Marvin20212/Gruppe9_ME3E/Entwurf alt (Lars)/ME3-Entwurf/Testat 3/Neuer Ordner/Screenshot 2022-02-14 124500.png

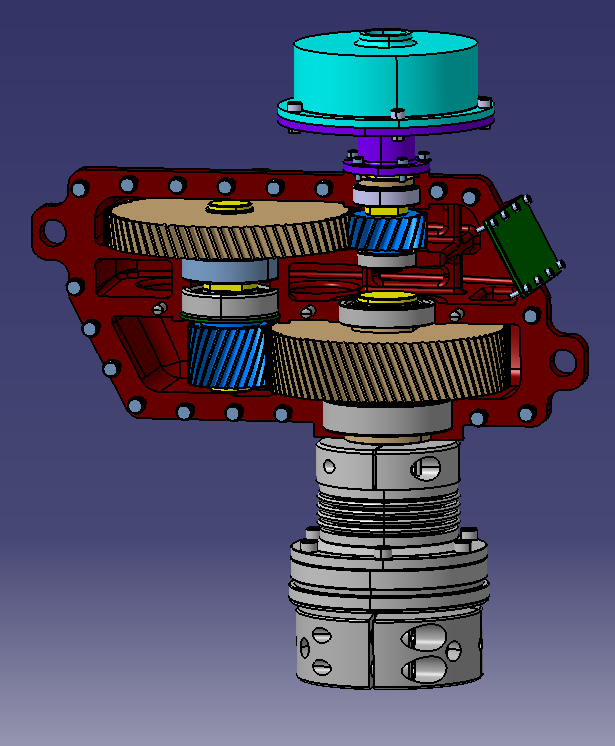
Entwurf alt (Lars)/ME3-Entwurf/Testat 3/Neuer Ordner/Screenshot 2022-02-14 124500.png
