Marvin20212/Gruppe9_ME3E/Catia/Fliehkraftkupplung/Bild Kupplung.jpg

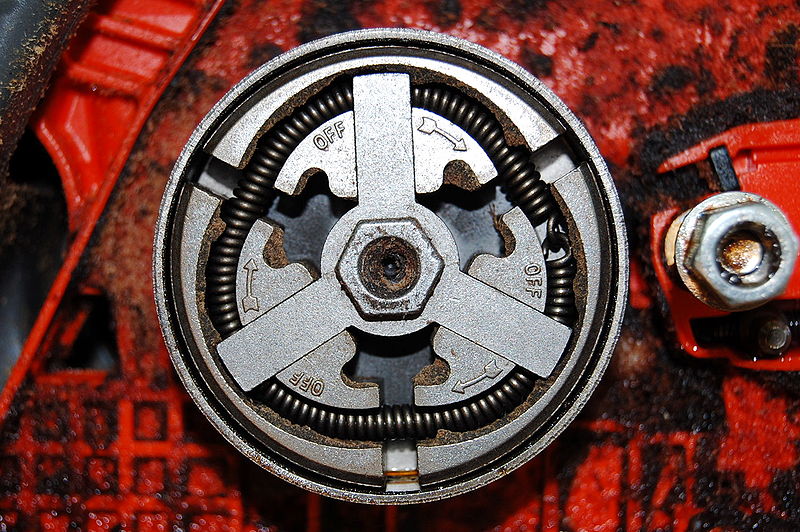
Catia/Fliehkraftkupplung/Bild Kupplung.jpg
