Marvin20212/Gruppe9_ME3E/Catia/Fliehkraftkupplung/Link Traceparts Kupplungen.txt

https://www.traceparts.com/de/search/tracepartsklassifizierung-mechanische-komponenten-bremsen-kopplungen-und-kupplungen-drehmomentbegrenzer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

https://www.traceparts.com/de/search/tracepartsklassifizierung-mechanische-komponenten-bremsen-kopplungen-und-kupplungen-kupplungen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
