Marvin20212/Gruppe9_ME3E/Entwurf alt (Arne)/Anforderungsliste des Bohrgerät.docx

Anforderungsliste des Bohrgerät-Getriebes

Vorgegebene Werte die einzuhalten sind:
Antrieb Tan [Nm] = 50
Abtrieb Tab [Nm] = 500
Schaltdrehzahl ns [min⁻¹] = 1400
Antriebsdrehzahl nan [min⁻¹] = 2000
Abtrieb FB [N] = 1500
Schrägverzahnungwinkel β [°] = 20

Es gibt nur zwei verschiedene Ausführungsvarianten, da die Wellen, Zahnräder und Kupplungen immer gleichbleiben müssen. Die Varianten ergeben sich bei der Konstruktion des Gehäuses. Die erste Variante ist eine Gusskonstruktion. Die zweite ist eine Schweißkonstruktion. Im Folgenden werden beide Varianten vorgestellt.

Variante 1: Gusskonstruktion (geteilt)

- Gehäuse bestehend aus zwei Teilen. Einem Trichter für die Fliehkraftkupplung inklusive einem genormten Motorflansch, welche je nach Motor variieren kann und einem Flanschdeckel zum Fixieren der Lagerungen.
- Durch geteiltes Gehäuse sind Dauergussformen möglich
- Gehäuse bestehend aus einer Alugusslegierung zur Gewichtsreduktion
- Wellen mit vormontierten Zahnrädern, Ritzeln und Lagern werden nur noch eingesetzt.
- Schwimmende Lagerung durch Rollenlager für Vorgelegewelle
- An- und Abtriebswelle:
  - Mit Nadellager ineinander gelagert (Loslager)
  - Festlager durch Kegelrollenlager in O-Anordnung in der Gehäusewand
- Zahnräder und Ritzel durch Passfederverbindungen mit Wellen verbunden

Variante 2: Schweißkonstruktion:

- Gehäuse bestehend aus einem geschweißten Kasten und einem geschraubten Deckel:
  - Motor wird durch Flansch am Kasten verschraubt
  - Wellen werden seitlich durch Löcher eingeschoben
  - Zahnräder, Ritzel und Lager werden im Inneren aufgeschoben
- An- und Abtriebswelle:
  - Loslager durch Rillenkugellager in Lagerblock in der Mitte des Kastens
  - Festlager durch Schrägkugellager in O-Anordnung in der Gehäusewand
- Zahnräder und Ritzel durch Passfederverbindungen mit Wellen verbunden

Es wird eine Gusskonstruktion aufgrund einfacherer Fertigung gewählt.

Allgemeine Anforderungen:

- Sicherheit gegen Dauerbruch > 1,5
- Wälzlagerlebensdauer > 10.000 h
- Koaxiale Ausrichtung der An- und Abtriebswelle
- klein- bis mittelgroße Serie (10.000 Stk.)
- bevorzugte Verwendung von Norm- und Kaufteilen
- fertigungs- und montagegerechte Konstruktion
- kostengünstige Fertigungs- und Betriebskosten
- anwendergerechte Konstruktion, welche Verletzungsgefahren minimiert
- geringe akustische Belastung
- Korrosionsschutz durch gewählte Materialien und Lackierungen
- Ölpeilung
- Öleinlass- und ablassschraube im Gehäuse
- Fliehkraftkupplung schaltet bei 1300 min⁻¹ (μ0 = 0,9)
- Rutschkupplung schaltet bei T > 50 Nm
- kompakte und gewichtssparenden Bauweise
- Reibbelege der Kupplung sind möglichst langlebig

ME3-Entwurf Lara Vujevic, Arne Schlemermeyer, Julian Reimann 08.01.2022
