Marvin20212/Gruppe9_ME3E/Berechnungen/Alle Rechnungen 11.05.2022.pdf

Berechnungen zur Auslegung eines Bohrgerät-Getriebes

ME3 Entwurf SoSe2022 | Gruppe 9

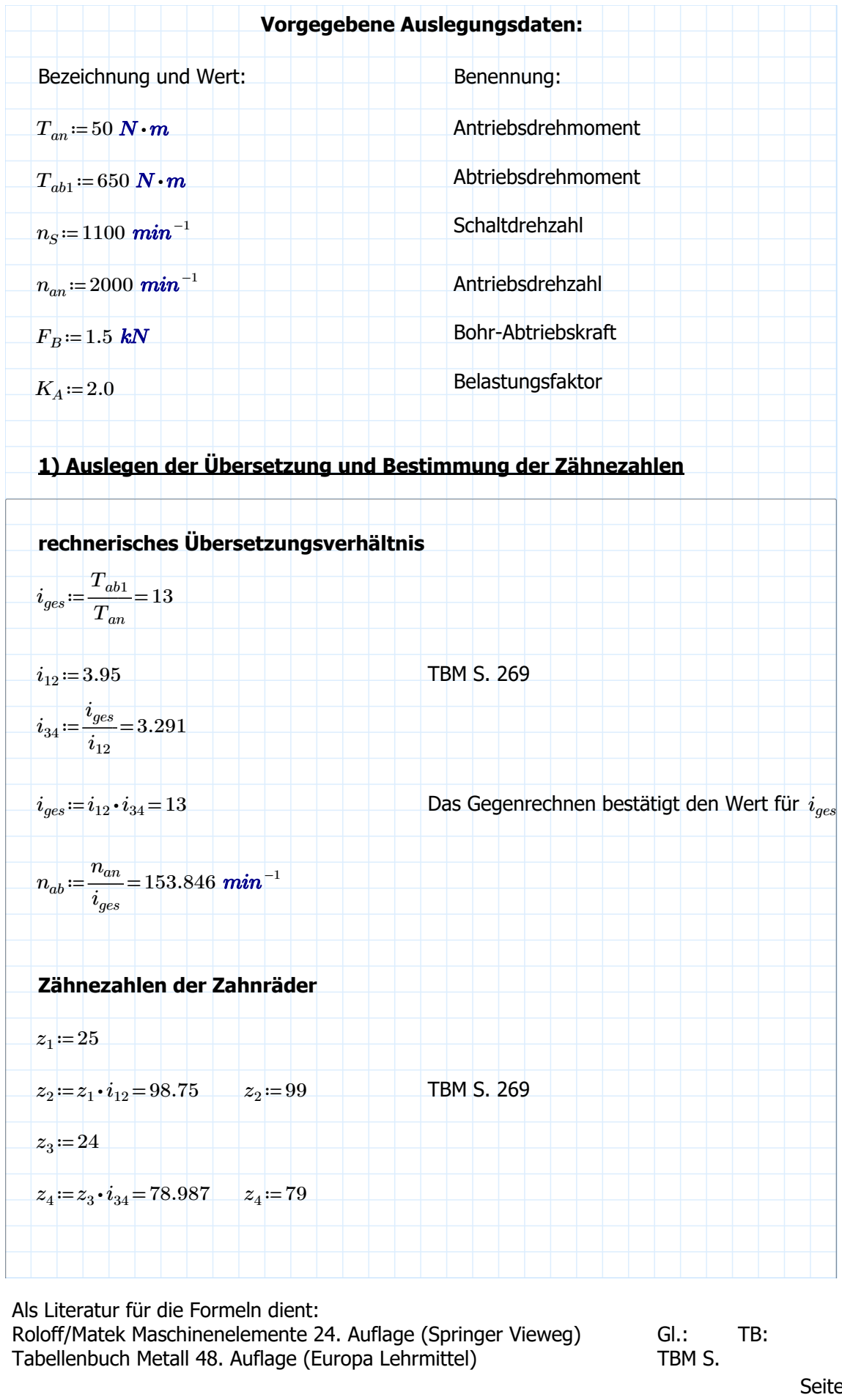
[picture p3: figure]
Vorgegebene Auslegungsdaten:; Bezeichnung und Wert:; Benennung:; Tan≔50 N ⋅m; Antriebsdrehmoment; Abtriebsdrehmoment; Schaltdrehzahl; Tab1≔650 N ⋅m; nS≔1100 min ⁻¹; nan≔2000; min ⁻¹; Antriebsdrehzahl; Bohr-Abtriebskraft; Belastungsfaktor; rechnerisches Übersetzungsverhältnis; iges≔――=; Tab1; Tan; TBM S. 269; iges; nab≔――=; nan; 153.846 min ⁻¹; Zähnezahlen der Zahnräder; Als Literatur für die Formeln dient:

1) Auslegen der Übersetzung und Bestimmung der Zähnezahlen
iges≔i12 ⋅i34=13 | Das Gegenrechnen bestätigt den Wert für iges
Roloff/Matek Maschinenelemente 24. Auflage (Springer Vieweg) | Gl.: | TB:
Tabellenbuch Metall 48. Auflage (Europa Lehrmittel) | TBM S.
Seite 1 von 35

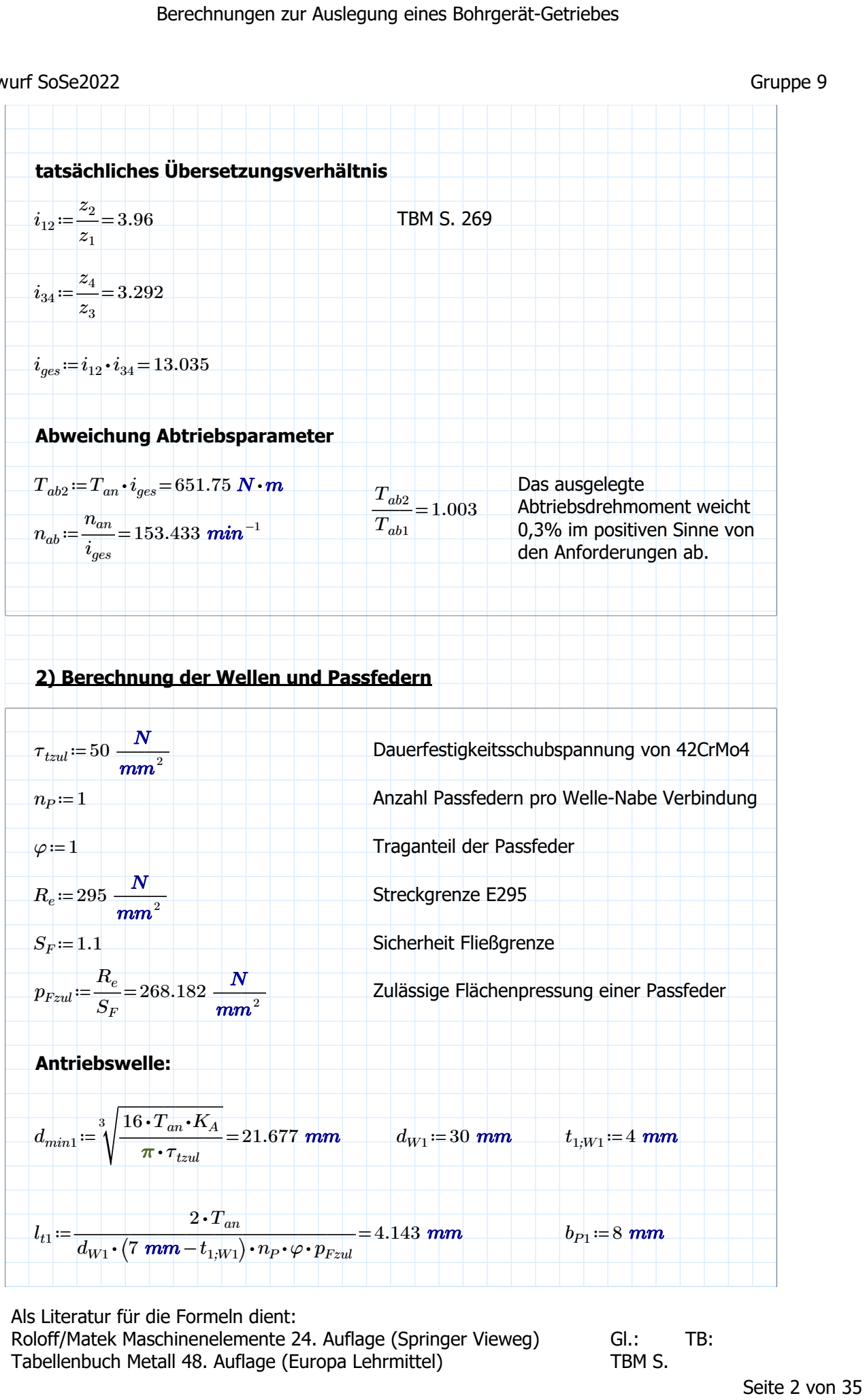
[picture p4: figure]
tatsächliches Übersetzungsverhältnis; 3.96 TBM S. 269; iges≔i12 ⋅i34=13.035; Abweichung Abtriebsparameter; Abtriebsdrehmoment weicht 0,3% im positiven Sinne von den Anforderungen ab.; Tab2; Tab1; nab≔――=; nan; iges; 153.433 min ⁻¹; 2) Berechnung der Wellen und Passfedern; τtzul≔50 ―N―mm²; Dauerfestigkeitsschubspannung von 42CrMo4; Anzahl Passfedern pro Welle-Nabe Verbindung; Traganteil der Passfeder; Re≔295 ―N―mm²; Streckgrenze E295; Sicherheit Fließgrenze; pFzul≔―=; 268.182 ―N―mm²; Zulässige Flächenpressung einer Passfeder; Antriebswelle:; dmin1≔; π⋅τtzul; 2 ⋅Tan; nP φ pFzul; Seite 2 von 35

Tab2≔Tan ⋅iges=651.75 N ⋅m | Das ausgelegte

Da die tragende Länge der Passfeder der ungefähren Breite der Zahnräder entsprechen sollte, wird im Folgenden die Länge an die später berechnete Zahnradbreite angeglichen.
lP1≔28 | mm | gewählt: Antriebswelle ⌀ 30mm Passfeder DIN 6885 - A8 x 7 x 28

Vorgelegewelle:

dmin2≔ | =

3 ―――――

16 ⋅T | ⋅ | ⋅ an KA | i12

π⋅τtzul

34.295 mm | dW2≔45 mm | t1;W2≔5.5 | mm

l

t2≔―――――――――――=

2 ⋅T | ⋅ an i12
dW2 ⋅ ⎛ | ⋅ | ⋅ | ⋅ ⎝9 mm -t1;W2⎞
⎠ | nP φ pFzul
9.375 mm | bP2≔14 | mm

Da die tragende Länge der Passfeder der ungefähren Breite der Zahnräder entsprechen sollte, wird im Folgenden die Länge an die später berechnete Zahnradbreite angeglichen.

lP2≔28 | mm | lP2≔50 | mm | gewählt: Vorgelegewelle ⌀ 45mm Passfeder DIN 6885 - A14 x 9 x 28 Passfeder DIN 6885 - A14 x 9 x 50

Abtriebswelle:

dmin3≔ | =

3 ―――――

16 ⋅T | ⋅ | ⋅ an KA | iges

π⋅τtzul

51.016 | mm | dW3≔60 mm | t1;W3≔7 mm

l

t3≔―――――――――――=

2 ⋅T | ⋅ an iges
dW3 ⋅ ⎛ | ⋅ | ⋅ ⋅ ⎝11 | mm -t1;W3⎞
⎠ nP | φ | pFzul
20.252 mm | bP3≔18 | mm

Da die tragende Länge der Passfeder der ungefähren Breite der Zahnräder entsprechen sollte, wird im Folgenden die Länge an die später berechnete Zahnradbreite angeglichen.

lP3≔50 | mm | gewählt: Abtriebswelle ⌀ 60mm Passfeder DIN 6885 - A18 x 11 x 50
3) Zahnradbreite

Bzul≔4.0 ―N―mm²
| | Überschlägigier Belastungswert

Seite 3 von 35

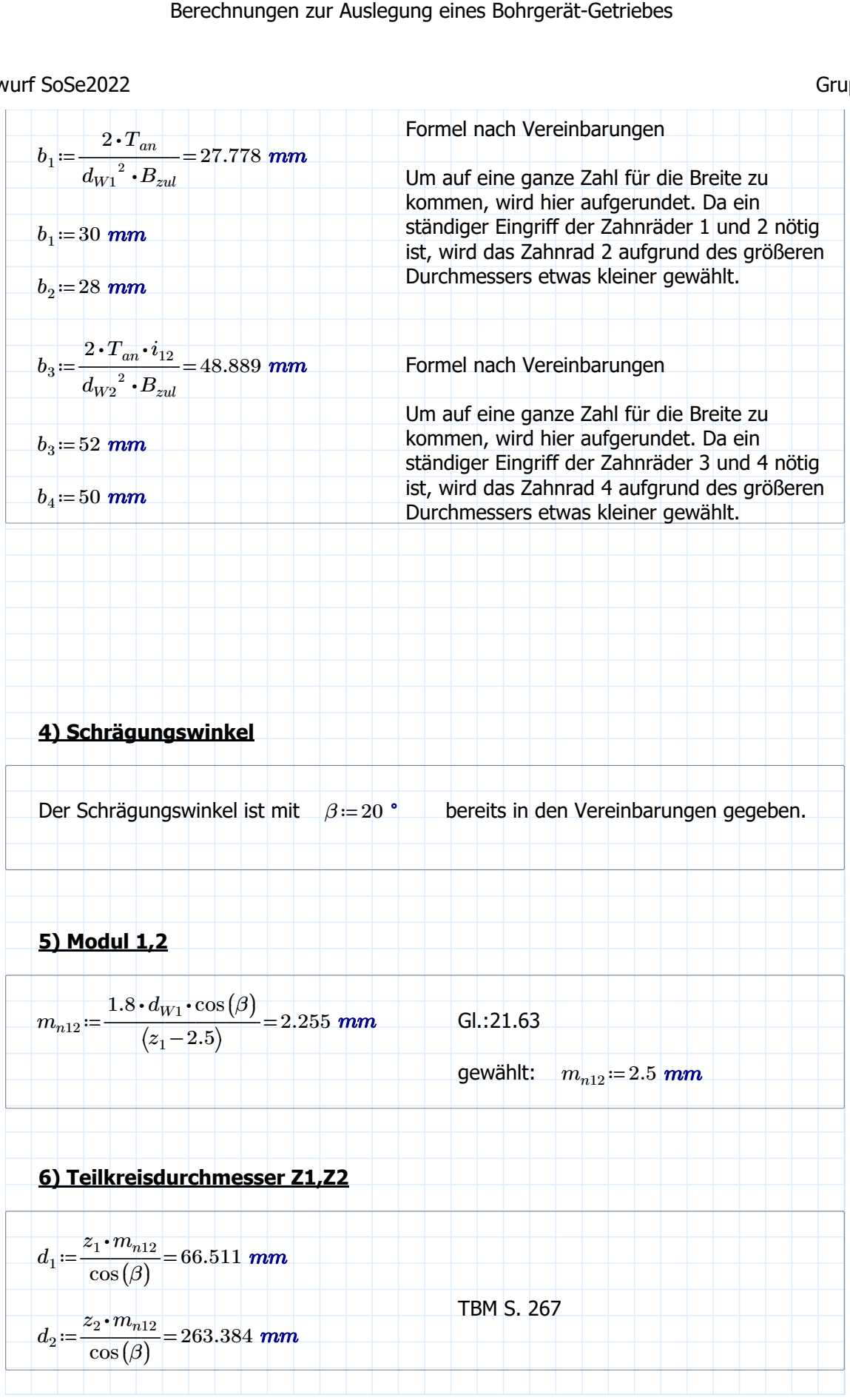
[picture p5: figure]
Formel nach Vereinbarungen; kommen, wird hier aufgerundet. Da ein; Durchmessers etwas kleiner gewählt.; 2 ⋅Tan dW1 ⋅; 2 Bzul; 4) Schrägungswinkel; Der Schrägungswinkel ist mit; bereits in den Vereinbarungen gegeben.; 5) Modul 1,2; 1.8 ⋅dW1 ⋅ cos ((β)) ⎛⎝z1-2.5⎞ ⎠; gewählt:; 6) Teilkreisdurchmesser Z1,Z2; cos ((β)); TBM S. 267

Um auf eine ganze Zahl für die Breite zu

ständiger Eingriff der Zahnräder 1 und 2 nötig ist, wird das Zahnrad 2 aufgrund des größeren

Um auf eine ganze Zahl für die Breite zu

ständiger Eingriff der Zahnräder 3 und 4 nötig ist, wird das Zahnrad 4 aufgrund des größeren

Seite 4 von 35

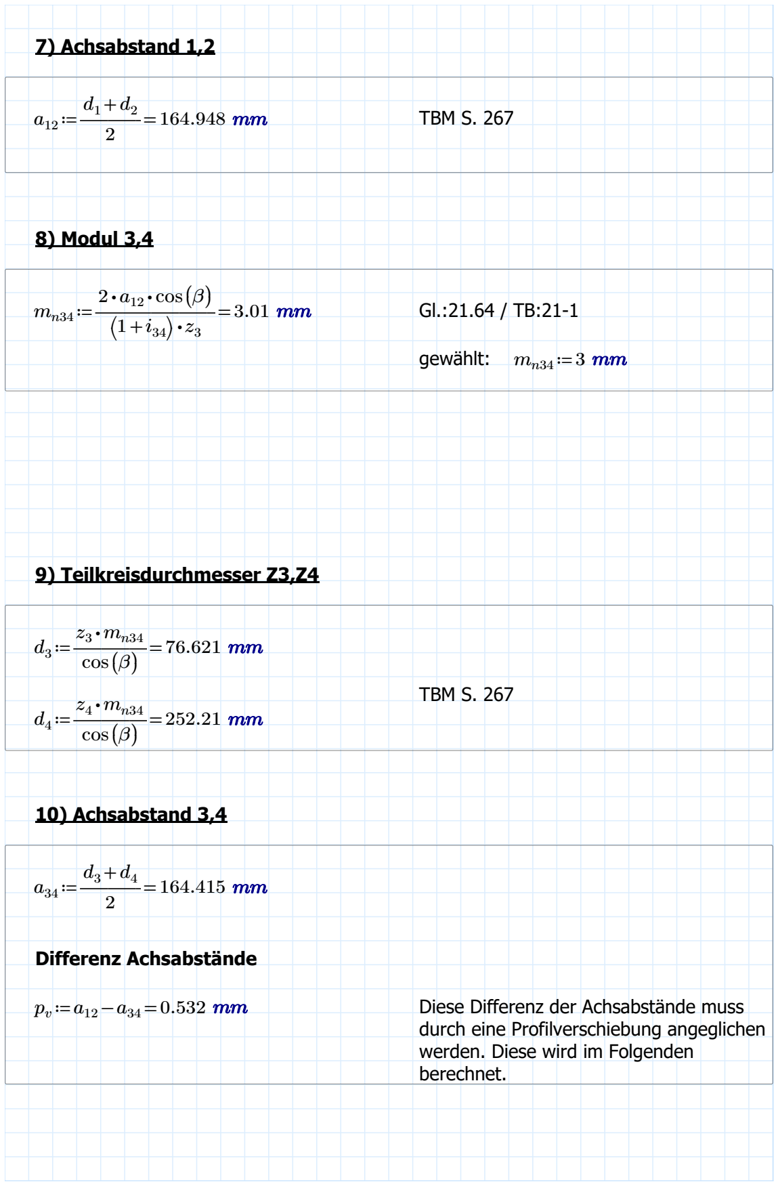
[picture p6: figure]
7) Achsabstand 1,2; TBM S. 267; 8) Modul 3,4; cos ((β)); gewählt:; 9) Teilkreisdurchmesser Z3,Z4; 10) Achsabstand 3,4; Differenz Achsabstände; Diese Differenz der Achsabstände muss; durch eine Profilverschiebung angeglichen werden. Diese wird im Folgenden berechnet.

Seite 5 von 35

11) Profilverschiebung

Aufgrund weniger Drehmomentkräfte an den Zahnrädern 1 und 2 haben wir uns dort für die Profilverschiebung entschieden.

Stirneingriffswinkel

αn≔β=20 | °
αt≔atan | =

⎛
⎜

⎝―――

tan⎛⎝αn

⎞
⎠
cos ((β))

⎞
⎟
⎠
21.173 ° | Gl.: 21.35

Ersatzzähnezahl

βb≔acos | =

⎛
⎜
⎝

―――

sin⎛⎝αn

⎞
⎠
sin⎛⎝αt

⎞
⎠

⎞
⎟
⎠
18.747 ° | Gl.: 21.36

zn1≔―――――=

d1

cos ⎛ ⋅ ⎝βb

⎞
⎠

2
mn12

29.669 Gl.: 21.47

zn2≔―――――=

d2
cos ⎛ ⋅ ⎝βb

⎞
⎠ mn12

111.256

Profilverschiebungsfaktoren und Profilverschiebung

Bei der Profilverschiebung V ist zum Berechnen der Wert x nötig. Dieser wird in der Formel für die Summe der Profilverschiebungsfaktoren errechnet, welche bis auf den Betriebseingriffswinkel zurückblickt. Daher werden im Folgenden mehrere Gleichungen angewendet, um letztendlich auf die Profilverschiebung zu kommen.

Betriebseingriffswinkel:

αwt≔acos | =

⎛
⎜
⎝

cos ⎛ ⋅ ⎝αt

⎞
⎠ ――

a12

a34

⎞
⎟
⎠
20.689 | ° | aus Gl.: 21.54 umgestellt

Seite 6 von 35

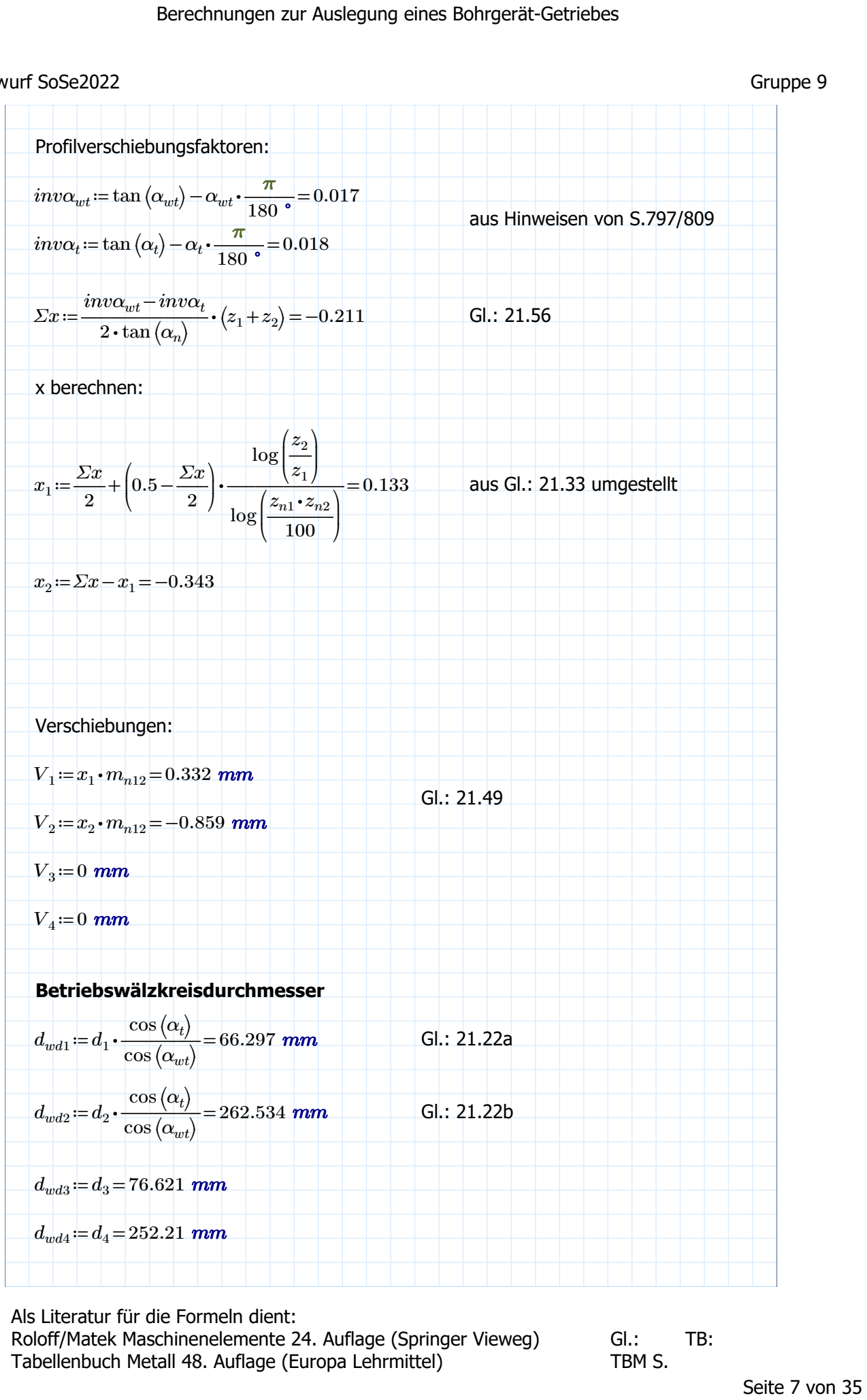
[picture p7: figure]
Profilverschiebungsfaktoren:; invαwt≔tan⎛⎝αwt⎞ ⎠-αwt⋅――=; aus Hinweisen von S.797/809; invαt≔tan⎛⎝αt; invαwt-invαt 2 ⋅ tan⎛⎝αn; x berechnen:; log; 0.133 aus Gl.: 21.33 umgestellt; Verschiebungen:; Betriebswälzkreisdurchmesser; dwd1≔d1; cos ⎛⎝αt; ⎞ ⎠ cos ⎛⎝αwt⎞ ⎠; dwd2≔d2; dwd3≔d3=76.621 mm; dwd4≔d4=252.21 mm; Seite 7 von 35

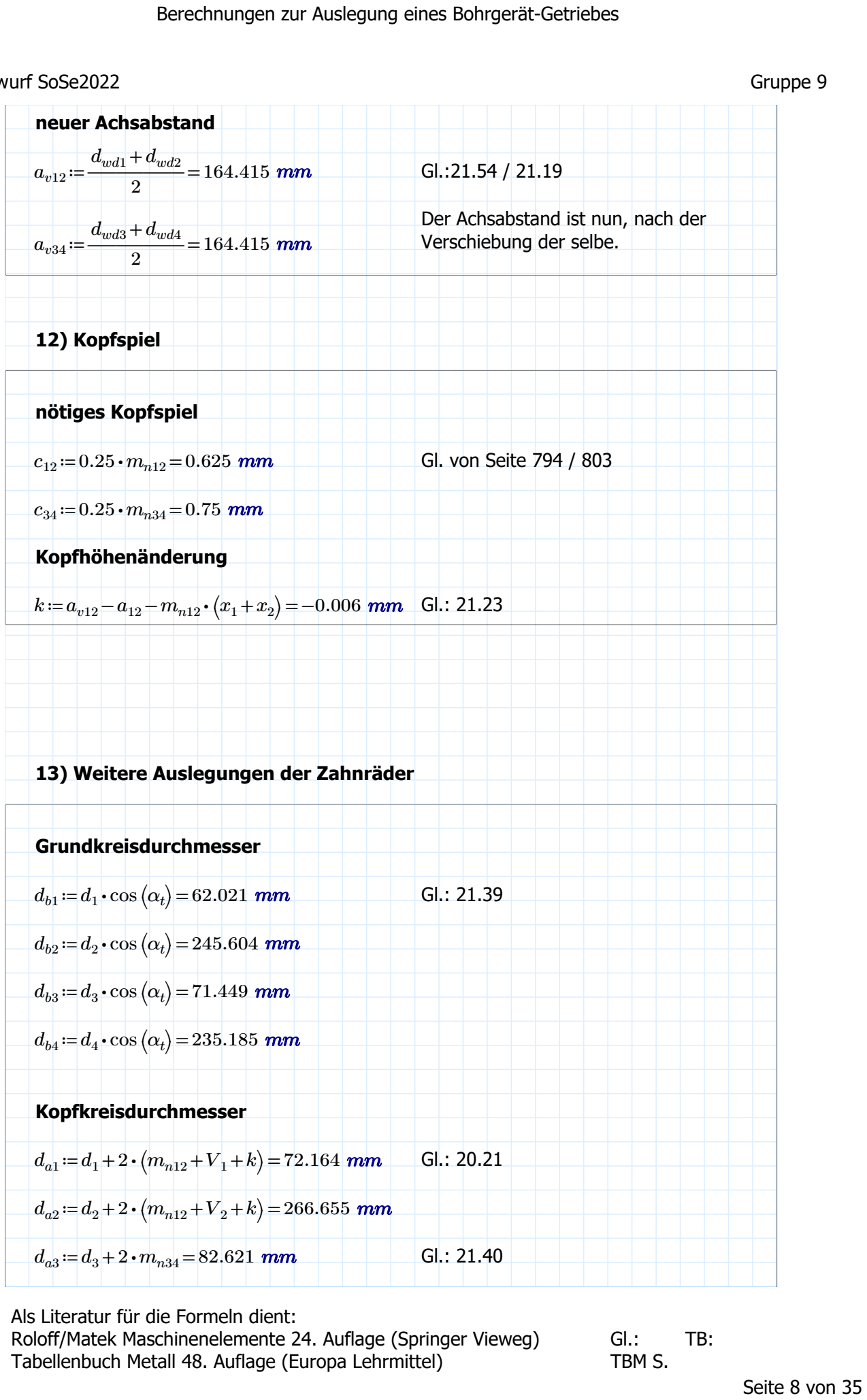
[picture p8: figure]
neuer Achsabstand; dwd1+dwd2 2; Der Achsabstand ist nun, nach der; Verschiebung der selbe. v34; dwd3+dwd4 2; 12) Kopfspiel; nötiges Kopfspiel; Kopfhöhenänderung; 13) Weitere Auslegungen der Zahnräder; Grundkreisdurchmesser; ⋅ cos ⎛⎝αt; Kopfkreisdurchmesser; Seite 8 von 35

c12≔0.25 ⋅mn12=0.625 mm | Gl. von Seite 794 / 803

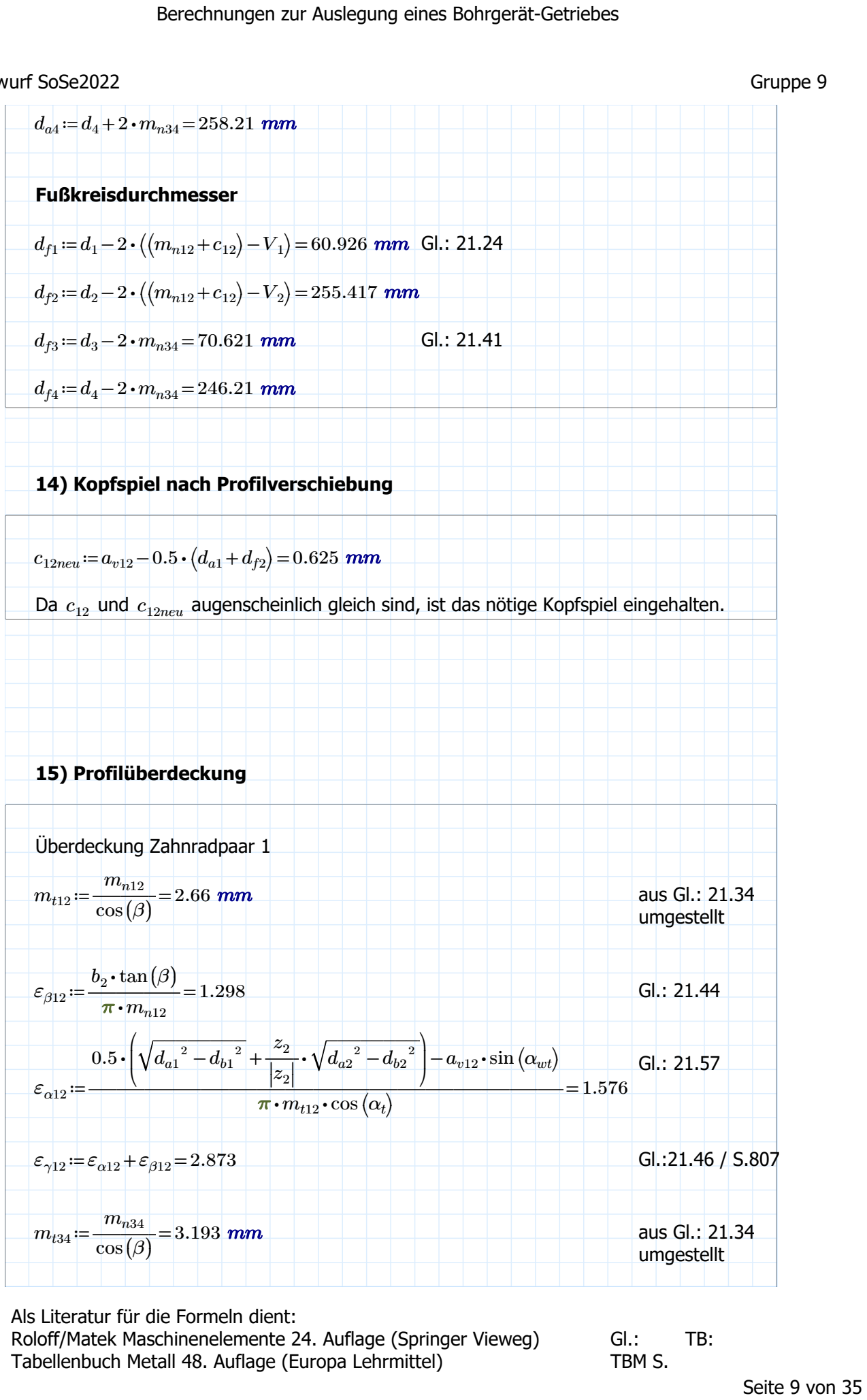
[picture p9: figure]
Fußkreisdurchmesser; 14) Kopfspiel nach Profilverschiebung; c12neu≔av12-0.5 ⋅ ⎛⎝da1+df2⎞; 15) Profilüberdeckung; Überdeckung Zahnradpaar 1; mn12 cos ((β)); aus Gl.: 21.34; umgestellt; ⋅ 2 tan((β)); sin⎛⎝αwt⎞; cos ⎛⎝αt; mn34 cos ((β)); Seite 9 von 35

Da c | und | augenscheinlich gleich sind, ist das nötige Kopfspiel eingehalten. 12 | c12neu

εβ34≔――――=

b ⋅ 4 tan((β))
π⋅mn34

1.931 Gl.: 21.44

Gl.: 21.57
εα34≔―――――――――――――――――=
0.5 ⋅ | -

⎛
⎜
⎝

d
a3
- +

### 2 db3

2 ――⋅

z4
|z4
- da4

### 2 db4

2

⎞
⎟
⎠
a | ⋅ v34 | sin⎛⎝αwt⎞
⎠
π⋅m | ⋅ t34 | cos ⎛⎝αt

⎞
⎠

1.705

εγ34≔εα34+εβ34=3.636 | Gl.:21.46 / S.807
Da ε | und | über 1,25 sind, ist die Mindestanforderung von 1,1 auf jeden Fall α1 | εα2
eingehalten.
16) Zusammenfassung wichtiger Komponenten der Zahnräder 1-4
Zahnrad 1 | Zahnrad 2 | Zahnrad 3 | Zahnrad 4
Zähnezahl | z1 = 25 | z2 = 99 | z3 = 24 | z4 = 79
Teilkreisdurchmesser | d1 = 66.511 mm | d2 = 263.384 mm | d3 = 76.621 mm | d4 = 252.21 mm
Betriebswälzdurchmesser | dwd1 = 66.297 mm | dwd2 = 262.534 mm | dwd3 = 76.621 mm | dwd4 = 252.21 mm
Kopfkreisdurchmesser | da1 = 72.164 mm | da2 = 266.655 mm | da3 = 82.621 mm | da4 = 258.21 mm
Fußkreisdurchmesser | df1 = 60.926 mm | df2 = 255.417 mm | df3 = 70.621 mm | df4 = 246.21 mm
Zahnradbreite | b1 = 30 mm | b2 = 28 mm | b3 = 52 mm | b4 = 50 mm
Modul | mn12 = 2.5 mm | mn34 = 3 mm
Achsabstand | av12 = 164.415 mm | av34 = 164.415 mm
Verschiebung | V1 = 0.332 mm | V2 = -0.859 mm | V3 = 0 mm | V4 = 0 mm
Profilüberdeckung | εα12 = 1.576 | εα34 = 1.705
Sprungüberdeckung | εβ12 = 1.298 | εβ34 = 1.931
Gesamtüberdeckung | εγ12 = 2.873 | εγ34 = 3.636

Seite 10 von 35

17) Zahnradkräfte

Zahnrad 1:

Umfangskraft: | FT1≔―――=

2 ⋅Tan
d1
1.504 kN | Gl.:21.70
Radialkraft: | FR1≔―――――=

FT1 ⋅ tan⎛⎝αn

⎞
⎠
cos ((β))
0.582 | kN | Gl.:21.72
Axialkraft: | FA1≔FT1 ⋅ tan((β))=0.547 kN | Gl.:21.73

Zahnrad 2:

Umfangskraft: | FT2≔|

|FT1|
|=1.504 | kN
Radialkraft: | FR2≔|

|FR1|
|=0.582 | kN
Axialkraft: | FA2≔|

|FA1|
|=0.547 kN

Zahnrad 3:

Umfangskraft: | FT3≔2 ⋅―――=
T | ⋅ an | i12
d3

5.168 kN

Radialkraft: | FR3≔―――――=

FT3 ⋅ tan⎛⎝αn

⎞
⎠
cos ((β))

2.002 kN

Axialkraft: | FA3≔FT3 ⋅ tan((β))=1.881 kN

Seite 11 von 35

Zahnrad 4:

Umfangskraft: | FT4≔|

|FT3|
|=5.168 | kN
Radialkraft: | FR4≔|

|FR3|
|=2.002 | kN
Axialkraft: | FA4≔|

|FA3|
|=1.881 kN

Hier werden nur Beträge berechnet.
Die Richtungen der Kräfte sind den Schnittverläufen der Wellen zu entnehmen.
18) Lagerkräfte und Schnittgrößenverläufe Antriebswelle

Freischnitt der Antriebswelle

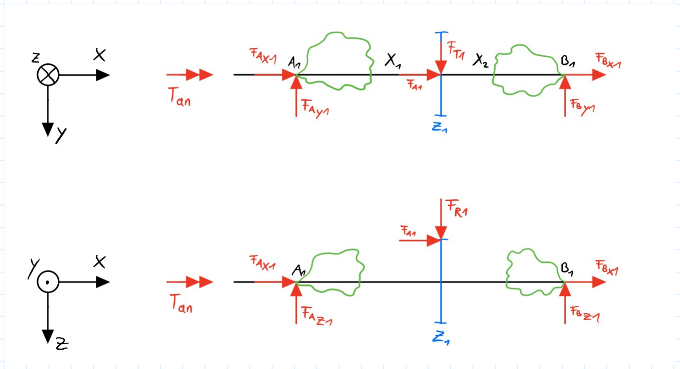
[picture p10: figure]

Längen: | X1≔33.5 mm | X2≔26.5 mm

Lagerkräfte:

XY-Ebene: | XZ-Ebene:

FBy1≔――――=

FT1 ⋅X1
⎛⎝X1+X2

⎞
⎠
0.839 | kN | FBz1≔――――――=

FR1 ⋅X1+FA1 ⋅―

d1
2
⎛⎝X1+X2

⎞
⎠

0.628 kN

Seite 12 von 35

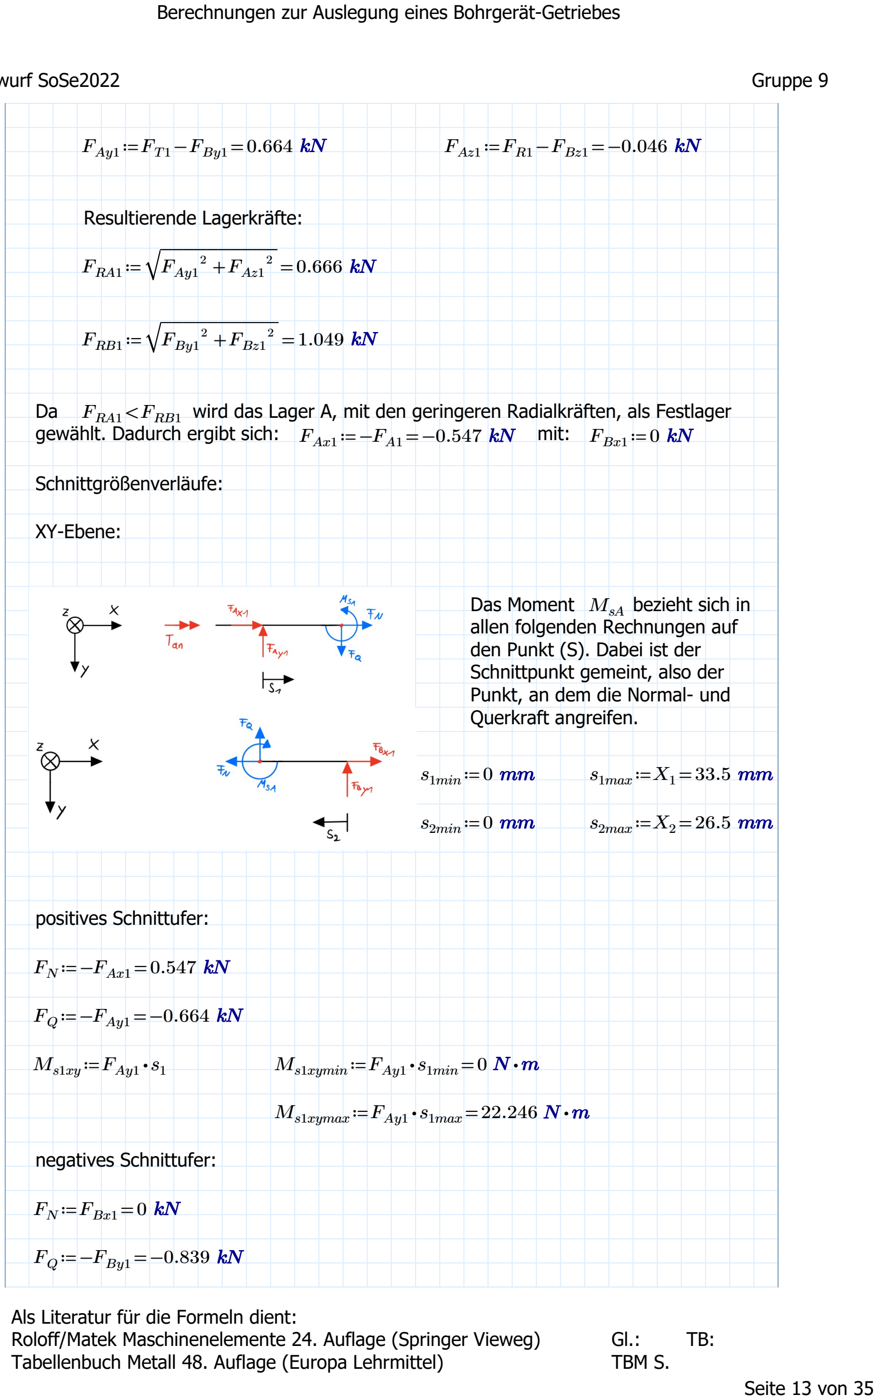
[picture p11: figure]
FAy1≔FT1-FBy1=0.664; FAz1≔FR1-FBz1=-0.046 kN; Resultierende Lagerkräfte:; FRA1≔; 2 FAz1; FRB1≔; 2 FBz1; gewählt. Dadurch ergibt sich:; mit:; FRA1<FRB1; FAx1≔-FA1=-0.547; FBx1≔0 kN; Schnittgrößenverläufe:; XY-Ebene:; Das Moment; bezieht sich in; allen folgenden Rechnungen auf den Punkt (S). Dabei ist der Schnittpunkt gemeint, also der Punkt, an dem die Normal- und Querkraft angreifen.; MsA; s1min≔0 mm; s1max≔X1=33.5; s2min≔0 mm; s2max≔X2=26.5; positives Schnittufer:; FN≔-FAx1=0.547; FQ≔-FAy1=-0.664 kN; Ms1xy≔FAy1 ⋅ s1; Ms1xymin≔FAy1 ⋅ s1min=0 N ⋅m; Ms1xymax≔FAy1 ⋅ s1max=22.246 N ⋅m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

Da | wird das Lager A, mit den geringeren Radialkräften, als Festlager

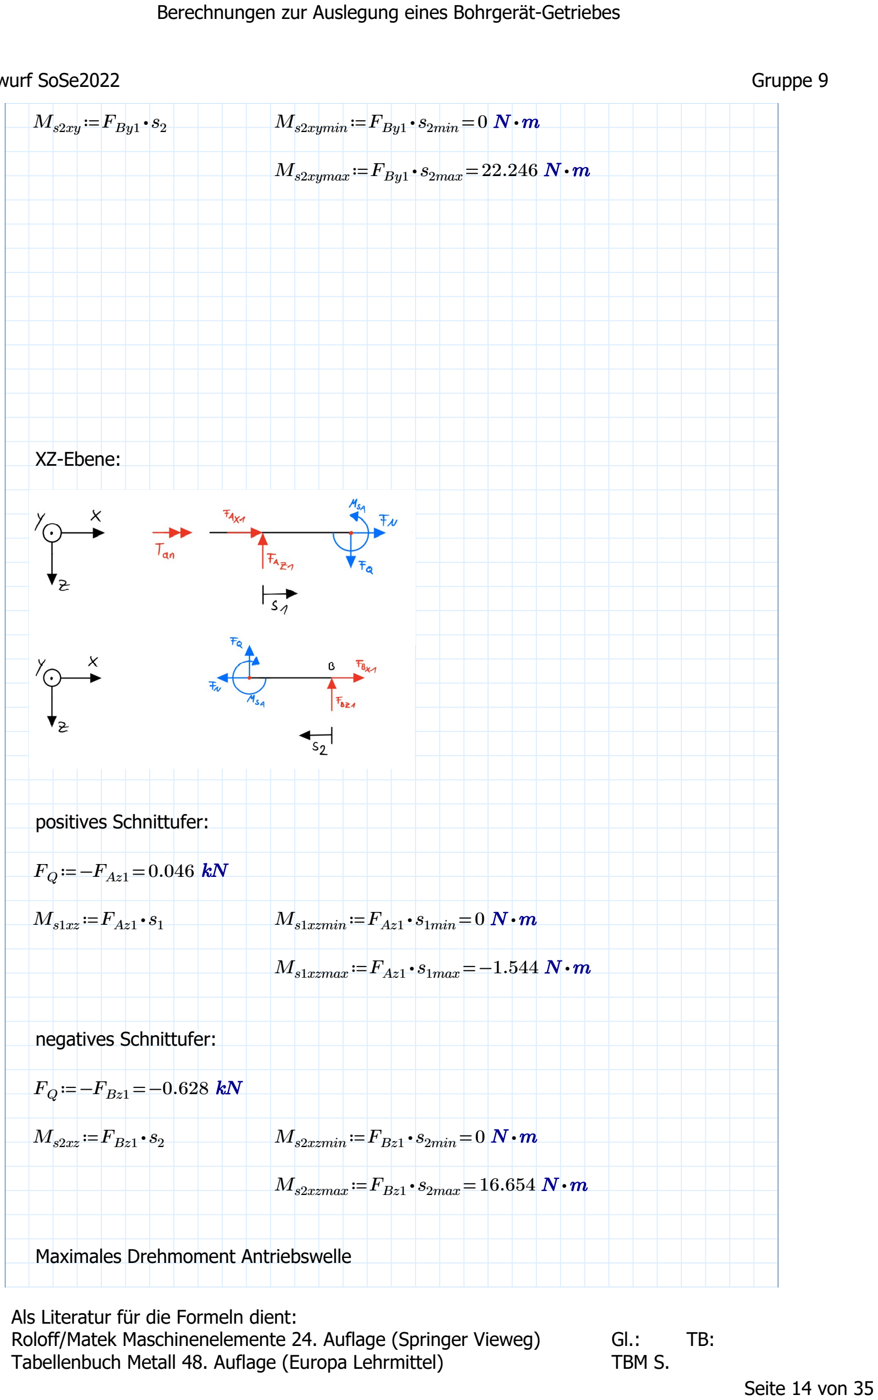
[picture p12: figure]
Ms2xy≔FBy1 ⋅ s2; Ms2xymin≔FBy1 ⋅ s2min=0 N ⋅m; Ms2xymax≔FBy1 ⋅ s2max=22.246 N ⋅m; XZ-Ebene:; positives Schnittufer:; FQ≔-FAz1=0.046; Ms1xz≔FAz1 ⋅ s1; Ms1xzmin≔FAz1 ⋅ s1min=0 N ⋅m; Ms1xzmax≔FAz1 ⋅ s1max=-1.544 N ⋅m; negatives Schnittufer:; FQ≔-FBz1=-0.628 kN; Ms2xz≔FBz1 ⋅ s2; Ms2xzmin≔FBz1 ⋅ s2min=0 N ⋅m; Ms2xzmax≔FBz1 ⋅ s2max=16.654 N ⋅m; Maximales Drehmoment Antriebswelle; Seite 14 von 35

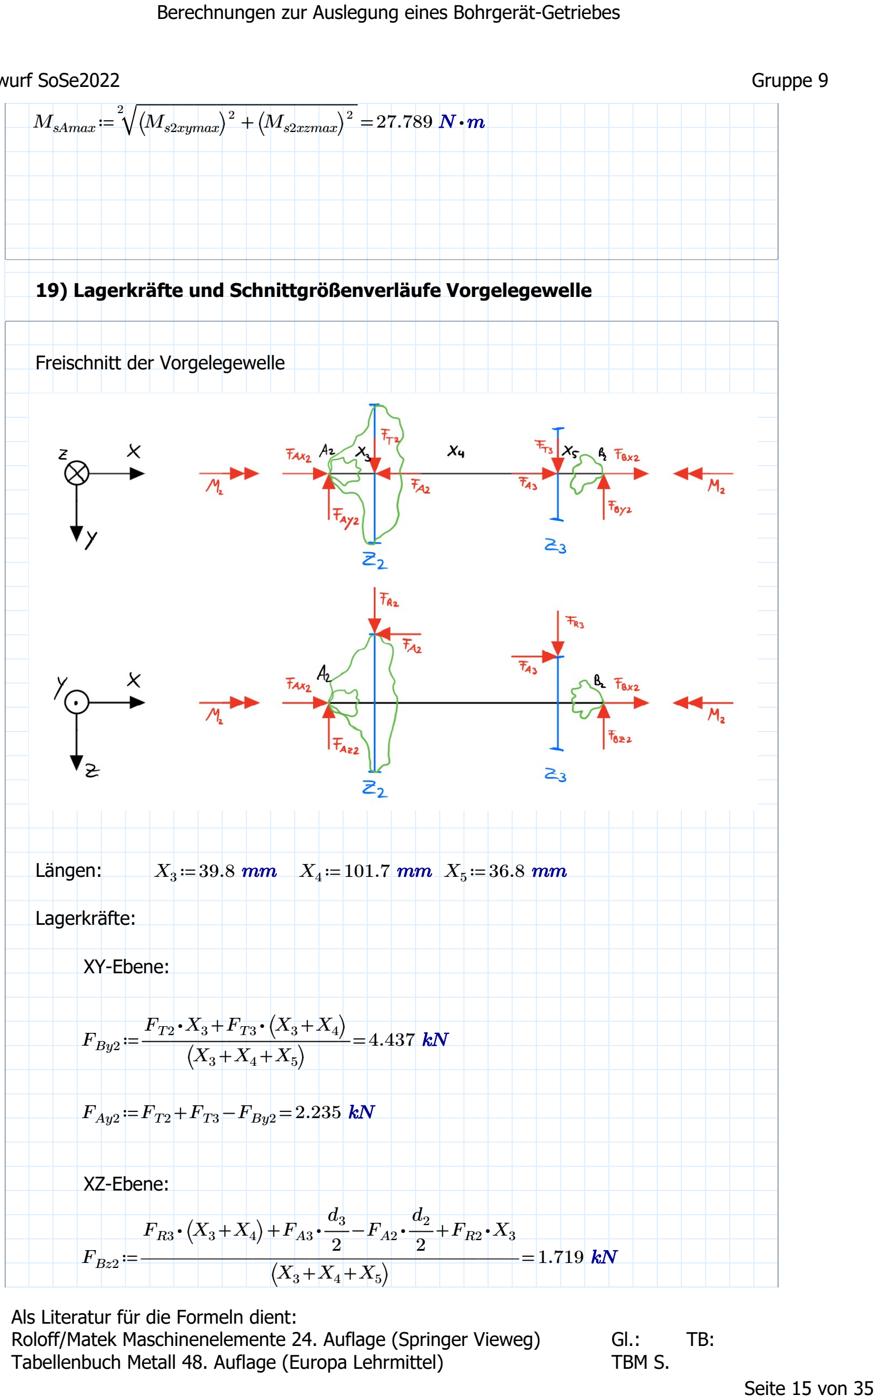
[picture p13: figure]
MsAmax≔; ⎛⎝Ms2xymax⎞ ⎠ +; 2 ⎛⎝Ms2xzmax⎞ ⎠; Freischnitt der Vorgelegewelle; Längen:; Lagerkräfte:; XY-Ebene:; FBy2≔――――――――=; FAy2≔FT2+FT3-FBy2=2.235; XZ-Ebene:; FBz2≔――――――――――――――=; Seite 15 von 35

19) Lagerkräfte und Schnittgrößenverläufe Vorgelegewelle

FAz2≔FR2+FR3-FBz2=0.866 kN

Resultierende Lagerkräfte:

FRA2≔ F
Ay2

+ =

### 2 FAz2

2 | 2.396 | kN | FRB2≔ | F By2
+ | =

### 2 FBz2

2 | 4.758 | kN
Da | wird das Lager A, mit den geringeren Radialkräften, als Festlager
gewählt. Dadurch ergibt sich: | mit:

FRA2<FRB2
FAx2≔FA2-FA3=-1.334 kN FBx2≔0 kN

Schnittgrößenverläufe:

XY-Ebene:

s3min≔0 mm | s3max≔X3=39.8 | mm
s4min≔0 mm | s4max≔X4=101.7 mm
s5min≔0 mm | s5max≔X5=36.8 | mm

erstes positives Schnittufer:

FN≔-FAx2=1.334 kN

FQ≔-FAy2=-2.235 kN

Seite 16 von 35

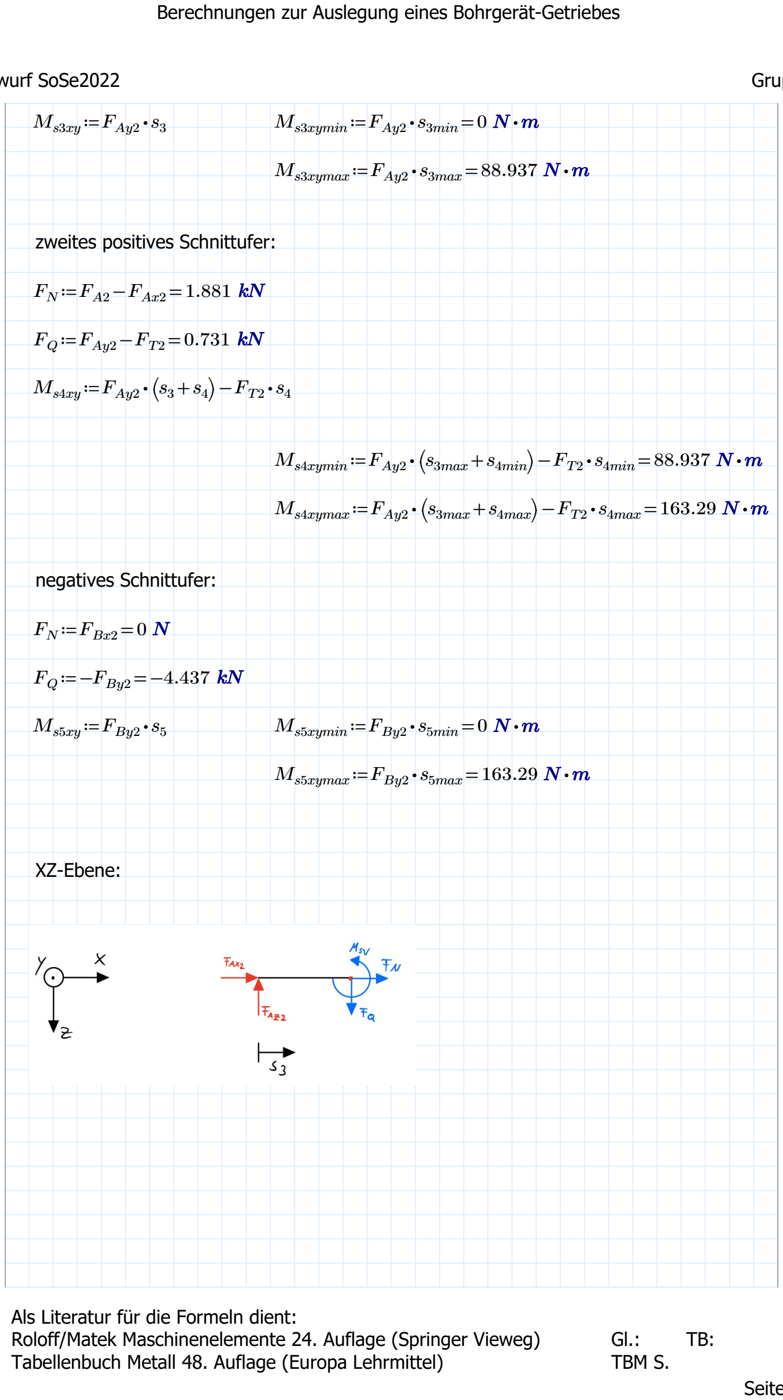
[picture p14: figure]
Ms3xymax≔FAy2 ⋅ s3max=88.937 N ⋅m; zweites positives Schnittufer:; FN≔FA2-FAx2=1.881 kN; FQ≔FAy2-FT2=0.731 kN; Ms4xy≔FAy2 ⋅ ⎛⎝s3+s4; Ms4xymin≔FAy2 ⋅ ⎛⎝s3max+s4min⎞ ⎠-FT2 ⋅ s4min=88.937 N ⋅m; Ms4xymax≔FAy2 ⋅ ⎛⎝s3max+s4max⎞ ⎠-FT2 ⋅ s4max=163.29 N ⋅m; negatives Schnittufer:; FN≔FBx2=0 N; FQ≔-FBy2=-4.437 kN; Ms5xymax≔FBy2 ⋅ s5max=163.29 N ⋅m; XZ-Ebene:

Ms3xy≔FAy2 ⋅ s3 | Ms3xymin≔FAy2 ⋅ s3min=0 N ⋅m
Ms5xy≔FBy2 ⋅ s5 | Ms5xymin≔FBy2 ⋅ s5min=0 N ⋅m

Seite 17 von 35

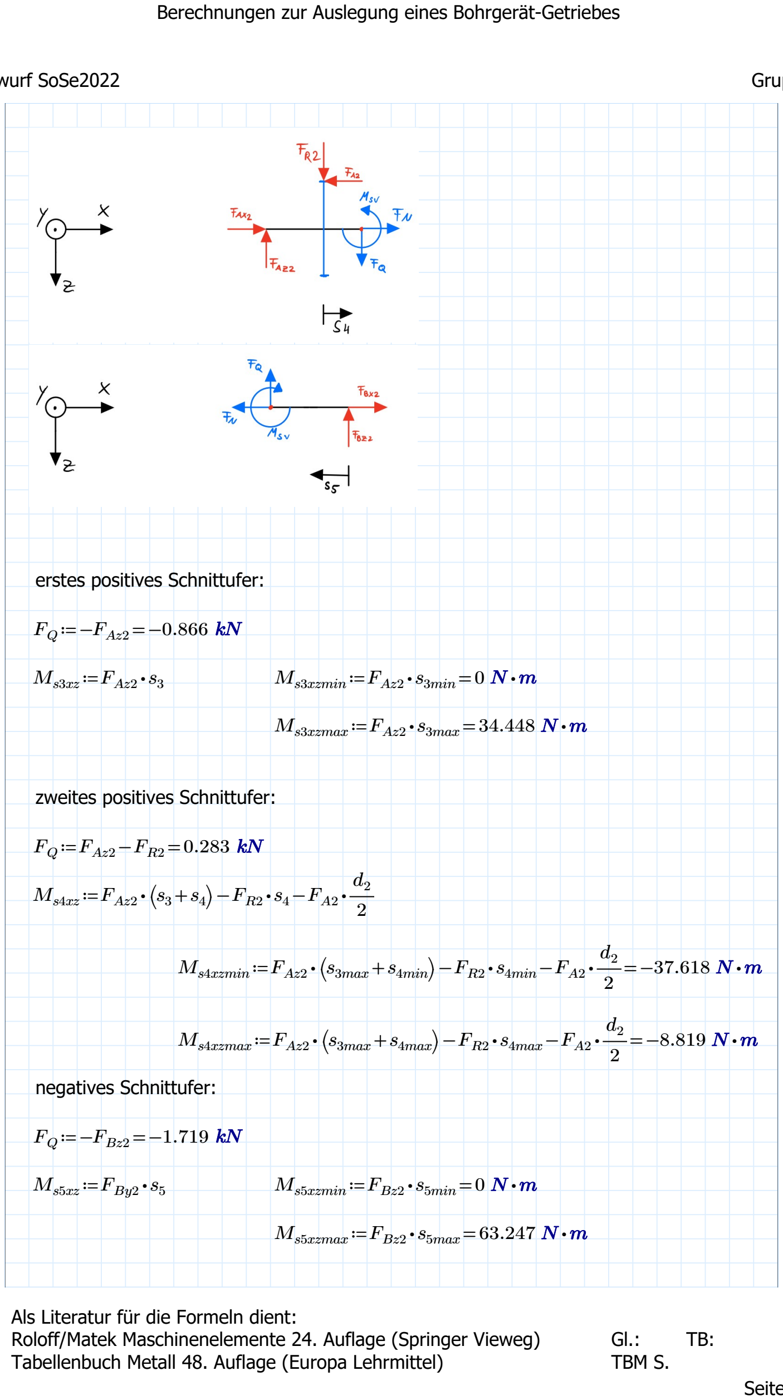
[picture p15: figure]
erstes positives Schnittufer:; FQ≔-FAz2=-0.866 kN; Ms3xzmax≔FAz2 ⋅ s3max=34.448 N ⋅m; zweites positives Schnittufer:; FQ≔FAz2-FR2=0.283 kN; Ms4xz≔FAz2 ⋅ ⎛⎝s3+s4; Ms4xzmin≔FAz2 ⋅ ⎛⎝s3max+s4min⎞ ⎠-FR2 ⋅ s4min-FA2 ⋅―=; Ms4xzmax≔FAz2 ⋅ ⎛⎝s3max+s4max⎞ ⎠-FR2 ⋅ s4max-FA2 ⋅―=; negatives Schnittufer:; FQ≔-FBz2=-1.719 kN; Ms5xzmax≔FBz2 ⋅ s5max=63.247 N ⋅m

Ms3xz≔FAz2 ⋅ s3 | Ms3xzmin≔FAz2 ⋅ s3min=0 N ⋅m
Ms5xz≔FBy2 ⋅ s5 | Ms5xzmin≔FBz2 ⋅ s5min=0 N ⋅m

Seite 18 von 35

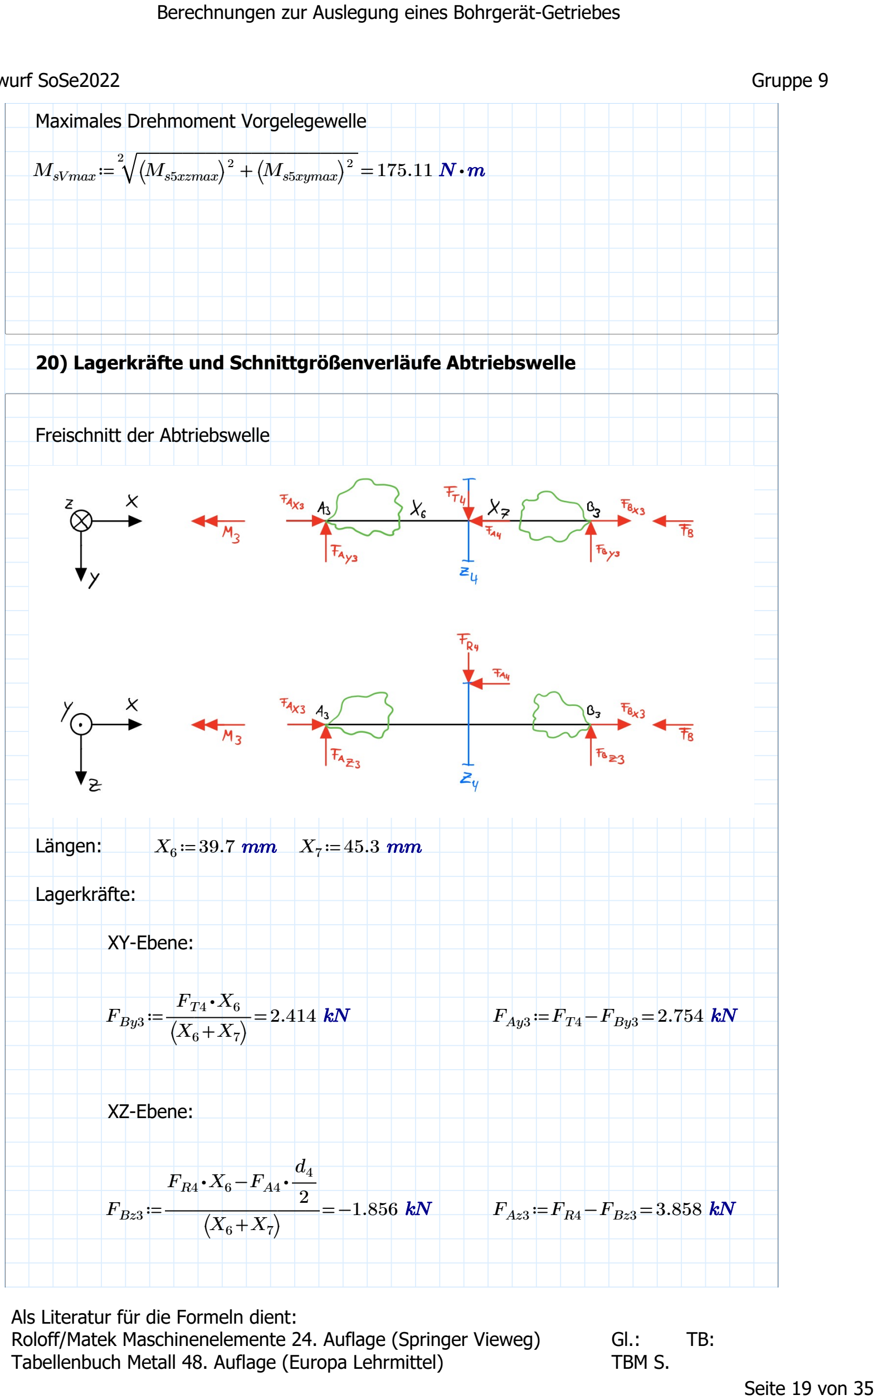
[picture p16: figure]
Maximales Drehmoment Vorgelegewelle; MsVmax≔; ⎛⎝Ms5xzmax⎞ ⎠ +; 2 ⎛⎝Ms5xymax⎞ ⎠; Freischnitt der Abtriebswelle; Längen:; Lagerkräfte:; XY-Ebene:; FBy3≔――――=; FAy3≔FT4-FBy3=2.754; XZ-Ebene:; FBz3≔――――――=; FAz3≔FR4-FBz3=3.858; Seite 19 von 35

20) Lagerkräfte und Schnittgrößenverläufe Abtriebswelle

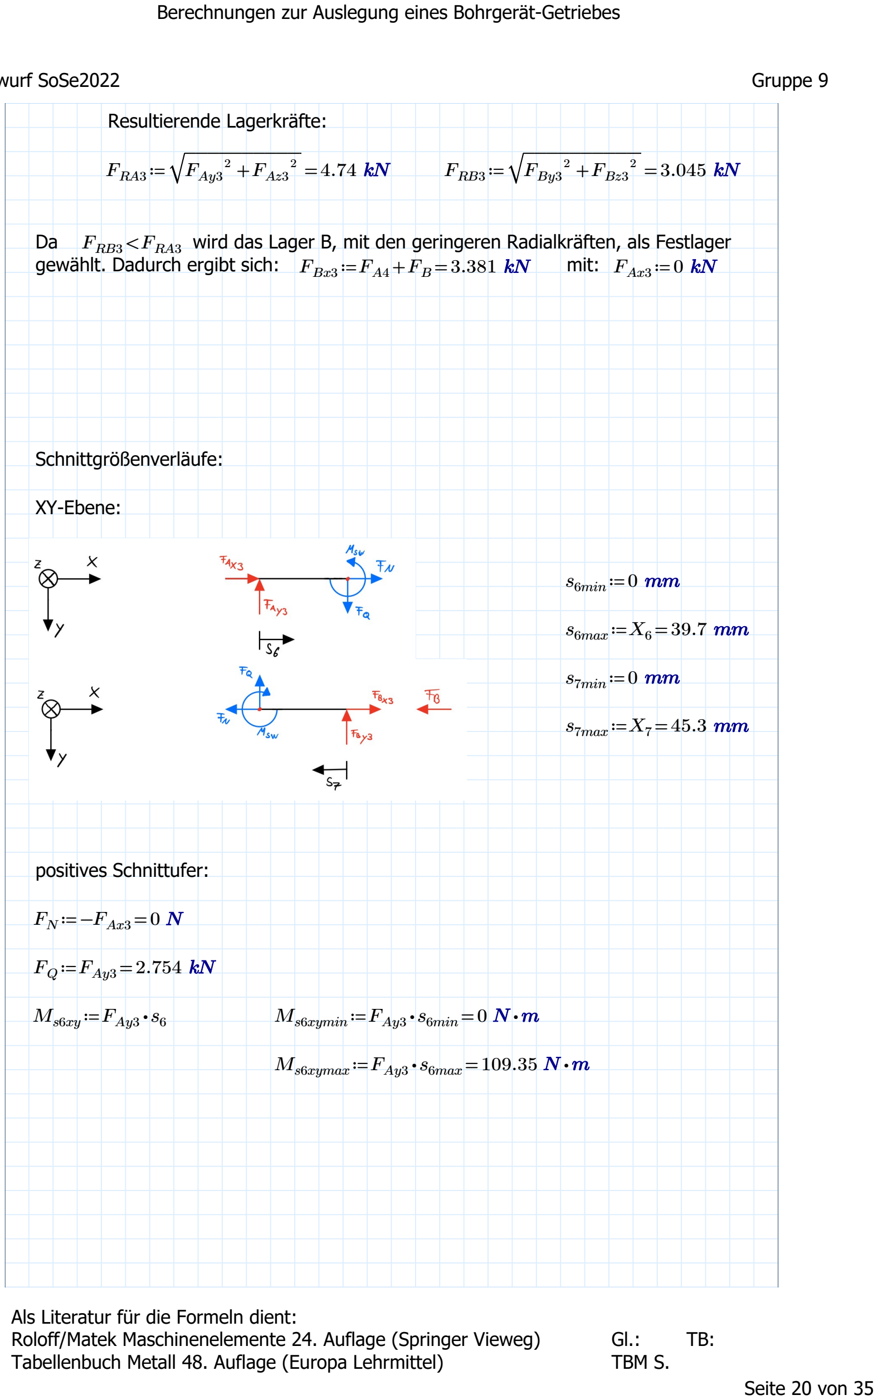
[picture p17: figure]
Resultierende Lagerkräfte:; FRA3≔; 2 FAz3; FRB3≔; 2 FBz3; gewählt. Dadurch ergibt sich:; mit:; FRB3<FRA3; FBx3≔FA4+FB =3.381 kN; FAx3≔0; Schnittgrößenverläufe:; XY-Ebene:; s6min≔0 mm; s6max≔X6=39.7; s7min≔0 mm; s7max≔X7=45.3; positives Schnittufer:; FN≔-FAx3=0 N; FQ≔FAy3=2.754 kN; Ms6xy≔FAy3 ⋅ s6; Ms6xymin≔FAy3 ⋅ s6min=0 N ⋅m; Ms6xymax≔FAy3 ⋅ s6max=109.35 N ⋅m; Seite 20 von 35

Da | wird das Lager B, mit den geringeren Radialkräften, als Festlager

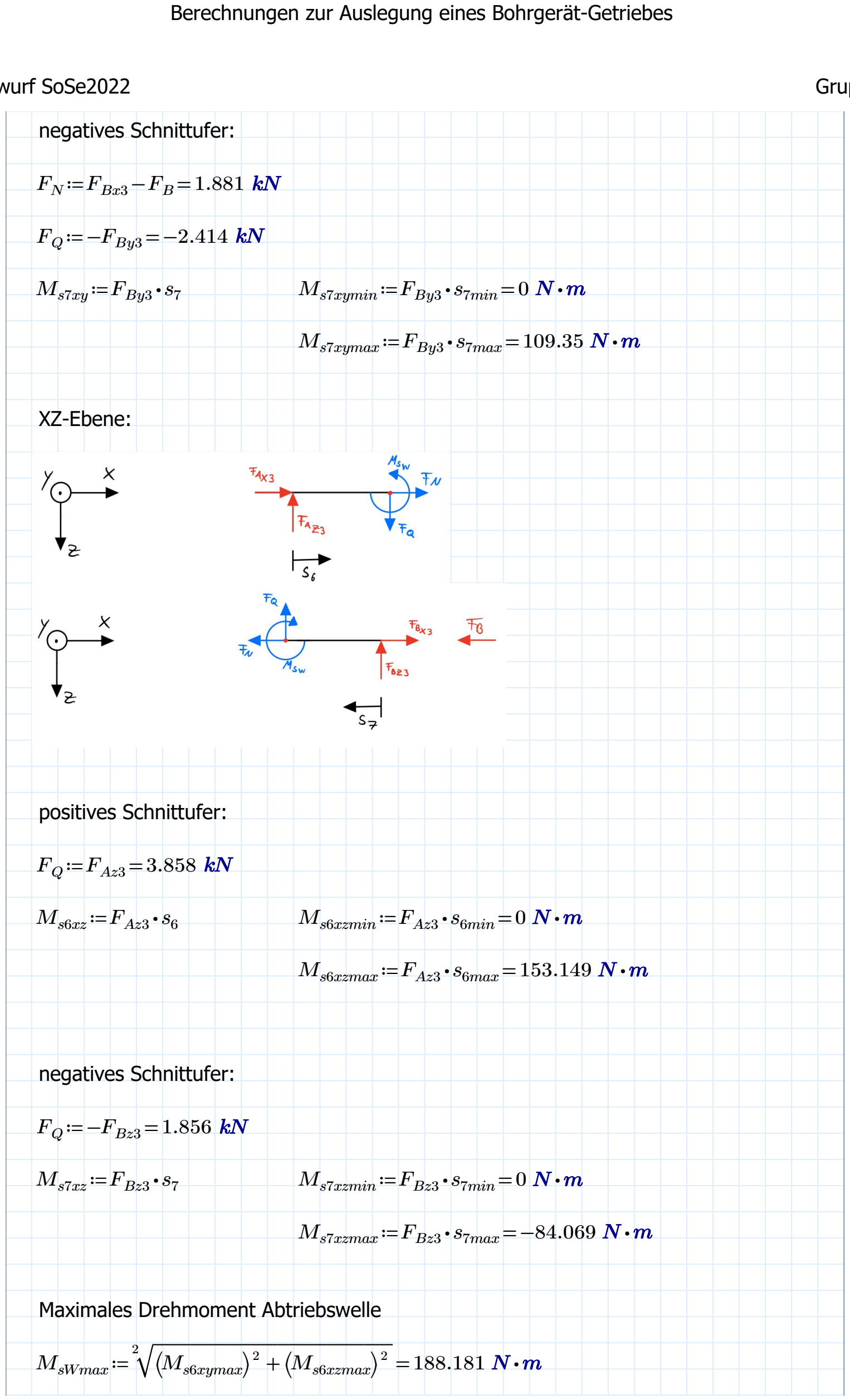
[picture p18: figure]
negatives Schnittufer:; FN≔FBx3-FB =1.881 kN; FQ≔-FBy3=-2.414 kN; Ms7xy≔FBy3 ⋅ s7; Ms7xymin≔FBy3 ⋅ s7min=0 N ⋅m; Ms7xymax≔FBy3 ⋅ s7max=109.35 N ⋅m; XZ-Ebene:; positives Schnittufer:; FQ≔FAz3=3.858 kN; Ms6xz≔FAz3 ⋅ s6; Ms6xzmin≔FAz3 ⋅ s6min=0 N ⋅m; Ms6xzmax≔FAz3 ⋅ s6max=153.149 N ⋅m; FQ≔-FBz3=1.856; Ms7xz≔FBz3 ⋅ s7; Ms7xzmin≔FBz3 ⋅ s7min=0 N ⋅m; Ms7xzmax≔FBz3 ⋅ s7max=-84.069 N ⋅m; Maximales Drehmoment Abtriebswelle; MsWmax≔; ⎛⎝Ms6xymax⎞; 2 ⎛⎝Ms6xzmax⎞ ⎠

Seite 21 von 35

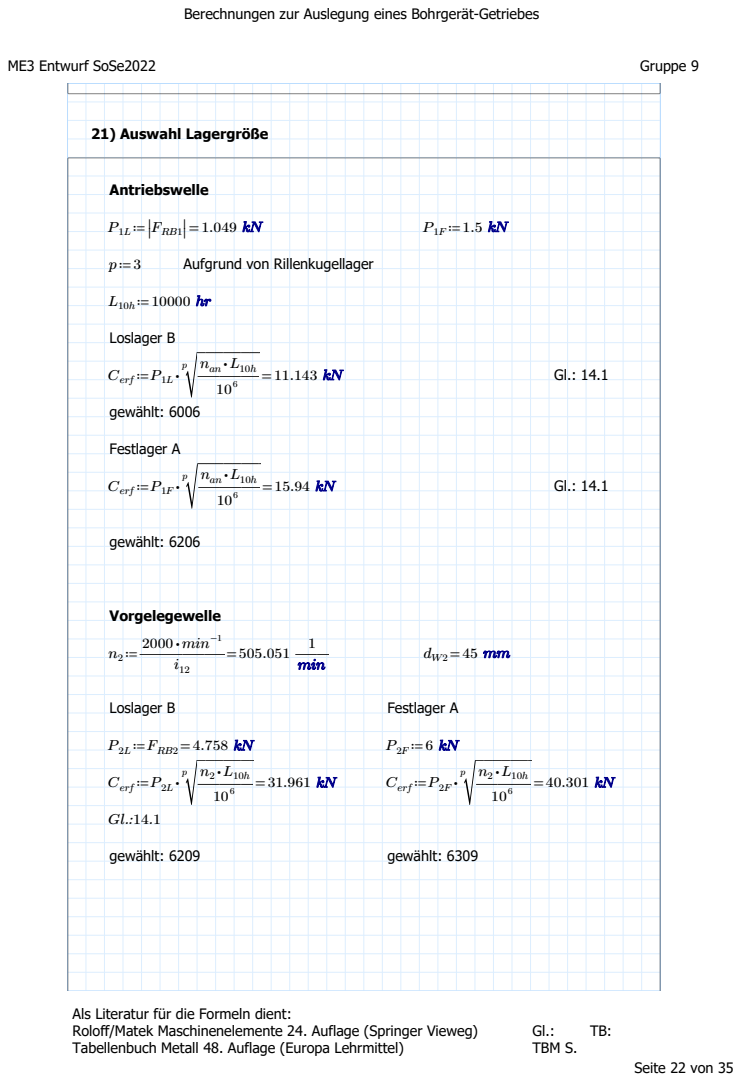
[picture p19: page 22]
21) Auswahl Lagergröße; Antriebswelle; |FRB1|; Aufgrund von Rillenkugellager; Loslager B; Cerf≔P1L ⋅; gewählt: 6006; Festlager A; Cerf≔P1F ⋅; gewählt: 6206; Vorgelegewelle; 2000 ⋅min⁻¹; 505.051 ―1―min; P2L≔FRB2=4.758; Cerf≔P2L ⋅; Cerf≔P2F ⋅; gewählt: 6209; gewählt: 6309; Seite 22 von 35

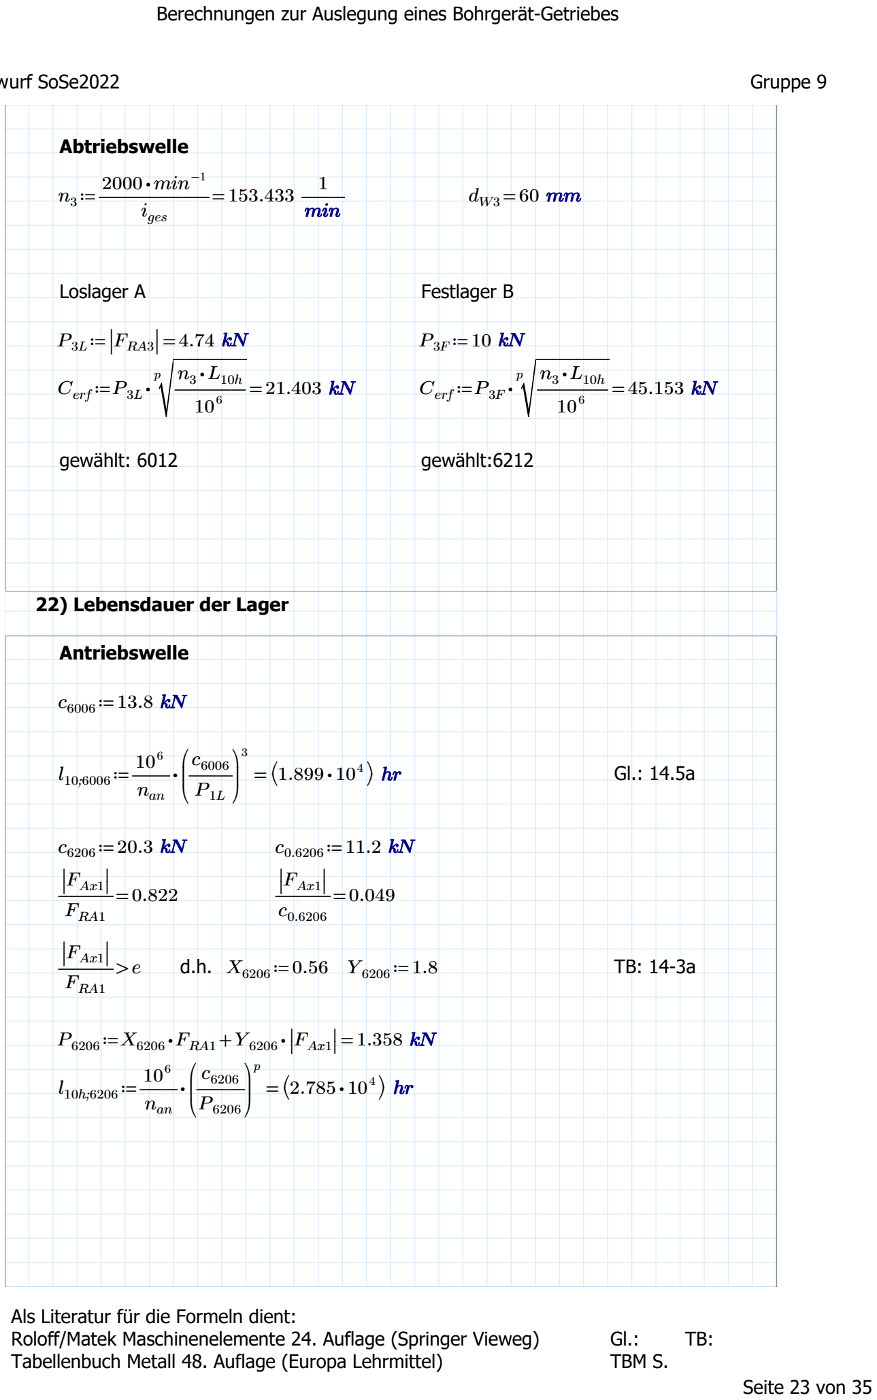
[picture p20: figure]
Abtriebswelle; 2000 ⋅min⁻¹; iges; 153.433 ―1―min; Loslager A; Festlager B; |FRA3|; Cerf≔P3L ⋅; Cerf≔P3F ⋅; gewählt: 6012; gewählt:6212; 22) Lebensdauer der Lager; Antriebswelle; nan; |FAx1| |; FRA1; P6206≔X6206 ⋅FRA1+Y6206 ⋅|; |FAx1| |=1.358 kN; Seite 23 von 35

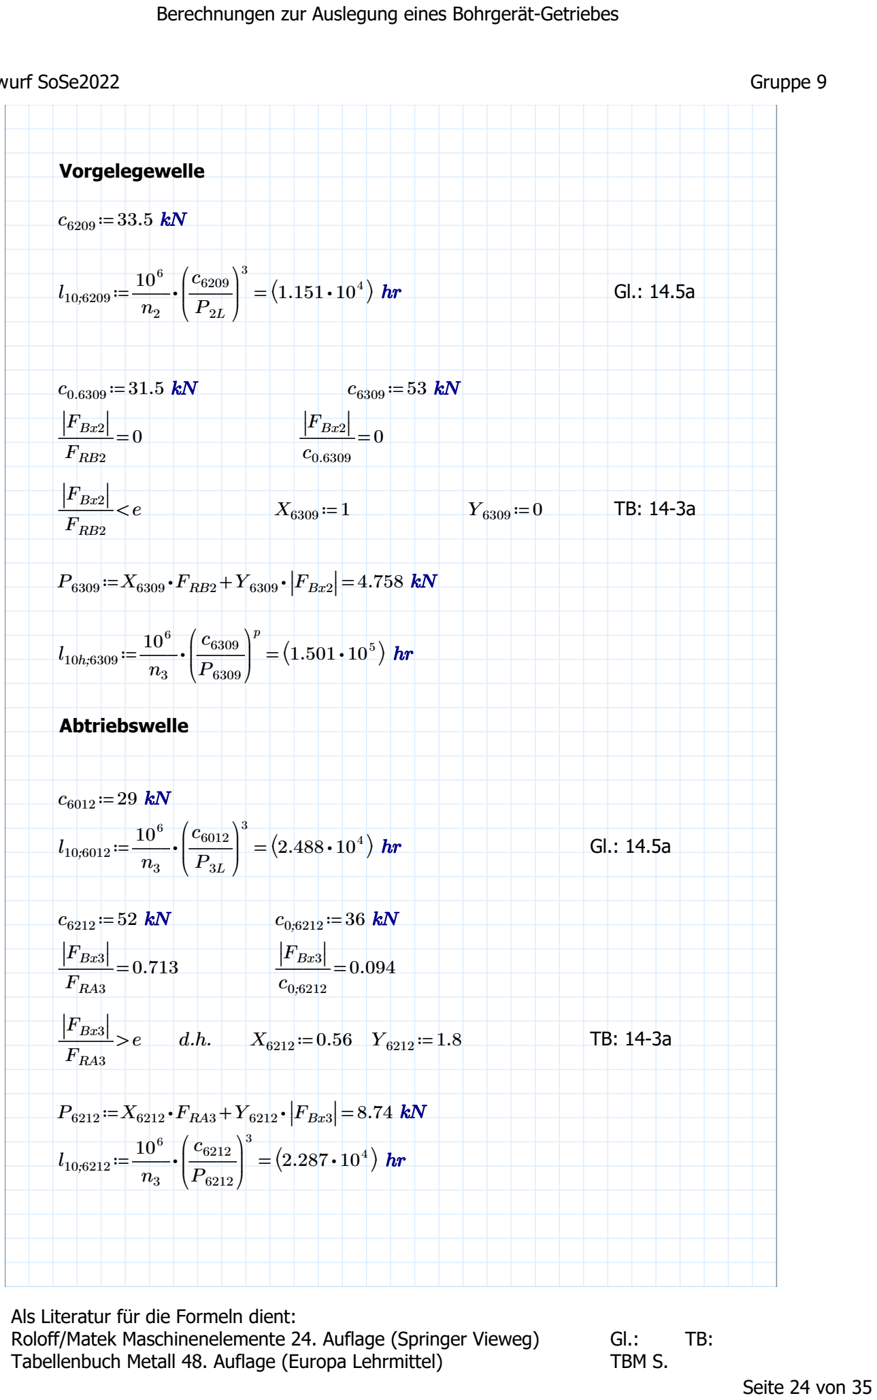
[picture p21: figure]
Vorgelegewelle; |FBx2| |; FRB2; P6309≔X6309 ⋅FRB2+Y6309 ⋅|; |FBx2| |=4.758 kN; Abtriebswelle; |FBx3| |; FRA3; P6212≔X6212 ⋅FRA3+Y6212 ⋅|; |FBx3| |=8.74 kN; Seite 24 von 35

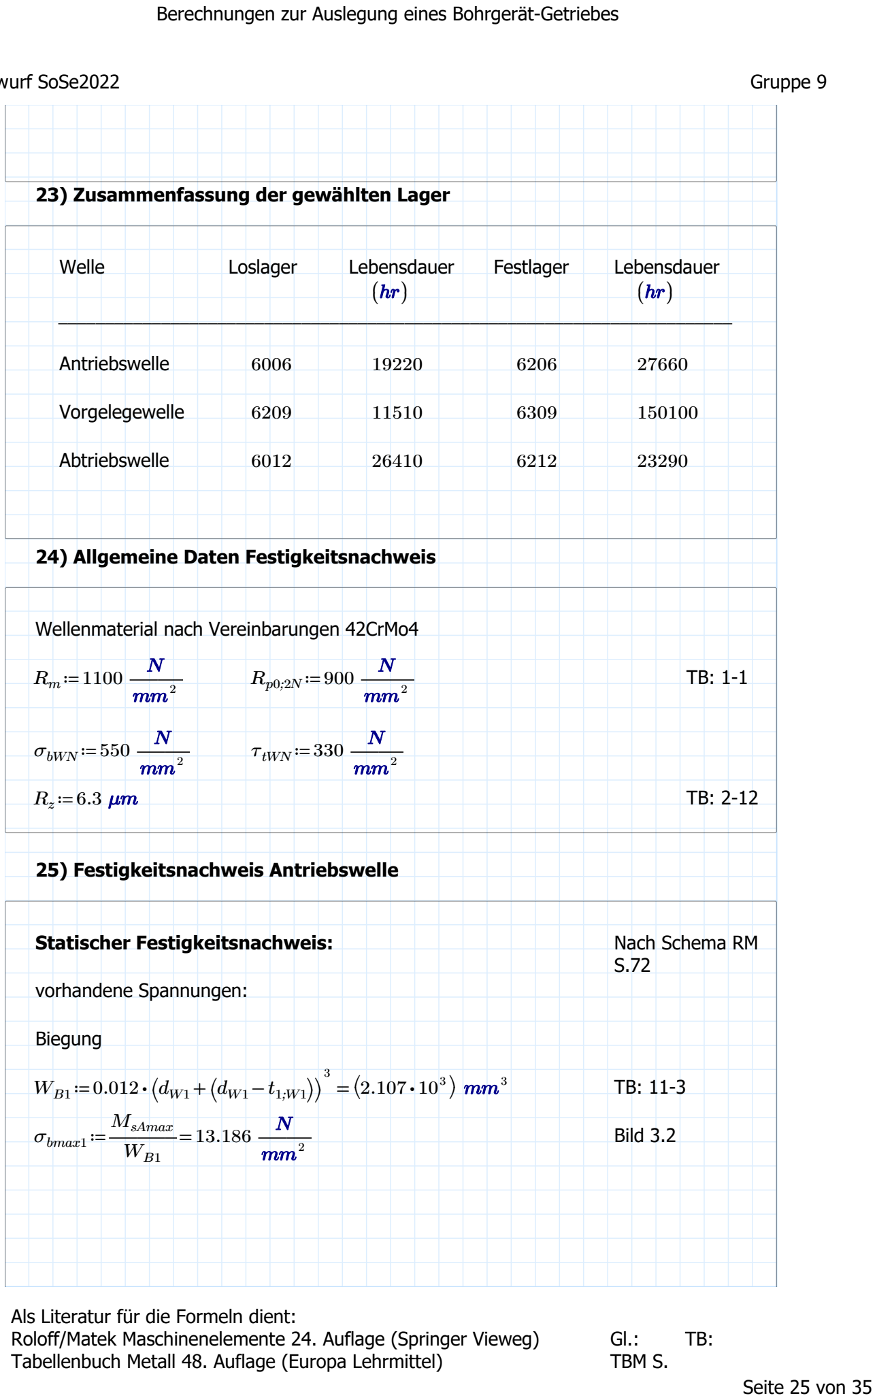
[picture p22: figure]
23) Zusammenfassung der gewählten Lager; Welle; Loslager; Lebensdauer; Festlager; Antriebswelle; Vorgelegewelle; Abtriebswelle; Wellenmaterial nach Vereinbarungen 42CrMo4; ―N―mm²; Rp0;2N≔900 ―N―mm²; σbWN≔550 ―N―mm²; τtWN≔330 ―N―mm²; 25) Festigkeitsnachweis Antriebswelle; Statischer Festigkeitsnachweis:; Nach Schema RM; vorhandene Spannungen:; Biegung; mm³; σbmax1≔―――=; MsAmax; 13.186 ―N―mm²; Bild 3.2; Seite 25 von 35

24) Allgemeine Daten Festigkeitsnachweis

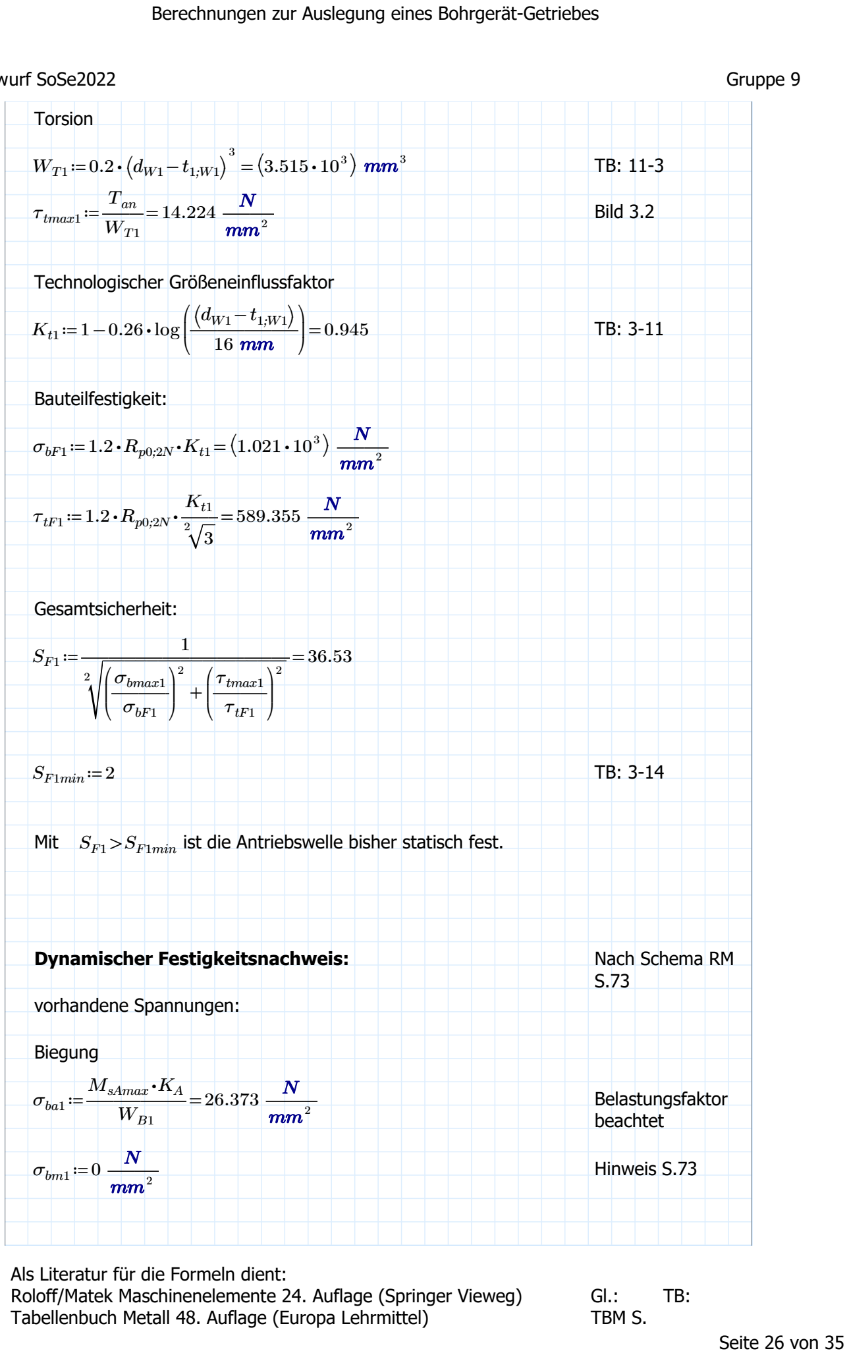
[picture p23: figure]
Torsion; ⎠ mm³; τtmax1≔――=; Tan; 14.224 ―N―mm²; Bild 3.2; Technologischer Größeneinflussfaktor; Kt1≔1-0.26 ⋅log; Bauteilfestigkeit:; σbF1≔1.2 ⋅Rp0;2N ⋅Kt1=⎛⎝1.021 ⋅ 10³ ⎞; ―N―mm²; τtF1≔1.2 ⋅Rp0;2N ⋅――=; 589.355 ―N―mm²; Gesamtsicherheit:; σbmax1; σbF1; τtmax1; τtF1; SF1min≔2; Dynamischer Festigkeitsnachweis:; Nach Schema RM; vorhandene Spannungen:; Biegung; σba1≔――――=; M ⋅ sAmax KA; 26.373 ―N―mm²; Belastungsfaktor beachtet; σbm1≔0 ―N―mm²; Hinweis S.73; Seite 26 von 35

Mit | ist die Antriebswelle bisher statisch fest. SF1>SF1min

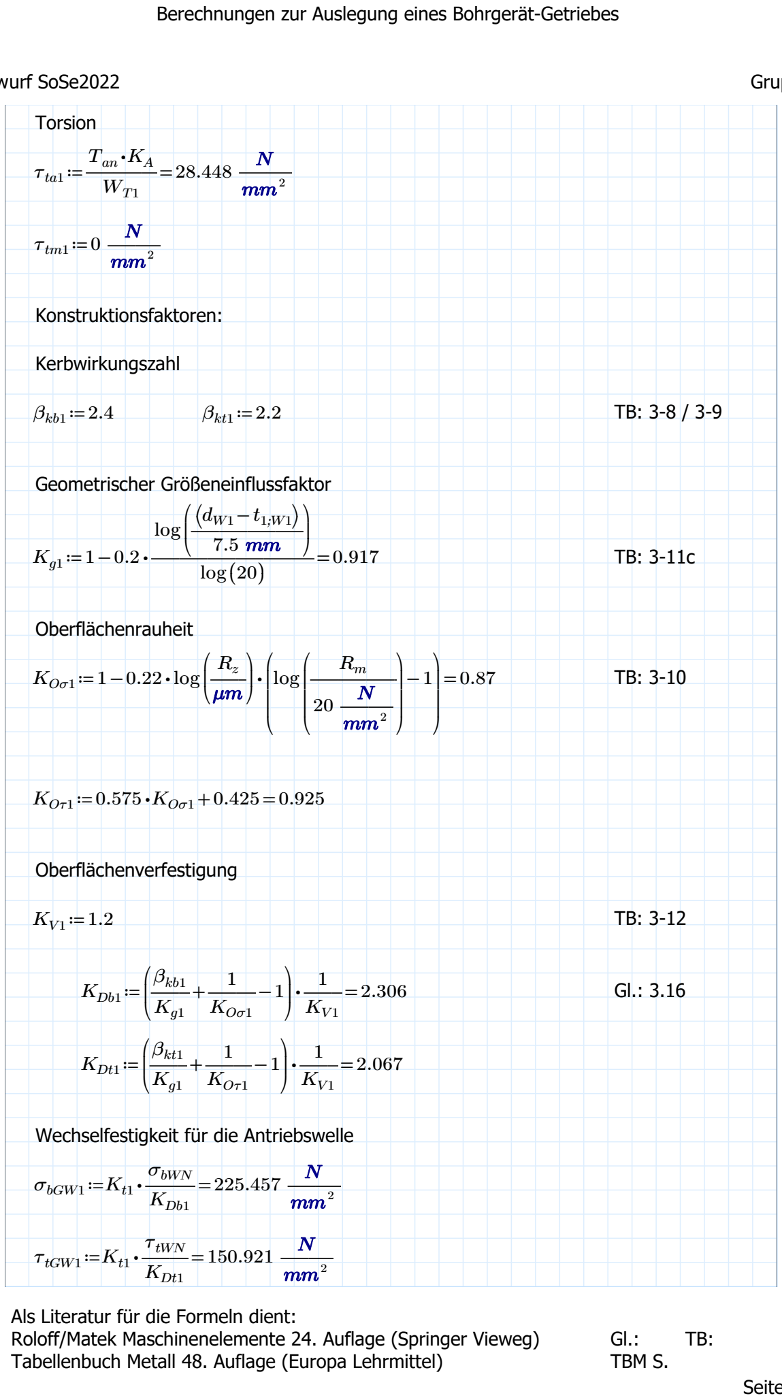
[picture p24: figure]
Torsion; τta1≔―――=; 28.448 ―N―mm²; τtm1≔0; ―N―mm²; Konstruktionsfaktoren:; Kerbwirkungszahl; βkb1≔2.4; βkt1≔2.2; Geometrischer Größeneinflussfaktor; log; log((20)); Oberflächenrauheit; KOσ1≔1-0.22 ⋅log; Rm 20 ―N―mm²; KOτ1≔0.575 ⋅KOσ1+0.425=0.925; Oberflächenverfestigung; KDb1≔; βkb1; ―1―KOσ1; KDt1≔; βkt1; ―1―KOτ1; Wechselfestigkeit für die Antriebswelle; σbGW1≔Kt1 ⋅――=; σbWN; KDb1; 225.457 ―N―mm²; τtGW1≔Kt1 ⋅――=; τtWN; KDt1; 150.921 ―N―mm²

Seite 27 von 35

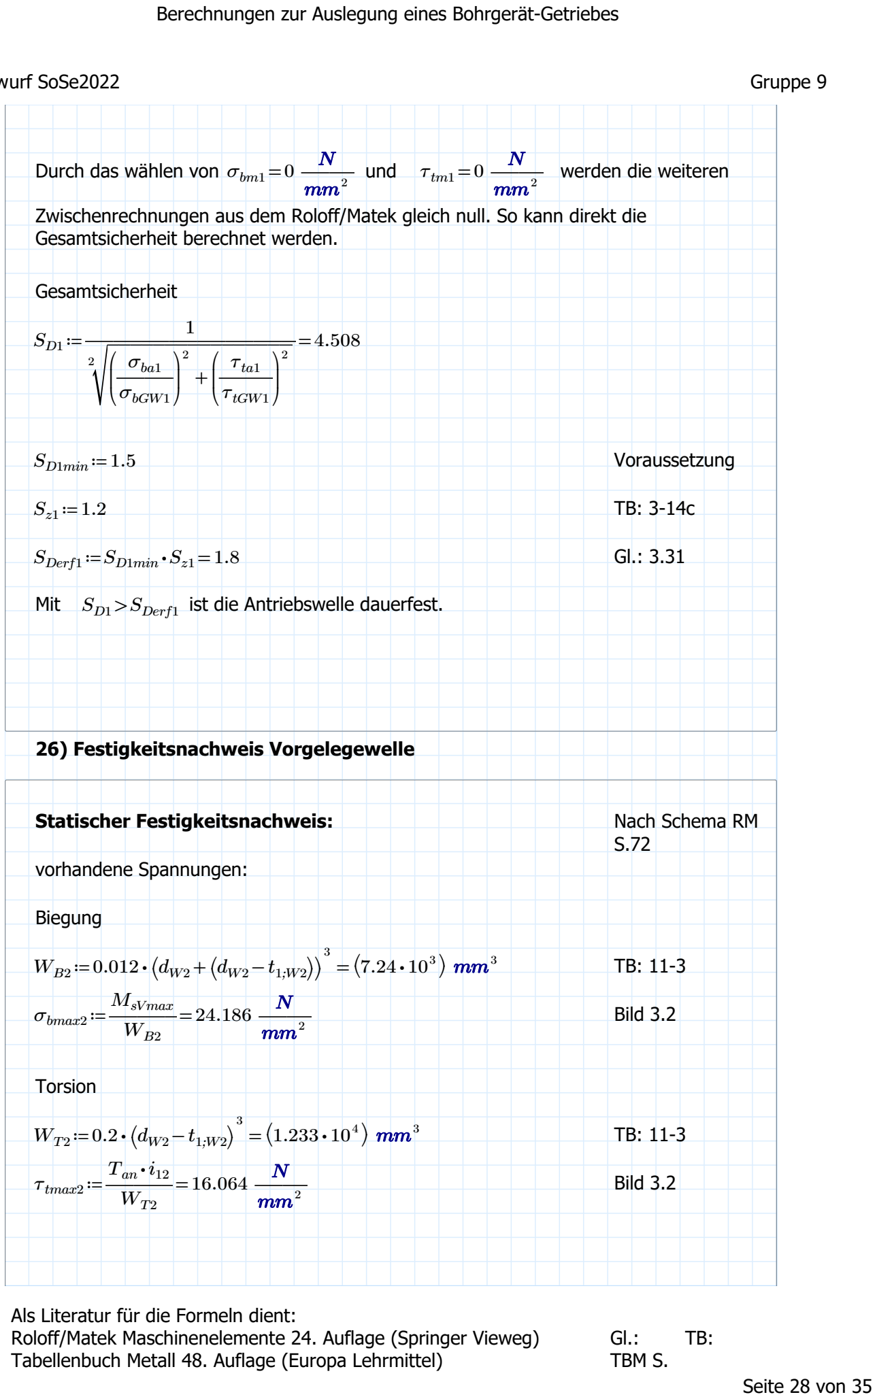
[picture p25: figure]
Durch das wählen von; und; werden die weiteren; Gesamtsicherheit berechnet werden.; σbm1=0; ―N―mm²; τtm1=0; Gesamtsicherheit; σba1; σbGW1; τta1; τtGW1; SD1min≔1.5; Voraussetzung; SDerf1≔SD1min ⋅Sz1=1.8; Mit; ist die Antriebswelle dauerfest. SD1>SDerf1; 26) Festigkeitsnachweis Vorgelegewelle; Statischer Festigkeitsnachweis:; Nach Schema RM; vorhandene Spannungen:; Biegung; ⎠ mm³; σbmax2≔―――=; MsVmax; 24.186 ―N―mm²; Bild 3.2; Torsion; τtmax2≔―――=; 16.064 ―N―mm²; Seite 28 von 35

Zwischenrechnungen aus dem Roloff/Matek gleich null. So kann direkt die

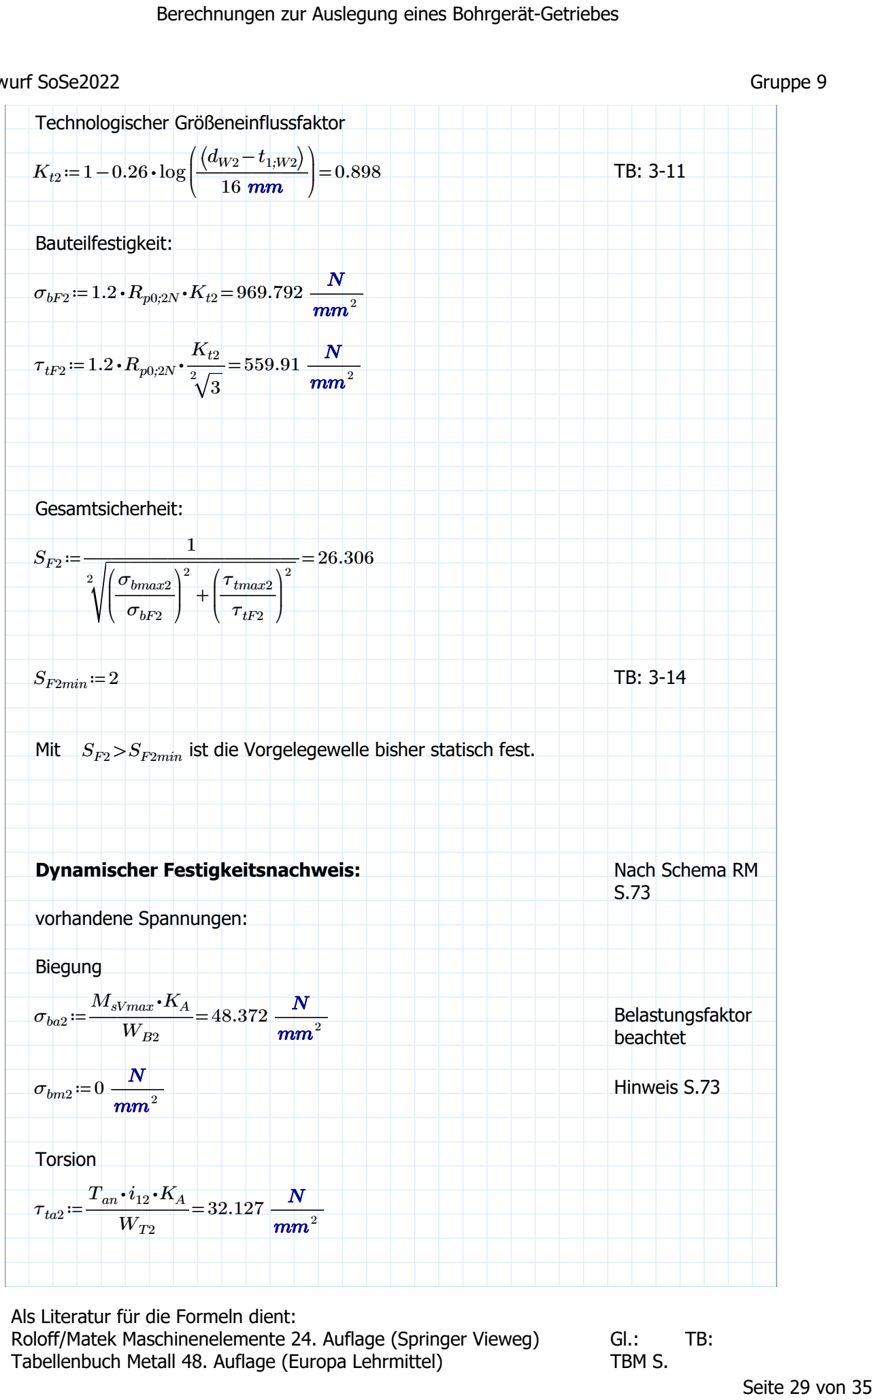
[picture p26: figure]
Technologischer Größeneinflussfaktor; Kt2≔1-0.26 ⋅log; Bauteilfestigkeit:; σbF2≔1.2 ⋅Rp0;2N ⋅Kt2=969.792 ―N―mm²; τtF2≔1.2 ⋅Rp0;2N ⋅――=; 559.91 ―N―mm²; Gesamtsicherheit:; σbmax2; σbF2; τtmax2; τtF2; SF2min≔2; Dynamischer Festigkeitsnachweis:; Nach Schema RM; vorhandene Spannungen:; Biegung; σba2≔――――=; M ⋅ sVmax KA; 48.372 ―N―mm²; Belastungsfaktor beachtet; σbm2≔0 ―N―mm²; Hinweis S.73; Torsion; τta2≔――――=; 32.127 ―N―mm²; Seite 29 von 35

Mit | ist die Vorgelegewelle bisher statisch fest. SF2>SF2min

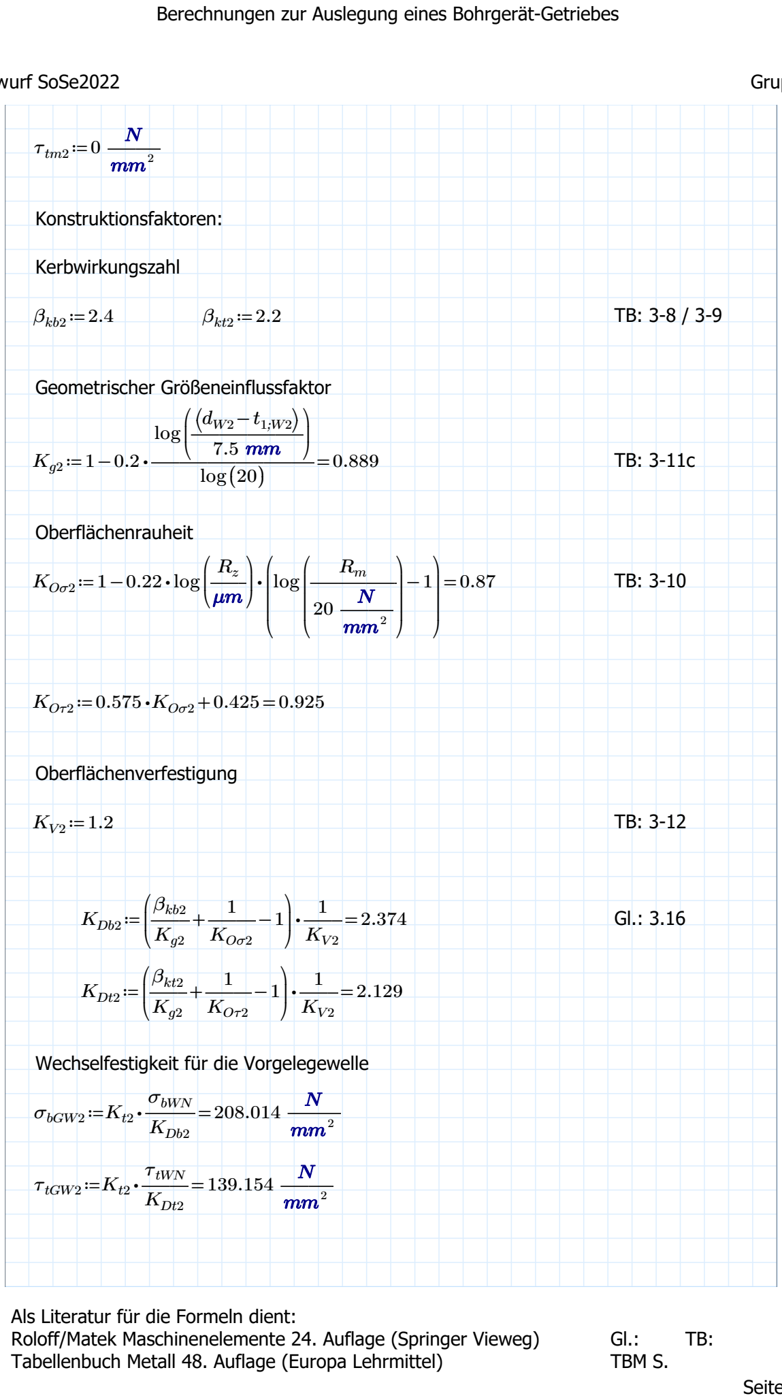
[picture p27: figure]
τtm2≔0; ―N―mm²; Konstruktionsfaktoren:; Kerbwirkungszahl; βkb2≔2.4; βkt2≔2.2; Geometrischer Größeneinflussfaktor; log; log((20)); Oberflächenrauheit; KOσ2≔1-0.22 ⋅log; Rm 20 ―N―mm²; KOτ2≔0.575 ⋅KOσ2+0.425=0.925; Oberflächenverfestigung; KDb2≔; βkb2; ―1―KOσ2; KDt2≔; βkt2; ―1―KOτ2; σbGW2≔Kt2 ⋅――=; σbWN; KDb2; 208.014 ―N―mm²; τtGW2≔Kt2 ⋅――=; τtWN; KDt2; 139.154 ―N―mm²

Wechselfestigkeit für die Vorgelegewelle

Seite 30 von 35

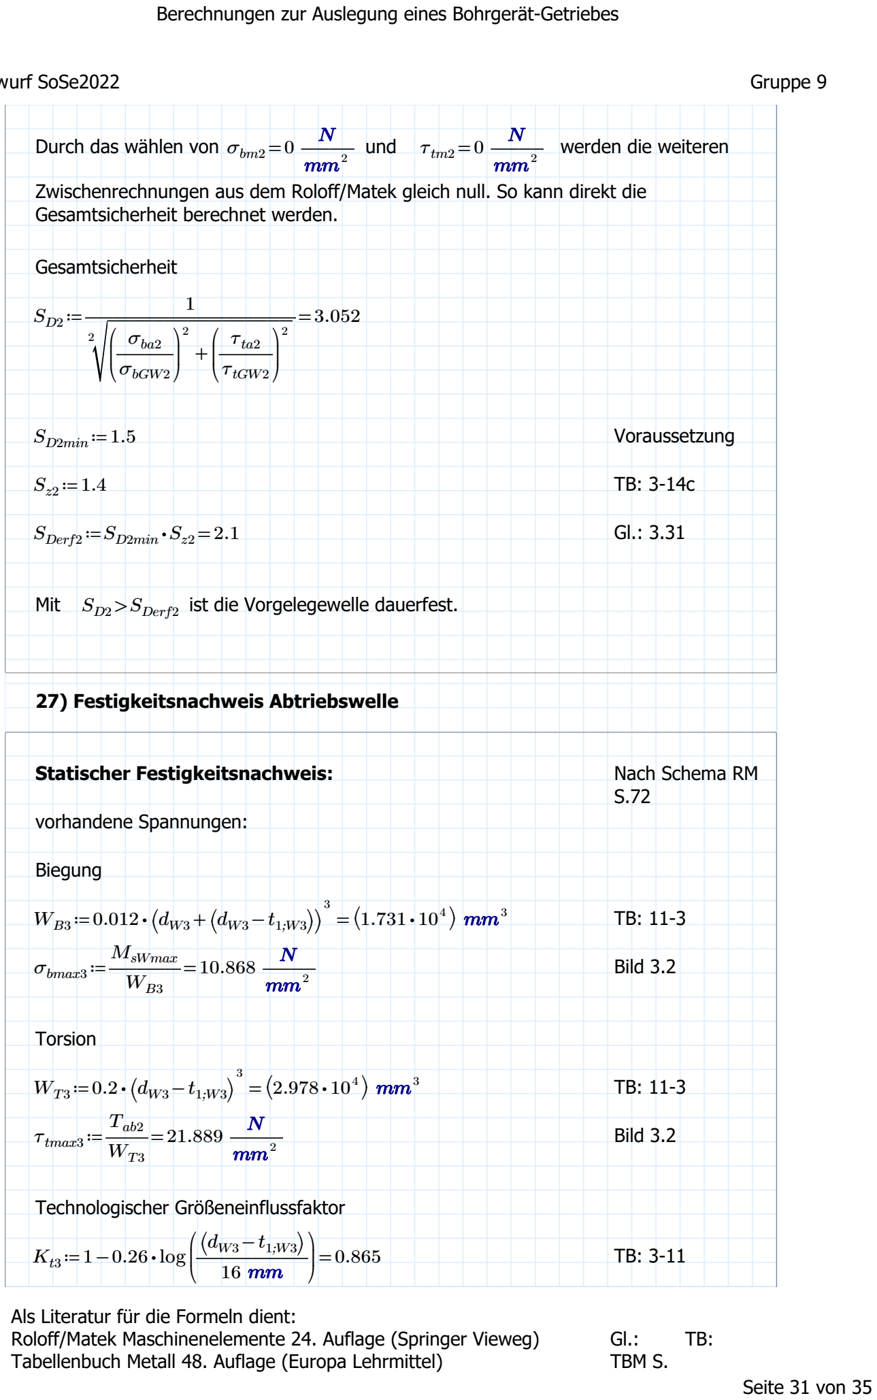
[picture p28: figure]
Durch das wählen von; und; werden die weiteren; Gesamtsicherheit berechnet werden.; σbm2=0; ―N―mm²; τtm2=0; Gesamtsicherheit; σba2; σbGW2; τta2; τtGW2; SD2min≔1.5; Voraussetzung; SDerf2≔SD2min ⋅Sz2=2.1; Mit; ist die Vorgelegewelle dauerfest. SD2>SDerf2; 27) Festigkeitsnachweis Abtriebswelle; Statischer Festigkeitsnachweis:; Nach Schema RM; vorhandene Spannungen:; Biegung; mm³; σbmax3≔―――=; MsWmax; 10.868 ―N―mm²; Bild 3.2; Torsion; ⎠ mm³; τtmax3≔――=; Tab2; 21.889 ―N―mm²; Technologischer Größeneinflussfaktor; Kt3≔1-0.26 ⋅log; Seite 31 von 35

Zwischenrechnungen aus dem Roloff/Matek gleich null. So kann direkt die

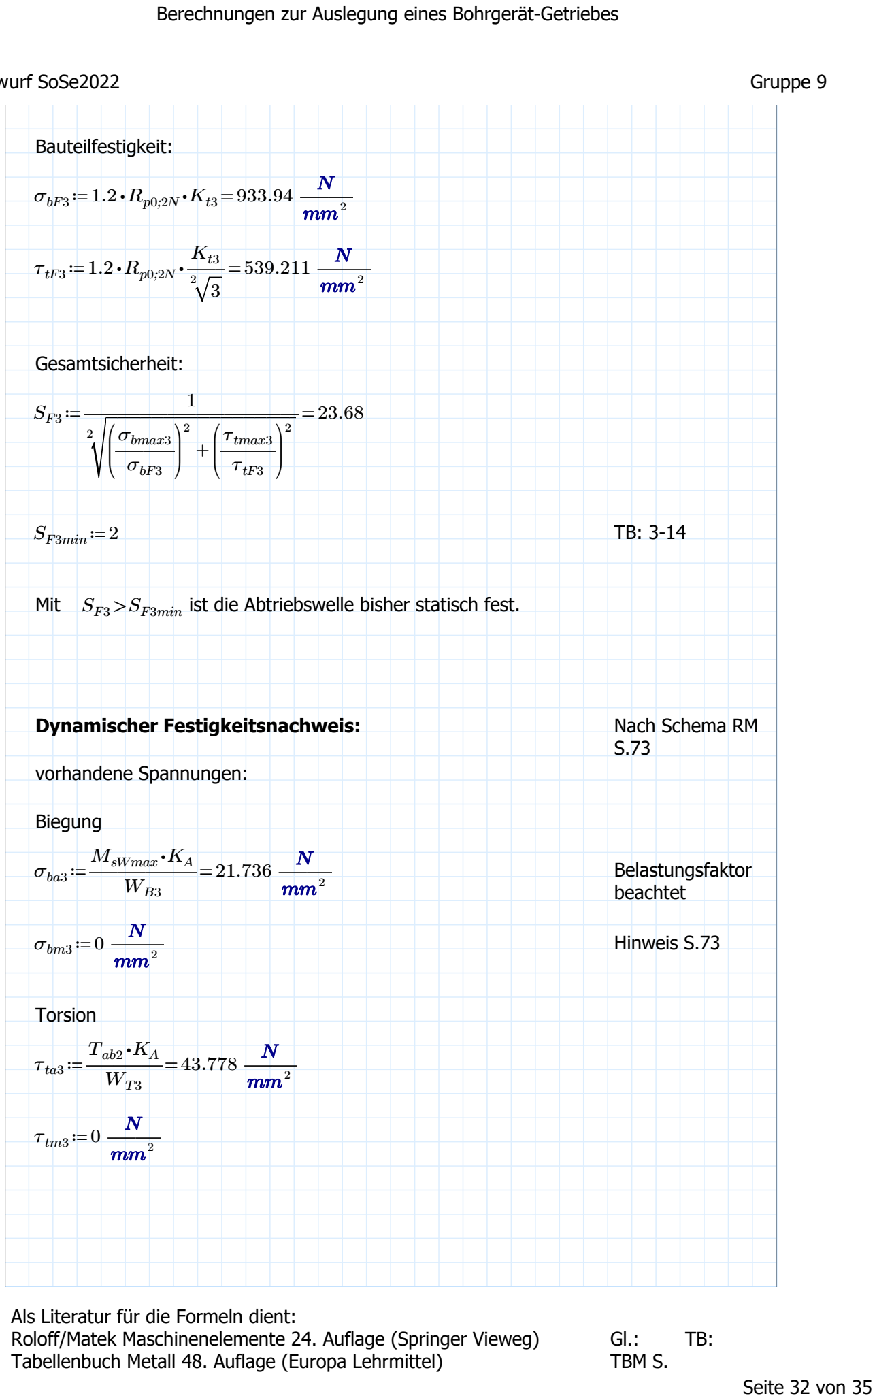
[picture p29: figure]
Bauteilfestigkeit:; σbF3≔1.2 ⋅Rp0;2N ⋅Kt3=933.94; ―N―mm²; τtF3≔1.2 ⋅Rp0;2N ⋅――=; 539.211 ―N―mm²; Gesamtsicherheit:; σbmax3; σbF3; τtmax3; τtF3; SF3min≔2; Dynamischer Festigkeitsnachweis:; Nach Schema RM; vorhandene Spannungen:; Biegung; σba3≔――――=; M ⋅ sWmax KA; 21.736 ―N―mm²; Belastungsfaktor beachtet; σbm3≔0 ―N―mm²; Hinweis S.73; Torsion; τta3≔―――=; 43.778 ―N―mm²; τtm3≔0; Seite 32 von 35

Mit | ist die Abtriebswelle bisher statisch fest. SF3>SF3min

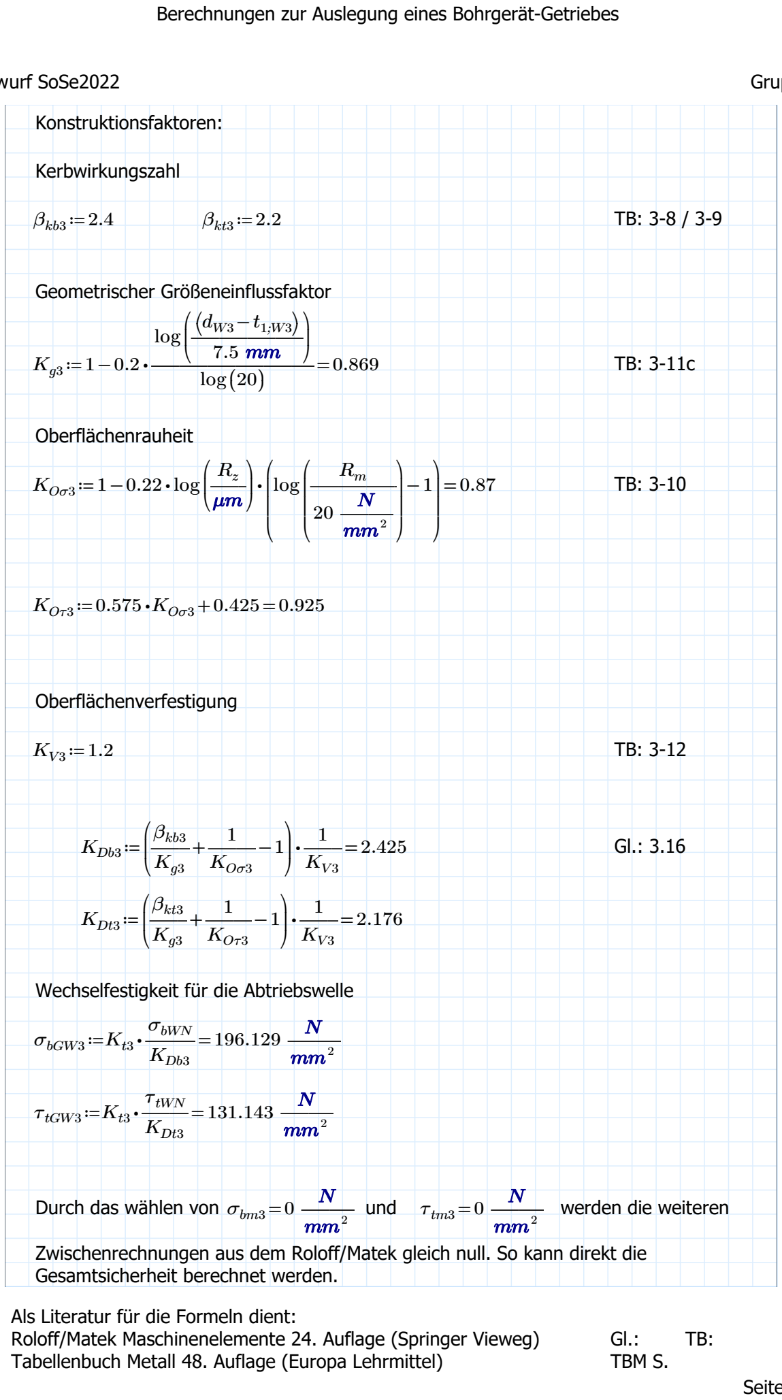
[picture p30: figure]
Konstruktionsfaktoren:; Kerbwirkungszahl; βkb3≔2.4; βkt3≔2.2; Geometrischer Größeneinflussfaktor; log; log((20)); Oberflächenrauheit; KOσ3≔1-0.22 ⋅log; Rm 20 ―N―mm²; KOτ3≔0.575 ⋅KOσ3+0.425=0.925; Oberflächenverfestigung; KDb3≔; βkb3; ―1―KOσ3; KDt3≔; βkt3; ―1―KOτ3; Wechselfestigkeit für die Abtriebswelle; σbGW3≔Kt3 ⋅――=; σbWN; KDb3; 196.129 ―N―mm²; τtGW3≔Kt3 ⋅――=; τtWN; KDt3; 131.143 ―N―mm²; Gesamtsicherheit berechnet werden.; σbm3=0; ―N―mm²; τtm3=0

Durch das wählen von | und | werden die weiteren

Zwischenrechnungen aus dem Roloff/Matek gleich null. So kann direkt die

Seite 33 von 35

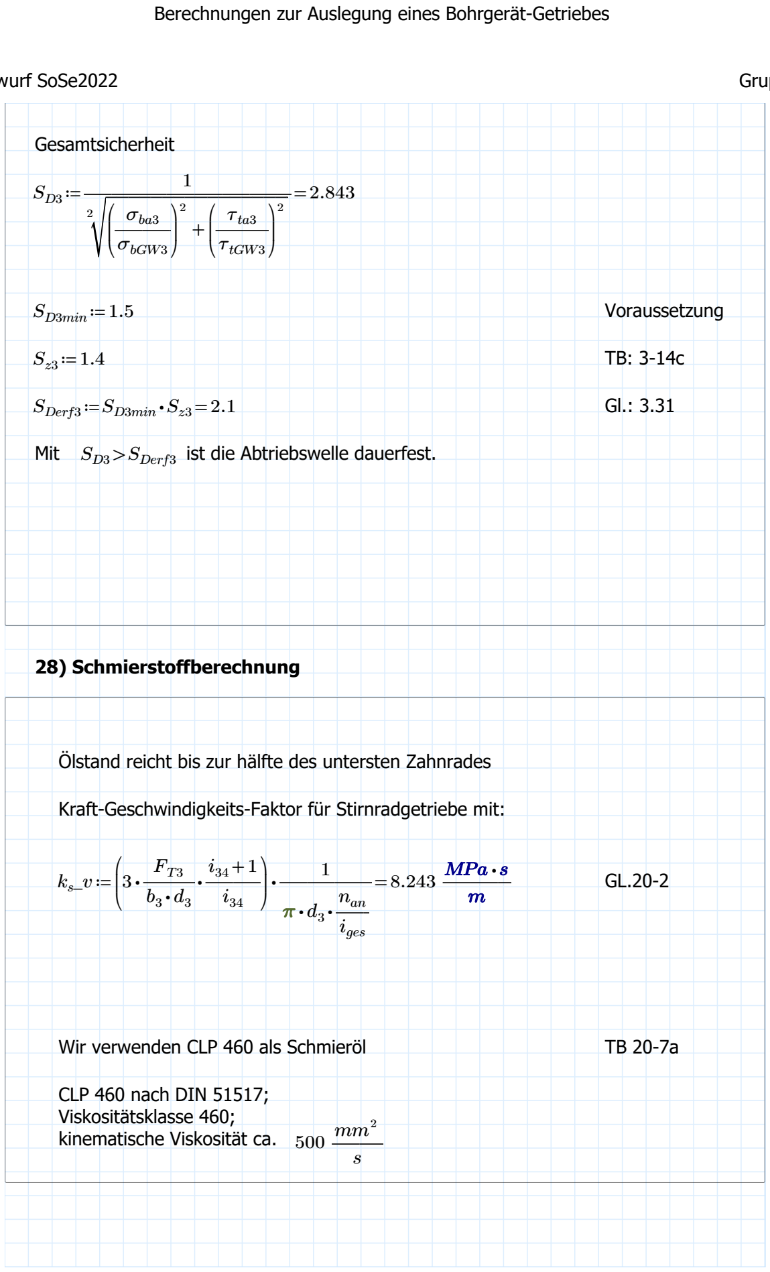
[picture p31: figure]
Gesamtsicherheit; σba3; σbGW3; τta3; τtGW3; SD3min≔1.5; Voraussetzung; SDerf3≔SD3min ⋅Sz3=2.1; Mit; ist die Abtriebswelle dauerfest. SD3>SDerf3; 28) Schmierstoffberechnung; Kraft-Geschwindigkeits-Faktor für Stirnradgetriebe mit:; nan; iges; 8.243 ―MPa―⋅―s m; CLP 460 nach DIN 51517; Viskositätsklasse 460;; kinematische Viskosität ca.

Ölstand reicht bis zur hälfte des untersten Zahnrades

Wir verwenden CLP 460 als Schmieröl | TB 20-7a

Seite 34 von 35

29) Fliehkraftkupplung
NFK≔3 | mFK≔0.5 | kg | rFK≔50 mm | FF≔20 N
DR≔140 mm | µ0≔0.9
ω≔2 ⋅π⋅nS=115.192 | ―1
| s

Winkelgeschwindigkeit

FFlieh≔mFK ⋅ rFK ⋅ω =

2 | 331.728 N | Fliehkraft
FNK≔FFlieh-FF=311.728 N | Kontaktkraft

FR≔µ0

⋅FNK =280.556 N | Reibkraft zwischen Fliehkörper und Gehäuse

TR≔NFK ⋅FR ⋅――=

DR
2
| 58.917 N·m | Reibmoment

Da das erforderliche Antriebsdrehmoment von 50Nm hier großzügig eingehalten wird, wird die Fliehkraftkupplung mit drei Fliehkörpern gebaut.

Seite 35 von 35
