Marvin20212/Gruppe9_ME3E/Berechnungen/Altversionen Alle Rechnungen/Alle Rechnungen 12.04.2022.pdf

Berechnungen zur Auslegung eines Bohrgerät-Getriebes

ME3 Entwurf SoSe2022 | Gruppe 9

Vorgegebene Auslegungsdaten:; Bezeichnung und Wert:; Benennung:; Tan≔50 N ⋅m; Antriebsdrehmoment; Abtriebsdrehmoment; Schaltdrehzahl; Tab1≔650 N ⋅m; nS≔1100 min ⁻¹; nan≔2000; min ⁻¹; Antriebsdrehzahl; Bohr-Abtriebskraft; Belastungsfaktor; rechnerisches Übersetzungsverhältnis; iges≔――=; Tab1; Tan; TBM S. 269; iges; nab≔――=; nan; 153.846 min ⁻¹; Zähnezahlen der Zahnräder; Als Literatur für die Formeln dient:

1) Auslegen der Übersetzung und Bestimmung der Zähnezahlen
iges≔i12 ⋅i34=13 | Das Gegenrechnen bestätigt den Wert für iges
Roloff/Matek Maschinenelemente 24. Auflage (Springer Vieweg) | Gl.: | TB:
Tabellenbuch Metall 48. Auflage (Europa Lehrmittel) | TBM S.
Seite 1 von 35

tatsächliches Übersetzungsverhältnis; 3.96 TBM S. 269; iges≔i12 ⋅i34=13.035; Abweichung Abtriebsparameter; Abtriebsdrehmoment weicht 0,3% im positiven Sinne von den Anforderungen ab.; Tab2; Tab1; nab≔――=; nan; iges; 153.433 min ⁻¹

Tab2≔Tan ⋅iges=651.75 N ⋅m | Das ausgelegte

Seite 2 von 35

2) Berechnung der Wellen und Passfedern

τtzul≔50 ―N―mm²
Dauerfestigkeitsschubspannung von 42CrMo4
nP≔1 | Anzahl Passfedern pro Welle-Nabe Verbindung
φ≔1 | Traganteil der Passfeder
Re≔295 ―N―mm² | Streckgrenze E295
SF≔1.1 | Sicherheit Fließgrenze

pFzul≔―=

Re
SF

268.182 ―N―mm²
| Zulässige Flächenpressung einer Passfeder

Antriebswelle:

dmin1≔ | =

3 ――――

16 ⋅T ⋅ an KA

π⋅τtzul

21.677 mm | dW1≔30 mm | t1;W1≔4 mm

l

t1≔―――――――――――=

2 ⋅Tan
dW1 ⋅ ⎛ | ⋅ | ⋅ | ⋅ ⎝7 mm -t1;W1⎞
⎠ | nP φ pFzul
4.143 mm | bP1≔8 mm

Da die tragende Länge der Passfeder der ungefähren Breite der Zahnräder entsprechen sollte, wird im Folgenden die Länge an die später berechnete Zahnradbreite angeglichen.
lP1≔28 | mm | gewählt: Antriebswelle ⌀ 30mm
Passfeder DIN 6885 - A8 x 7 x 28

Vorgelegewelle:

dmin2≔ | =

3 ―――――

16 ⋅T | ⋅ | ⋅ an KA | i12

π⋅τtzul

34.295 mm | dW2≔45 mm | t1;W2≔5.5 | mm

l

t2≔―――――――――――=

2 ⋅T | ⋅ an i12
dW2 ⋅ ⎛ | ⋅ | ⋅ | ⋅ ⎝9 mm -t1;W2⎞
⎠ | nP φ pFzul
9.375 mm | bP2≔14 | mm

Da die tragende Länge der Passfeder der ungefähren Breite der Zahnräder entsprechen sollte, wird im Folgenden die Länge an die später berechnete Zahnradbreite angeglichen.

lP2≔28 | mm | lP2≔50 | mm | gewählt: Vorgelegewelle ⌀ 45mm Passfeder DIN 6885 - A14 x 9 x 28 Passfeder DIN 6885 - A14 x 9 x 50

Seite 3 von 35

Abtriebswelle:

dmin3≔ | =

3 ―――――

16 ⋅T | ⋅ | ⋅ an KA | iges

π⋅τtzul

51.016 | mm | dW3≔60 mm | t1;W3≔7 mm

l

t3≔―――――――――――=

2 ⋅T | ⋅ an iges
dW3 ⋅ ⎛ | ⋅ | ⋅ ⋅ ⎝11 | mm -t1;W3⎞
⎠ nP | φ | pFzul
20.252 mm | bP3≔18 | mm

Da die tragende Länge der Passfeder der ungefähren Breite der Zahnräder entsprechen sollte, wird im Folgenden die Länge an die später berechnete Zahnradbreite angeglichen.

lP3≔50 | mm | gewählt: Abtriebswelle ⌀ 60mm Passfeder DIN 6885 - A18 x 11 x 50
3) Zahnradbreite

Bzul≔4.0 ―N―mm²
| | Überschlägigier Belastungswert
| | Formel nach Vereinbarungen
| | Um auf eine ganze Zahl für die Breite zu kommen, wird hier aufgerundet. Da ein ständiger Eingriff der Zahnräder 1 und 2 nötig ist, wird das Zahnrad 2 aufgrund des größeren Durchmessers etwas kleiner gewählt.

b1≔――――=

2 ⋅Tan
dW1 ⋅

### 2 Bzul

27.778 mm

b1≔30 | mm
b2≔28 | mm

b3≔――――=

2 ⋅T ⋅ an i12
dW2 ⋅

### 2 Bzul

48.889 | mm | Formel nach Vereinbarungen
| | Um auf eine ganze Zahl für die Breite zu kommen, wird hier aufgerundet. Da ein ständiger Eingriff der Zahnräder 3 und 4 nötig ist, wird das Zahnrad 4 aufgrund des größeren Durchmessers etwas kleiner gewählt.
b3≔52 | mm
b4≔50 | mm

Seite 4 von 35

4) Schrägungswinkel; Der Schrägungswinkel ist mit; bereits in den Vereinbarungen gegeben.; 5) Modul 1,2; 1.8 ⋅dW1 ⋅ cos ((β)) ⎛⎝z1-2.5⎞ ⎠; gewählt:; 6) Teilkreisdurchmesser Z1,Z2; cos ((β)); TBM S. 267; 7) Achsabstand 1,2; 8) Modul 3,4

Seite 5 von 35

9) Teilkreisdurchmesser Z3,Z4; cos ((β)); TBM S. 267; 10) Achsabstand 3,4; Differenz Achsabstände; Diese Differenz der Achsabstände muss; durch eine Profilverschiebung angeglichen werden. Diese wird im Folgenden berechnet.; 11) Profilverschiebung; die Profilverschiebung entschieden.; Stirneingriffswinkel; αt≔atan; tan⎛⎝αn; ⎞ ⎠ cos ((β)); Seite 6 von 35

Aufgrund weniger Drehmomentkräfte an den Zahnrädern 1 und 2 haben wir uns dort für

Ersatzzähnezahl; βb≔acos; sin⎛⎝αn; sin⎛⎝αt; cos ⎛; Profilverschiebungsfaktoren und Profilverschiebung; Betriebseingriffswinkel:; αwt≔acos; aus Gl.: 21.54 umgestellt; Profilverschiebungsfaktoren:; invαwt≔tan⎛⎝αwt⎞ ⎠-αwt⋅――=; aus Hinweisen von S.797/809; invαt≔tan⎛⎝αt; invαwt-invαt 2 ⋅ tan⎛⎝αn; x berechnen:; log; 0.133 aus Gl.: 21.33 umgestellt; Seite 7 von 35

Bei der Profilverschiebung V ist zum Berechnen der Wert x nötig. Dieser wird in der Formel für die Summe der Profilverschiebungsfaktoren errechnet, welche bis auf den Betriebseingriffswinkel zurückblickt. Daher werden im Folgenden mehrere Gleichungen angewendet, um letztendlich auf die Profilverschiebung zu kommen.

Verschiebungen:; Betriebswälzkreisdurchmesser; dwd1≔d1; cos ⎛⎝αt; ⎞ ⎠ cos ⎛⎝αwt⎞ ⎠; dwd2≔d2; dwd3≔d3=76.621 mm; dwd4≔d4=252.21 mm; neuer Achsabstand; dwd1+dwd2 2; Der Achsabstand ist nun, nach der; Verschiebung der selbe. v34; dwd3+dwd4 2; 12) Kopfspiel; nötiges Kopfspiel; Kopfhöhenänderung

c12≔0.25 ⋅mn12=0.625 mm | Gl. von Seite 794 / 803

Seite 8 von 35

13) Weitere Auslegungen der Zahnräder; Grundkreisdurchmesser; ⋅ cos ⎛⎝αt; Kopfkreisdurchmesser; Fußkreisdurchmesser; 14) Kopfspiel nach Profilverschiebung; c12neu≔av12-0.5 ⋅ ⎛⎝da1+df2⎞

Da c | und | augenscheinlich gleich sind, ist das nötige Kopfspiel eingehalten. 12 | c12neu

Seite 9 von 35

15) Profilüberdeckung; Überdeckung Zahnradpaar 1; mn12 cos ((β)); aus Gl.: 21.34; umgestellt; ⋅ 2 tan((β)); sin⎛⎝αwt⎞; cos ⎛⎝αt; mn34 cos ((β)); ⋅ 4 tan((β)); eingehalten.

Da ε | und | über 1,25 sind, ist die Mindestanforderung von 1,1 auf jeden Fall α1 | εα2

Seite 10 von 35

16) Zusammenfassung wichtiger Komponenten der Zahnräder 1-4
Zahnrad 1 | Zahnrad 2 | Zahnrad 3 | Zahnrad 4
Zähnezahl | z1 = 25 | z2 = 99 | z3 = 24 | z4 = 79
Teilkreisdurchmesser | d1 = 66.511 mm | d2 = 263.384 mm | d3 = 76.621 mm | d4 = 252.21 mm
Betriebswälzdurchmesser | dwd1 = 66.297 mm | dwd2 = 262.534 mm | dwd3 = 76.621 mm | dwd4 = 252.21 mm
Kopfkreisdurchmesser | da1 = 72.164 mm | da2 = 266.655 mm | da3 = 82.621 mm | da4 = 258.21 mm
Fußkreisdurchmesser | df1 = 60.926 mm | df2 = 255.417 mm | df3 = 70.621 mm | df4 = 246.21 mm
Zahnradbreite | b1 = 30 mm | b2 = 28 mm | b3 = 52 mm | b4 = 50 mm
Modul | mn12 = 2.5 mm | mn34 = 3 mm
Achsabstand | av12 = 164.415 mm | av34 = 164.415 mm
Verschiebung | V1 = 0.332 mm | V2 = -0.859 mm | V3 = 0 mm | V4 = 0 mm
Profilüberdeckung | εα12 = 1.576 | εα34 = 1.705
Sprungüberdeckung | εβ12 = 1.298 | εβ34 = 1.931
Gesamtüberdeckung | εγ12 = 2.873 | εγ34 = 3.636
17) Zahnradkräfte

Zahnrad 1:

Umfangskraft: | FT1≔―――=

2 ⋅Tan
d1
1.504 kN | Gl.:21.70
Radialkraft: | FR1≔―――――=

FT1 ⋅ tan⎛⎝αn

⎞
⎠
cos ((β))
0.582 | kN | Gl.:21.72
Axialkraft: | FA1≔FT1 ⋅ tan((β))=0.547 kN | Gl.:21.73

Seite 11 von 35

Zahnrad 2:

Umfangskraft: | FT2≔|

|FT1|
|=1.504 | kN
Radialkraft: | FR2≔|

|FR1|
|=0.582 | kN
Axialkraft: | FA2≔|

|FA1|
|=0.547 kN

Zahnrad 3:

Umfangskraft: | FT3≔2 ⋅―――=
T | ⋅ an | i12
d3

5.168 kN

Radialkraft: | FR3≔―――――=

FT3 ⋅ tan⎛⎝αn

⎞
⎠
cos ((β))

2.002 kN

Axialkraft: | FA3≔FT3 ⋅ tan((β))=1.881 kN

Zahnrad 4:

Umfangskraft: | FT4≔|

|FT3|
|=5.168 | kN
Radialkraft: | FR4≔|

|FR3|
|=2.002 | kN
Axialkraft: | FA4≔|

|FA3|
|=1.881 kN

Hier werden nur Beträge berechnet.
Die Richtungen der Kräfte sind den Schnittverläufen der Wellen zu entnehmen.

Seite 12 von 35

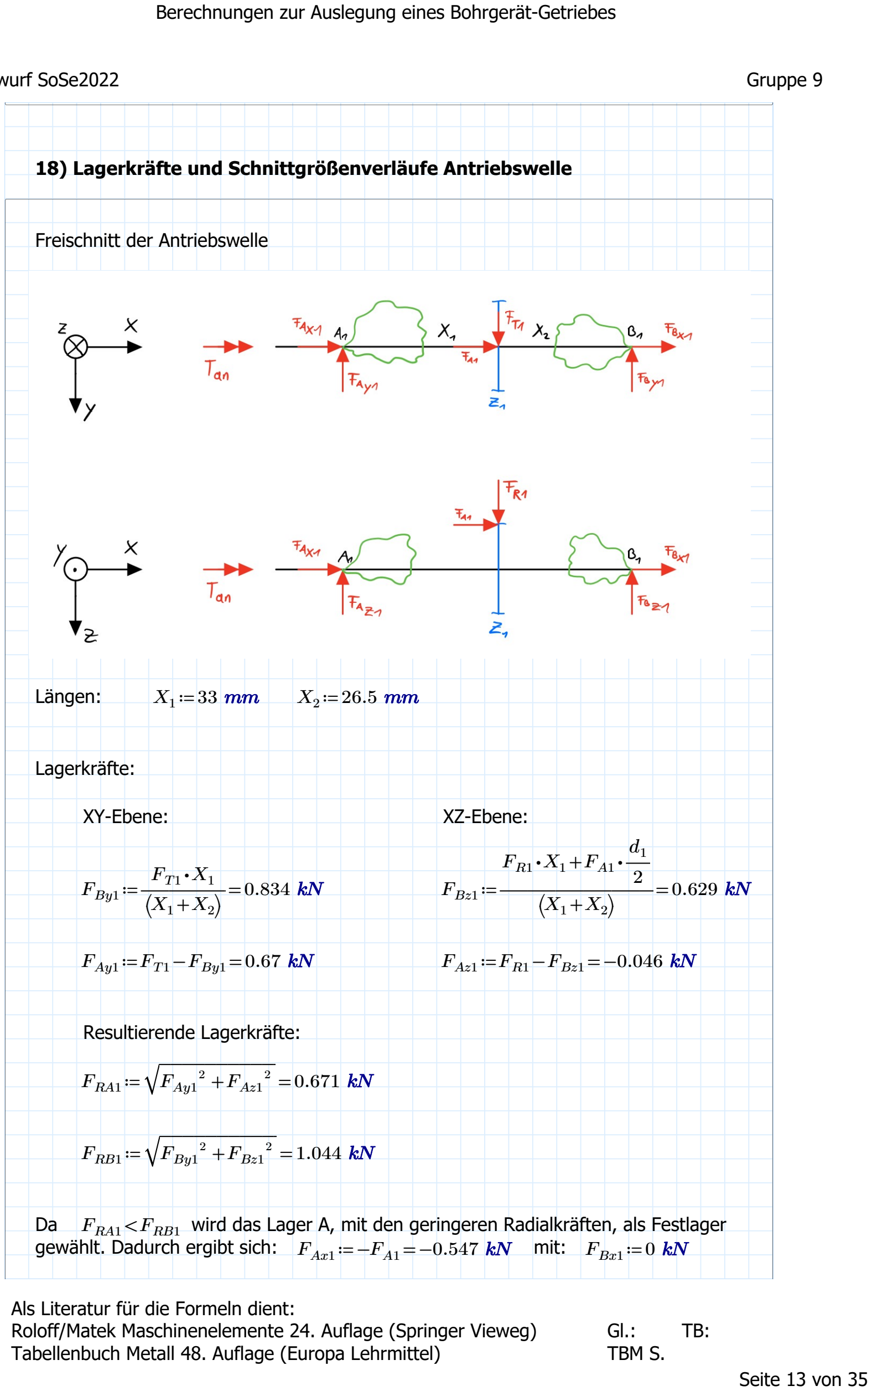
[picture p92: figure]
Freischnitt der Antriebswelle; Längen:; Lagerkräfte:; XY-Ebene:; XZ-Ebene:; FBy1≔――――=; FBz1≔――――――=; FAy1≔FT1-FBy1=0.67 kN; FAz1≔FR1-FBz1=-0.046 kN; Resultierende Lagerkräfte:; FRA1≔; 2 FAz1; FRB1≔; 2 FBz1; gewählt. Dadurch ergibt sich:; mit:; FRA1<FRB1; FAx1≔-FA1=-0.547; FBx1≔0 kN; Seite 13 von 35

18) Lagerkräfte und Schnittgrößenverläufe Antriebswelle
Da | wird das Lager A, mit den geringeren Radialkräften, als Festlager

Schnittgrößenverläufe:

XY-Ebene:

Das Moment bezieht sich in allen folgenden Rechnungen auf den Punkt (S). Dabei ist der Schnittpunkt gemeint, also der Punkt, an dem die Normal- und Querkraft angreifen.

MsA


s1min≔0 mm | s1max≔X1=33 mm
s2min≔0 mm | s2max≔X2=26.5 | mm

positives Schnittufer:

FN≔-FAx1=0.547 | kN
FQ≔-FAy1=-0.67 | kN
Ms1xy≔FAy1 ⋅ s1 | Ms1xymin≔FAy1 ⋅ s1min=0 N ⋅m

Ms1xymax≔FAy1 ⋅ s1max=22.098 N ⋅m

negatives Schnittufer:

FN≔FBx1=0 kN

FQ≔-FBy1=-0.834 kN

Ms2xy≔FBy1 ⋅ s2 | Ms2xymin≔FBy1 ⋅ s2min=0 N ⋅m

Ms2xymax≔FBy1 ⋅ s2max=22.098 N ⋅m

Seite 14 von 35

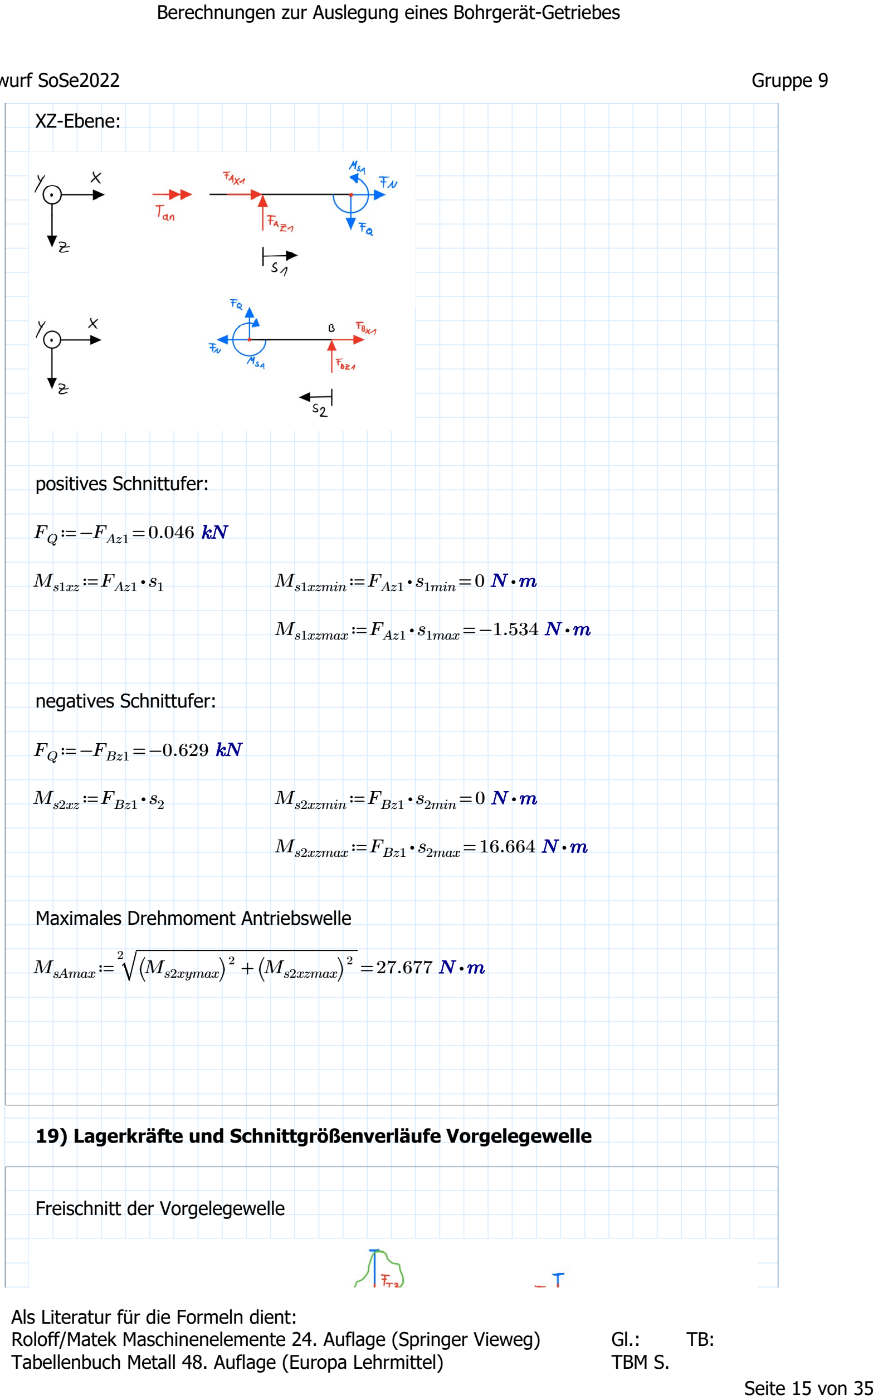
[picture p93: figure]
XZ-Ebene:; positives Schnittufer:; FQ≔-FAz1=0.046; Ms1xz≔FAz1 ⋅ s1; Ms1xzmin≔FAz1 ⋅ s1min=0 N ⋅m; Ms1xzmax≔FAz1 ⋅ s1max=-1.534 N ⋅m; negatives Schnittufer:; FQ≔-FBz1=-0.629 kN; Ms2xz≔FBz1 ⋅ s2; Ms2xzmin≔FBz1 ⋅ s2min=0 N ⋅m; Ms2xzmax≔FBz1 ⋅ s2max=16.664 N ⋅m; Maximales Drehmoment Antriebswelle; MsAmax≔; ⎛⎝Ms2xymax⎞ ⎠ +; 2 ⎛⎝Ms2xzmax⎞ ⎠; Freischnitt der Vorgelegewelle; Seite 15 von 35

19) Lagerkräfte und Schnittgrößenverläufe Vorgelegewelle

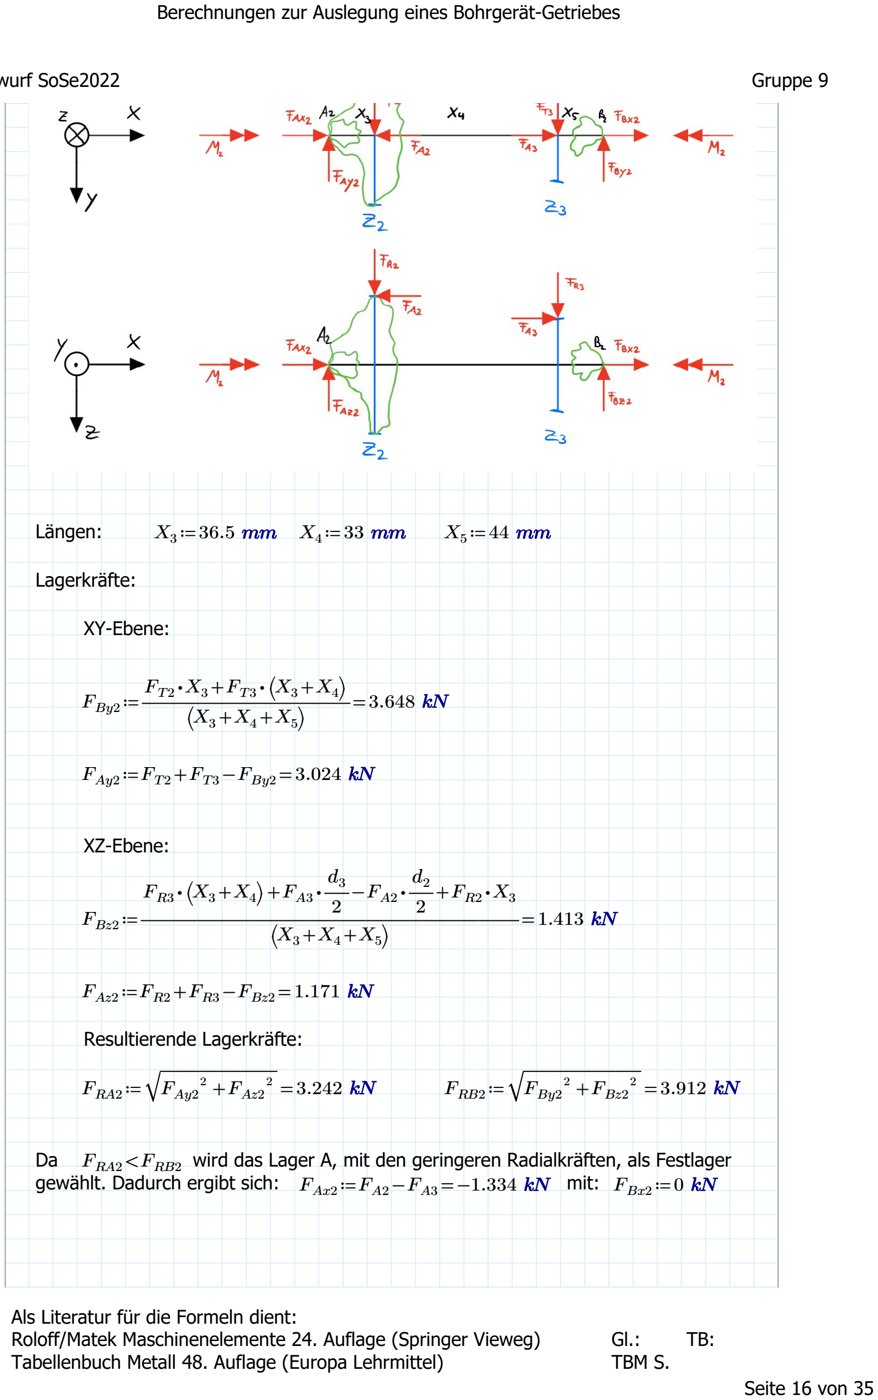
[picture p94: figure]
Längen:; Lagerkräfte:; XY-Ebene:; FBy2≔――――――――=; FAy2≔FT2+FT3-FBy2=3.024; XZ-Ebene:; FBz2≔――――――――――――――=; FAz2≔FR2+FR3-FBz2=1.171; Resultierende Lagerkräfte:; FRA2≔; 2 FAz2; FRB2≔; 2 FBz2; gewählt. Dadurch ergibt sich:; mit:; FRA2<FRB2; FAx2≔FA2-FA3=-1.334 kN; FBx2≔0 kN; Seite 16 von 35

Da | wird das Lager A, mit den geringeren Radialkräften, als Festlager

Schnittgrößenverläufe:

XY-Ebene:

s3min≔0 mm | s3max≔X3=36.5 | mm
s4min≔0 mm | s4max≔X4=33 mm
s5min≔0 mm | s5max≔X5=44 mm


erstes positives Schnittufer:

FN≔-FAx2=1.334 kN

FQ≔-FAy2=-3.024 kN

Ms3xy≔FAy2 ⋅ s3 | Ms3xymin≔FAy2 ⋅ s3min=0 N ⋅m

Ms3xymax≔FAy2 ⋅ s3max=110.36 N ⋅m

zweites positives Schnittufer:

FN≔FA2-FAx2=1.881 kN

FQ≔FAy2-FT2=1.52 kN

Ms4xy≔FAy2 ⋅ ⎛⎝s3+s4

⎞
⎠-FT2 ⋅ s4

Seite 17 von 35

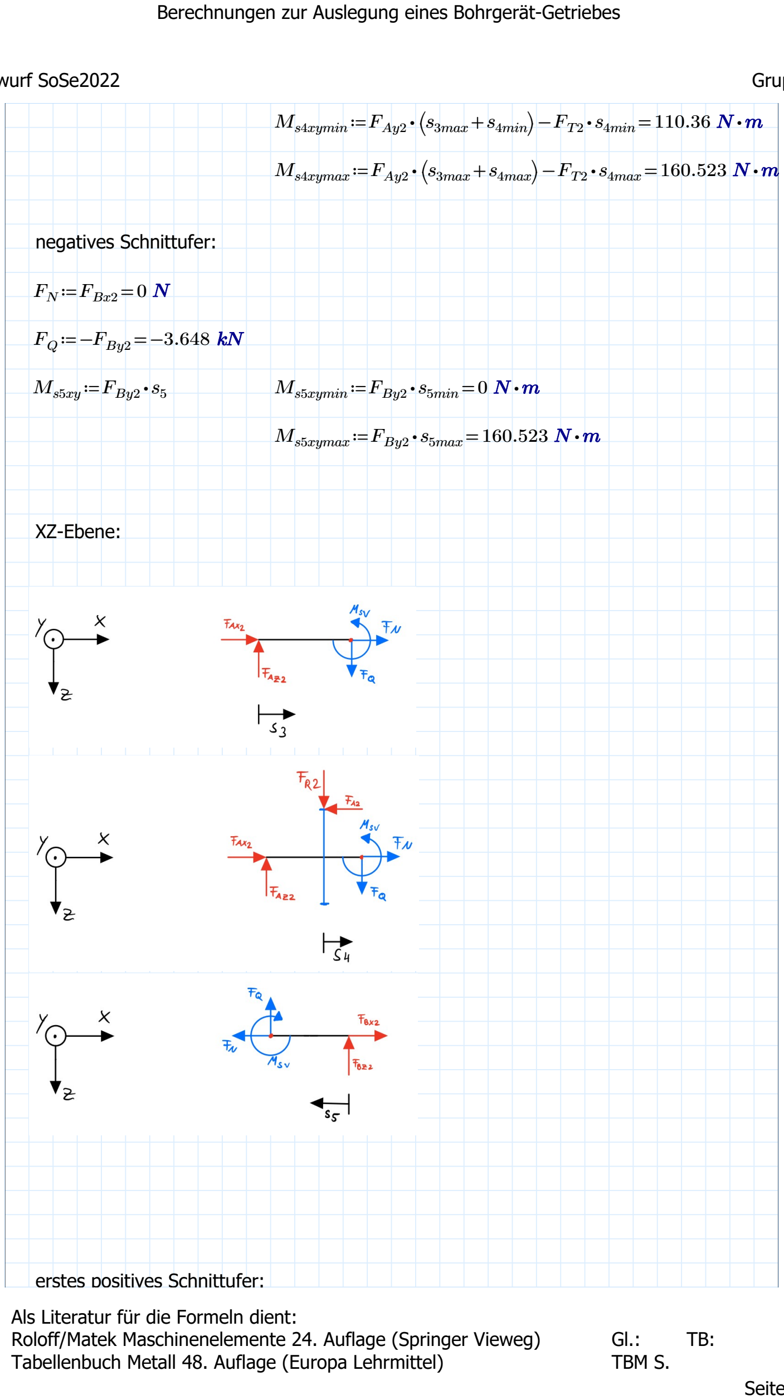
[picture p95: figure]
Ms4xymin≔FAy2 ⋅ ⎛⎝s3max+s4min⎞ ⎠-FT2 ⋅ s4min=110.36 N ⋅m; Ms4xymax≔FAy2 ⋅ ⎛⎝s3max+s4max⎞ ⎠-FT2 ⋅ s4max=160.523 N ⋅m; negatives Schnittufer:; FN≔FBx2=0 N; FQ≔-FBy2=-3.648 kN; Ms5xymax≔FBy2 ⋅ s5max=160.523 N ⋅m; XZ-Ebene:; erstes positives Schnittufer:

Ms5xy≔FBy2 ⋅ s5 | Ms5xymin≔FBy2 ⋅ s5min=0 N ⋅m

Seite 18 von 35

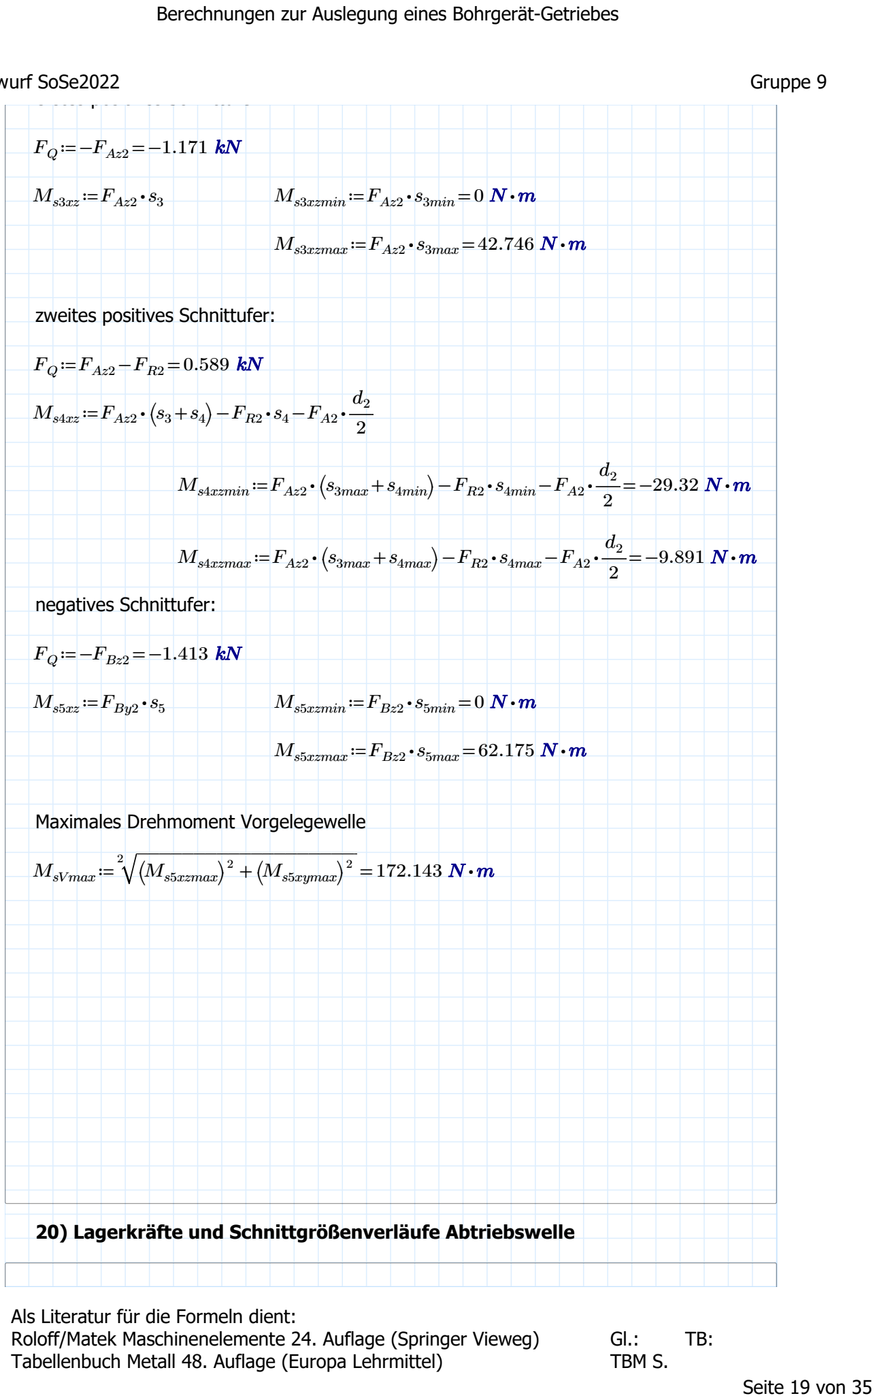
[picture p96: figure]
FQ≔-FAz2=-1.171 kN; Ms3xz≔FAz2 ⋅ s3; Ms3xzmin≔FAz2 ⋅ s3min=0 N ⋅m; Ms3xzmax≔FAz2 ⋅ s3max=42.746 N ⋅m; zweites positives Schnittufer:; FQ≔FAz2-FR2=0.589 kN; Ms4xz≔FAz2 ⋅ ⎛⎝s3+s4; Ms4xzmin≔FAz2 ⋅ ⎛⎝s3max+s4min⎞ ⎠-FR2 ⋅ s4min-FA2 ⋅―=; Ms4xzmax≔FAz2 ⋅ ⎛⎝s3max+s4max⎞ ⎠-FR2 ⋅ s4max-FA2 ⋅―=; negatives Schnittufer:; FQ≔-FBz2=-1.413 kN; Ms5xz≔FBy2 ⋅ s5; Ms5xzmin≔FBz2 ⋅ s5min=0 N ⋅m; Ms5xzmax≔FBz2 ⋅ s5max=62.175 N ⋅m; Maximales Drehmoment Vorgelegewelle; MsVmax≔; ⎛⎝Ms5xzmax⎞ ⎠ +; 2 ⎛⎝Ms5xymax⎞ ⎠; Seite 19 von 35

20) Lagerkräfte und Schnittgrößenverläufe Abtriebswelle

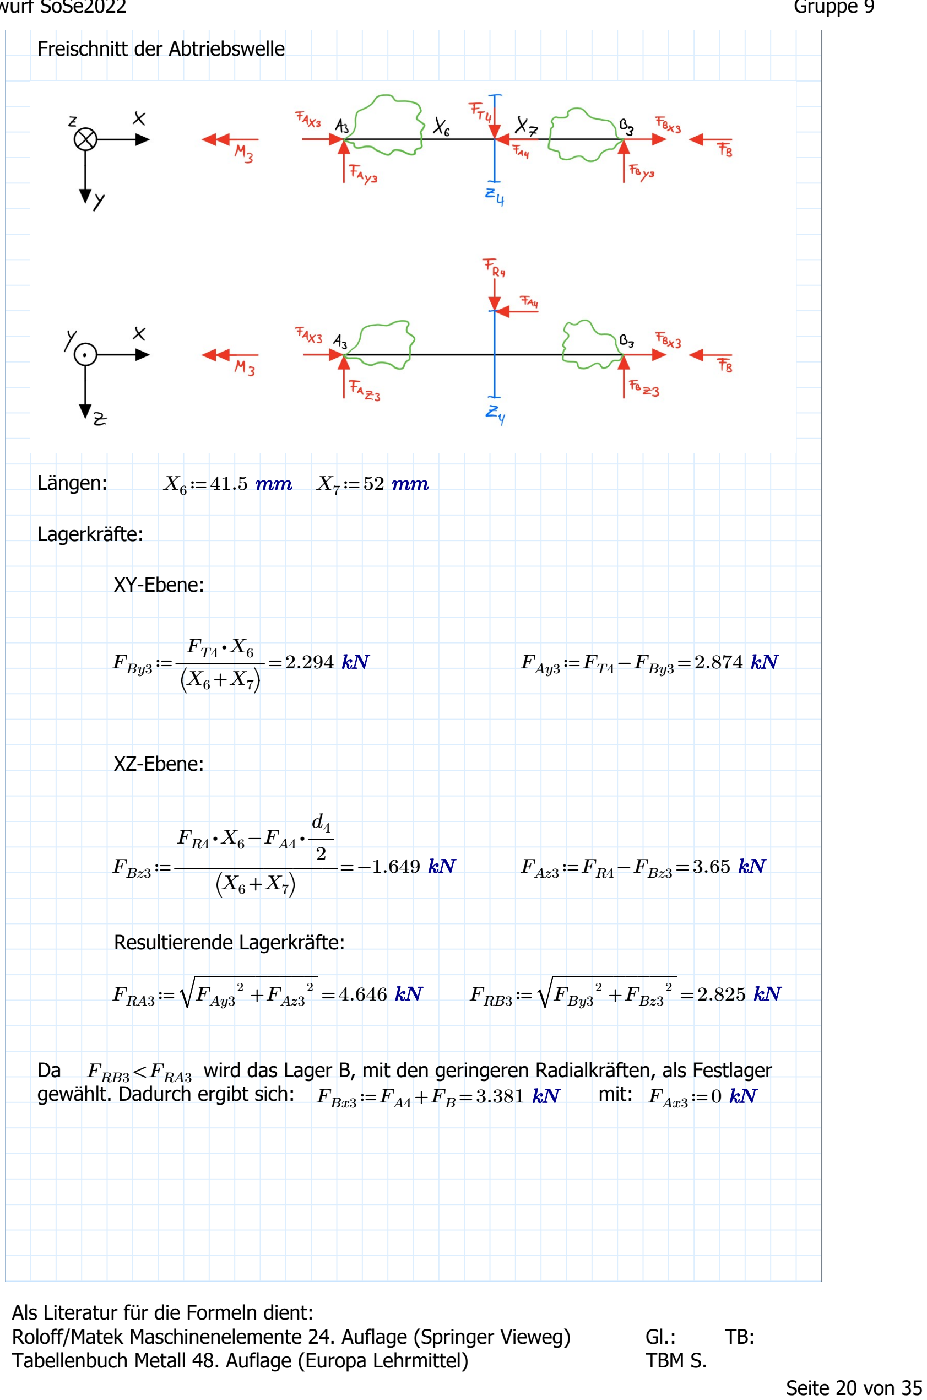
[picture p97: figure]
Freischnitt der Abtriebswelle; Längen:; Lagerkräfte:; XY-Ebene:; FBy3≔――――=; FAy3≔FT4-FBy3=2.874; XZ-Ebene:; FBz3≔――――――=; FAz3≔FR4-FBz3=3.65 kN; Resultierende Lagerkräfte:; FRA3≔; 2 FAz3; FRB3≔; 2 FBz3; gewählt. Dadurch ergibt sich:; mit:; FRB3<FRA3; FBx3≔FA4+FB =3.381 kN; FAx3≔0; Seite 20 von 35

Da | wird das Lager B, mit den geringeren Radialkräften, als Festlager

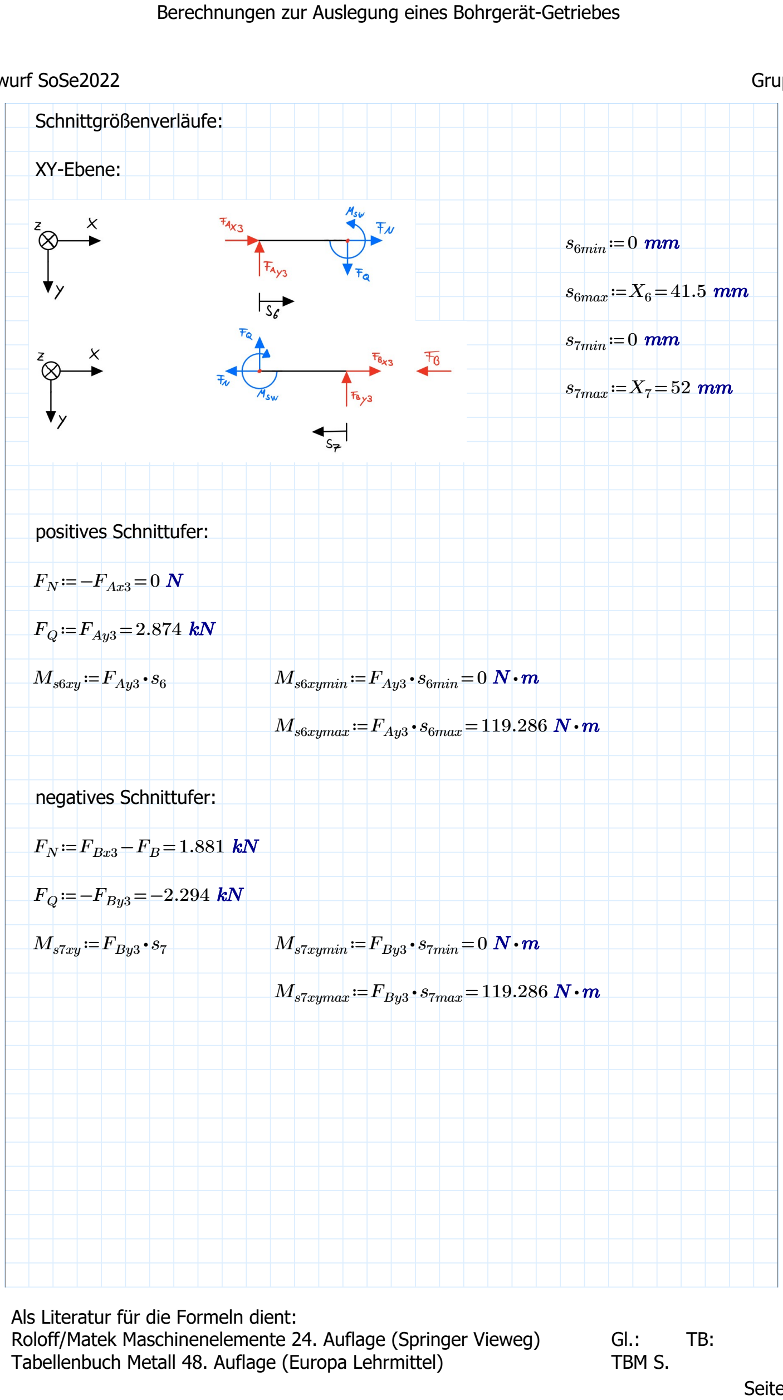
[picture p98: figure]
Schnittgrößenverläufe:; XY-Ebene:; s6min≔0 mm; s6max≔X6=41.5; s7min≔0 mm; s7max≔X7=52 mm; positives Schnittufer:; FN≔-FAx3=0 N; FQ≔FAy3=2.874 kN; Ms6xymax≔FAy3 ⋅ s6max=119.286 N ⋅m; negatives Schnittufer:; FN≔FBx3-FB =1.881 kN; FQ≔-FBy3=-2.294 kN; Ms7xymax≔FBy3 ⋅ s7max=119.286 N ⋅m

Ms6xy≔FAy3 ⋅ s6 | Ms6xymin≔FAy3 ⋅ s6min=0 N ⋅m
Ms7xy≔FBy3 ⋅ s7 | Ms7xymin≔FBy3 ⋅ s7min=0 N ⋅m

Seite 21 von 35

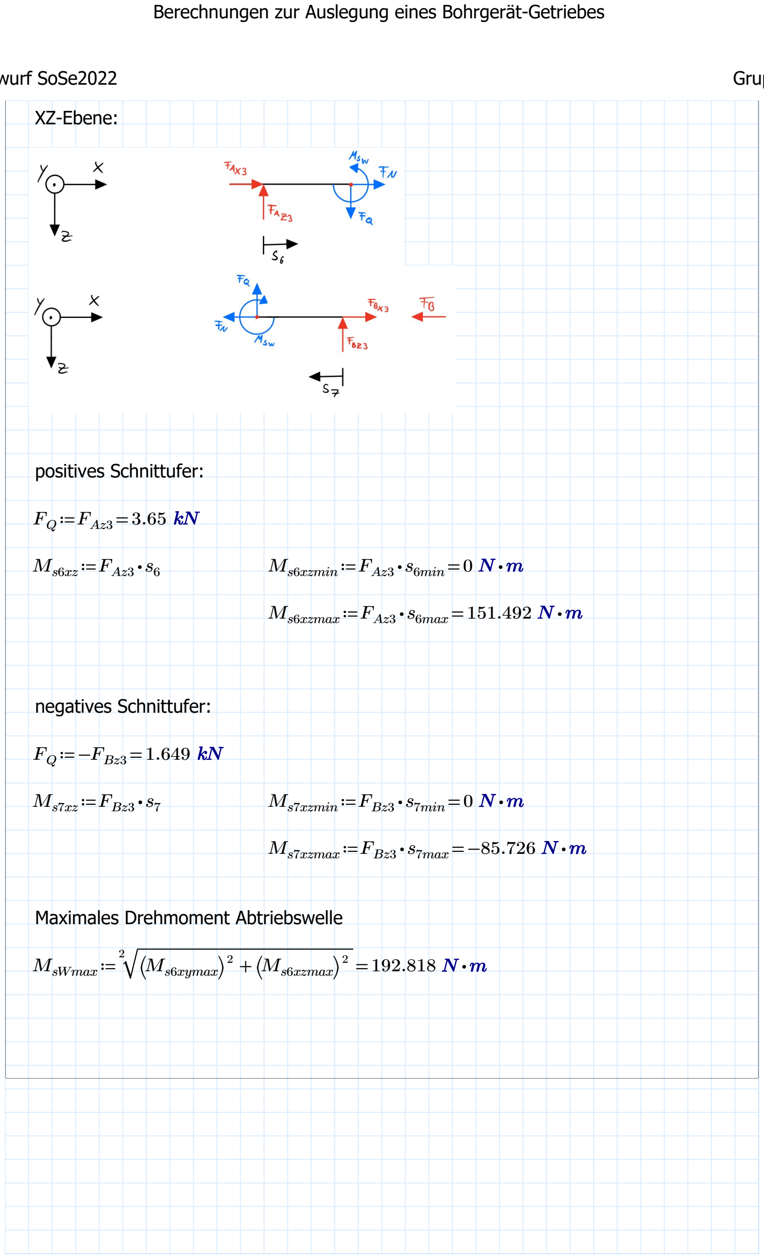
[picture p99: figure]
XZ-Ebene:; positives Schnittufer:; FQ≔FAz3=3.65; Ms6xz≔FAz3 ⋅ s6; Ms6xzmin≔FAz3 ⋅ s6min=0 N ⋅m; Ms6xzmax≔FAz3 ⋅ s6max=151.492 N ⋅m; negatives Schnittufer:; FQ≔-FBz3=1.649; Ms7xz≔FBz3 ⋅ s7; Ms7xzmin≔FBz3 ⋅ s7min=0 N ⋅m; Ms7xzmax≔FBz3 ⋅ s7max=-85.726 N ⋅m; Maximales Drehmoment Abtriebswelle; MsWmax≔; ⎛⎝Ms6xymax⎞; 2 ⎛⎝Ms6xzmax⎞ ⎠

Seite 22 von 35

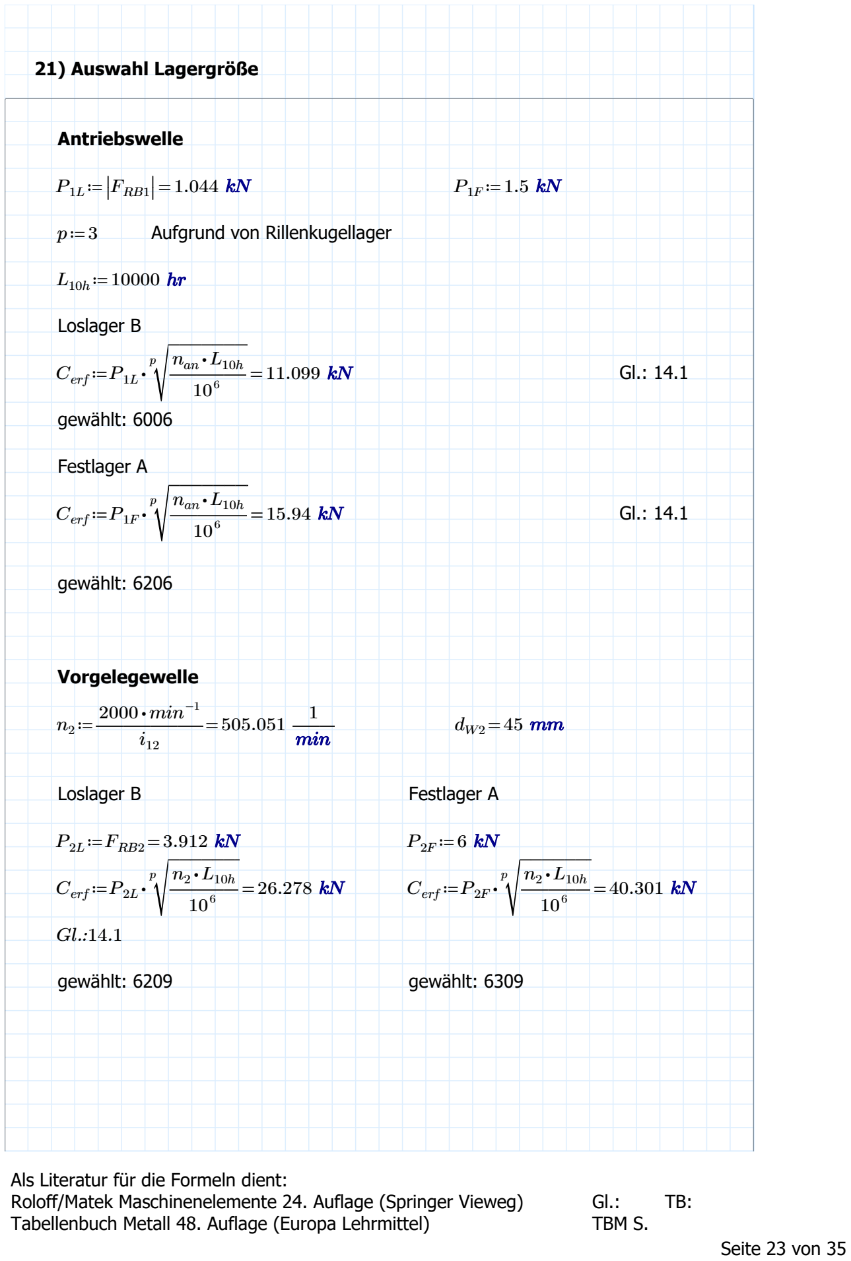
[picture p100: figure]
21) Auswahl Lagergröße; Antriebswelle; |FRB1|; Aufgrund von Rillenkugellager; Loslager B; Cerf≔P1L ⋅; gewählt: 6006; Festlager A; Cerf≔P1F ⋅; gewählt: 6206; Vorgelegewelle; 2000 ⋅min⁻¹; 505.051 ―1―min; P2L≔FRB2=3.912; Cerf≔P2L ⋅; Cerf≔P2F ⋅; gewählt: 6209; gewählt: 6309; Seite 23 von 35

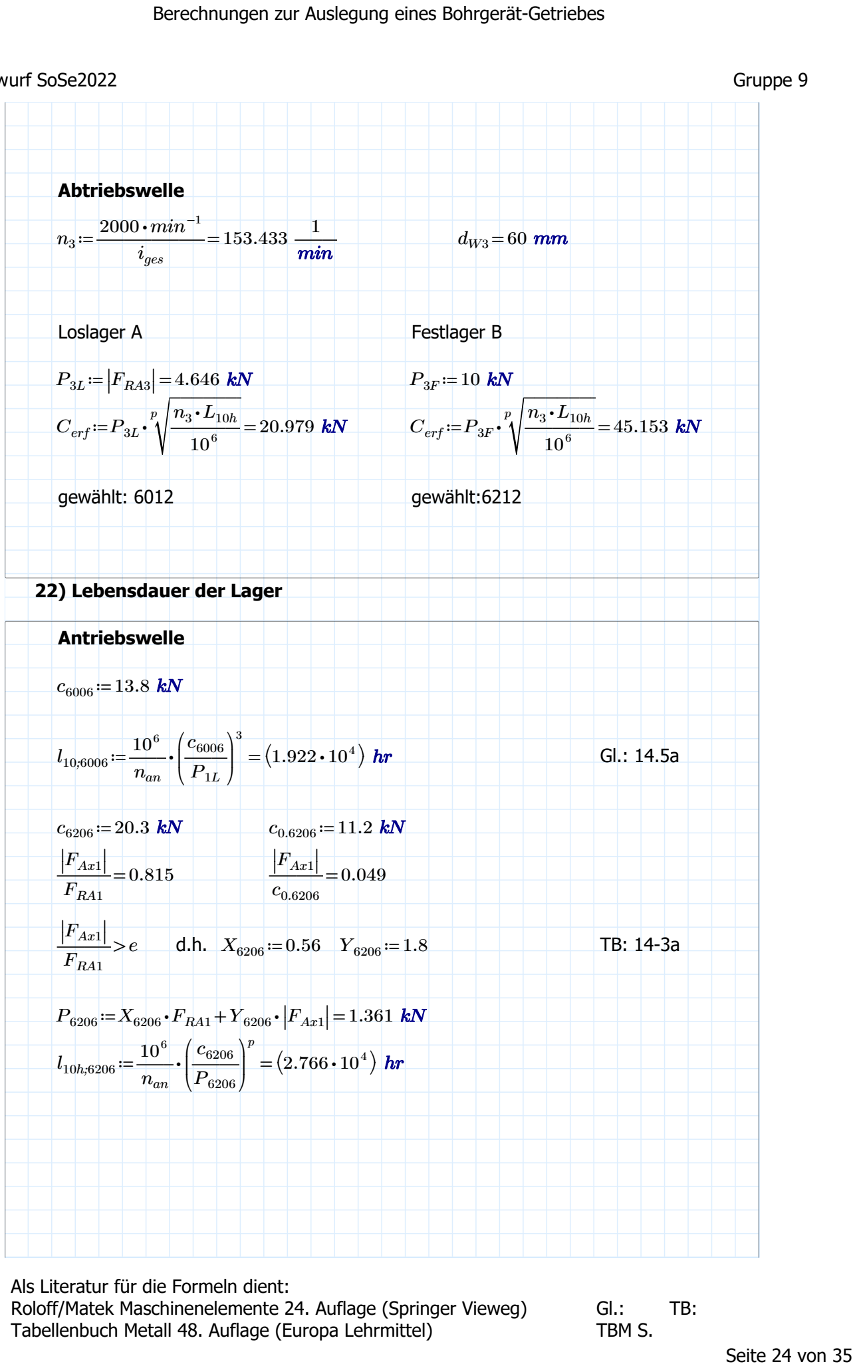
[picture p101: figure]
Abtriebswelle; 2000 ⋅min⁻¹; iges; 153.433 ―1―min; Loslager A; Festlager B; |FRA3|; Cerf≔P3L ⋅; Cerf≔P3F ⋅; gewählt: 6012; gewählt:6212; 22) Lebensdauer der Lager; Antriebswelle; nan; |FAx1| |; FRA1; P6206≔X6206 ⋅FRA1+Y6206 ⋅|; |FAx1| |=1.361 kN; Seite 24 von 35

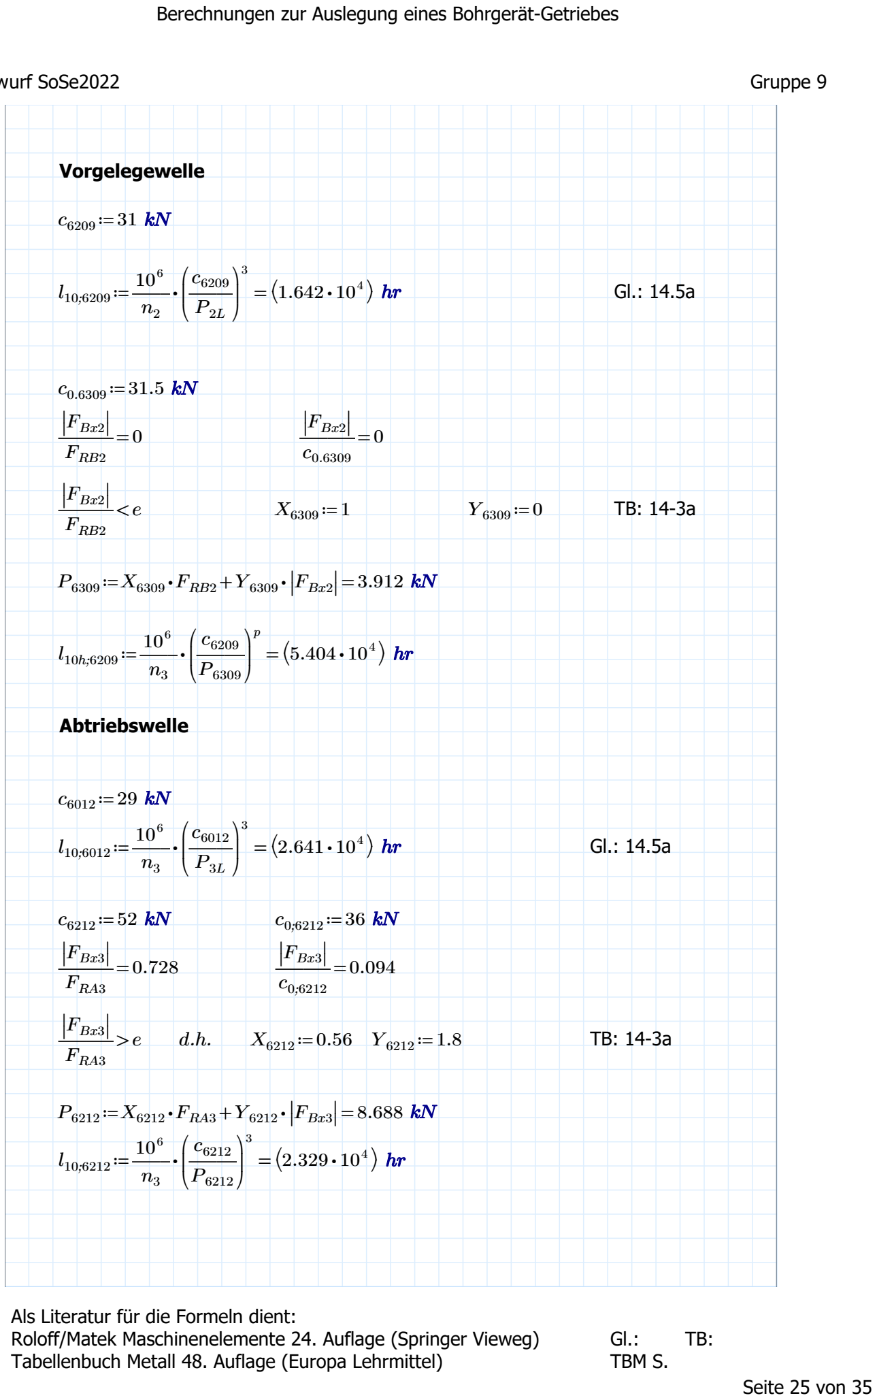
[picture p102: figure]
Vorgelegewelle; |FBx2| |; FRB2; P6309≔X6309 ⋅FRB2+Y6309 ⋅|; |FBx2| |=3.912 kN; Abtriebswelle; |FBx3| |; FRA3; P6212≔X6212 ⋅FRA3+Y6212 ⋅|; |FBx3| |=8.688 kN; Seite 25 von 35

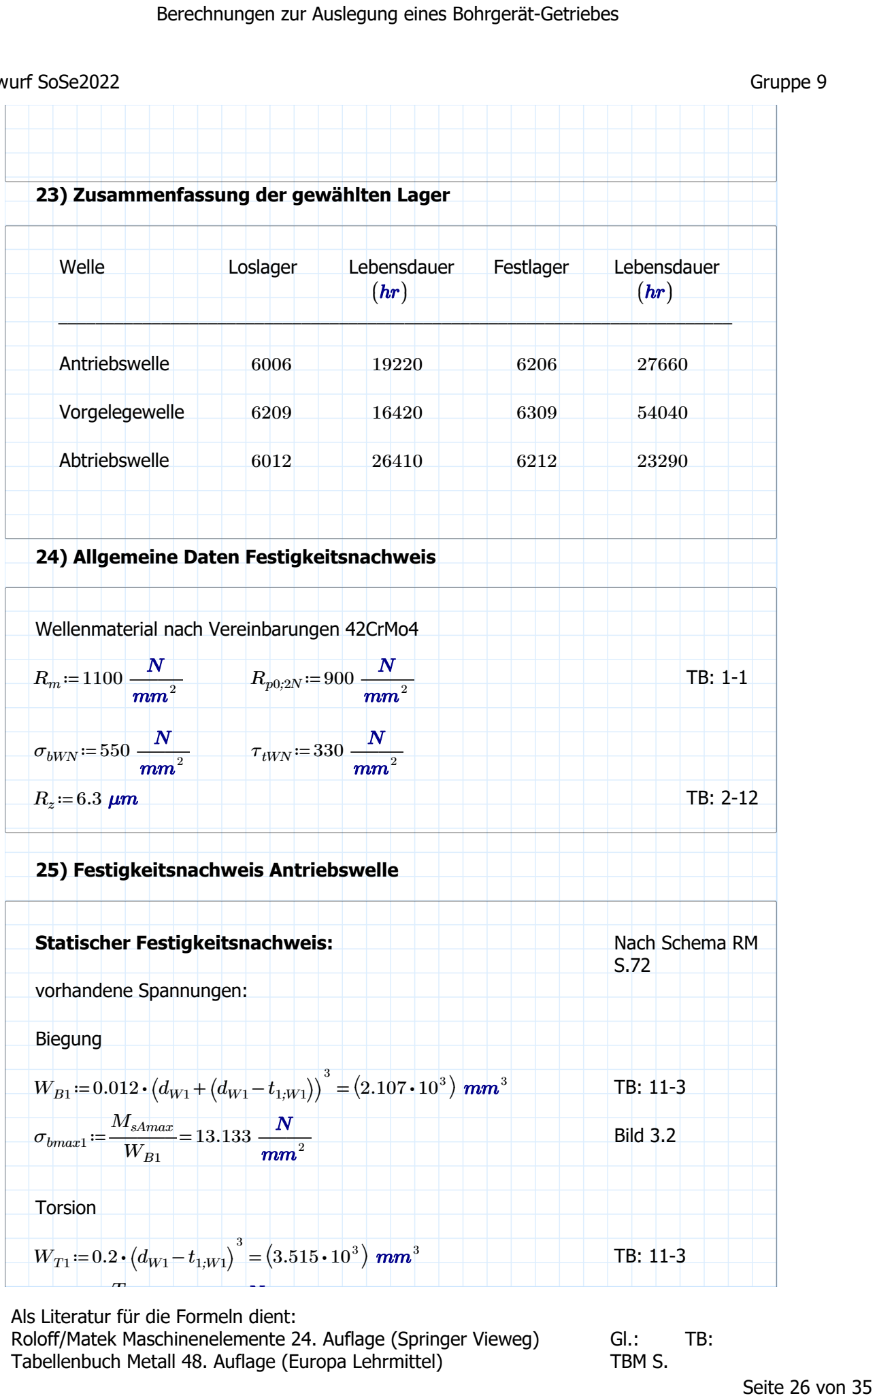
[picture p103: figure]
23) Zusammenfassung der gewählten Lager; Welle; Loslager; Lebensdauer; Festlager; Antriebswelle; Vorgelegewelle; Abtriebswelle; Wellenmaterial nach Vereinbarungen 42CrMo4; ―N―mm²; Rp0;2N≔900 ―N―mm²; σbWN≔550 ―N―mm²; τtWN≔330 ―N―mm²; 25) Festigkeitsnachweis Antriebswelle; Statischer Festigkeitsnachweis:; Nach Schema RM; vorhandene Spannungen:; Biegung; mm³; σbmax1≔―――=; MsAmax; 13.133 ―N―mm²; Bild 3.2; Torsion; ⎠ mm³; Seite 26 von 35

24) Allgemeine Daten Festigkeitsnachweis

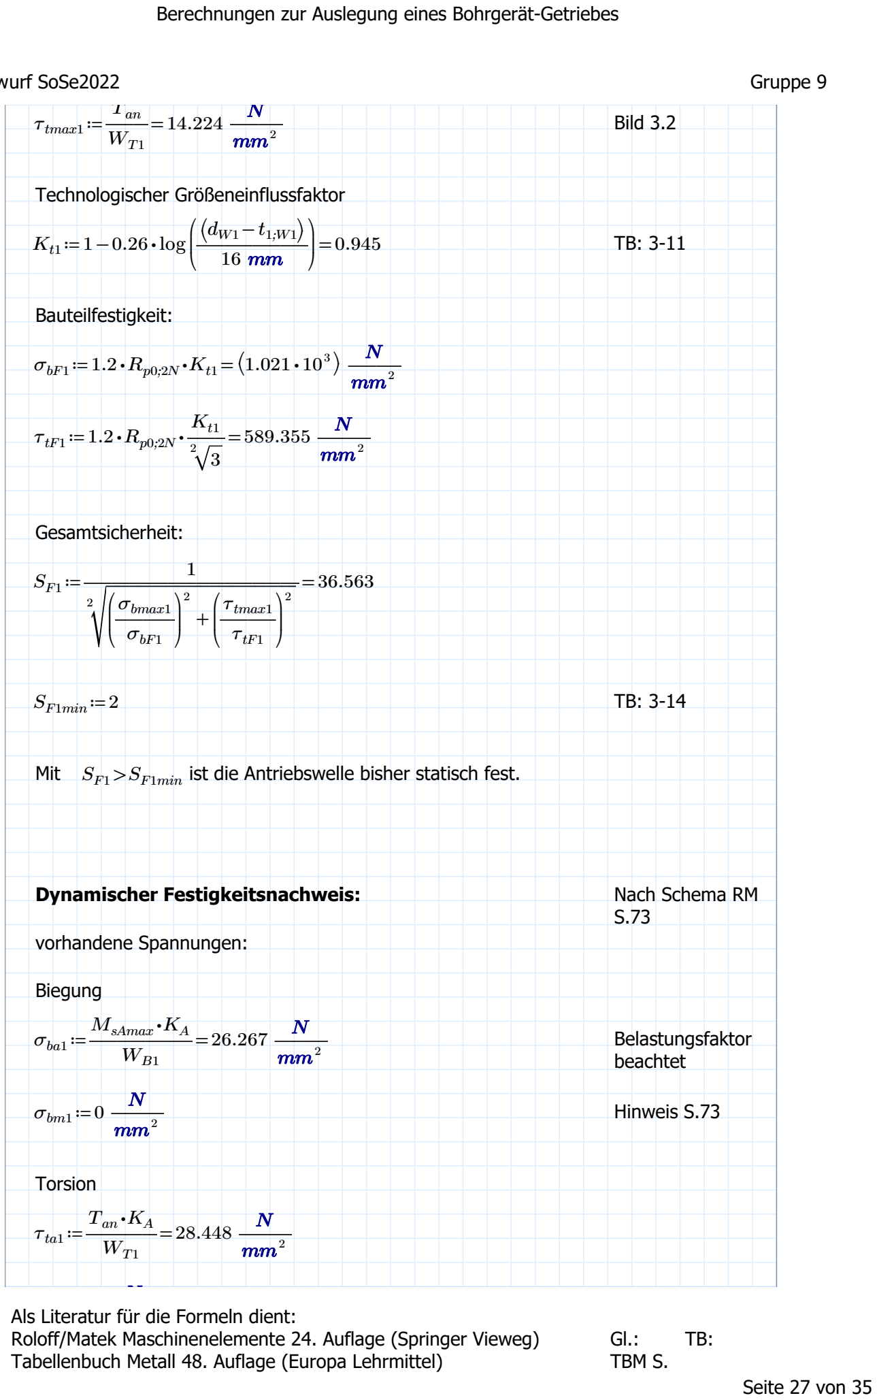
[picture p104: figure]
τtmax1≔――=; Tan; 14.224 ―N―mm²; Bild 3.2; Technologischer Größeneinflussfaktor; Kt1≔1-0.26 ⋅log; Bauteilfestigkeit:; σbF1≔1.2 ⋅Rp0;2N ⋅Kt1=⎛⎝1.021 ⋅ 10³ ⎞; ―N―mm²; τtF1≔1.2 ⋅Rp0;2N ⋅――=; 589.355 ―N―mm²; Gesamtsicherheit:; σbmax1; σbF1; τtmax1; τtF1; SF1min≔2; Dynamischer Festigkeitsnachweis:; Nach Schema RM; vorhandene Spannungen:; Biegung; σba1≔――――=; M ⋅ sAmax KA; 26.267 ―N―mm²; Belastungsfaktor beachtet; σbm1≔0 ―N―mm²; Hinweis S.73; Torsion; τta1≔―――=; 28.448 ―N―mm²; Seite 27 von 35

Mit | ist die Antriebswelle bisher statisch fest. SF1>SF1min

τtm1≔0; ―N―mm²; Konstruktionsfaktoren:; Kerbwirkungszahl; βkb1≔2.4; βkt1≔2.2; Geometrischer Größeneinflussfaktor; log; log((20)); Oberflächenrauheit; KOσ1≔1-0.22 ⋅log; Rm 20 ―N―mm²; KOτ1≔0.575 ⋅KOσ1+0.425=0.925; Oberflächenverfestigung; KDb1≔; βkb1; ―1―KOσ1; KDt1≔; βkt1; ―1―KOτ1; Wechselfestigkeit für die Antriebswelle; σbGW1≔Kt1 ⋅――=; σbWN; KDb1; 225.457 ―N―mm²; τtGW1≔Kt1 ⋅――=; τtWN; KDt1; 150.921 ―N―mm²; σbm1=0; τtm1=0

Durch das wählen von | und | werden die weiteren

Seite 28 von 35

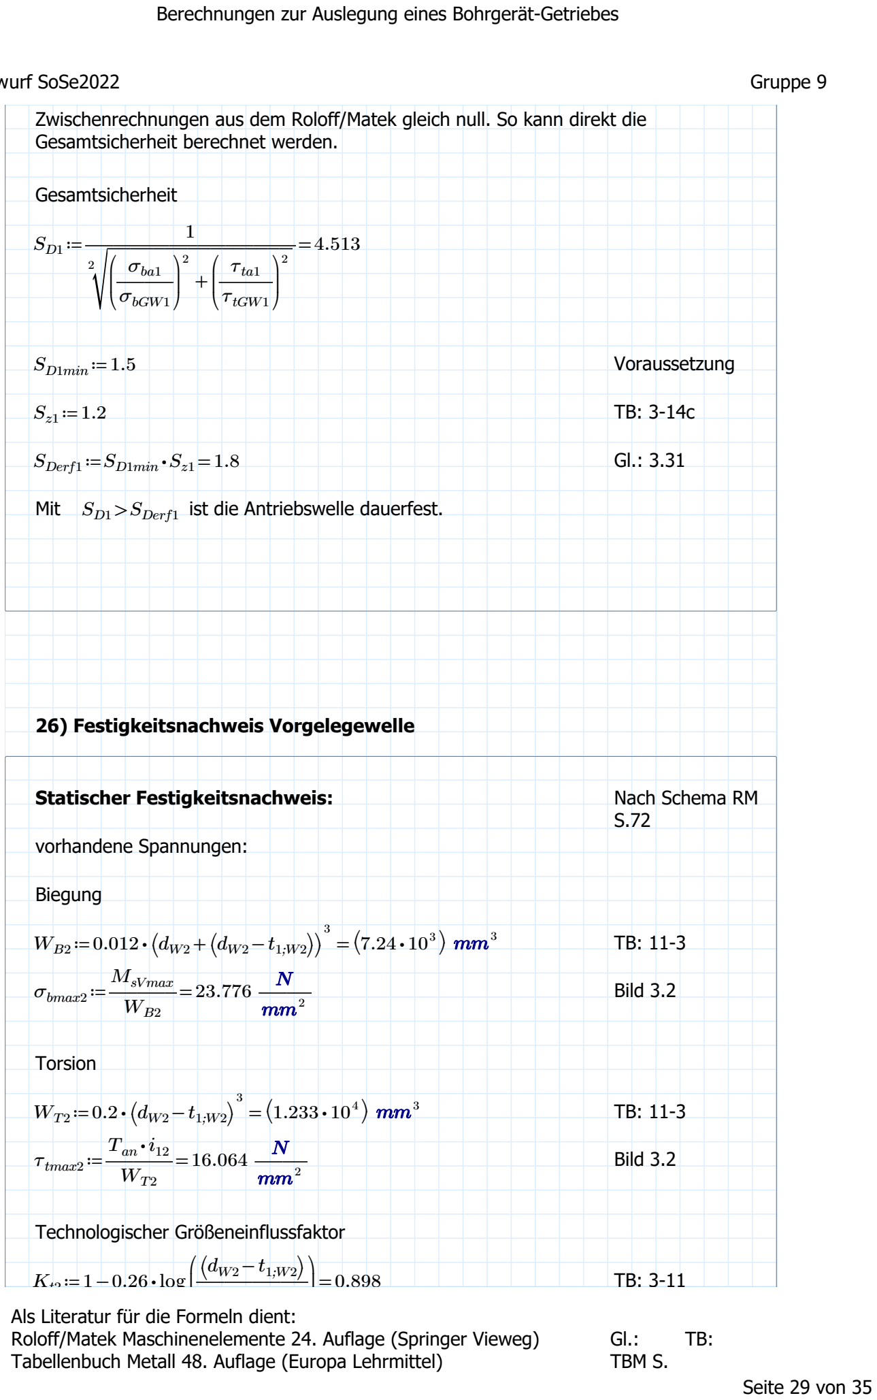
[picture p105: figure]
Gesamtsicherheit berechnet werden.; Gesamtsicherheit; σba1; σbGW1; τta1; τtGW1; SD1min≔1.5; Voraussetzung; SDerf1≔SD1min ⋅Sz1=1.8; Mit; ist die Antriebswelle dauerfest. SD1>SDerf1; 26) Festigkeitsnachweis Vorgelegewelle; Statischer Festigkeitsnachweis:; Nach Schema RM; vorhandene Spannungen:; Biegung; ⎠ mm³; σbmax2≔―――=; MsVmax; 23.776 ―N―mm²; Bild 3.2; Torsion; τtmax2≔―――=; 16.064 ―N―mm²; Technologischer Größeneinflussfaktor; Kt2≔1-0.26 ⋅log; Seite 29 von 35

Zwischenrechnungen aus dem Roloff/Matek gleich null. So kann direkt die

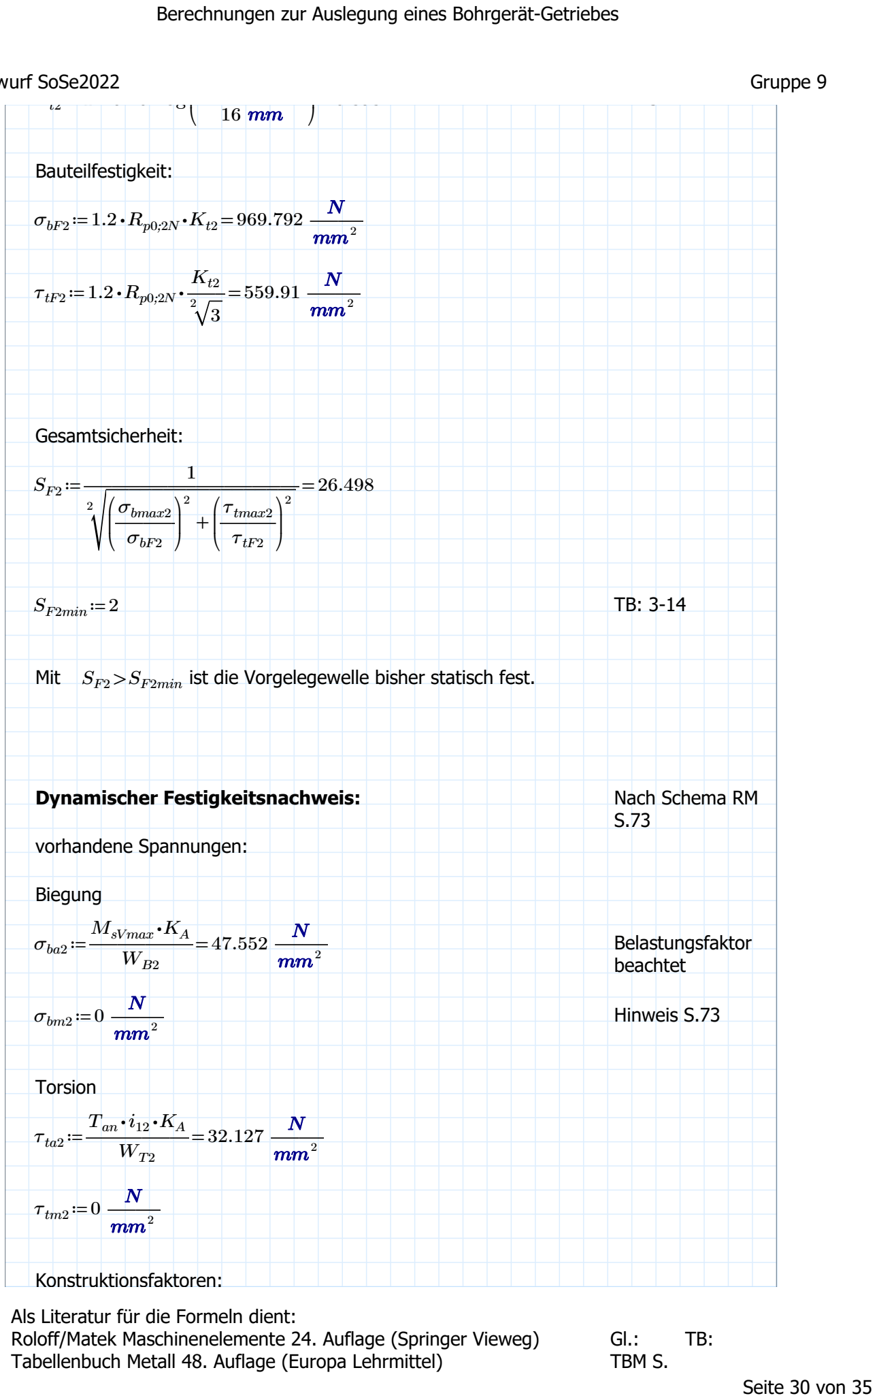
[picture p106: figure]
Bauteilfestigkeit:; σbF2≔1.2 ⋅Rp0;2N ⋅Kt2=969.792 ―N―mm²; τtF2≔1.2 ⋅Rp0;2N ⋅――=; 559.91 ―N―mm²; Gesamtsicherheit:; σbmax2; σbF2; τtmax2; τtF2; SF2min≔2; Dynamischer Festigkeitsnachweis:; Nach Schema RM; vorhandene Spannungen:; Biegung; σba2≔――――=; M ⋅ sVmax KA; 47.552 ―N―mm²; Belastungsfaktor beachtet; σbm2≔0 ―N―mm²; Hinweis S.73; Torsion; τta2≔――――=; 32.127 ―N―mm²; τtm2≔0; ―N―mm²; Konstruktionsfaktoren:; Seite 30 von 35

Mit | ist die Vorgelegewelle bisher statisch fest. SF2>SF2min

Kerbwirkungszahl; βkb2≔2.4; βkt2≔2.2; Geometrischer Größeneinflussfaktor; log; log((20)); Oberflächenrauheit; KOσ2≔1-0.22 ⋅log; Rm 20 ―N―mm²; KOτ2≔0.575 ⋅KOσ2+0.425=0.925; Oberflächenverfestigung; KDb2≔; βkb2; ―1―KOσ2; KDt2≔; βkt2; ―1―KOτ2; σbGW2≔Kt2 ⋅――=; σbWN; KDb2; 208.014 ―N―mm²; τtGW2≔Kt2 ⋅――=; τtWN; KDt2; 139.154 ―N―mm²; Gesamtsicherheit berechnet werden.; σbm2=0; ―N―mm²; τtm2=0; Gesamtsicherheit

Wechselfestigkeit für die Vorgelegewelle

Durch das wählen von | und | werden die weiteren

Zwischenrechnungen aus dem Roloff/Matek gleich null. So kann direkt die

Seite 31 von 35

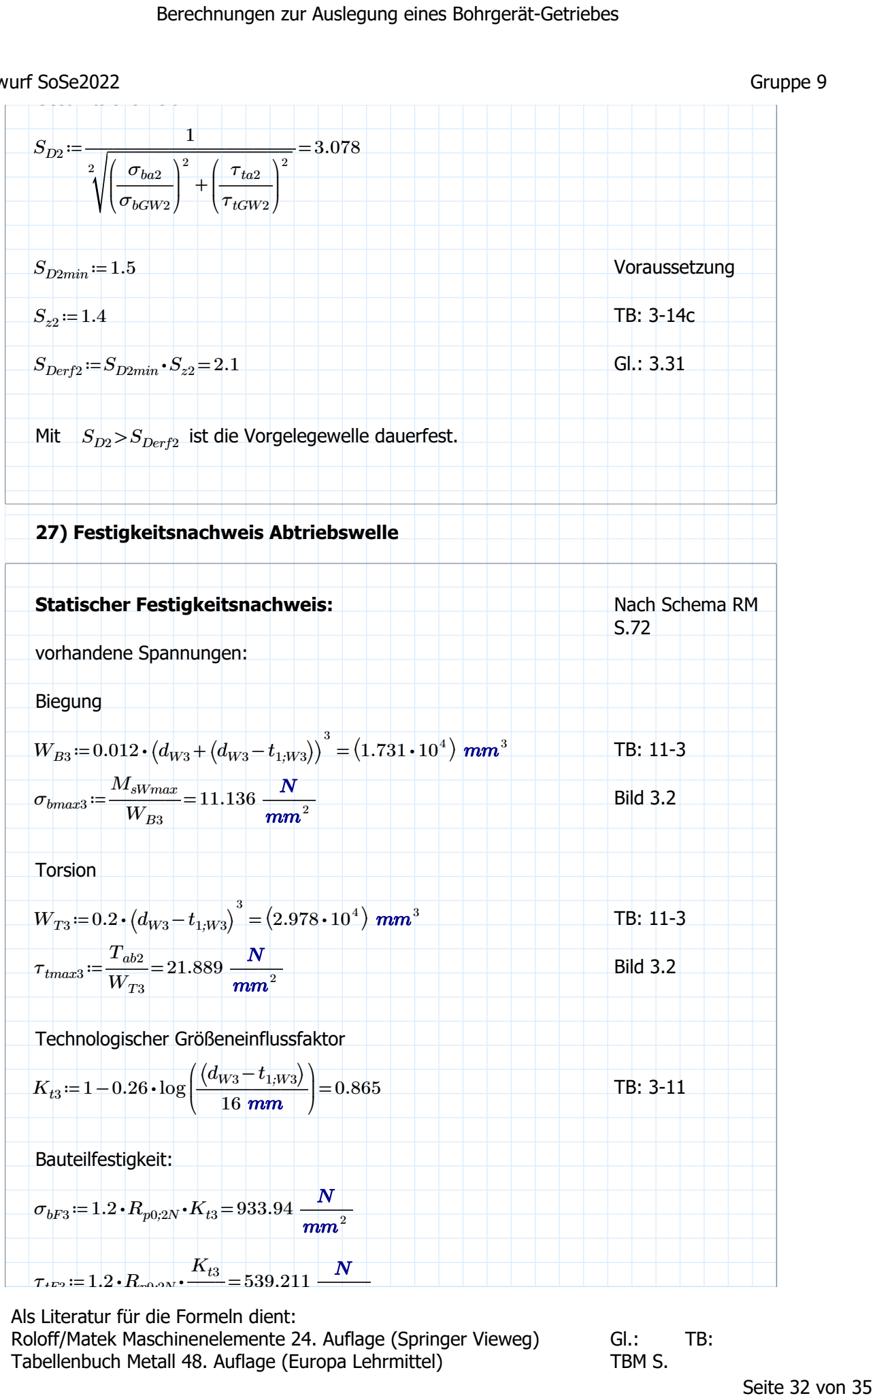
[picture p107: figure]
σba2; σbGW2; τta2; τtGW2; SD2min≔1.5; Voraussetzung; SDerf2≔SD2min ⋅Sz2=2.1; Mit; ist die Vorgelegewelle dauerfest. SD2>SDerf2; 27) Festigkeitsnachweis Abtriebswelle; Statischer Festigkeitsnachweis:; Nach Schema RM; vorhandene Spannungen:; Biegung; mm³; σbmax3≔―――=; MsWmax; 11.136 ―N―mm²; Bild 3.2; Torsion; ⎠ mm³; τtmax3≔――=; Tab2; 21.889 ―N―mm²; Technologischer Größeneinflussfaktor; Kt3≔1-0.26 ⋅log; Bauteilfestigkeit:; σbF3≔1.2 ⋅Rp0;2N ⋅Kt3=933.94; ―N―mm²; τtF3≔1.2 ⋅Rp0;2N ⋅――=; Seite 32 von 35

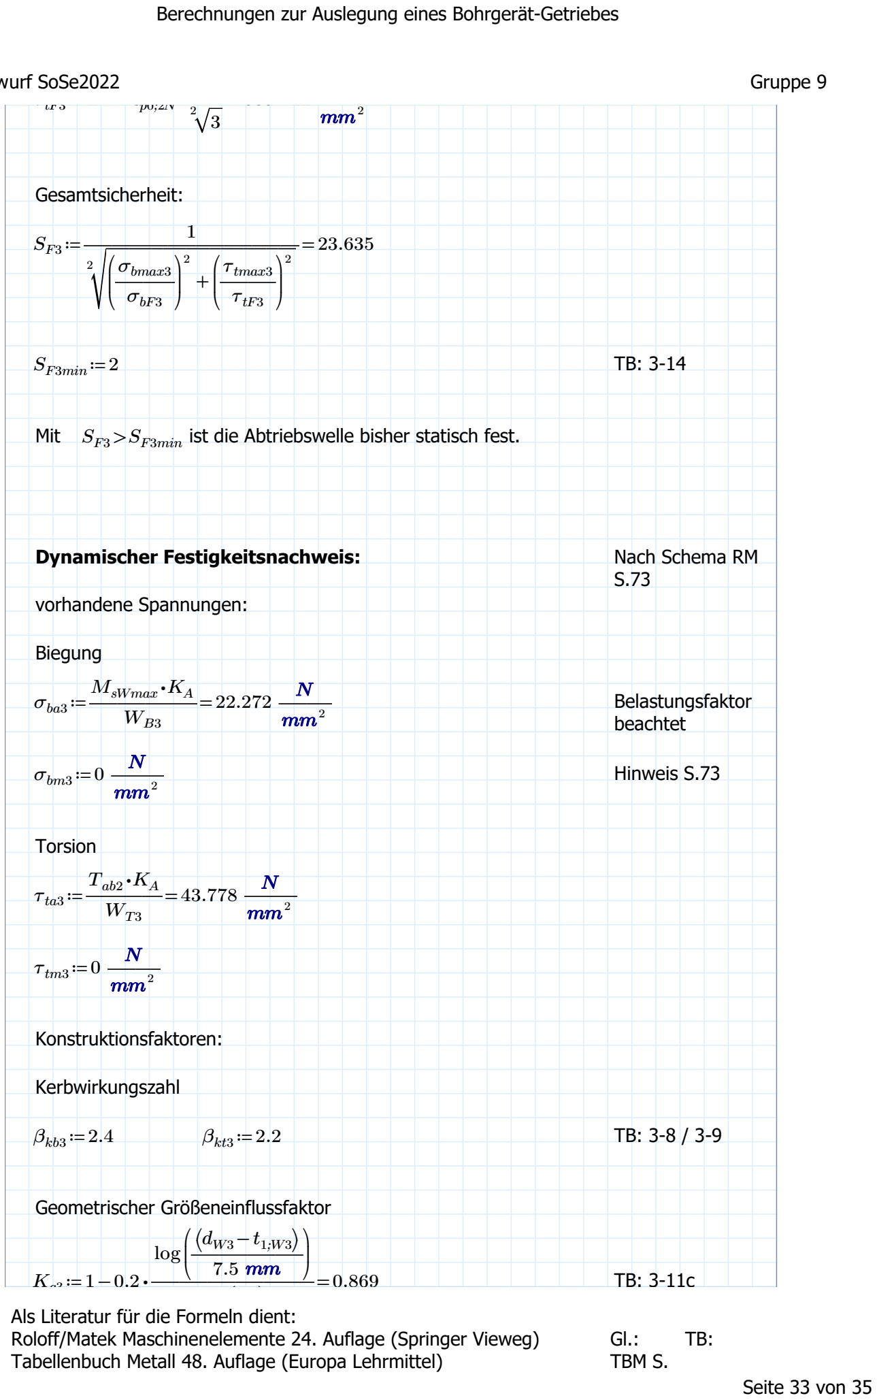
[picture p108: figure]
mm²; Gesamtsicherheit:; σbmax3; σbF3; τtmax3; τtF3; SF3min≔2; Dynamischer Festigkeitsnachweis:; Nach Schema RM; vorhandene Spannungen:; Biegung; σba3≔――――=; M ⋅ sWmax KA; 22.272 ―N―mm²; Belastungsfaktor beachtet; σbm3≔0 ―N―mm²; Hinweis S.73; Torsion; τta3≔―――=; 43.778 ―N―mm²; τtm3≔0; ―N―mm²; Konstruktionsfaktoren:; Kerbwirkungszahl; βkb3≔2.4; βkt3≔2.2; Geometrischer Größeneinflussfaktor; log; Seite 33 von 35

Mit | ist die Abtriebswelle bisher statisch fest. SF3>SF3min

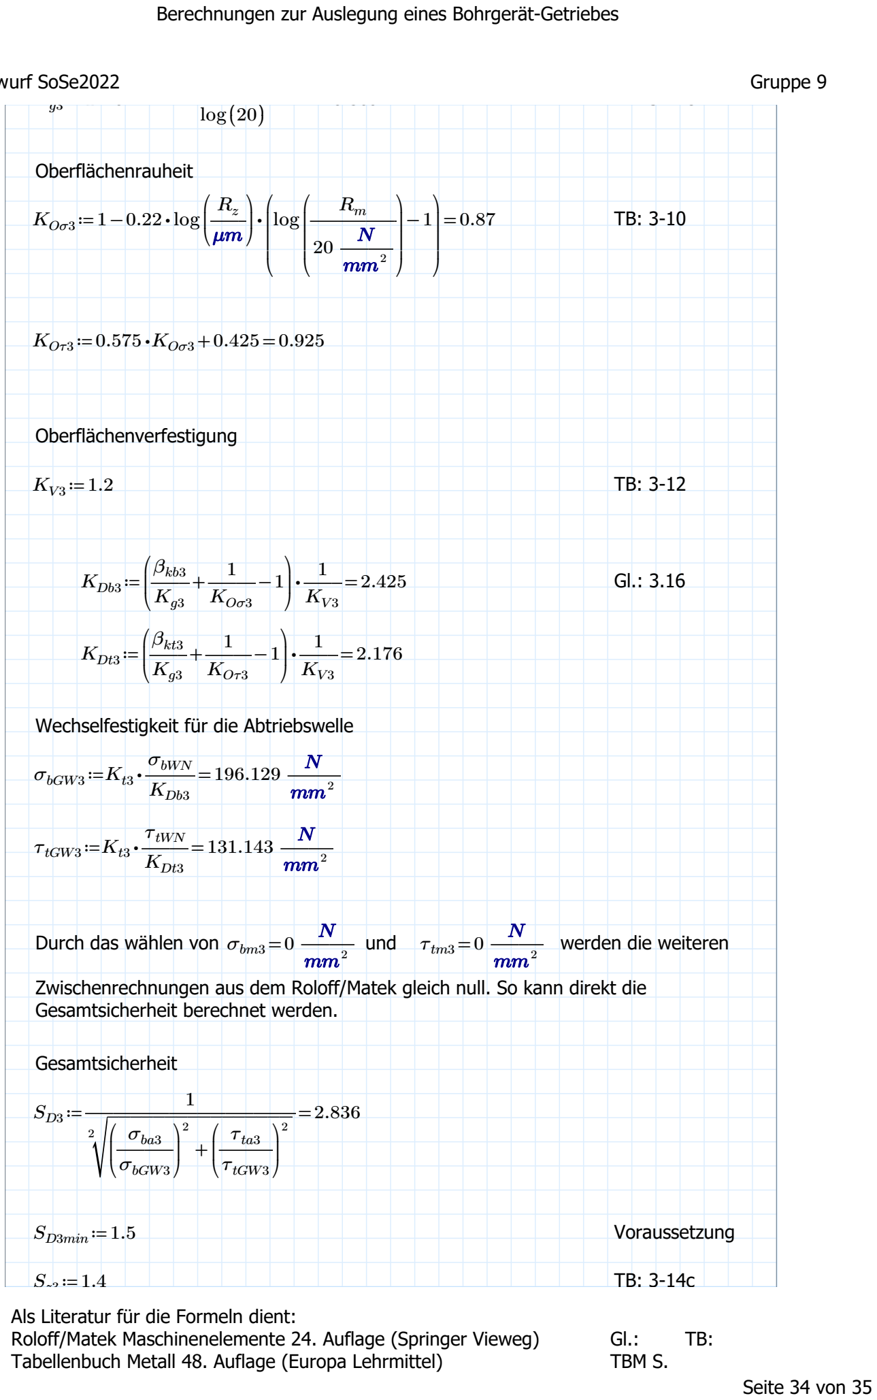
[picture p109: figure]
log((20)); Oberflächenrauheit; KOσ3≔1-0.22 ⋅log; log; Rm 20 ―N―mm²; KOτ3≔0.575 ⋅KOσ3+0.425=0.925; Oberflächenverfestigung; KDb3≔; βkb3; ―1―KOσ3; KDt3≔; βkt3; ―1―KOτ3; Wechselfestigkeit für die Abtriebswelle; σbGW3≔Kt3 ⋅――=; σbWN; KDb3; 196.129 ―N―mm²; τtGW3≔Kt3 ⋅――=; τtWN; KDt3; 131.143 ―N―mm²; Durch das wählen von; und; werden die weiteren; Gesamtsicherheit berechnet werden.; σbm3=0; ―N―mm²; τtm3=0; Gesamtsicherheit; σba3; σbGW3; τta3; τtGW3; SD3min≔1.5; Voraussetzung; Seite 34 von 35

Zwischenrechnungen aus dem Roloff/Matek gleich null. So kann direkt die

z3

SDerf3≔SD3min ⋅Sz3=2.1 | Gl.: 3.31
Mit | ist die Abtriebswelle dauerfest. SD3>SDerf3

Seite 35 von 35
