Marvin20212/Gruppe9_ME3E/Aufgabenstellung/ME3_Lindner_Entwurf_Beispiel_Fliehkraftkupplung_Lösung_SS2021.pdf

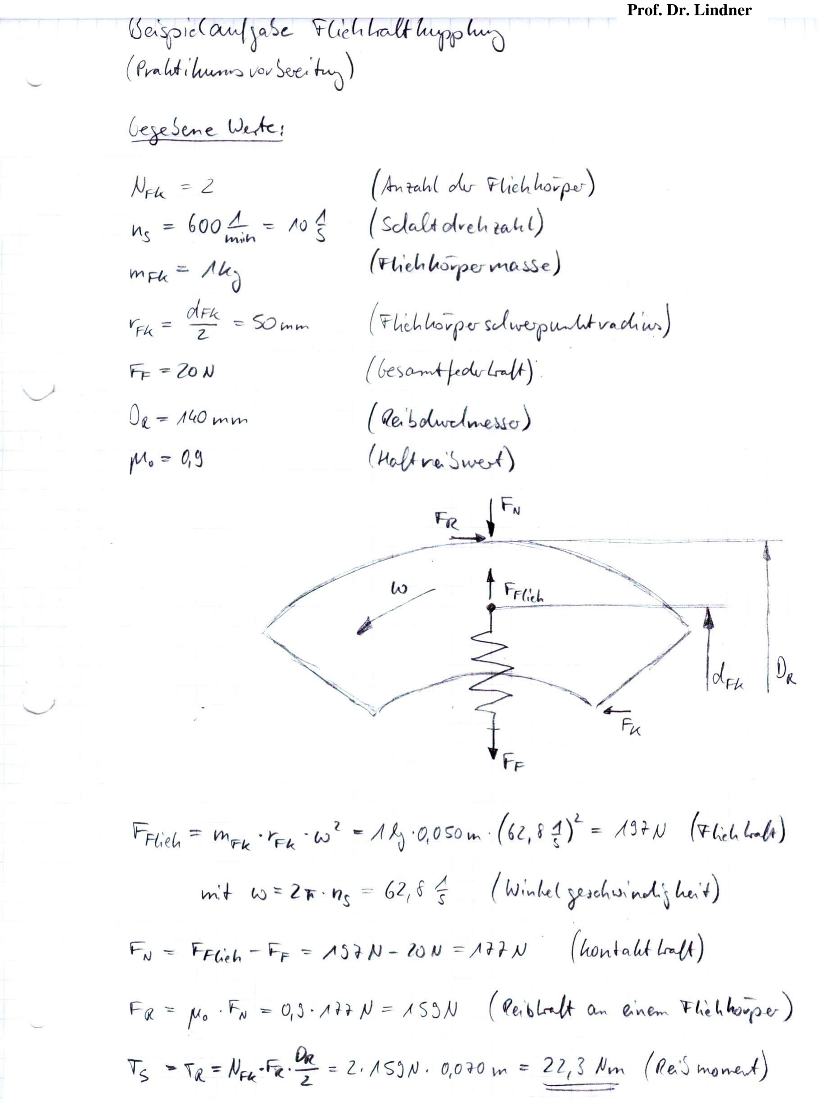
[picture p110: page 1]

Prof. Dr. Lindner
