Marvin20212/Gruppe9_ME3E/Aufgabenstellung/ME3_Lindner_Entwurf_Isometrische-Darstellung_SS2021.pdf

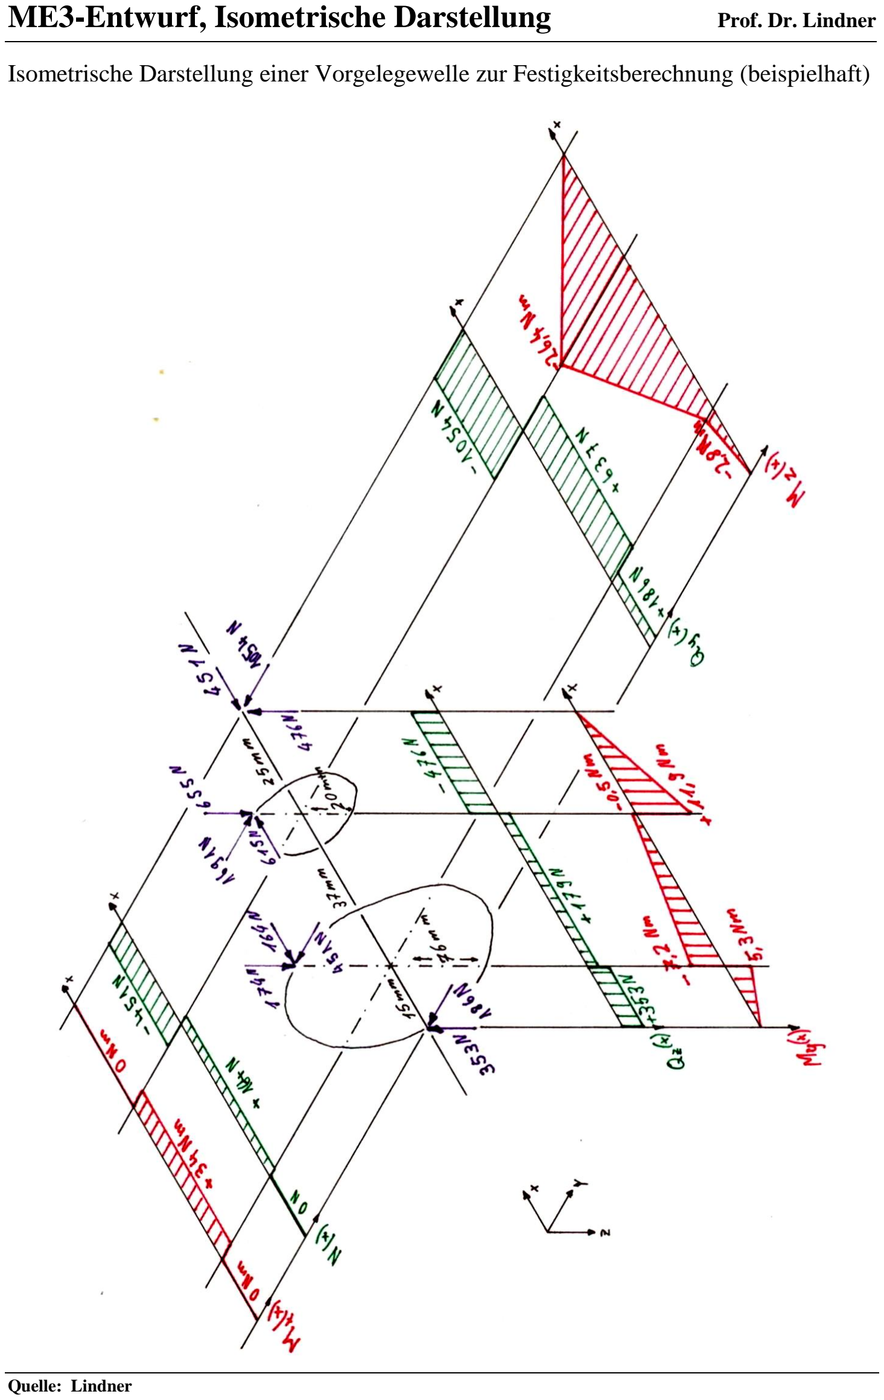
[picture p111: page 1]

ME3-Entwurf, Isometrische Darstellung | Prof. Dr. Lindner

Isometrische Darstellung einer Vorgelegewelle zur Festigkeitsberechnung (beispielhaft)

Quelle: Lindner
