Marvin20212/Gruppe9_ME3E/Berechnungen/Schnittgrößen/Abtriebswelle allgemein.PNG

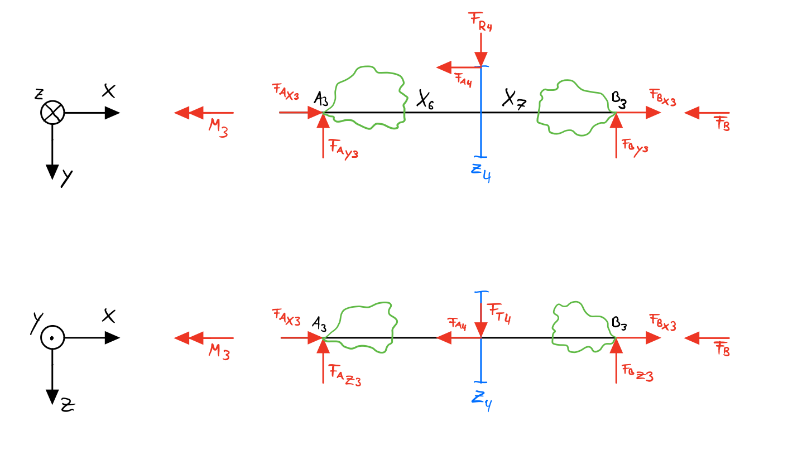
Berechnungen/Schnittgrößen/Abtriebswelle allgemein.PNG
