Marvin20212/Gruppe9_ME3E/Berechnungen/Schnittgrößen/Abtriebswelle XY 1..PNG

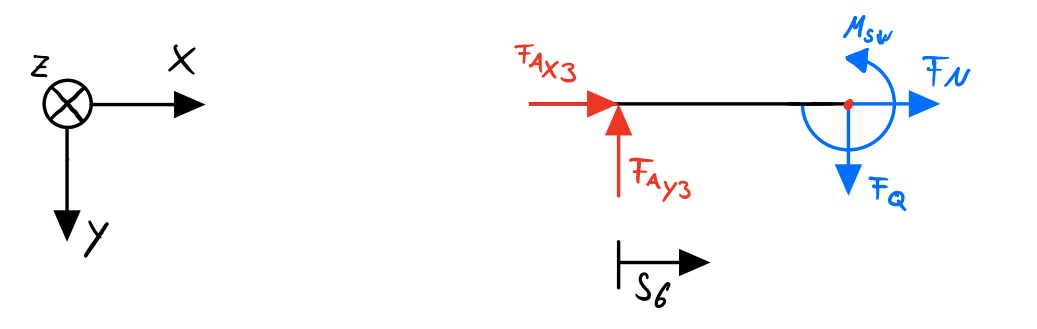
Berechnungen/Schnittgrößen/Abtriebswelle XY 1..PNG
