Marvin20212/Gruppe9_ME3E/Berechnungen/Schnittgrößen/Abtriebswelle XZ 2..PNG

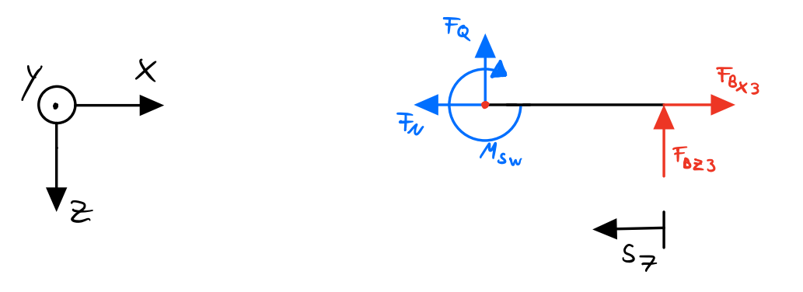
Berechnungen/Schnittgrößen/Abtriebswelle XZ 2..PNG
