Marvin20212/Gruppe9_ME3E/Berechnungen/Schnittgrößen/Antriebswelle allgemein.PNG

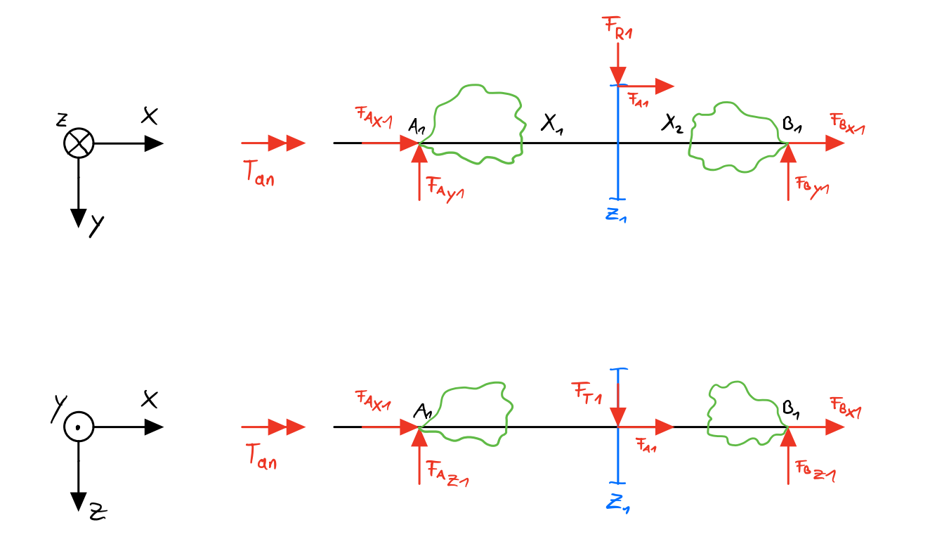
Berechnungen/Schnittgrößen/Antriebswelle allgemein.PNG
