Marvin20212/Gruppe9_ME3E/Berechnungen/Schnittgrößen/Antriebswelle XY 1..PNG

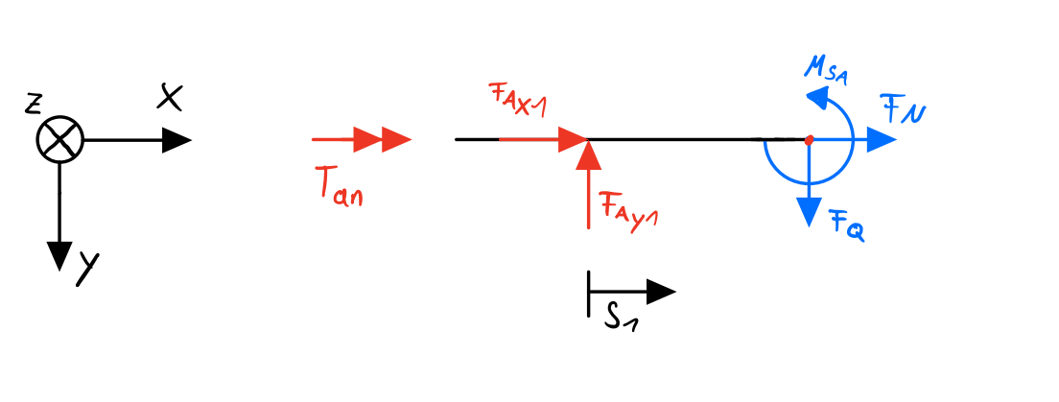
Berechnungen/Schnittgrößen/Antriebswelle XY 1..PNG
