Marvin20212/Gruppe9_ME3E/Berechnungen/Schnittgrößen/Antriebswelle XZ 1..PNG

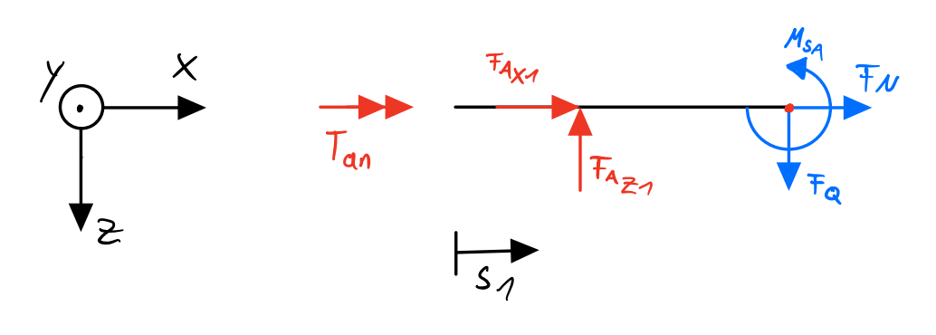
Berechnungen/Schnittgrößen/Antriebswelle XZ 1..PNG
