Marvin20212/Gruppe9_ME3E/Berechnungen/Schnittgrößen/NEU/Ab gesamt.PNG

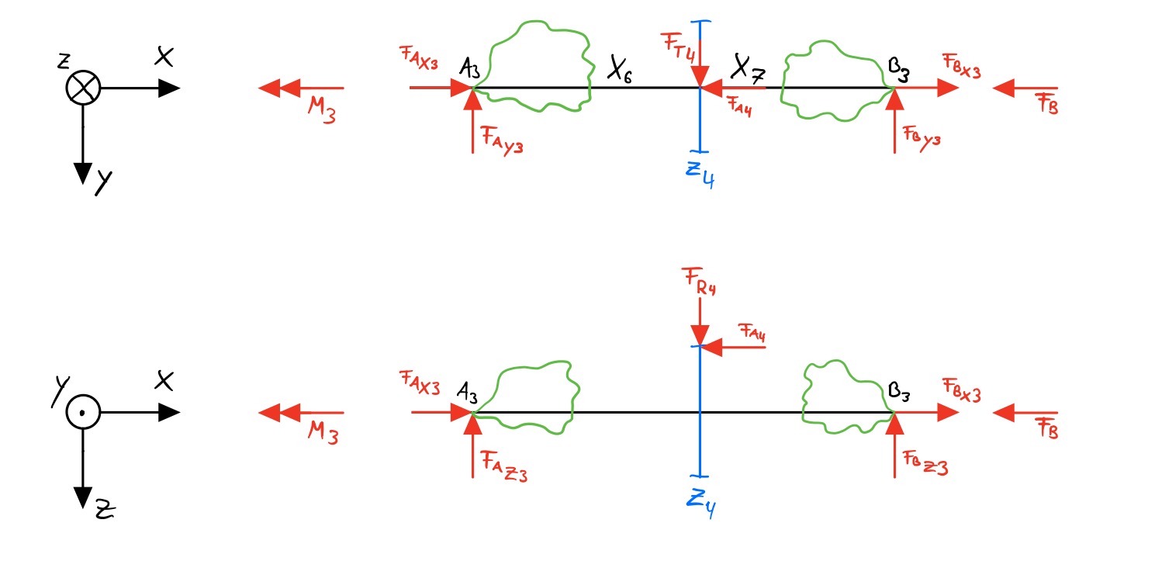
Berechnungen/Schnittgrößen/NEU/Ab gesamt.PNG
