Marvin20212/Gruppe9_ME3E/Berechnungen/Schnittgrößen/NEU/Ab xy 2.PNG

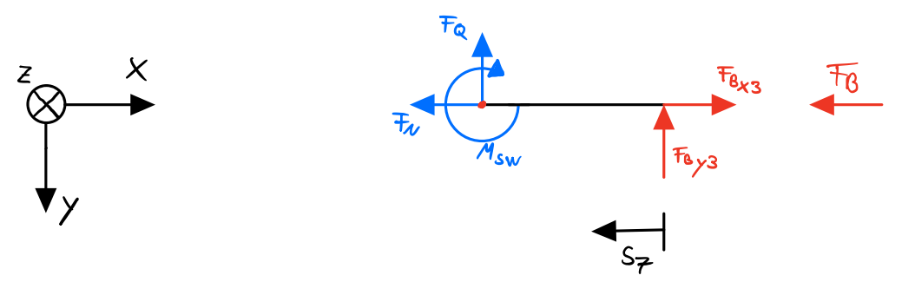
Berechnungen/Schnittgrößen/NEU/Ab xy 2.PNG
