Marvin20212/Gruppe9_ME3E/Berechnungen/Schnittgrößen/NEU/Ab xz 1.PNG

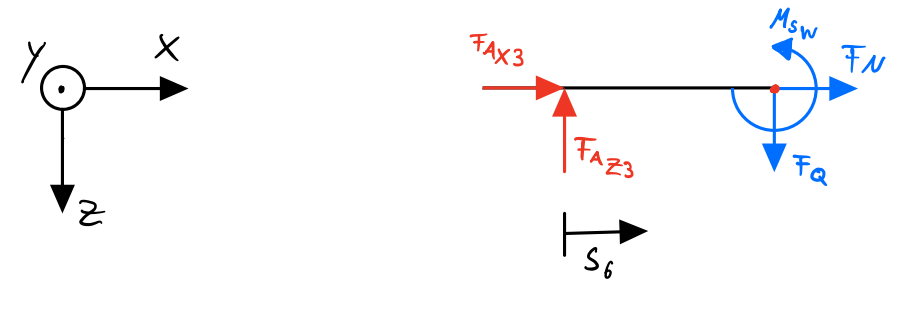
Berechnungen/Schnittgrößen/NEU/Ab xz 1.PNG
