Marvin20212/Gruppe9_ME3E/Berechnungen/Schnittgrößen/NEU/An xz 2.PNG

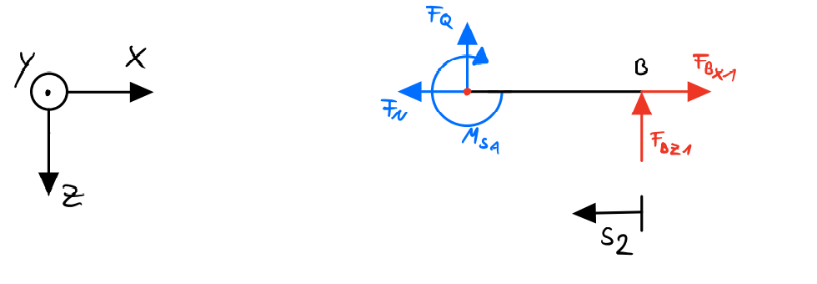
Berechnungen/Schnittgrößen/NEU/An xz 2.PNG
