Marvin20212/Gruppe9_ME3E/Berechnungen/Schnittgrößen/NEU/Vor gesamt.PNG

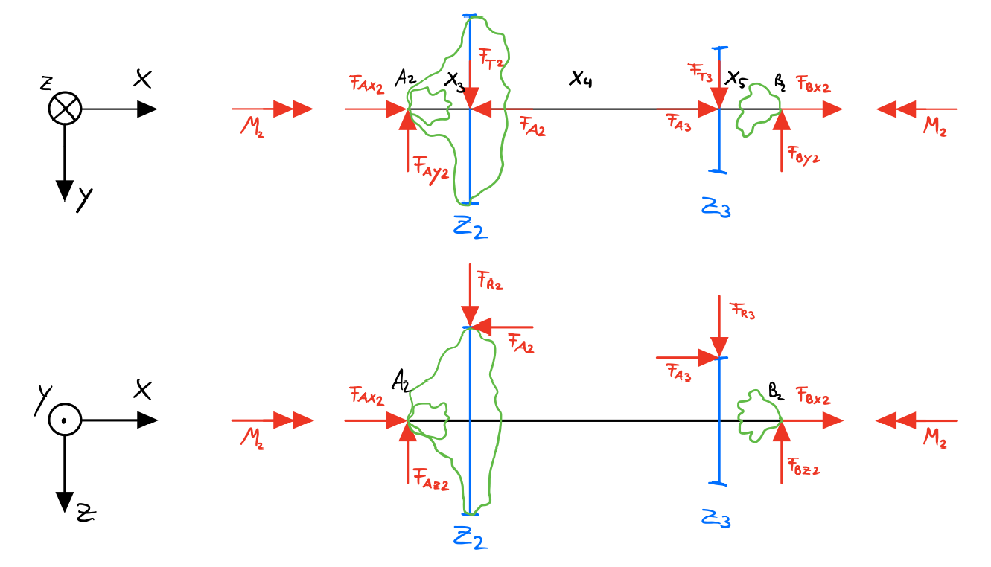
Berechnungen/Schnittgrößen/NEU/Vor gesamt.PNG
