Marvin20212/Gruppe9_ME3E/Berechnungen/Schnittgrößen/NEU/Vor xy 2.PNG

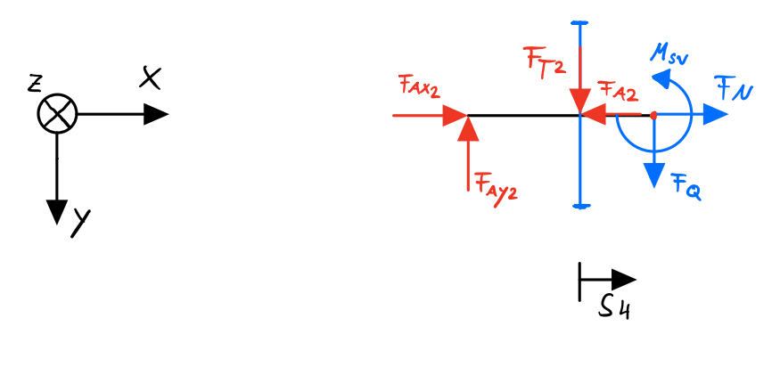
Berechnungen/Schnittgrößen/NEU/Vor xy 2.PNG
