Marvin20212/Gruppe9_ME3E/Berechnungen/Schnittgrößen/NEU/Vor xz 3.PNG

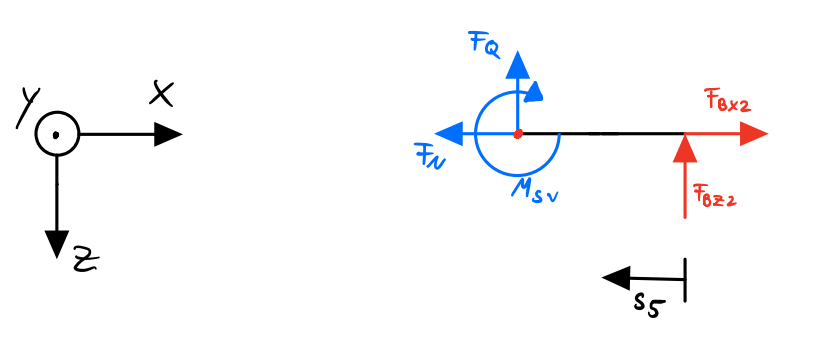
Berechnungen/Schnittgrößen/NEU/Vor xz 3.PNG
