Marvin20212/Gruppe9_ME3E/Berechnungen/Schnittgrößen/Vorgelegewelle allgemein.PNG

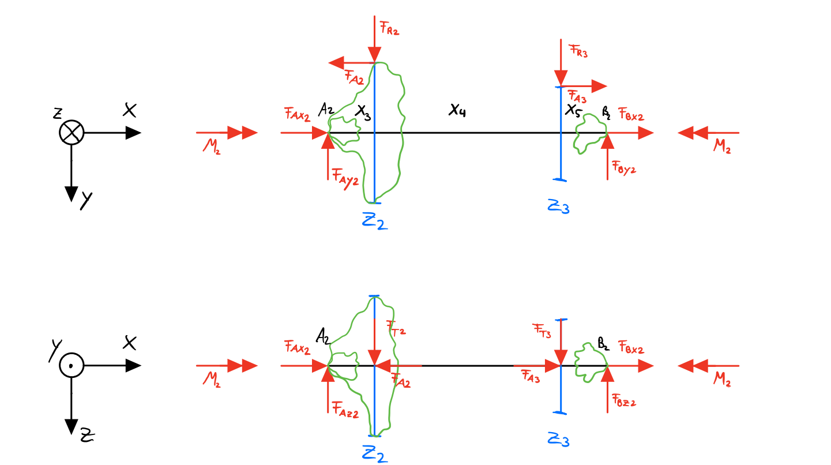
Berechnungen/Schnittgrößen/Vorgelegewelle allgemein.PNG
