Marvin20212/Gruppe9_ME3E/Berechnungen/Schnittgrößen/Vorgelegewelle XY 2..PNG

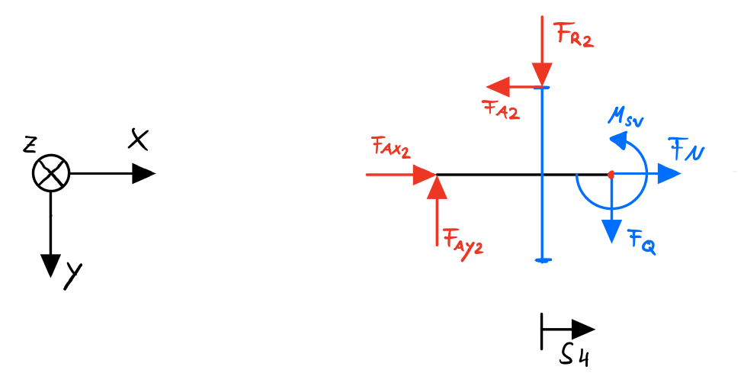
Berechnungen/Schnittgrößen/Vorgelegewelle XY 2..PNG
