Marvin20212/Gruppe9_ME3E/Berechnungen/Schnittgrößen/Vorgelegewelle XZ 2..PNG

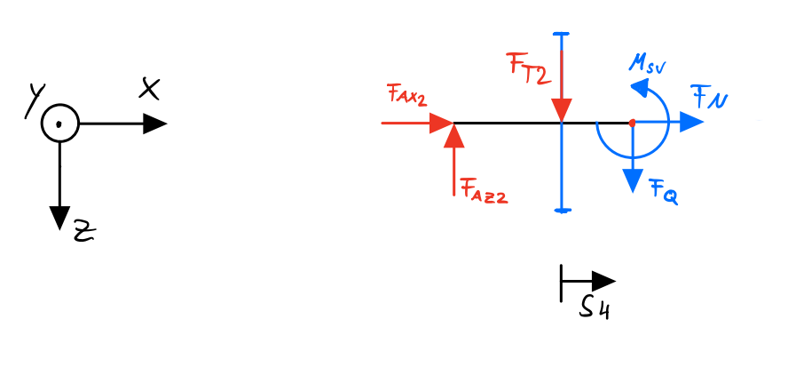
Berechnungen/Schnittgrößen/Vorgelegewelle XZ 2..PNG
