Marvin20212/Gruppe9_ME3E/Berechnungen/Schnittgrößen/Vorgelegewelle XZ 3..PNG

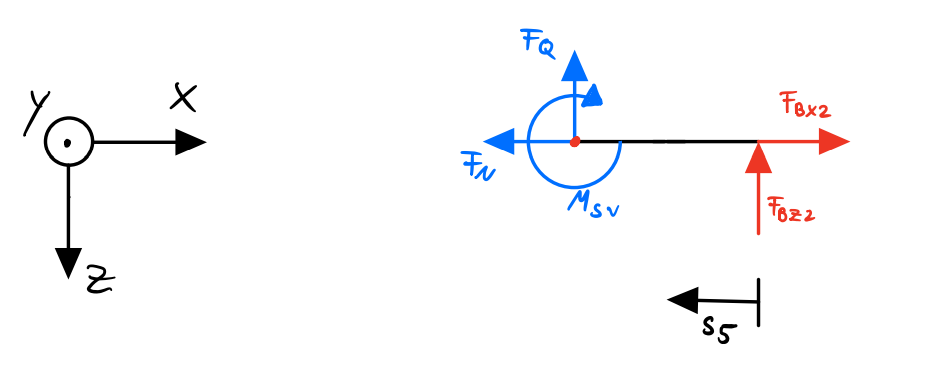
Berechnungen/Schnittgrößen/Vorgelegewelle XZ 3..PNG
