Marvin20212/Gruppe9_ME3E/Entwurf alt (Lars)/ME3-Entwurf/Bilder/Freischnitte und Verläufe/Abtriebswelle_XZ-Ebene.PNG

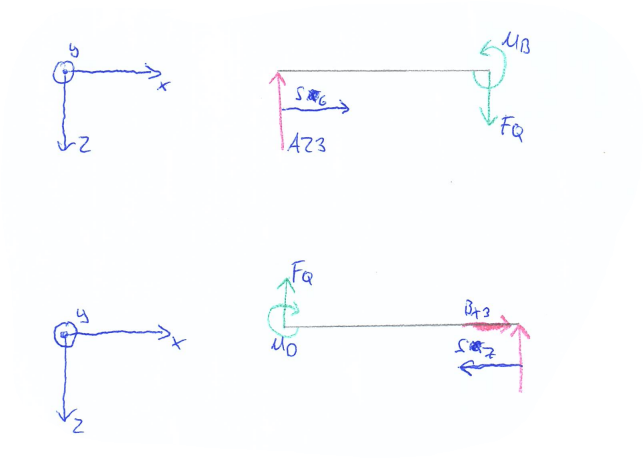
Entwurf alt (Lars)/ME3-Entwurf/Bilder/Freischnitte und Verläufe/Abtriebswelle_XZ-Ebene.PNG
