Marvin20212/Gruppe9_ME3E/Entwurf alt (Lars)/ME3-Entwurf/Bilder/Freischnitte und Verläufe/Antriebswelle_XY-Ebene.PNG

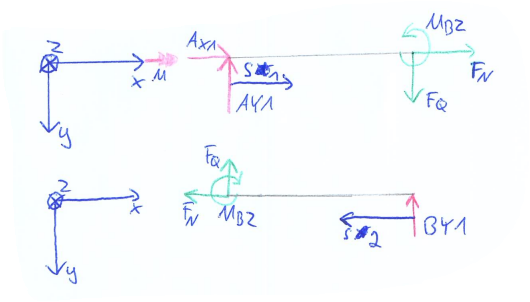
Entwurf alt (Lars)/ME3-Entwurf/Bilder/Freischnitte und Verläufe/Antriebswelle_XY-Ebene.PNG
