Marvin20212/Gruppe9_ME3E/Entwurf alt (Lars)/ME3-Entwurf/Bilder/Freischnitte und Verläufe/Freischnitt_Abtriebswelle.PNG

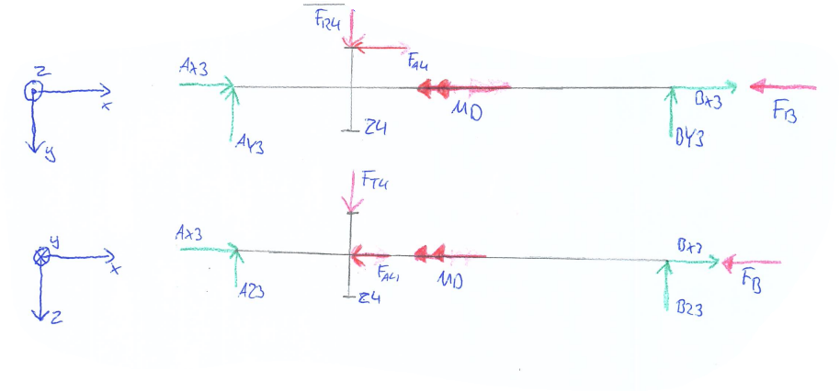
Entwurf alt (Lars)/ME3-Entwurf/Bilder/Freischnitte und Verläufe/Freischnitt_Abtriebswelle.PNG
