Marvin20212/Gruppe9_ME3E/Entwurf alt (Lars)/ME3-Entwurf/Bilder/Prinzipskizze.PNG

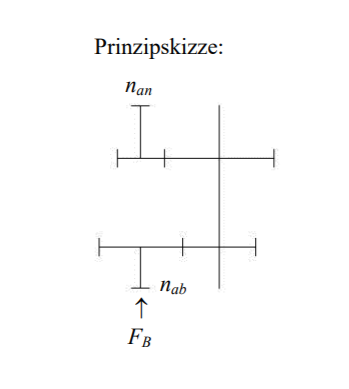
Entwurf alt (Lars)/ME3-Entwurf/Bilder/Prinzipskizze.PNG
