Marvin20212/Gruppe9_ME3E/(list of files, cad)

Other CAD files:
Zeichnungen/Schnittgrößen.dwg
Zeichnungen/Schnittgrößen Alternative.dwg
Catia/Fliehkraftkupplung/Deckel_FK.CATPart
Catia/Fliehkraftkupplung/Feder Fliehkupplung.CATPart
Catia/Fliehkraftkupplung/Fliehkoerper.CATPart
Catia/Fliehkraftkupplung/Fliehkraftkupplungdeckel.CATPart
Catia/Fliehkraftkupplung/Fliehkupplung_Flugkoerper.CATProduct
Catia/Fliehkraftkupplung/Fliehkupplung_Gesamt.CATProduct
Catia/Fliehkraftkupplung/Fliehkupplung_Haus_aussen.CATPart
Catia/Fliehkraftkupplung/Fliehkupplung_Nabe.CATPart
Catia/Fliehkraftkupplung/Mechanik innen.CATProduct
Catia/Fliehkraftkupplung/Normteile/5 Flache Scheiben DIN EN ISO 7092.CATPart
Catia/Fliehkraftkupplung/Normteile/M5 Sechskantschrauben mit Schaft DIN 931.CATPart
Catia/Fliehkraftkupplung/Normteile/Passfeder A 18x11x50.CATPart
Catia/Fliehkraftkupplung/Normteile/mutter_din_982-m5x0_8-10.CATPart
Catia/Fliehkraftkupplung/Reibflaeche.CATPart
Catia/Fliehkraftkupplung/screw_din_933-m10x25-c4-a.CATPart
Catia/Gehäuse/Alte Varianten/Gehaeuse2.CATPart
Catia/Gehäuse/Alte Varianten/Gehauese Test 1.CATPart
Catia/Gehäuse/Deckel zusammen.CATProduct
Catia/Gehäuse/Deckel.CATPart
Catia/Gehäuse/Gehaeuse 3.CATPart
Catia/Gehäuse/Glas-Dichtung.CATPart
Catia/Gehäuse/Haus zusammen.CATProduct
Catia/Gehäuse/Hilfestellung Deckel und Dichtung.CATProduct
Catia/Gehäuse/Lagersteg zusammen.CATProduct
Catia/Gehäuse/Lagersteg.CATPart
Catia/Gehäuse/Schauglas.CATPart
Catia/Gehäuse/din_580-m10-ni.CATPart
Catia/Gehäuse/din_580-m24-ni.CATPart
Catia/Gehäuse/din_en_iso_10642_m6x20.CATPart
Catia/Gehäuse/screw_din_933-m10x20-10_9-a.CATPart
Catia/Gehäuse/unterlegscheibe_iso_7092-10-a_350.CATPart
Catia/Lager/6006/bearing_6006_2.CATProduct
Catia/Lager/6006/bearing_6006_2_01.CATPart
Catia/Lager/6006/bearing_6006_2_02.CATPart
Catia/Lager/6006/bearing_6006_2_03.CATPart
Catia/Lager/6012/bearing_6012_2.CATProduct
Catia/Lager/6012/bearing_6012_2_01.CATPart
Catia/Lager/6012/bearing_6012_2_02.CATPart
Catia/Lager/6012/bearing_6012_2_03.CATPart
Catia/Lager/6206/bearing_6206_2.CATProduct
Catia/Lager/6206/bearing_6206_2_01.CATPart
Catia/Lager/6206/bearing_6206_2_02.CATPart
Catia/Lager/6206/bearing_6206_2_03.CATPart
Catia/Lager/6209/bearing_6209_2.CATProduct
Catia/Lager/6209/bearing_6209_2_01.CATPart
Catia/Lager/6209/bearing_6209_2_02.CATPart
Catia/Lager/6209/bearing_6209_2_03.CATPart
Catia/Lager/6212/bearing_6212_2.CATProduct
Catia/Lager/6212/bearing_6212_2_01.CATPart
Catia/Lager/6212/bearing_6212_2_02.CATPart
Catia/Lager/6212/bearing_6212_2_03.CATPart
Catia/Lager/6309/bearing_6309_2.CATProduct
Catia/Lager/6309/bearing_6309_2_01.CATPart
Catia/Lager/6309/bearing_6309_2_02.CATPart
Catia/Lager/6309/bearing_6309_2_03.CATPart
Catia/Passfedern/A14x9x28.CATPart
Catia/Passfedern/A14x9x50.CATPart
Catia/Passfedern/A18x11x50.CATPart
Catia/Passfedern/A8x7x25.CATPart
Catia/Passfedern/A8x7x28.CATPart
Catia/RWDR/din3760-a_30x40x7-fkm.CATPart
Catia/RWDR/din3760-a_60x75x8-fkm.CATPart
Catia/Rutschkupplung (optional)/rk_1200-25.CATProduct
Catia/Rutschkupplung (optional)/rk_1200-25_01.CATPart
Catia/Rutschkupplung (optional)/rk_1200-25_02.CATPart
Catia/Rutschkupplung (optional)/rk_1200-25_03.CATPart
Catia/Rutschkupplung (optional)/rk_1200-25_04.CATPart
Catia/Rutschkupplung (optional)/rk_1200-25_05.CATPart
Catia/Sicherungsringe/DIN 471 - 30x1.5/Sicherungsring DIN 471-030x1,5.CATPart
Catia/Sicherungsringe/DIN 471 - 30x1.5/sw-471030.CATPart
Catia/Sicherungsringe/DIN 471 - 45x1.75/sw-471045.CATPart
Catia/Sicherungsringe/DIN 471 60x2.0/sw-471060.CATPart
Catia/Sicherungsringe/DIN 472 100x3,0/circlips_din472_100_3.CATPart
Catia/Sicherungsringe/DIN 472 102x4.0 alt/102-1289632.CATPart
Catia/Sicherungsringe/DIN 472 110x4,0/circlips_din472_110_4.CATPart
Catia/Sicherungsringe/DIN 472 112x4.0 alt/112-1289675.CATPart
Catia/Sicherungsringe/DIN 472 40x1,75/circlips_din472_40_1_75.CATPart
Catia/Sicherungsringe/DIN 472 62x2.0/62-1289454.CATPart
Catia/Sicherungsringe/DIN 472 75x2,5/circlips_din472_75_2_5.CATPart
Catia/Wellen/AbtriebZSM.CATProduct
Catia/Wellen/Abtriebswelle.CATPart
Catia/Wellen/AntriebZSM.CATProduct
Catia/Wellen/Antriebswelle.CATPart
Catia/Wellen/VorgelegeZSM.CATProduct
Catia/Wellen/Vorgelegewelle.CATPart
Catia/Zahnräder/Zahnrad Konfigurator/Stufe 1/Eing-Steuerteil_Stirnradstufe_Maschb_Achabst1.CATPart
Catia/Zahnräder/Zahnrad Konfigurator/Stufe 1/Stirnradstufe_Maschb_Waelzverf_S20_R19_1.CATProduct
Catia/Zahnräder/Zahnrad Konfigurator/Stufe 1/Stufe 1 fertig.CATProduct
Catia/Zahnräder/Zahnrad Konfigurator/Stufe 2/Eing-Steuerteil_Stirnradstufe_Maschb_Achabst.CATPart
Catia/Zahnräder/Zahnrad Konfigurator/Stufe 2/Stirnradstufe_Maschb_Waelzverf_S20_R19.CATProduct
Catia/Zahnräder/Zahnrad Konfigurator/Stufe 2/Stufe 2 fertig.CATProduct
Catia/Zusammenbau/Gruppe 9 Bohrgetriebe.CATProduct
Catia/Zusammenbau/Normteile ZsmBau/07160-108x60.CATPart
Catia/Zusammenbau/Normteile ZsmBau/07170-10x60.CATPart
Catia/Zusammenbau/Normteile ZsmBau/07210-110.CATPart
Catia/Zusammenbau/Normteile ZsmBau/Schrauben_Deckel_Haus.CATProduct
Catia/Zusammenbau/Normteile ZsmBau/din_en_iso_7092-10.CATPart
Catia/Zusammenbau/Normteile ZsmBau/din_en_iso_8734_6x40.CATPart
Catia/Zusammenbau/Normteile ZsmBau/din_en_iso_8734_8x35.CATPart
Catia/Ölschraube/din910-m12x1_5-st.CATPart
Catia/Ölschraube/gn_546_6-20-g3_4.CATPart
Entwurf alt (Lars)/ME3-Entwurf/CAD-Dateien/Fliehkraftkupplung/Fliehkraftkupplung_Niklas/Aufnahme.CATPart
Entwurf alt (Lars)/ME3-Entwurf/CAD-Dateien/Fliehkraftkupplung/Fliehkraftkupplung_Niklas/Begrenzung_Flach.CATPart
Entwurf alt (Lars)/ME3-Entwurf/CAD-Dateien/Fliehkraftkupplung/Fliehkraftkupplung_Niklas/Begrenzung_Tief.CATPart
Entwurf alt (Lars)/ME3-Entwurf/CAD-Dateien/Fliehkraftkupplung/Fliehkraftkupplung_Niklas/Fliehkraftkupplung_Gesamt.CATProduct
Entwurf alt (Lars)/ME3-Entwurf/CAD-Dateien/Fliehkraftkupplung/Fliehkraftkupplung_Niklas/Gehaeuse.CATPart
Entwurf alt (Lars)/ME3-Entwurf/CAD-Dateien/Fliehkraftkupplung/Fliehkraftkupplung_Niklas/Gehaeuse_Basisplatte.CATPart
Entwurf alt (Lars)/ME3-Entwurf/CAD-Dateien/Fliehkraftkupplung/Fliehkraftkupplung_Niklas/Kupplung_Innen.CATProduct
Entwurf alt (Lars)/ME3-Entwurf/CAD-Dateien/Fliehkraftkupplung/Fliehkraftkupplung_Niklas/Kupplung_Mechanik.CATProduct
Entwurf alt (Lars)/ME3-Entwurf/CAD-Dateien/Fliehkraftkupplung/Fliehkraftkupplung_Niklas/Mantel.CATPart
Entwurf alt (Lars)/ME3-Entwurf/CAD-Dateien/Fliehkraftkupplung/Fliehkraftkupplung_Niklas/Nabe.CATPart
Entwurf alt (Lars)/ME3-Entwurf/CAD-Dateien/Fliehkraftkupplung/Fliehkraftkupplung_Niklas/Normteile/07160-408x20.CATPart
Entwurf alt (Lars)/ME3-Entwurf/CAD-Dateien/Fliehkraftkupplung/Fliehkraftkupplung_Niklas/Normteile/07210-104.CATPart
Entwurf alt (Lars)/ME3-Entwurf/CAD-Dateien/Fliehkraftkupplung/Fliehkraftkupplung_Niklas/Normteile/07210-106.CATPart
Entwurf alt (Lars)/ME3-Entwurf/CAD-Dateien/Fliehkraftkupplung/Fliehkraftkupplung_Niklas/Normteile/schraube_iso_4762-m4x30-a4-70.CATPart
Entwurf alt (Lars)/ME3-Entwurf/CAD-Dateien/Fliehkraftkupplung/Fliehkraftkupplung_Niklas/Reibmaterial.CATPart
Entwurf alt (Lars)/ME3-Entwurf/CAD-Dateien/Gehause/Gehause_Neu/03320-10x40.CATPart
Entwurf alt (Lars)/ME3-Entwurf/CAD-Dateien/Gehause/Gehause_Neu/Dichtung.CATPart
Entwurf alt (Lars)/ME3-Entwurf/CAD-Dateien/Gehause/Gehause_Neu/Gehaeuse_komplett.CATProduct
Entwurf alt (Lars)/ME3-Entwurf/CAD-Dateien/Gehause/Gehause_Neu/Gehause_Getriebe.CATPart
Entwurf alt (Lars)/ME3-Entwurf/CAD-Dateien/Gehause/Gehause_Neu/Schild.CATPart
Entwurf alt (Lars)/ME3-Entwurf/CAD-Dateien/Gehause/Gehause_Neu/Verschraubung/10_00_0125_0084a_v4a.CATPart
Entwurf alt (Lars)/ME3-Entwurf/CAD-Dateien/Gehause/Gehause_Neu/Verschraubung/Verschraubung M8.CATProduct
Entwurf alt (Lars)/ME3-Entwurf/CAD-Dateien/Gehause/Gehause_Neu/Verschraubung/din_en_iso_4017_m8x50_a.CATPart
Entwurf alt (Lars)/ME3-Entwurf/CAD-Dateien/Gehause/Gehause_Neu/Verschraubung/mutter_din934_m8-10.CATPart
Entwurf alt (Lars)/ME3-Entwurf/CAD-Dateien/Gehause/Gehause_Neu/Wartungsklappe.CATPart
Entwurf alt (Lars)/ME3-Entwurf/CAD-Dateien/Gehause/Gehause_Neu/circlips_din472_90_3.CATPart
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
