Marvin20212/Gruppe9_ME3E/Testat 1/Me3-E Testat 1 SoSe2022 Gruppe 9.pdf

# ME3-E

# Testat 1 Bohrgerät-Getriebe

# Gruppe 9:

Daniel Skrypnikov,
Edis Duvnjak,

# Marvin Müller

### Inhaltsverzeichnis:

1. Anforderungsliste
2. Prinzip-Skizze
3. Entwurf-Skizze
4. Berechnungen:
1) Auslegen der Übersetzung und Bestimmung der Zähnezahlen
2) Berechnung der Wellen und Passfedern
3) Zahnradbreite
4) Schrägungswinkel
5) Modul 1,2
6) Teilkreisdurchmesser Z1,Z2
7) Achsabstand 1,2
8) Modul 3,4
9) Teilkreisdurchmesser Z3,Z4
10) Achsabstand 3,4
11) Profilverschiebung
12) Kopfspiel
13) Weitere Auslegungen der Zahnräder
14) Kopfspiel nach Verschiebung
15) Profilüberdeckung
16) Zusammenfassung wichtiger Komponenten der Zahnräder 1-4
5. Legende der verwendeten Formelzeichen

Maschinenelemente Entwurf 3 Jade Hochschule Wilhelmshaven

Marvin Müller, Edis Duvnjak, Daniel Skrypnikov

### Anforderungsliste

- Wirtschaftliche Fertigung: Erreicht durch Guss-Gehäuse. Möglichst Kauf- und Normteile verwenden
- Wartungsfreundlichkeit: Erreicht durch zweiteiliges Gehäuse, Wartungsklappe, Schaufenster, Ölablassschraube
- Langlebigkeit des Motors: Erreicht durch Fliehkraftkupplung mit lastfreiem Anlauf
- Koaxiale Bauweise unter Benutzung einer Vorgelegewelle
- Ruhiger Lauf: Erreicht durch Schrägverzahnung der Stirnräder (β=20°)
- Langlebigkeit des Getriebes: Erreicht durch Ölschmierung
- Standzeit der Lager = L10>10000h
- Kompakte vertikale Bauweise
- Hohe Axiale Belastbarkeit
- Zielparameter mit maximal 0,5% positiver Abweichung gegenüber dem Soll-Wert
- Dauerfest SD>1,5 für alle Wellen an jeweils einer Schwachstelle
- Beständigkeit gegenüber gängigen Umgebungen (Industrie Standard)
- Flanschflächen zum Anbringen an einem Bohrmaschinen-Hubgestell
- Eine zentrale Ringschraube zum Anheben des Getriebes

Zahnrad 1; Zahnrad 2; Zahnrad 3; Zahnrad 4; Wälzlager 1; Wälzlager 2; Wälzlager 3; Wälzlager 4; Wälzlager 5; Wälzlager 6; Radialwellendichtring 1; Radialwellendichtring 2; Fliehkraftkupplung; nan; Antriebsdrehzahl; nab; Abtriebsdrehzahl; Tan; Antriebsdrehmoment; Tab; Abtriebsdrehmoment

Prinzipskizze des Bohrgerät-Getriebes

Die blaue, parallele Fläche ist eine
Öffnung und Wartungsluke am
Gehäuse


Berechnungen zur Auslegung eines Bohrgerät-Getriebes

ME3 Entwurf SoSe2022 | Gruppe 9 Vorgegebene Auslegungsdaten:
Bezeichnung und Wert: | Benennung:
Tan≔50 N ⋅m | Antriebsdrehmoment Abtriebsdrehmoment Schaltdrehzahl

Tab1≔650 N ⋅m

nS≔1100 min ⁻¹

nan≔2000 min ⁻¹ | Antriebsdrehzahl Bohr-Abtriebskraft Belastungsfaktor

FB≔1.5 kN

KA≔2.0

1) Auslegen der Übersetzung und Bestimmung der Zähnezahlen

rechnerisches Übersetzungsverhältnis

iges≔――=

Tab1

Tan

13

i12≔3.95 | TBM S. 269

i34≔――=

iges

i12

3.291

iges≔i12 ⋅i34=13 | Das Gegenrechnen bestätigt den Wert für iges

nab≔――=

nan

iges

153.846 min ⁻¹

Zähnezahlen der Zahnräder

z1≔25

z2≔z1

⋅i12=98.75 | z2≔99 | TBM S. 269

z3≔24

z4≔z3

⋅i34=78.987 z4≔79

Als Literatur für die Formeln dient:
Roloff/Matek Maschinenelemente 24. Auflage (Springer Vieweg) | Gl.: | TB:
Tabellenbuch Metall 48. Auflage (Europa Lehrmittel) | TBM S.
Seite 1 von 11 tatsächliches Übersetzungsverhältnis

i12≔―=

z2
z1

### 3.96 TBM S. 269

i34≔―=

z4
z3

3.292

iges≔i12 ⋅i34=13.035

Abweichung Abtriebsparameter

Tab2≔Tan ⋅iges=651.75 N ⋅m | Das ausgelegte Abtriebsdrehmoment weicht 0,3% im positiven Sinne von den Anforderungen ab.
――=

Tab2

Tab1

1.003
nab≔――=

nan

iges

153.433 min ⁻¹

Seite 2 von 11

2) Berechnung der Wellen und Passfedern

τtzul≔50 ―N―mm²
Dauerfestigkeitsschubspannung von 42CrMo4
nP≔1 | Anzahl Passfedern pro Welle-Nabe Verbindung
φ≔1 | Traganteil der Passfeder
Re≔295 ―N―mm² | Streckgrenze E295
SF≔1.1 | Sicherheit Fließgrenze

pFzul≔―=

Re
SF

268.182 ―N―mm²
| Zulässige Flächenpressung einer Passfeder

Antriebswelle:

dmin1≔ | =

3 ――――

16 ⋅T ⋅ an KA

π⋅τtzul

21.677 mm | dW1≔30 mm | t1;W1≔4 mm

l

t1≔―――――――――――=

2 ⋅Tan
dW1 ⋅ ⎛ | ⋅ ⋅ ⋅ ⎝7 mm -t1;W1⎞
⎠ nP φ pFzul
4.143 mm | bP1≔8 mm

Da die tragende Länge nicht die Abrundungen am Ende beinhaltet, werden beide Radien (zusammen die Breite der Passfeder) addiert und die Gesamtlänge auf die nächste genormte Länge gerundet.
lP1≔l
t1+bP1=12.143 mm | gewählt: Antriebswelle ⌀ 30mm
Passfeder DIN 6885 - A8 x 7 x 14

Vorgelegewelle:

dmin2≔ | =

3 ―――――

16 ⋅T ⋅ ⋅ an KA i12

π⋅τtzul

34.295 mm dW2≔45 mm t1;W2≔5.5 mm

l

t2≔―――――――――――=

2 ⋅T ⋅ an i12
dW2 ⋅ ⎛ | ⋅ ⋅ ⋅ ⎝9 mm -t1;W2⎞
⎠ nP φ pFzul
9.375 mm | bP2≔14 mm

Da die tragende Länge nicht die Abrundungen am Ende beinhaltet, werden beide Radien (zusammen die Breite der Passfeder) addiert und die Gesamtlänge auf die nächste genormte Länge gerundet.

lP2≔l

t2+bP2=23.375 mm | gewählt: Vorgelegewelle ⌀ 45mm
Passfeder DIN 6885 - A14 x 9 x 25

Seite 3 von 11

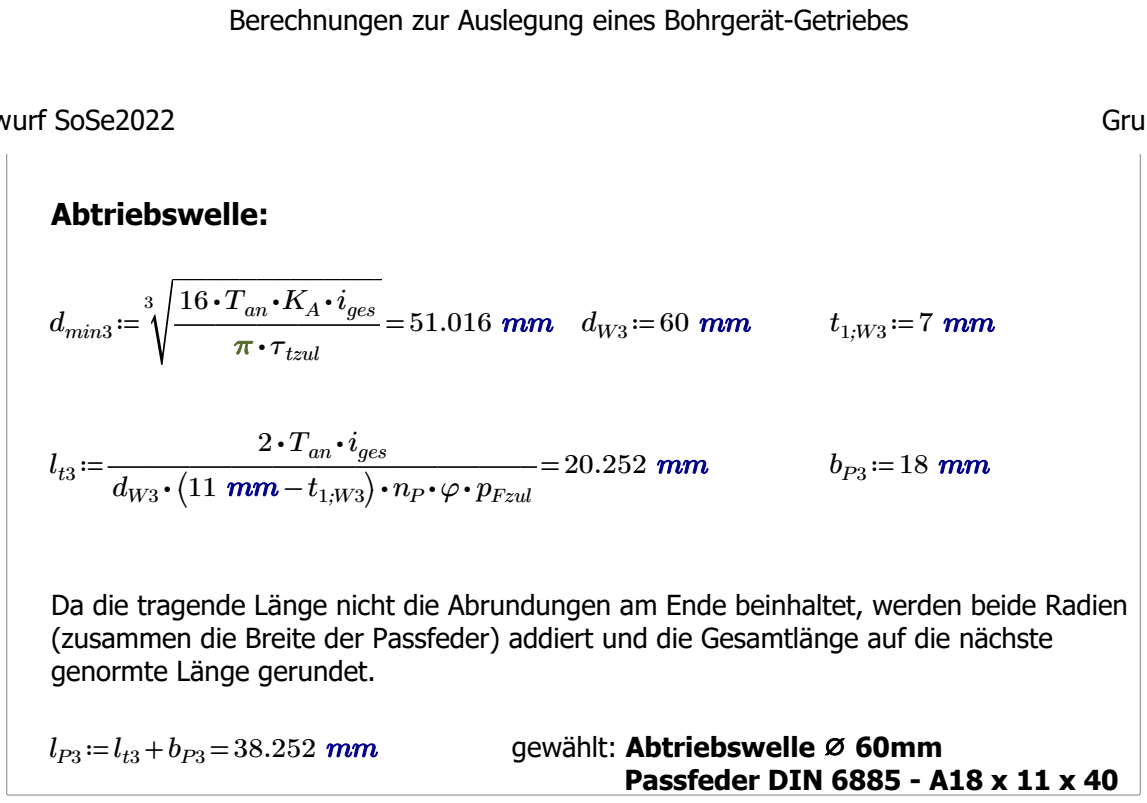
[picture p151: figure]
Abtriebswelle:; dmin3≔; ⋅ an KA iges; π⋅τtzul; 2 ⋅T ⋅ an iges; ⎠ nP φ pFzul; genormte Länge gerundet.; gewählt: Abtriebswelle ⌀ 60mm; Passfeder DIN 6885 - A18 x 11 x 40

Da die tragende Länge nicht die Abrundungen am Ende beinhaltet, werden beide Radien (zusammen die Breite der Passfeder) addiert und die Gesamtlänge auf die nächste

3) Zahnradbreite

Bzul≔4.0 ―N―mm²
Überschlägigier Belastungswert

Formel nach Vereinbarungen

Um auf eine ganze Zahl für die Breite zu kommen, wird hier aufgerundet. Da ein ständiger Eingriff der Zahnräder 1 und 2 nötig ist, wird das Zahnrad 2 aufgrund des größeren Durchmessers etwas kleiner gewählt.

b1≔――――=

2 ⋅Tan
dW1 ⋅

### 2 Bzul

27.778 mm

b1≔30 mm

b2≔28 mm

b3≔――――=

2 ⋅T ⋅ an i12
dW2 ⋅

### 2 Bzul

48.889 mm | Formel nach Vereinbarungen
| Um auf eine ganze Zahl für die Breite zu kommen, wird hier aufgerundet. Da ein ständiger Eingriff der Zahnräder 3 und 4 nötig ist, wird das Zahnrad 4 aufgrund des größeren Durchmessers etwas kleiner gewählt. b3≔52 mm

b4≔50 mm

Seite 4 von 11

4) Schrägungswinkel

Der Schrägungswinkel ist mit β≔20 ° bereits in den Vereinbarungen gegeben.

5) Modul 1,2

mn12≔――――――=

1.8 ⋅dW1 ⋅ cos ((β))
⎛⎝z1-2.5⎞
⎠
2.255 mm | Gl.:21.63
| gewählt: mn12≔2.5 mm
6) Teilkreisdurchmesser Z1,Z2

d1≔―――=

z ⋅ 1 mn12
cos ((β))

66.511 mm

TBM S. 267
d2≔―――=

z ⋅ 2 mn12
cos ((β))

263.384 mm

7) Achsabstand 1,2

a12≔―――=

d1+d2
2
164.948 mm | TBM S. 267
8) Modul 3,4

mn34≔―――――=

2 ⋅a ⋅ 12 cos ((β))
⎛ ⋅ ⎝1+i34⎞
⎠ z3
3.01 mm | Gl.:21.64 / TB:21-1

gewählt: mn34≔3 mm

Seite 5 von 11

9) Teilkreisdurchmesser Z3,Z4

d3≔―――=

z ⋅ 3 mn34
cos ((β))

76.621 mm

TBM S. 267
d4≔―――=

z ⋅ 4 mn34
cos ((β))

252.21 mm

10) Achsabstand 3,4

a34≔―――=

d3+d4
2

164.415 mm

Differenz Achsabstände

pv≔a12-a34=0.532 mm | Diese Differenz der Achsabstände muss durch eine Profilverschiebung angeglichen werden. Diese wird im Folgenden berechnet.
11) Profilverschiebung

Aufgrund weniger Drehmomentkräfte an den Zahnrädern 1 und 2 haben wir uns dort für die Profilverschiebung entschieden.

Stirneingriffswinkel

αn≔β=20 °

αt≔atan | =

⎛
⎜

⎝―――

tan⎛⎝αn

⎞
⎠
cos ((β))

⎞
⎟
⎠
21.173 ° | Gl.: 21.35

Seite 6 von 11

Ersatzzähnezahl

βb≔acos | =

⎛
⎜
⎝

―――

sin⎛⎝αn

⎞
⎠
sin⎛⎝αt

⎞
⎠

⎞
⎟
⎠
18.747 ° | Gl.: 21.36

zn1≔―――――=

d1

cos ⎛ ⋅ ⎝βb

⎞
⎠

2
mn12

29.669 Gl.: 21.47

zn2≔―――――=

d2
cos ⎛ ⋅ ⎝βb

⎞
⎠ mn12

111.256

Profilverschiebungsfaktoren und Profilverschiebung

Bei der Profilverschiebung V ist zum Berechnen der Wert x nötig. Dieser wird in der Formel für die Summe der Profilverschiebungsfaktoren errechnet, welche bis auf den Betriebseingriffswinkel zurückblickt. Daher werden im Folgenden mehrere Gleichungen angewendet, um letztendlich auf die Profilverschiebung zu kommen.

Betriebseingriffswinkel:

αwt≔acos | =

⎛
⎜
⎝

cos ⎛ ⋅ ⎝αt

⎞
⎠ ――

a12

a34

⎞
⎟
⎠
20.689 ° | aus Gl.: 21.54 umgestellt

Profilverschiebungsfaktoren:

invαwt≔tan⎛⎝αwt⎞
⎠-αwt⋅――=

π
180 °

0.017
aus Hinweisen von S.797/809 invαt≔tan⎛⎝αt

⎞
⎠-αt

⋅――=

π
180 °

0.018

Σx≔―――――⋅ | =

invαwt-invαt
2 ⋅ tan⎛⎝αn

⎞
⎠

⎛⎝z1+z2

⎞
⎠ -0.211 | Gl.: 21.56

x berechnen:

x1≔――+ | =

Σx
2

⋅

⎛
⎜
⎝

0.5-―Σx―2

⎞
⎟

⎠ ―――――

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
⎝―――

z ⋅ n1 zn2
100

⎞
⎟
⎠

0.133 aus Gl.: 21.33 umgestellt

x2≔Σx-x1=-0.343

Seite 7 von 11

Verschiebungen:

V1≔x1

⋅mn12=0.332 mm
Gl.: 21.49
V2≔x2

⋅mn12=-0.859 mm

V3≔0 mm

V4≔0 mm

Betriebswälzkreisdurchmesser

dwd1≔d1

⋅―――=

cos ⎛⎝αt

⎞
⎠
cos ⎛⎝αwt⎞
⎠
66.297 mm | Gl.: 21.22a

dwd2≔d2

⋅―――=

cos ⎛⎝αt

⎞
⎠
cos ⎛⎝αwt⎞
⎠
262.534 mm | Gl.: 21.22b

dwd3≔d3=76.621 mm

dwd4≔d4=252.21 mm

neuer Achsabstand

av12≔――――=

dwd1+dwd2
2
164.415 mm | Gl.:21.54 / 21.19

Der Achsabstand ist nun, nach der
a ≔ | Verschiebung der selbe. v34 | ――――=

dwd3+dwd4
2

164.415 mm

12) Kopfspiel

nötiges Kopfspiel

c12≔0.25 ⋅mn12=0.625 mm | Gl. von Seite 794 / 803

c34≔0.25 ⋅mn34=0.75 mm

Kopfhöhenänderung

k≔av12-a12-mn12 ⋅ ⎛⎝x1+x2

⎞
| ⎠=-0.006 mm Gl.: 21.23

Seite 8 von 11

13) Weitere Auslegungen der Zahnräder

Grundkreisdurchmesser

db1≔d1

⋅ cos ⎛⎝αt

⎞
⎠=62.021 mm | Gl.: 21.39

db2≔d2

⋅ cos ⎛⎝αt

⎞
⎠=245.604 mm

db3≔d3

⋅ cos ⎛⎝αt

⎞
⎠=71.449 mm

db4≔d4

⋅ cos ⎛⎝αt

⎞
⎠=235.185 mm

Kopfkreisdurchmesser

da1≔d1+2 ⋅ ⎛⎝mn12+V1+k⎞
⎠=72.164 mm Gl.: 20.21

da2≔d2+2 ⋅ ⎛⎝mn12+V2+k⎞
⎠=266.655 mm
da3≔d3+2 ⋅mn34=82.621 mm | Gl.: 21.40

da4≔d4+2 ⋅mn34=258.21 mm

Fußkreisdurchmesser

df1≔d1-2 ⋅ ⎛⎝

⎛⎝mn12+c12⎞
⎠-V1

⎞
⎠=60.926 mm Gl.: 21.24

df2≔d2-2 ⋅ ⎛⎝

⎛⎝mn12+c12⎞
⎠-V2

⎞
⎠=255.417 mm
df3≔d3-2 ⋅mn34=70.621 mm | Gl.: 21.41

df4≔d4-2 ⋅mn34=246.21 mm

14) Kopfspiel nach Profilverschiebung

c12neu≔av12-0.5 ⋅ ⎛⎝da1+df2⎞
⎠=0.625 mm
Da c und | augenscheinlich gleich sind, ist das nötige Kopfspiel eingehalten. 12 | c12neu

Seite 9 von 11

15) Profilüberdeckung

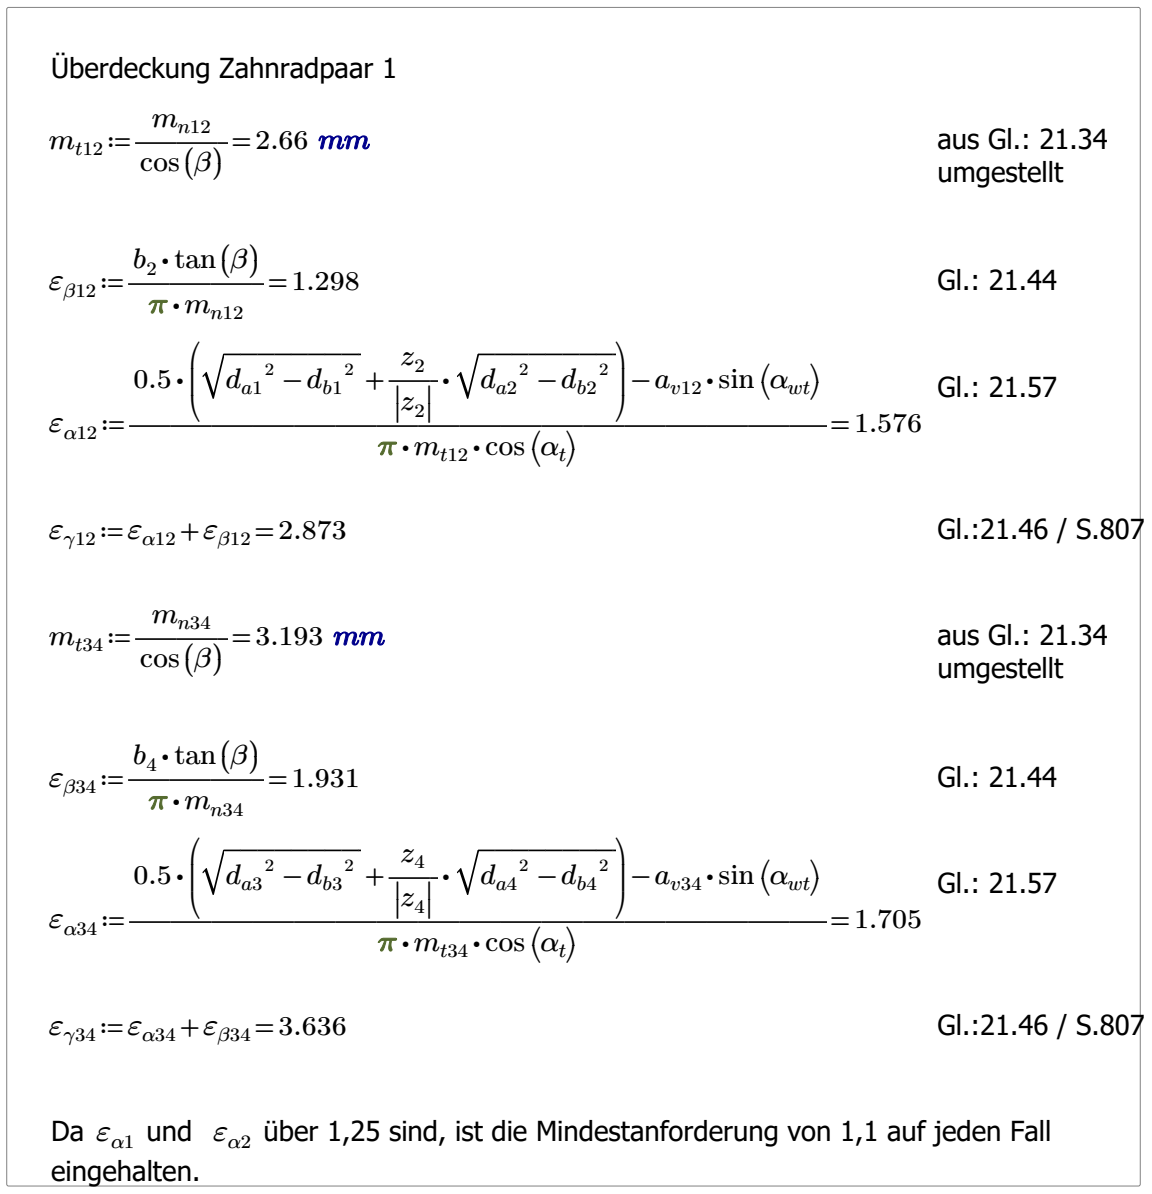
[picture p152: figure]
Überdeckung Zahnradpaar 1; mn12 cos ((β)); aus Gl.: 21.34; umgestellt; b ⋅ 2 tan((β)) π⋅mn12; a ⋅ v12 sin⎛⎝αwt⎞ ⎠; π⋅m ⋅ t12 cos ⎛⎝αt; mn34 cos ((β)); b ⋅ 4 tan((β)) π⋅mn34; a ⋅ v34 sin⎛⎝αwt⎞ ⎠; π⋅m ⋅ t34 cos ⎛⎝αt; eingehalten.

Da ε und | über 1,25 sind, ist die Mindestanforderung von 1,1 auf jeden Fall α1 | εα2

Seite 10 von 11

16) Zusammenfassung wichtiger Komponenten der Zahnräder 1-4
Zahnrad 1 | Zahnrad 2 | Zahnrad 3 | Zahnrad 4
Zähnezahl | z1 = 25 | z2 = 99 | z3 = 24 | z4 = 79
Teilkreisdurchmesser | d1 = 66.511 mm | d2 = 263.384 mm | d3 = 76.621 mm | d4 = 252.21 mm

Betriebswälzdurchmesser dwd1 = 66.297 mm dwd2 = 262.534 mm dwd3 = 76.621 mm dwd4 = 252.21 mm

Kopfkreisdurchmesser | da1 = 72.164 mm | da2 = 266.655 mm da3 = 82.621 mm | da4 = 258.21 mm
Fußkreisdurchmesser | df1 = 60.926 mm | df2 = 255.417 mm df3 = 70.621 mm | df4 = 246.21 mm
Zahnradbreite | b1 = 30 mm | b2 = 28 mm | b3 = 52 mm | b4 = 50 mm
Modul | mn12 = 2.5 mm | mn34 = 3 mm
Achsabstand | av12 = 164.415 mm | av34 = 164.415 mm
Verschiebung | V1 = 0.332 mm | V2 = -0.859 mm | V3 = 0 mm | V4 = 0 mm
Profilüberdeckung | εα12 = 1.576 | εα34 = 1.705
Sprungüberdeckung | εβ12 = 1.298 | εβ34 = 1.931
Gesamtüberdeckung | εγ12 = 2.873 | εγ34 = 3.636

Seite 11 von 11

Maschinenelemente Entwurf 3 Jade Hochschule Wilhelmshaven
Abkürzung | Benennung
a12 | Achsabstand 1,2
a34 | Achsabstand 3,4
av12 | Neuer Achsabstand 1,2
av34 | (Neuer) Achsabstand 3,4
b1 - b4 | Breite Zahnrad 1 bis 4
bP1 - bP4 | Breite Passfeder auf Welle 1 bis 3
Bzul | Überschlägiger Belastungswert
c12 | Kopfspiel 1,2
c34 | Kopfspiel 3,4
c12neu | Kopfspiel 1,2 nach Verschiebung
d1 - d4 | Teilkreisdurchmesser Z1 bis Z4
da1 - da4 | Kopfkreisdurchmesser Z1 bis Z4
db1 - db4 | Grundkreisdurchmesser Z1 bis Z4
df1 - df4 | Fußkreisdurchmesser Z1 bis Z4
dmin1 - dmin3 | Mindestdurchmesser Welle 1 bis 3
dW1 - dW3 | gewählter Wellendurchmesser 1 bis 3
dwd1 - dwd4 | Betriebswälzkreisdurchmesser 1 bis 4
FB | Axiale Bohrkraft
i12 | Übersetzungsverhältnis 1,2
i34 | Übersetzungsverhältnis 3,4
iges | Gesamtübersetzungsverhältnis
k | Kopfhöhenänderung
KA | Belastungsfaktor
l t1 - lt3 | Tragende Passfederlänge 1 bis 3
lP1 - lP3 | Gesamtlänge der Passfeder 1 bis 3
mn12 | Modul 1,2
mn34 | Modul 3,4
mt12 | Stirnmodul 1,2
mt34 | Stirnmodul 3,4
nan | Antriebsdrehzahl
nab | Abtriebsdrehzahl
nP | Anzahl Passfedern pro Verbindung
nS | Schaltdrehzahl Fliehkraftkupplung
pFzul | Zulässige Flächenpressung
Pv | Differenz Achsabstände
Re | Streckgrenze von E295
SF | Sicherheit Fließgrenze
Tan | Antriebsdrehmoment
Tab1 | Abtriebsdrehmoment Vorgabe
Tab2 | Abtriebsdrehmoment Ausarbeitung
Daniel Skrypnikov | Edis Duvnjak | Marvin Müller

Maschinenelemente Entwurf 3 Jade Hochschule Wilhelmshaven

t1;W1 - t1;W3 | Wellen Nuttiefe
V1 - V4 | Verschiebung 1 bis 4
Σx | Summe von x1 und x2
x1 / x2 | Variablen zur Verschiebung
z1 - z4 | Zähnezahl Zahnrad 1 bis 4
zn1 / zn2 | Ersatzzähnezahl 1 und 2
αn | Normaleingriffswinkel
αt | Stirneingriffswinkel
αwt | Betriebseingriffswinkel
invαwt | Profilverschiebung
invαt | Profilverschiebung
β | Schrägungswinkel
βb | Grundschrägungswinkel
Ɛα12 | Profilüberdeckung 1,2
Ɛα34 | Profilüberdeckung 3,4
Ɛβ12 | Sprungüberdeckung 1,2
Ɛβ34 | Sprungüberdeckung 3,4
Ɛγ12 | Gesamtüberdeckung 1,2
Ɛγ34 | Gesamtüberdeckung 3,4
φ | Traganteil der Passfeder
τtzul | Dauerfestigkeitsschubspannung von 42CrMo4
Daniel Skrypnikov | Edis Duvnjak | Marvin Müller
