Marvin20212/Gruppe9_ME3E/Entwurf alt (Lars)/ME3-Entwurf/Testat 2/Deckblatt_Testat_2.docx

2-stufiges schrägverzahntes koaxiales Getriebe

Abgabe Testat 2 Gruppe 4 – 18.01.2022

Prof. Dr. Lindner
