Marvin20212/Gruppe9_ME3E/Entwurf alt (Lars)/ME3-Entwurf/Testat 3/Neuer Ordner/Deckblatt_Testat_3.docx

2-stufiges schrägverzahntes koaxiales Getriebe

Abgabe Testat 3 Gruppe 4 – 17.02.2022

Prof. Dr. Lindner
