Marvin20212/Gruppe9_ME3E/Testat 1/Vorarbeit Testat 1/Entwurf-skizze neu.pdf

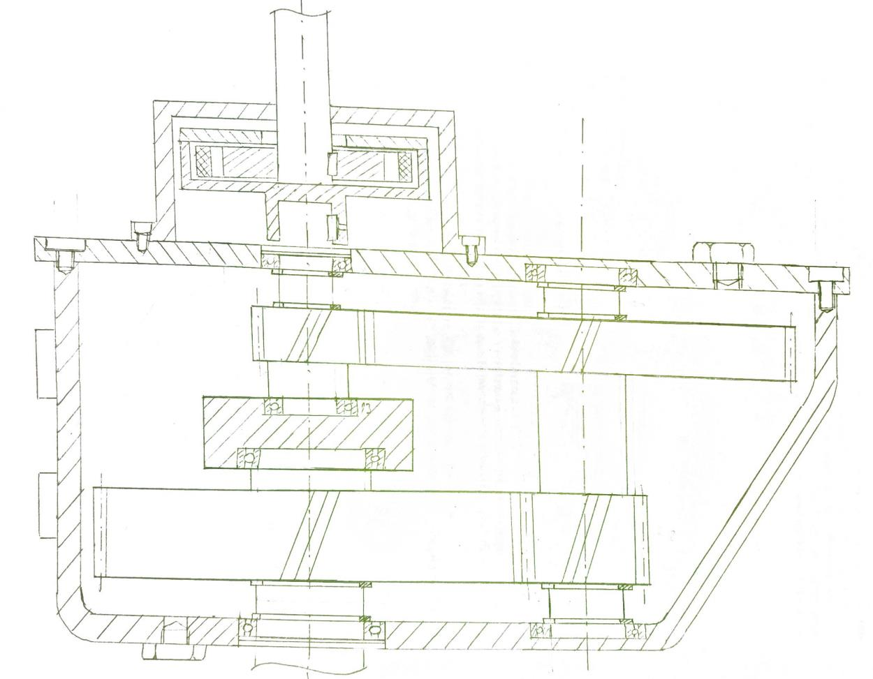
[picture p153: page 1]
