Marvin20212/Gruppe9_ME3E/Testat 1/Vorarbeit Testat 1/Entwurf-Skizze (nochmal selbe Datei).pdf

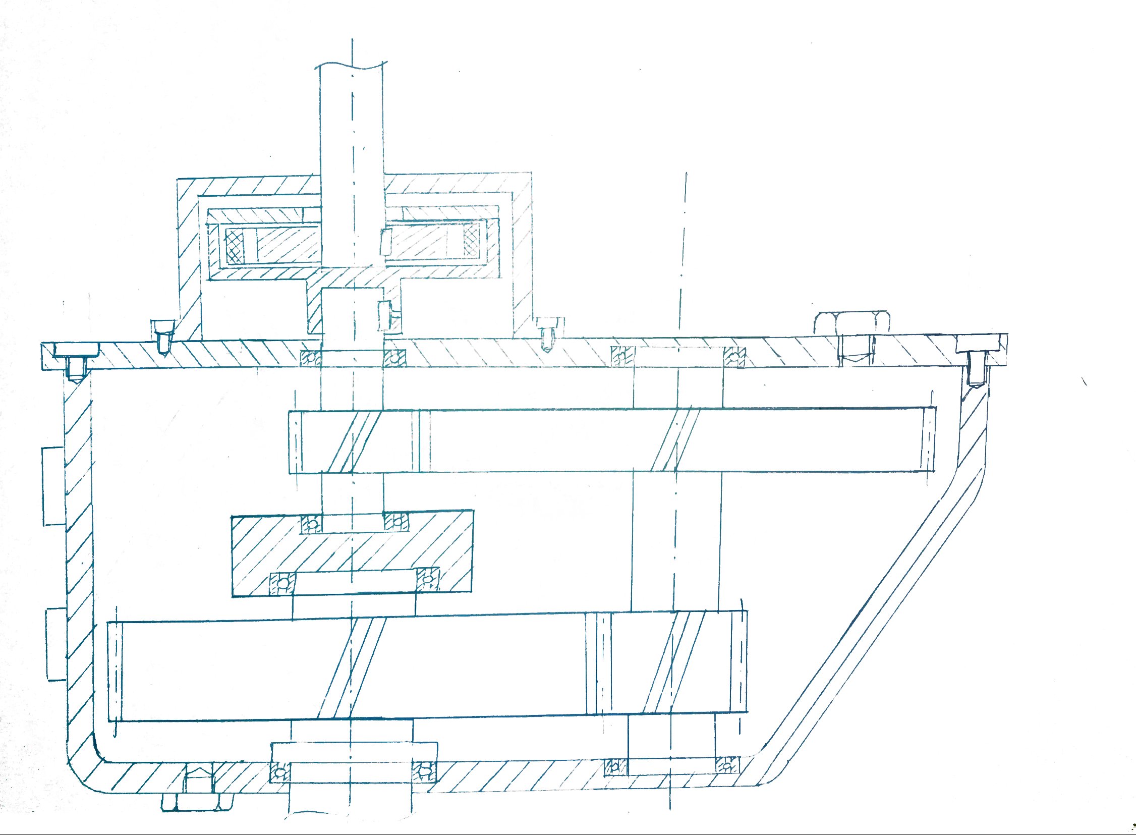
[picture p154: figure]
