Marvin20212/Gruppe9_ME3E/Entwurf alt (Lars)/ME3-Entwurf/Testat 3/Deckblatt_Testat_3.pdf

Maschinenelemente 3 Entwurf Jade Hochschule Wilhelmshaven

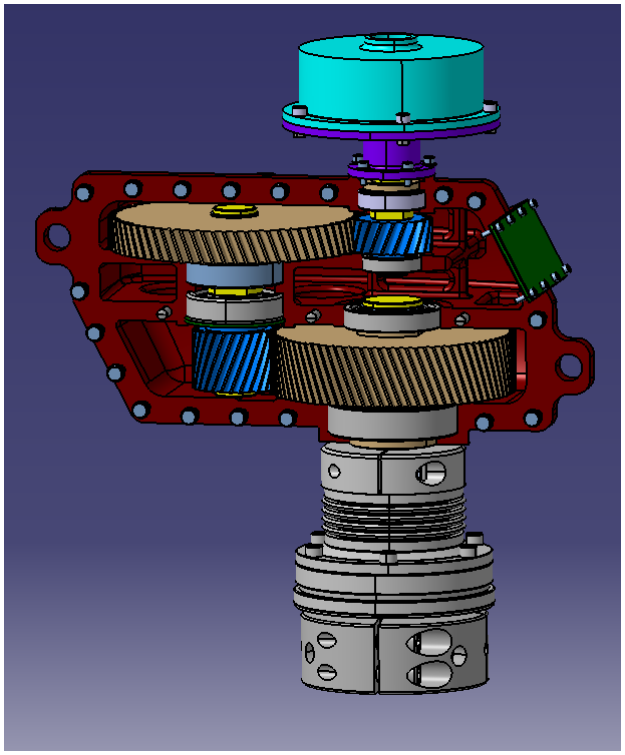
[picture p212: figure]

Claas Lübbers, Niklas Hollmann, Lars Stanislawski

### 2-stufiges schrägverzahntes koaxiales Getriebe

### Abgabe Testat 3 Gruppe 4 – 16.02.2022

### Prof. Dr. Lindner
