Marvin20212/Gruppe9_ME3E/Entwurf alt (Lars)/ME3-Entwurf/Testat 3/Prinzipskizze.pdf

Maschinenelemente 3 Entwurf Jade Hochschule Wilhelmshaven


Claas Lübbers, Niklas Hollmann, Lars Stanislawski

### Prinzip-Skizze
