Marvin20212/Gruppe9_ME3E/Entwurf alt (Lars)/ME3-Entwurf/Testat 3/Vorgelegewelle.pdf

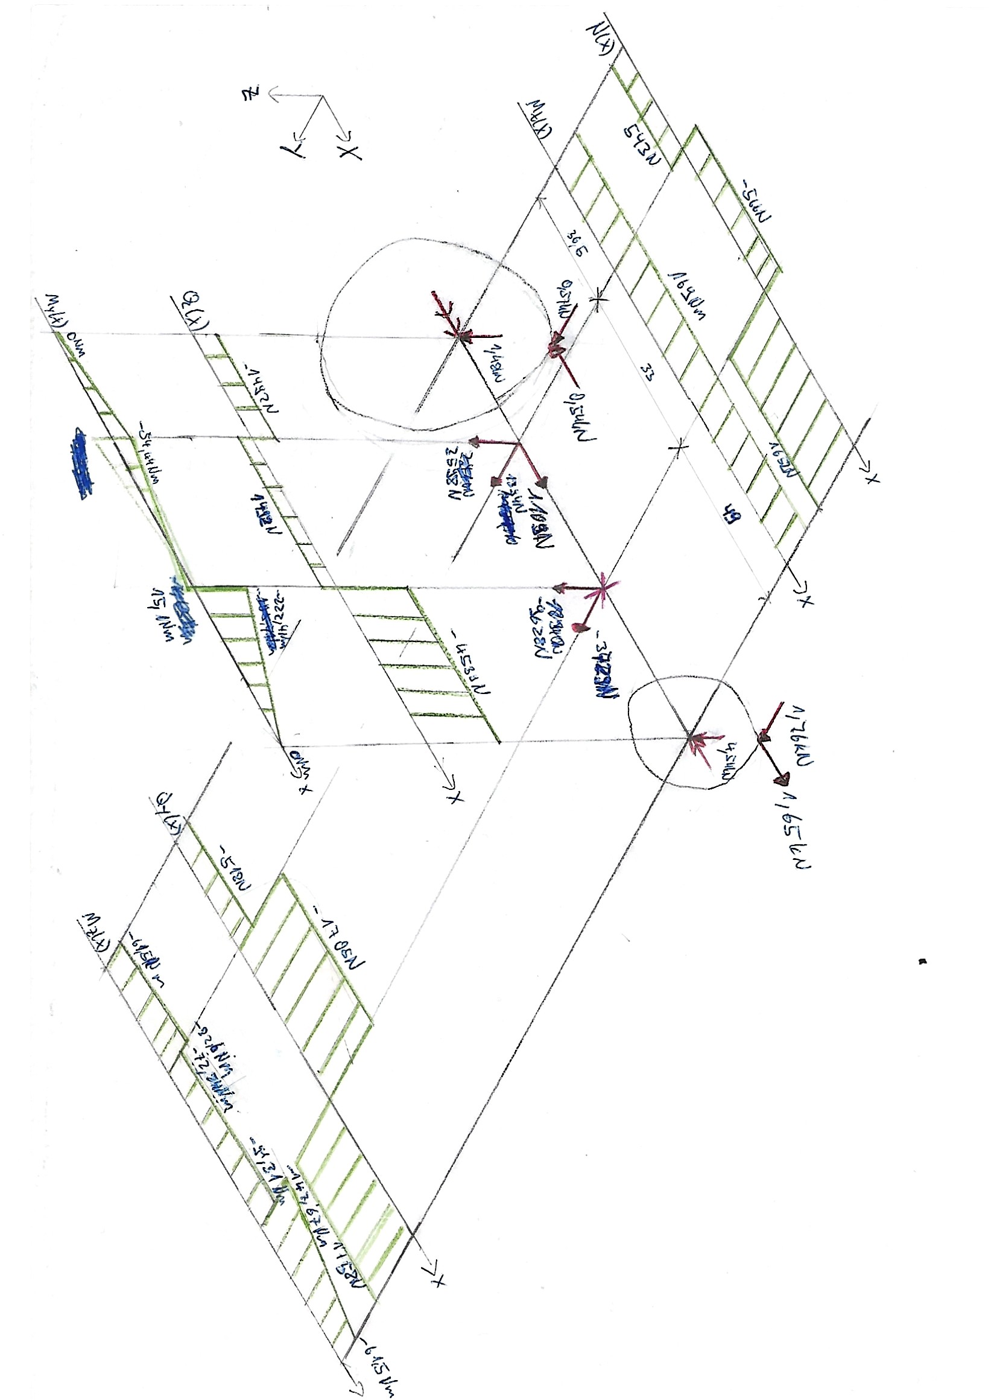
[picture p213: page 1]
