Marvin20212/Gruppe9_ME3E/Entwurf alt (Lars)/ME3-Entwurf/Berechnungen/MATHCAD/Testat1.pdf

Maschinenelemte 3 Entwurf
Jade Hochschule Wilhelmshaven

### 2-stufiges schrägverzahntes koaxiales Getriebe

Alle im Folgenden auftretenden Angaben zu Seitenzahlen, Tabellen und Gleichungen beziehen sich auf "Roloff/Matek Maschinenelemente (24. Auflage)"

Konstanten per Vorgabe

Drehmoment Antrieb | Tan≔50 N ⋅m
Drehmoment Abtrieb | Tab≔500 N ⋅m
Antriebsdrehzahl | nan≔2000 | min ⁻¹
axiale Abtriebskraft | FB≔3 kN
Verzahnungsschrägungswinkel | β≔20 °
Normaleingriffswinkel | αn≔20 | °

Dauerfestigkeitsschubspannung von
42CrMo4 (Wellenstahl)

τtzul≔50 ―N―mm²

Überschlägiger Belastungswert | Bzul≔4 | ―N―mm²
Anwendungsfaktor | KA≔2

theoretisches Übersetzungsverhältnis

iges≔――=

Tab

Tan

### 10 i12≔3.4

i23≔――=

iges

i12

2.941 iges≔i12 ⋅i23=10
gewählt nach TB21-11
Ritzelzähnezahlen
z1≔21 | z2≔z1
⋅i12=71.4 | z2≔71 | orientiert an TB21-12
z3≔28 | z4≔z3
⋅i23=82 | z4≔83 | Da ggT>1 wurde die
Ritzelzähnezahl um +1
erhöht
wirkliches Übersetzungsverhältnis

i12≔―=

z2
z1

3.381 i23≔―=

z4
z3

2.964 iges≔i12 ⋅i23=10.022

Tab≔Tan ⋅iges=501.105 N ⋅m

――――=

500 ⋅N ⋅m

Tab

0.998 Abweichung von 0,2% vom geforderten Abtriebsdrehmoment

Claas Lübbers, Niklas Hollmann, Lars Stanislawski | Seite 1 von 30

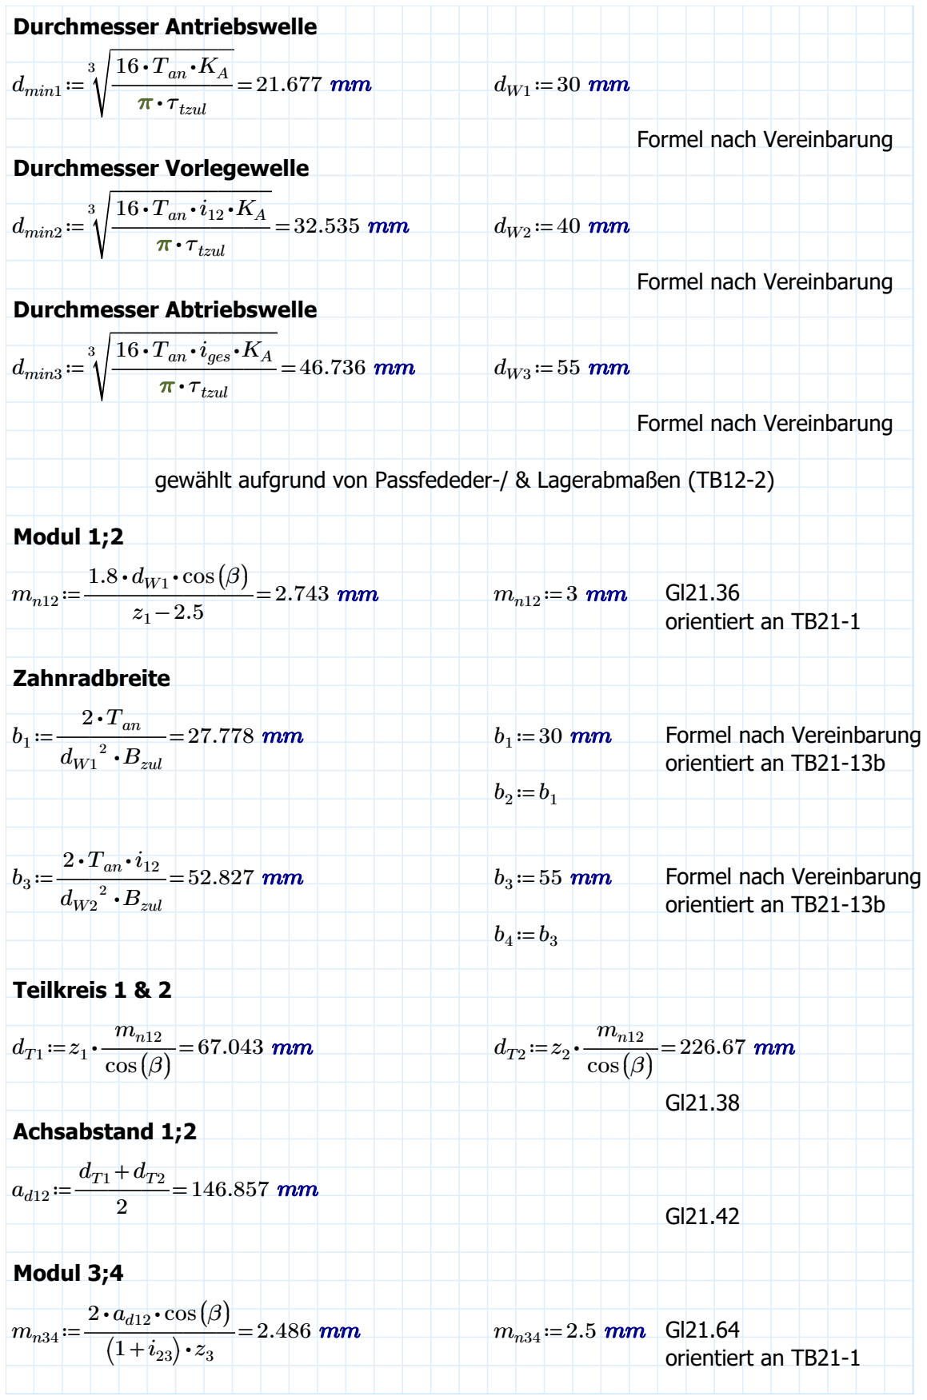
[picture p214: figure]
Durchmesser Antriebswelle; dmin1≔; π⋅τtzul; Formel nach Vereinbarung; Durchmesser Vorlegewelle; dmin2≔; Durchmesser Abtriebswelle; dmin3≔; ⋅ an iges; Modul 1;2; 1.8 ⋅dW1 ⋅ cos ((β)) z1-2.5; orientiert an TB21-1; Zahnradbreite; 2 ⋅Tan dW1 ⋅; 2 Bzul; orientiert an TB21-13b; Teilkreis 1 & 2; mn12 cos ((β)); Achsabstand 1;2; Modul 3;4; ⋅ d12 cos ((β))

gewählt aufgrund von Passfededer-/ & Lagerabmaßen (TB12-2)

Claas Lübbers, Niklas Hollmann, Lars Stanislawski | Seite 2 von 30

Teilkreis 3 & 4; mn34 cos ((β)); Achsabstand 3;4; ad12≠aad34; Stirneingreifswinkel; αt≔atan; tan⎛⎝αn; ⎞ ⎠ cos ((β)); Betriebseingriffswinkel; αw≔acos; cos ⎛; Summe Profilverschiebungsfaktoren; invαw≔tan⎛⎝αw; invαt≔tan⎛⎝αt; invαw -invαt 2 ⋅ tan⎛⎝αn; Ersatzzähnezahlen; βb≔acos; cos ((β)) ⋅―――; cos ⎛⎝αn; cos ⎛⎝αt; cos ⎛⎝βb; vgl. mit Additionstheorem; xyz≔―; ⎛⎝1+cos ⎛⎝2 ⋅βb; cos ((β))

Fazit: Es ist eine Profilverschiebung notwendig, um die Differenz der Achsabstände auszugleichen! Es wird eine positive Profilverschiebung gewählt, um den Zahnfuß zu stärken und die Tragfähigkeit der Zähne zu erhöhen.

Claas Lübbers, Niklas Hollmann, Lars Stanislawski | Seite 3 von 30

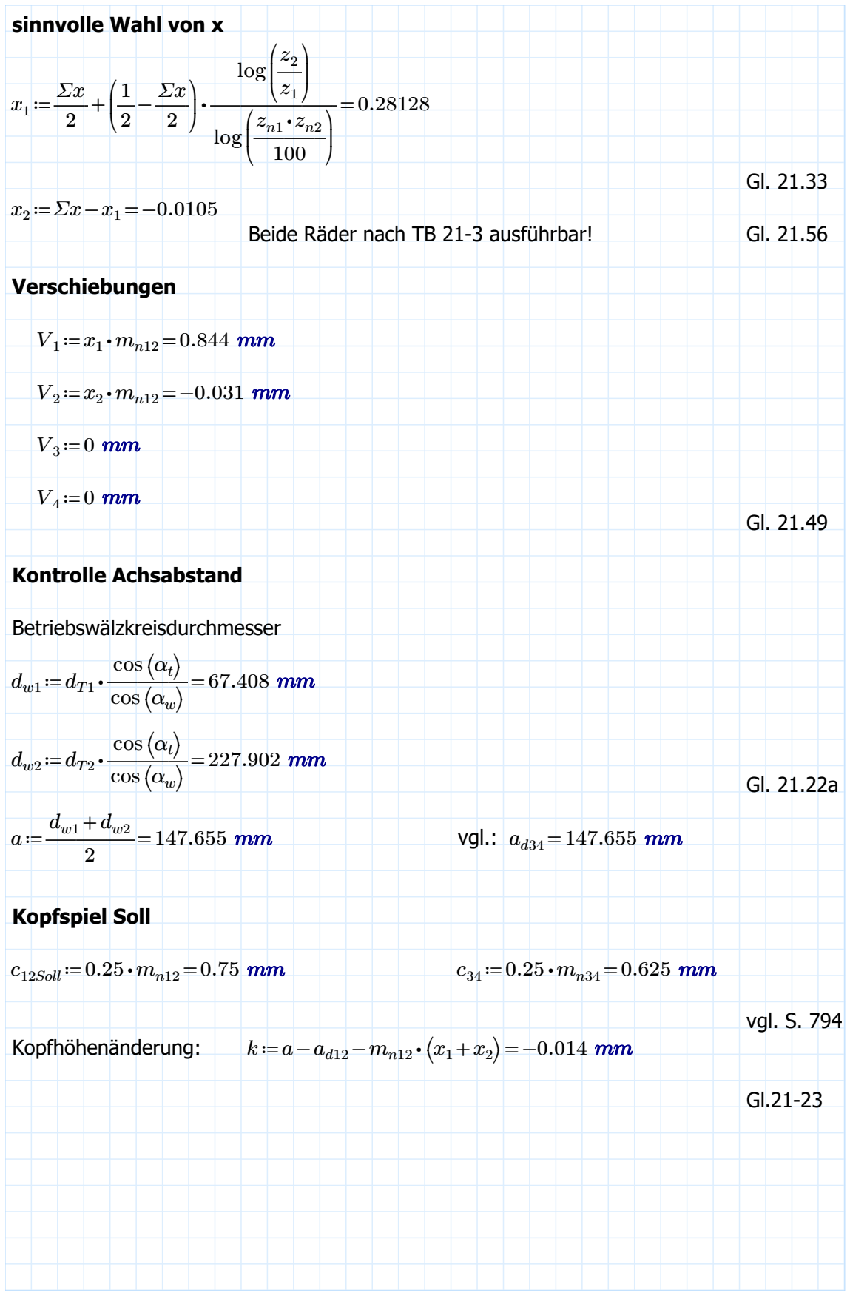
[picture p215: figure]
sinnvolle Wahl von x; log; Verschiebungen; Kontrolle Achsabstand; Betriebswälzkreisdurchmesser; cos ⎛⎝αt; ⎞ ⎠ cos ⎛⎝αw; vgl.:; Kopfspiel Soll; c12Soll≔0.25 ⋅mn12=0.75; vgl. S. 794; Kopfhöhenänderung:

Beide Räder nach TB 21-3 ausführbar! | Gl. 21.56
Claas Lübbers, Niklas Hollmann, Lars Stanislawski | Seite 4 von 30

Zahnräder

Zahnrad Nr.1:

dT1=67.043 mm

Betriebswälzkreisdurchmesser | dw1≔―――⋅ | =

2 ⋅ z1
z1+z2
a | 67.408 | mm | Gl.21-22a
Grundkreisdurchmesser | db1≔z1
⋅―――――=

m ⋅ n12 cos ⎛⎝αt

⎞
⎠
cos ((β))
62.517 mm | Gl.21-39
Kopfkreisdurchmesser | da1≔dT1+2 ⋅ ⎛⎝mn12+V1+k⎞
⎠=74.702 mm | Gl.21-24
Fußkreisdurchmesser | df1≔dT1-2 ⋅ ⎛⎝

⎛⎝mn12+c12Soll⎞
⎠-V1

⎞
⎠=61.231 mm Gl.21-25

Zahnrad Nr.2:

dT2=226.67 mm

dw2≔―――⋅ =

2 ⋅ z2
z1+z2
a | 227.902 mm | Gl.21-22b

db2≔z2

⋅―――――=

m | ⋅ n12 | cos ⎛⎝αt

⎞
⎠
cos ((β))
211.369 | mm | Gl.21-39

da2≔dT2+2 ⋅ ⎛⎝mn12+V2+k⎞
⎠=232.578 | mm | Gl.21-24

df2≔dT2-2 ⋅ ⎛⎝

⎛⎝mn12+c12Soll⎞
⎠-V2

⎞
⎠=219.107 | mm | Gl.21-25

Zahnrad Nr.3:

dT3=74.492 mm

dw3≔―――⋅ =

2 ⋅ z3
z3+z4
a | 74.492 | mm | Gl.21-22a

db3≔z3

⋅―――――=

m | ⋅ n34 | cos ⎛⎝αt

⎞
⎠
cos ((β))
69.464 mm | Gl.21-39

da3≔dT3+2 ⋅ ⎛⎝mn34+V2+k⎞
⎠=79.401 mm | Gl.21-40
df3≔dT3-2.5 ⋅mn34=68.242 mm | Gl.21-41
Claas Lübbers, Niklas Hollmann, Lars Stanislawski | Seite 5 von 30

Zahnrad Nr.4:; cos ⎛⎝αt; cos ((β)); Kopfspiel nach Profilverschiebung; c12Ist≔a-0.5 ⋅ ⎛⎝da1+df2⎞; c12Soll-c12Ist=-6.505 ⋅ 10⁻¹⁶ mm; Keine relevante Abweichung!; vgl. S. 794; Stirnmodul; mn12 cos ((β)); mn34 cos ((β)); Profilüberdeckung; a⋅ sin⎛⎝αw; Laut S.787 ist der Wert für ε gut. α; ⋅ 1 sin((β)); Gesamt:; ⋅ 3 sin((β))

Claas Lübbers, Niklas Hollmann, Lars Stanislawski | Seite 6 von 30

Zusammenfassung; Zahnrad_1; Zahnrad_2; Zahnrad_3; Zahnrad_4; Passfederverbindungen; Material der Passfeder: E295; Re≔295 ⋅―N―mm²; ηzul≔―=; 268.182 ―N―mm²; 2 ⋅Tan; ⋅ zul

Antriebswelle: Passfeder DIN 6885 - A8x7x14

Vorlegewelle: Passfeder DIN 6885 - A12x8x25

Abtriebswelle: Passfeder DIN 6885 - A16x10x36

Claas Lübbers, Niklas Hollmann, Lars Stanislawski | Seite 7 von 30

Kräfte an den Zahnrädern

Zahnrad 1:
Umfangskraft: | Ft1≔2 ⋅――= Tan dT1
| 1.492 kN | | Gl.21.70
Radialkraft: | FR1≔――――=
F | ⋅ t1 | tan⎛⎝αn
| ⎞ ⎠ cos ((β))
0.578 | kN | Gl.21.71
Axialkraft: | Fa1≔Ft1 ⋅ tan((β))=0.543 | kN | Gl.21.72

Zahnrad 2:

Umfangskraft: | Ft2≔| |Ft1| |=1.492 kN
Radialkraft: | FR2≔| |FR1|
|=0.578 | kN
Axialkraft: | Fa2≔| |Fa1| |=0.543 kN

Zahnrad 3:
Umfangskraft: | Ft3≔2 ⋅―――= T ⋅ an i12 dT3
4.539 kN
Radialkraft: | FR3≔――――=
F | ⋅ t3 | tan⎛⎝αn
| ⎞ ⎠ cos ((β))
1.758 kN
Axialkraft: | Fa3≔Ft3 ⋅ tan((β))=1.652 | kN

Zahnrad 4:

Umfangskraft: | Ft4≔| |Ft3| |=4.539 kN
Radialkraft: | FR4≔| |FR3|
|=1.758 | kN
Axialkraft: | Fa4≔| |Fa3| |=1.652 kN

Es werden hier nur die Beträge der Kräfte aufgeführt, die Orientierungen der Kräfte werden in den Berechnungen der Lagerkräfte passend (d.h entgegengesetzt) angenommen (siehe Freischnitte & Schnittverläufe der drei Wellen).

Claas Lübbers, Niklas Hollmann, Lars Stanislawski | Seite 8 von 30

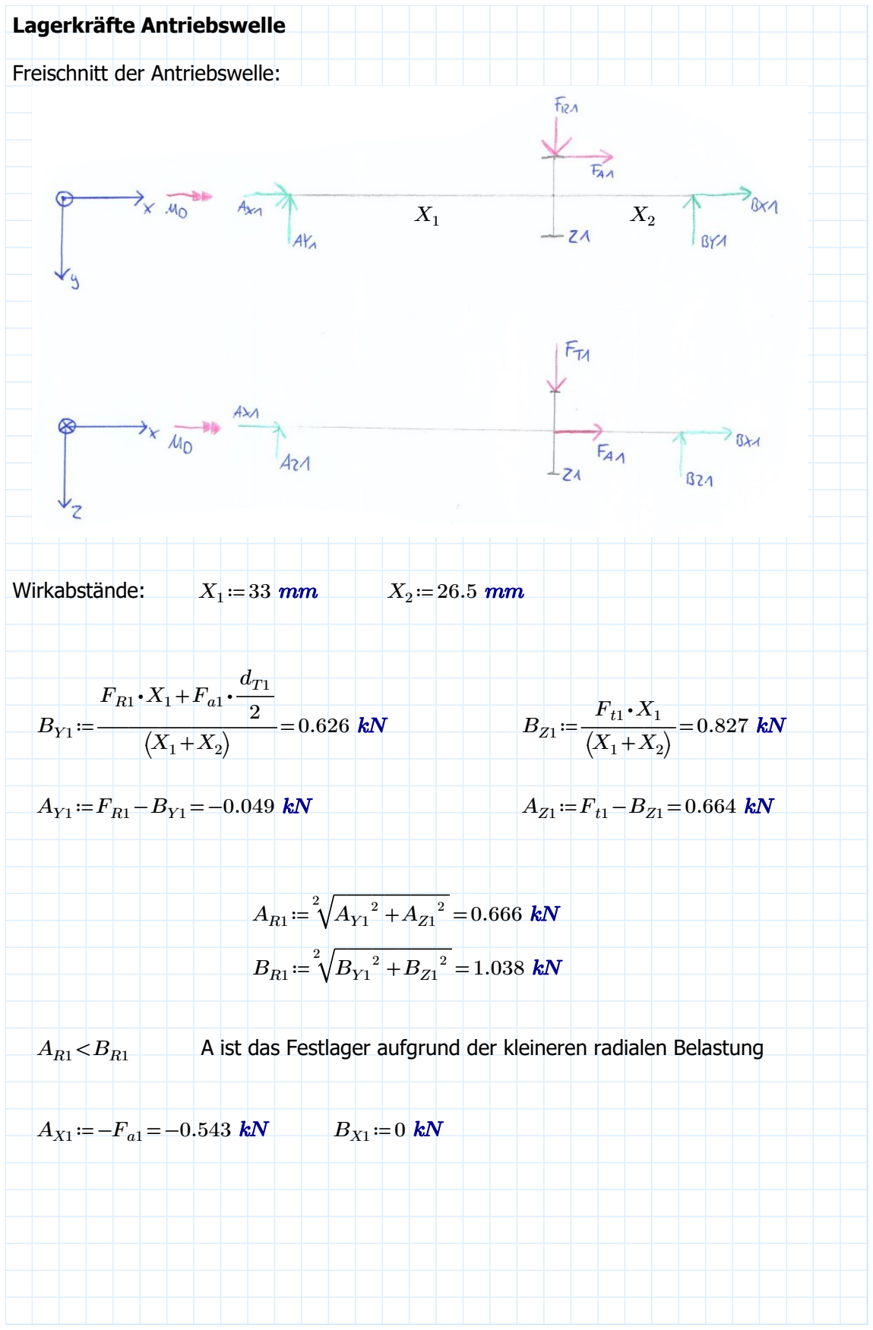
[picture p216: figure]
Lagerkräfte Antriebswelle; Freischnitt der Antriebswelle:; Wirkabstände:

AR1<BR1 | A ist das Festlager aufgrund der kleineren radialen Belastung
Claas Lübbers, Niklas Hollmann, Lars Stanislawski | Seite 9 von 30

Schnittgrößenverläufe Antriebswelle

Berechnung für XY-Ebene:


s1max≔X1=33 mm | s1min≔0 mm | s2max≔X2=26.5 | mm | s2min≔0 mm

positives Schnittufer

FN≔-AX1=0.543 | kN
FQY≔AY1=-0.049 | kN
MBZ ((x))≔AY1 ⋅ s1 | MBZmin ((x))≔AY1 ⋅ s1min=0 N·m
MBZmax ((x))≔AY1 ⋅ s1max=-1.602 N·m

negatives Schnittufer

FN≔0

FQY≔-BY1=-0.626 | kN
MBZ ((x))≔BY1 ⋅ s2 | MBZmin ((x))≔BY1 ⋅ s2min=0 N·m

MBZmax ((x))≔BY1 ⋅ s2max=16.596 N·m

Claas Lübbers, Niklas Hollmann, Lars Stanislawski | Seite 10 von 30

Berechnung für XZ-Ebene:


positives Schnittufer

FQZ≔AZ1=0.664 kN

MBY ((x))≔A | ⋅ Z1 s1 | MBYmin ((x))≔AZ1 ⋅ s1min=0 N ⋅m MBYmax ((x))≔AZ1 ⋅ s1max=21.922 N ⋅m

negatives Schnittufer

FQZ≔-BZ1=-0.827 kN

MBY ((x))≔B | ⋅ Z1 s1 | MBYmin ((x))≔BZ1 ⋅ s2min=0 N ⋅m MBYmax ((x))≔BZ1 ⋅ s2max=21.922 N ⋅m
MBmax1≔ | =

2
⎛⎝MBYmax⎞
⎠ +

2 ⎛⎝MBZmax⎞
⎠

2 27.496 N ⋅m

mit | MBYmax=21.922 N ⋅m | und | MBZmax=16.596 N ⋅m

Der Maximalwert wurde hier entsprechend der Schwachstelle der Welle (mit einem pinken "X" in der Isometrie-Ansicht markiert) für die folgende Festigkeitsberechnung ermittelt

Claas Lübbers, Niklas Hollmann, Lars Stanislawski | Seite 11 von 30

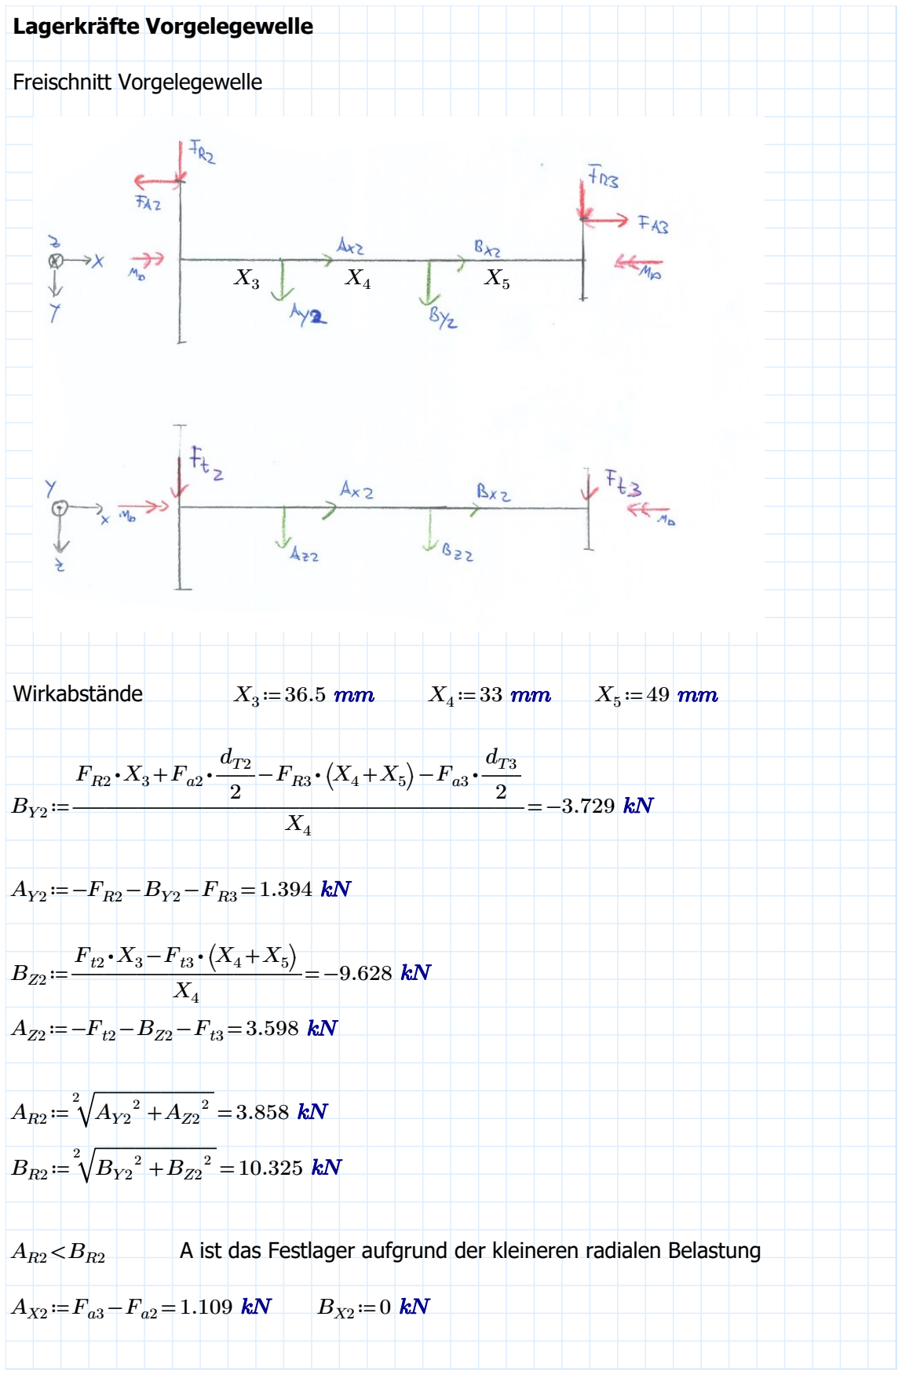
[picture p217: figure]
Lagerkräfte Vorgelegewelle; Freischnitt Vorgelegewelle; Wirkabstände

AR2<BR2 | A ist das Festlager aufgrund der kleineren radialen Belastung
Claas Lübbers, Niklas Hollmann, Lars Stanislawski | Seite 12 von 30

Schnittgrößenverläufe Vorgelegewelle

s3max≔X3=36.5 | mm | s3min≔0 ⋅mm
s4max≔X4=33 mm | s4min≔0 mm
s5max≔X5=49 mm | s5min≔0 mm

Berechnung für XZ-Ebene:


### 1. positives Schnittufer

FN≔Fa2=0.543 kN

FQY≔-FR2=-0.578 kN

MBZ ((x))≔-FR2 ⋅ s3-F ⋅ a2 ――

dT2
2
MBZmin ((x))≔-FR2 ⋅ s3min-Fa2 ⋅――=

dT2
2

-61.528 N ⋅m

MBZmax ((x))≔-FR2 ⋅ s3max-Fa2 ⋅――=

dT2
2

-82.615 N ⋅m

Claas Lübbers, Niklas Hollmann, Lars Stanislawski | Seite 13 von 30

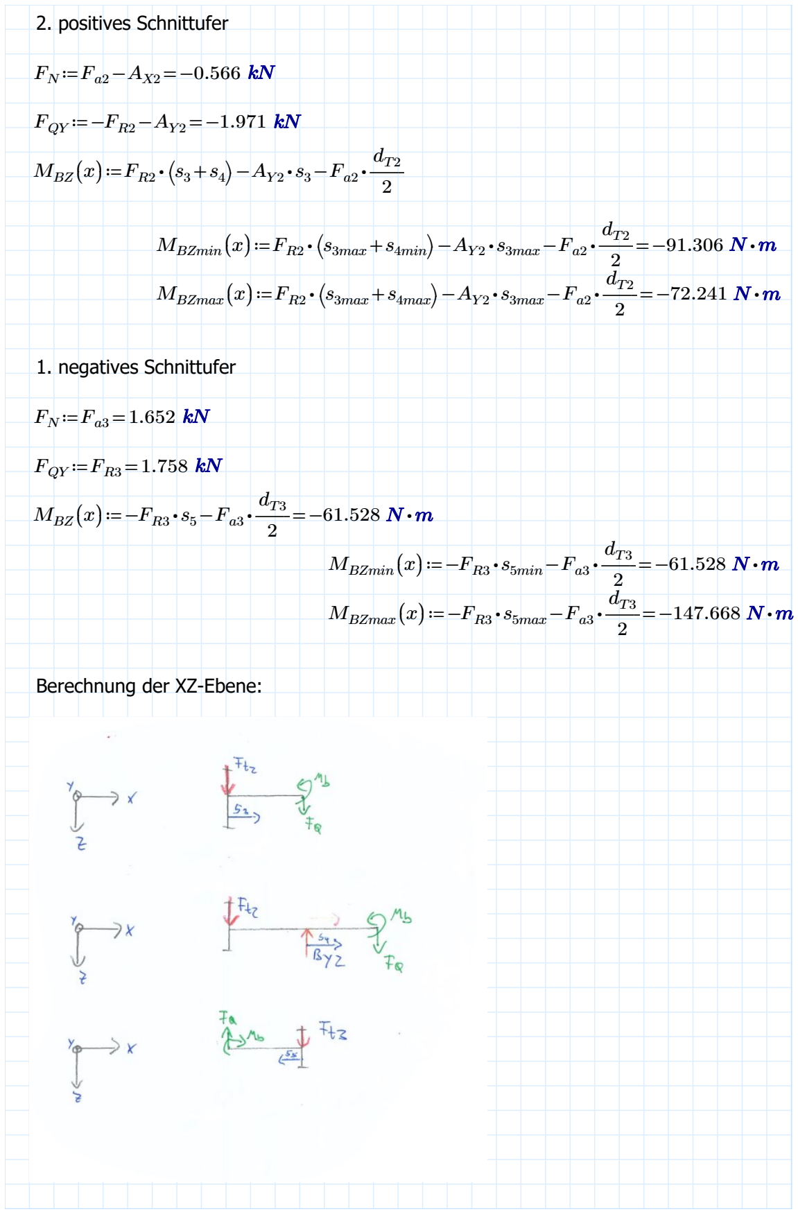
[picture p218: figure]
2. positives Schnittufer; FQY≔-FR2-AY2=-1.971 kN; MBZ ((x))≔FR2 ⋅ ⎛⎝s3+s4; MBZmin ((x))≔FR2 ⋅ ⎛⎝s3max+s4min⎞ ⎠-AY2 ⋅ s3max-Fa2 ⋅――=; MBZmax ((x))≔FR2 ⋅ ⎛⎝s3max+s4max⎞ ⎠-AY2 ⋅ s3max-Fa2 ⋅――=; 1. negatives Schnittufer; FQY≔FR3=1.758 kN; MBZ ((x))≔-FR3 ⋅ s5-Fa3 ⋅――=; MBZmin ((x))≔-FR3 ⋅ s5min-Fa3 ⋅――=; MBZmax ((x))≔-FR3 ⋅ s5max-Fa3 ⋅――=; Berechnung der XZ-Ebene:

Claas Lübbers, Niklas Hollmann, Lars Stanislawski | Seite 14 von 30

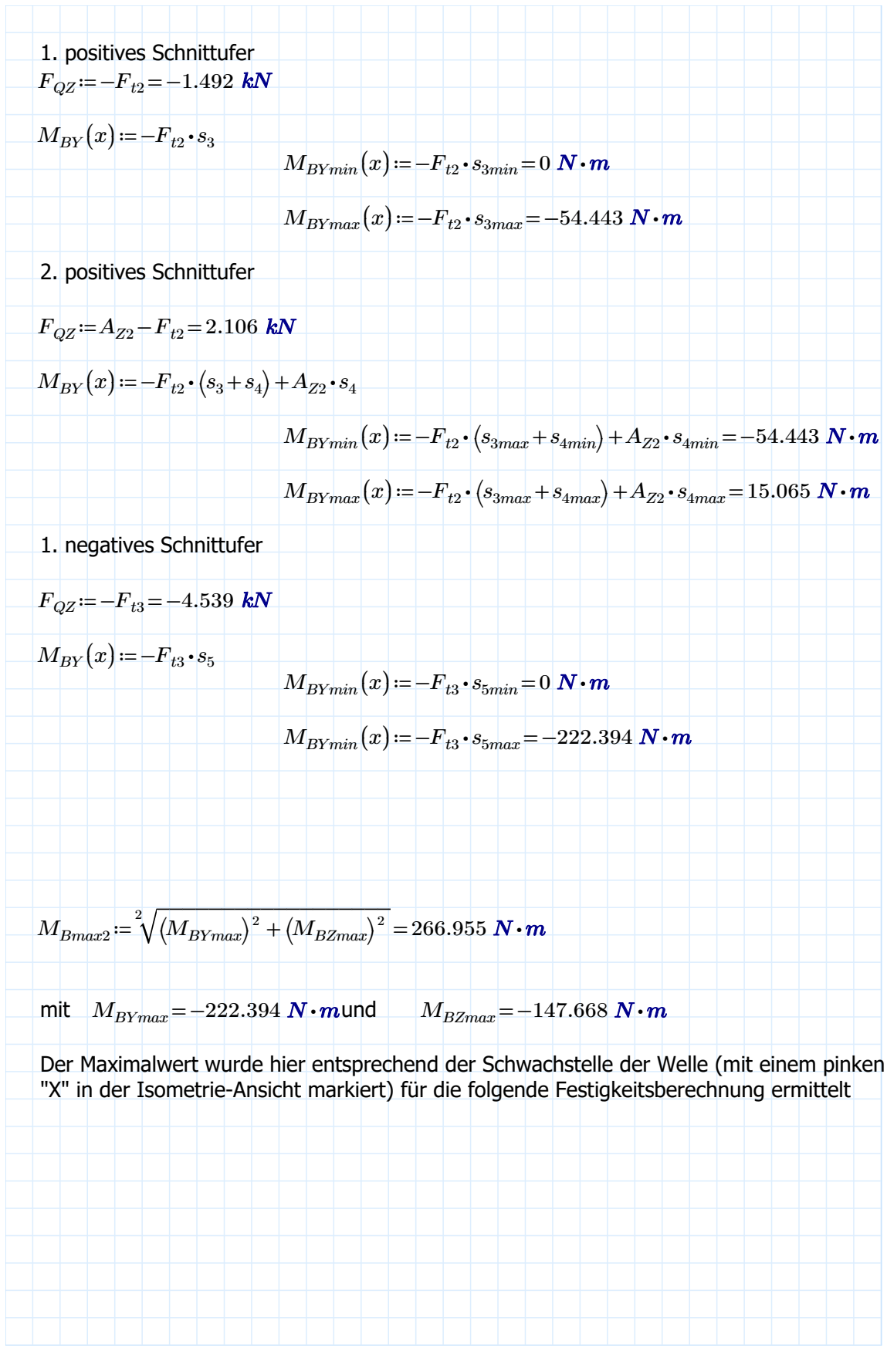
[picture p219: figure]
1. positives Schnittufer FQZ≔-Ft2=-1.492 kN; MBY ((x))≔-F; MBYmin ((x))≔-Ft2 ⋅ s3min=0 N ⋅m; MBYmax ((x))≔-Ft2 ⋅ s3max=-54.443 N ⋅m; 2. positives Schnittufer; FQZ≔AZ2-Ft2=2.106 kN; MBY ((x))≔-Ft2 ⋅ ⎛⎝s3+s4; MBYmin ((x))≔-Ft2 ⋅ ⎛⎝s3max+s4min⎞ ⎠+AZ2 ⋅ s4min=-54.443 N ⋅m; MBYmax ((x))≔-Ft2 ⋅ ⎛⎝s3max+s4max⎞ ⎠+AZ2 ⋅ s4max=15.065 N ⋅m; 1. negatives Schnittufer; FQZ≔-Ft3=-4.539 kN; MBYmin ((x))≔-Ft3 ⋅ s5min=0 N ⋅m; MBYmin ((x))≔-Ft3 ⋅ s5max=-222.394 N ⋅m; MBmax2≔; ⎛⎝MBYmax⎞; 2 ⎛⎝MBZmax⎞ ⎠

mit | MBYmax=-222.394 N ⋅mund | MBZmax=-147.668 N ⋅m

Der Maximalwert wurde hier entsprechend der Schwachstelle der Welle (mit einem pinken "X" in der Isometrie-Ansicht markiert) für die folgende Festigkeitsberechnung ermittelt

Claas Lübbers, Niklas Hollmann, Lars Stanislawski | Seite 15 von 30

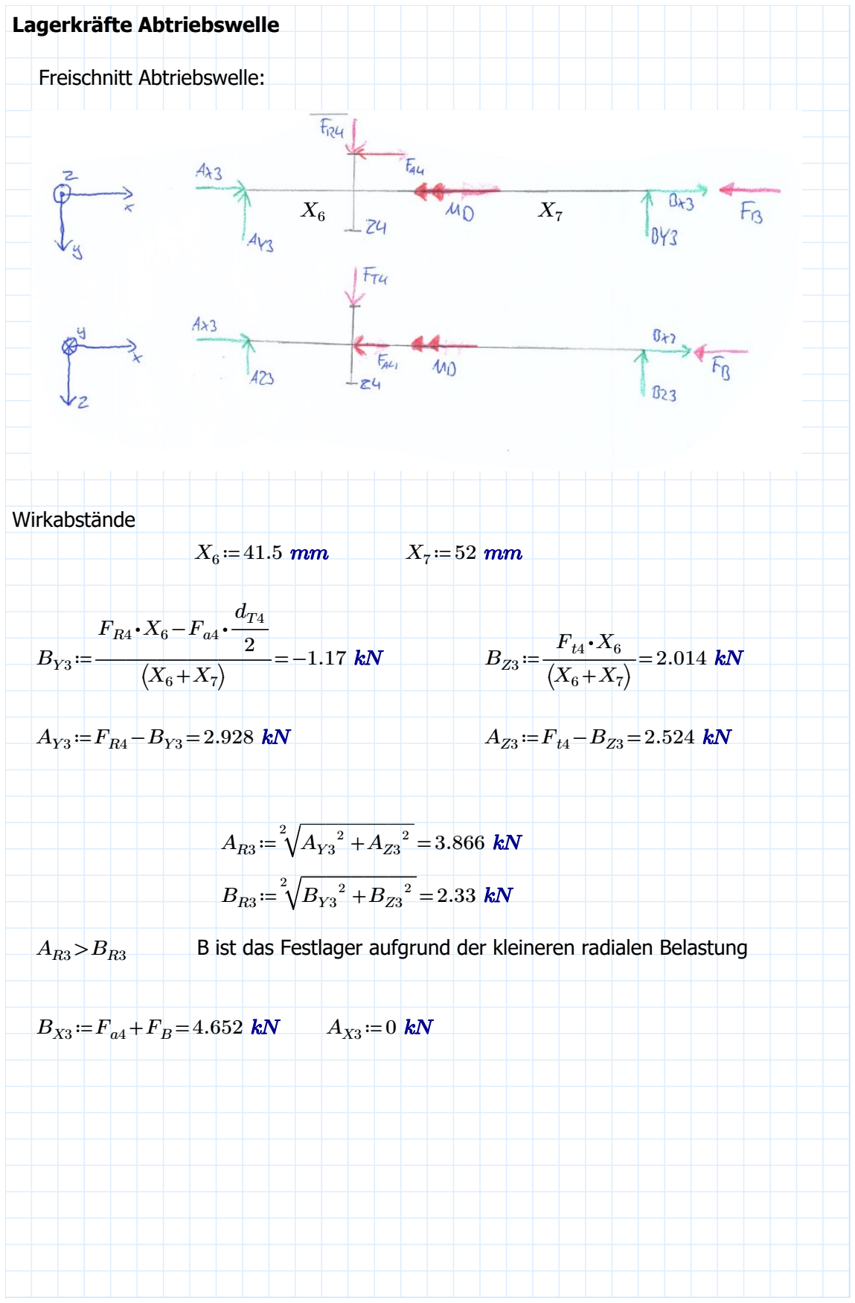
[picture p220: figure]
Lagerkräfte Abtriebswelle; Freischnitt Abtriebswelle:; Wirkabstände

AR3>BR3 | B ist das Festlager aufgrund der kleineren radialen Belastung
Claas Lübbers, Niklas Hollmann, Lars Stanislawski | Seite 16 von 30

Schnittgrößenverläufe Abtriebswelle

Berechnung der XY-Ebene:


s6max≔X6=41.5 | mm | s6min≔0 mm | s7max≔X7=52 mm | s7min≔0 mm

positives Schnittufer:

FN≔0

FQY≔AY3=2.928 kN

MBZ ((x))≔AY3 ⋅ s6 | MBZmin ((x))≔AY3 ⋅ s6min=0 N·m
MBZmax ((x))≔AY3 ⋅ s6max=121.527 N·m

negatives Schnittufer:

FN≔BX3-FB =1.652 | kN
FQY≔-BY3=1.17 | kN
MBZ ((x))≔BY3 ⋅ s7 | MBZmin ((x))≔BY3 ⋅ s7min=0 N·m
MBZmax ((x))≔BY3 ⋅ s7max=-60.861 N·m
Claas Lübbers, Niklas Hollmann, Lars Stanislawski | Seite 17 von 30

Berechnung der XZ-Ebene:


positives Schnittufer

FQZ≔AZ3=2.524 kN

MBY ((x))≔A | ⋅ Z3 s6 | MBYmin ((x))≔AZ3 ⋅ s6min=0 N ⋅m MBYmax ((x))≔AZ3 ⋅ s6max=104.753 N ⋅m

negatives Schnittufer

FQZ≔-BZ3=-2.014 kN

MBY ((x))≔B | ⋅ Z3 s7 | MBYmin ((x))≔BZ3 ⋅ s7min=0 N ⋅m MBYmax ((x))≔BZ3 ⋅ s7max=104.753 N ⋅m
MBmax3≔ | =

2
⎛⎝MBYmax⎞
⎠ +

2 ⎛⎝MBZmax⎞
⎠

2 121.15 N ⋅m

mit | MBYmax=104.753 N ⋅m | und | MBZmax=-60.861 N ⋅m

Der Maximalwert wurde hier entsprechend der Schwachstelle der Welle (mit einem pinken "X" in der Isometrie-Ansicht markiert) für die folgende Festigkeitsberechnung ermittelt

Claas Lübbers, Niklas Hollmann, Lars Stanislawski | Seite 18 von 30

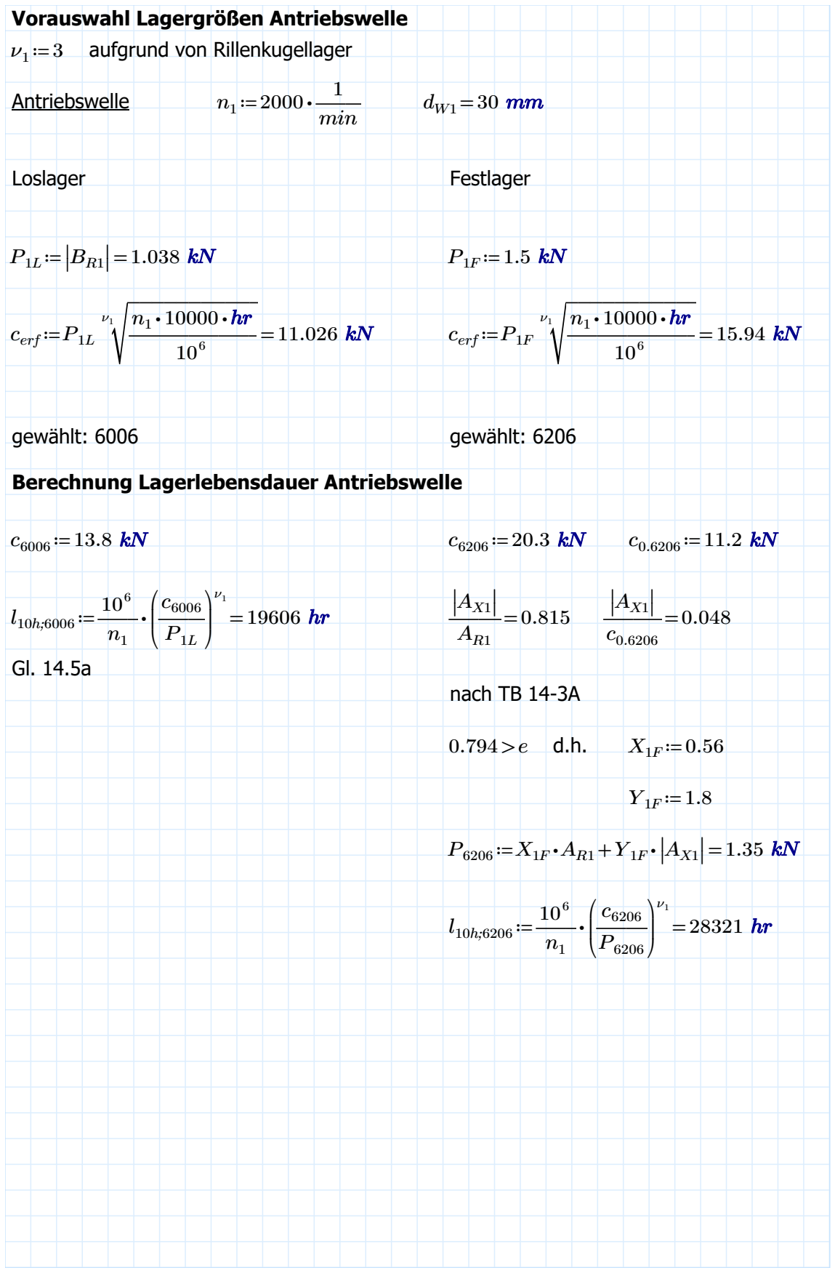
[picture p221: figure]
Vorauswahl Lagergrößen Antriebswelle; aufgrund von Rillenkugellager; Antriebswelle; n1≔2000 ⋅―1―min; Loslager; Festlager; cerf≔P1L; cerf≔P1F; gewählt: 6006; gewählt: 6206; Berechnung Lagerlebensdauer Antriebswelle; nach TB 14-3A

Claas Lübbers, Niklas Hollmann, Lars Stanislawski | Seite 19 von 30

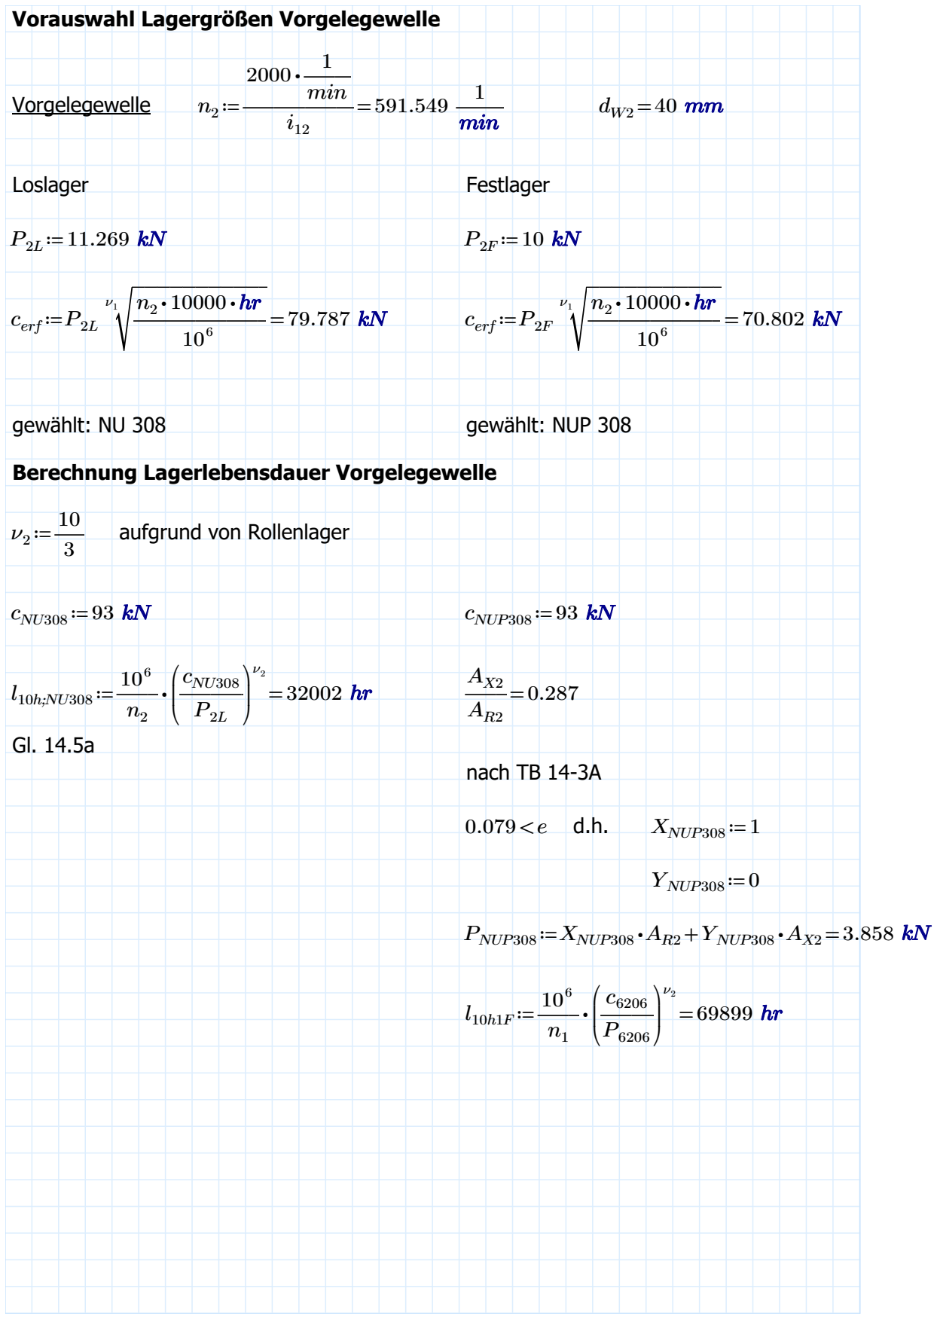
[picture p222: figure]
Vorauswahl Lagergrößen Vorgelegewelle; Vorgelegewelle; 2000 ⋅―1―min; 591.549 ―1―min; Loslager; Festlager; cerf≔P2L; cerf≔P2F; gewählt: NU 308; gewählt: NUP 308; Berechnung Lagerlebensdauer Vorgelegewelle; aufgrund von Rollenlager; cNU308≔93 kN; cNUP308≔93 kN; cNU308; nach TB 14-3A; XNUP308≔1; YNUP308≔0; PNUP308≔XNUP308 ⋅AR2+YNUP308 ⋅AX2=3.858 kN

Claas Lübbers, Niklas Hollmann, Lars Stanislawski | Seite 20 von 30

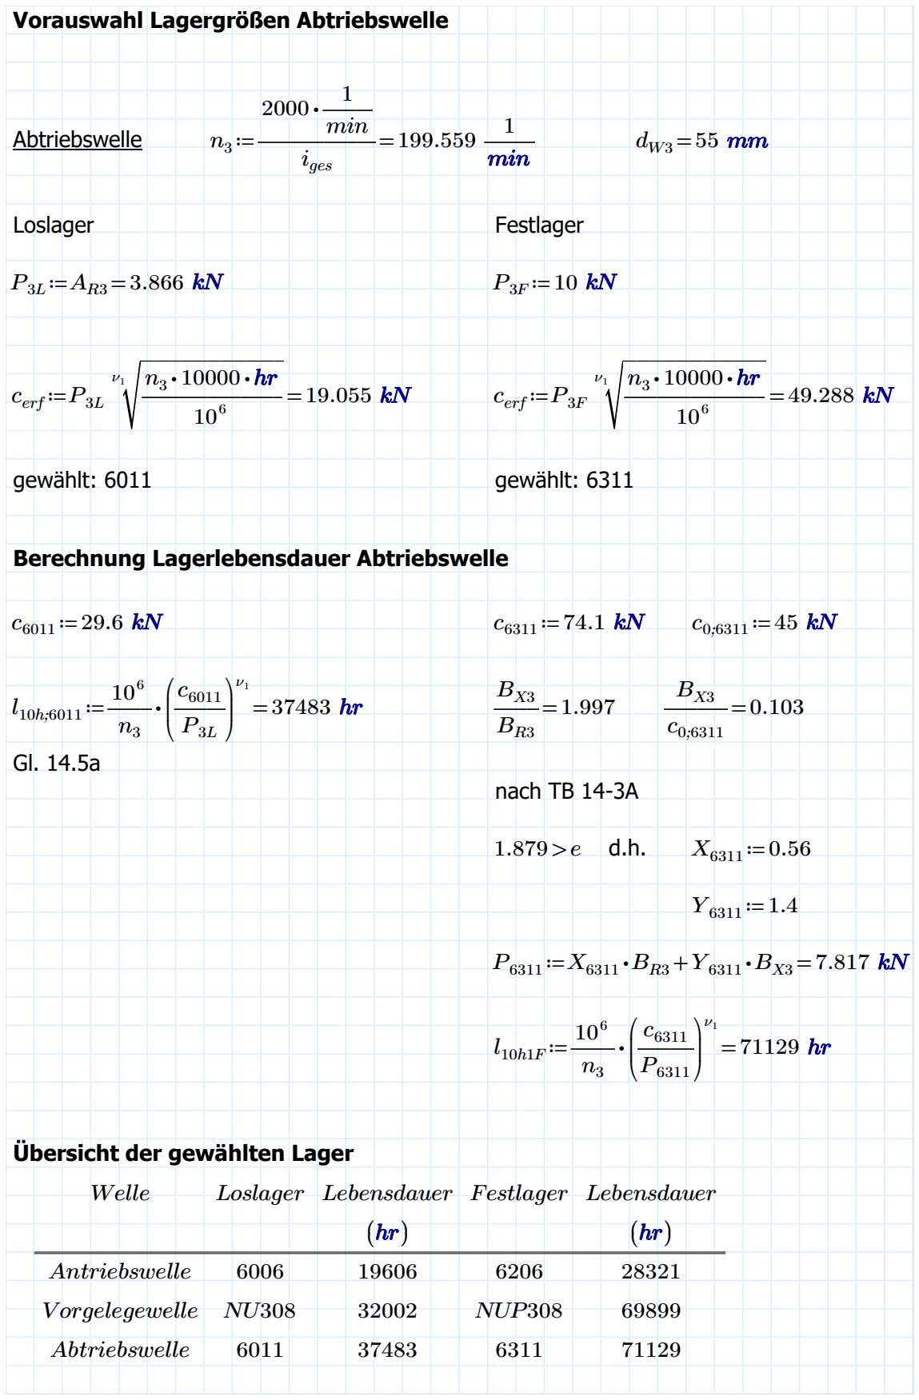
[picture p223: figure]
Vorauswahl Lagergrößen Abtriebswelle; Abtriebswelle; 2000 ⋅―1―min; iges; 199.559 ―1―min; Loslager; Festlager; cerf≔P3L; cerf≔P3F; gewählt: 6011; gewählt: 6311; Berechnung Lagerlebensdauer Abtriebswelle; nach TB 14-3A; Übersicht der gewählten Lager; Welle; Antriebswelle; Vorgelegewelle; Lebensdauer ((hr)); NUP308

Claas Lübbers, Niklas Hollmann, Lars Stanislawski | Seite 21 von 30

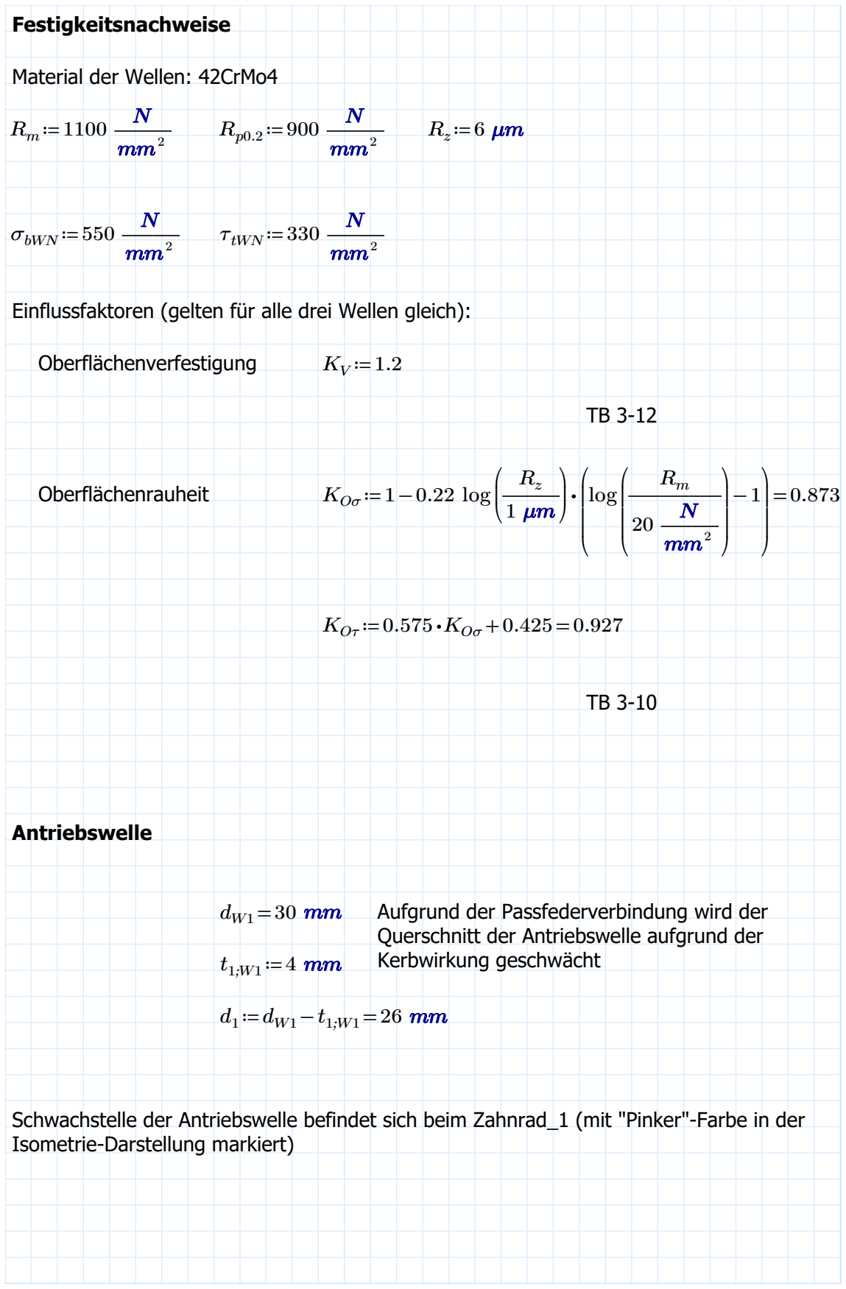
[picture p224: figure]
Festigkeitsnachweise; Material der Wellen: 42CrMo4; ―N―mm²; σbWN≔550 ―N―mm²; τtWN≔330; Oberflächenverfestigung; Oberflächenrauheit; KOσ≔1-0.22 log; log; Rm 20 ―N―mm²; KOτ≔0.575 ⋅KOσ+0.425=0.927; Antriebswelle; Kerbwirkung geschwächt 1;W1; Isometrie-Darstellung markiert)

Einflussfaktoren (gelten für alle drei Wellen gleich):

dW1=30 mm Aufgrund der Passfederverbindung wird der Querschnitt der Antriebswelle aufgrund der

Schwachstelle der Antriebswelle befindet sich beim Zahnrad_1 (mit "Pinker"-Farbe in der

Claas Lübbers, Niklas Hollmann, Lars Stanislawski | Seite 22 von 30

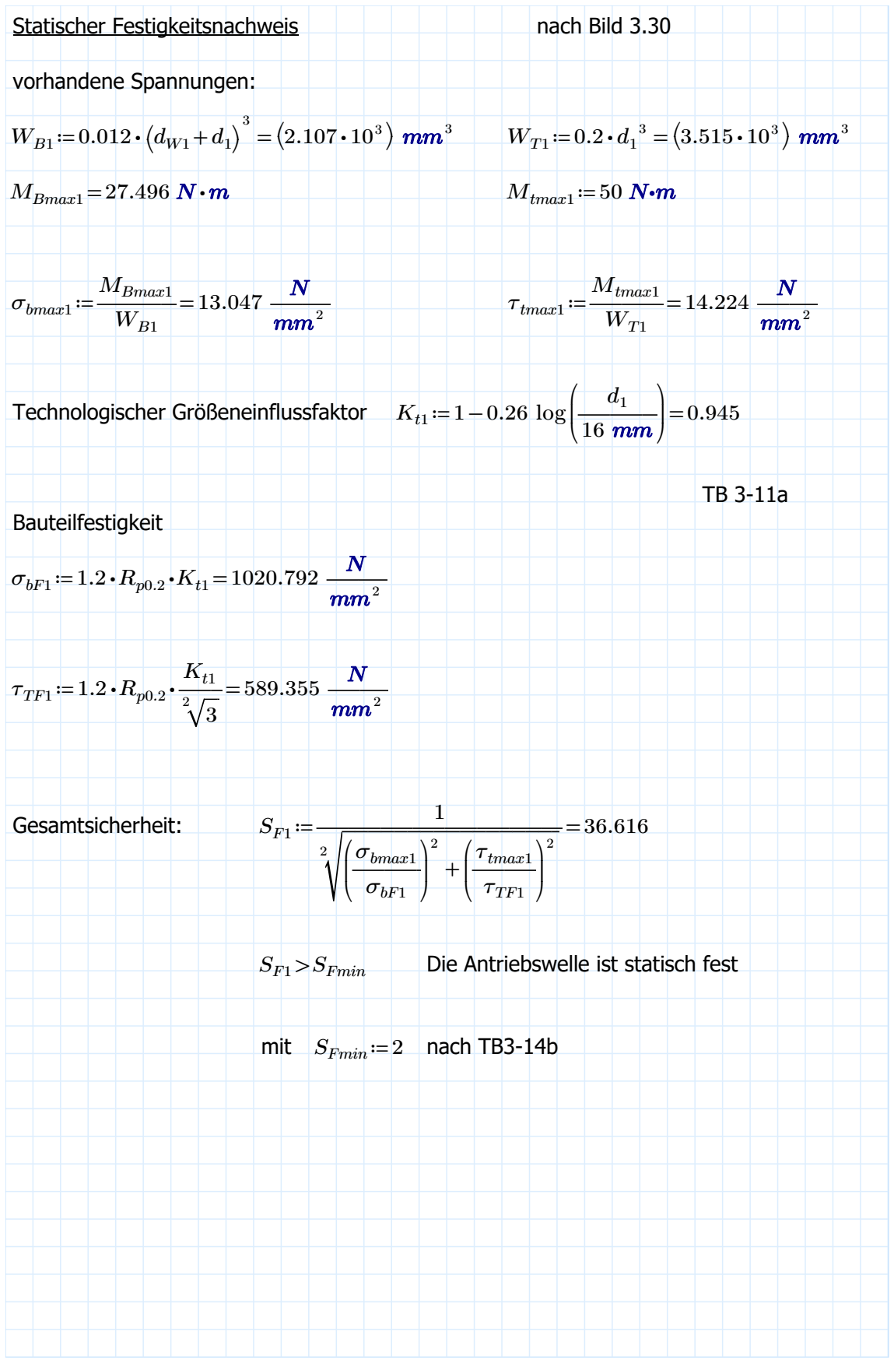
[picture p225: figure]
Statischer Festigkeitsnachweis; nach Bild 3.30; vorhandene Spannungen:; ⎠ mm³; 3 ⎛⎝3.515 ⋅ 10³ ⎞ ⎠ mm³; MBmax1=27.496 N ⋅m; Mtmax1≔50 N·m; σbmax1≔―――=; MBmax1; 13.047 ―N―mm²; τtmax1≔―――=; Mtmax1; 14.224 ―N―mm²; Technologischer Größeneinflussfaktor; log; Bauteilfestigkeit; σbF1≔1.2 ⋅Rp0.2 ⋅Kt1=1020.792 ―N―mm²; τTF1≔1.2 ⋅Rp0.2 ⋅――=; 589.355 ―N―mm²; Gesamtsicherheit:; σbmax1; σbF1; τtmax1; τTF1; SF1>SFmin; Die Antriebswelle ist statisch fest; mit; SFmin≔2; nach TB3-14b

Claas Lübbers, Niklas Hollmann, Lars Stanislawski | Seite 23 von 30

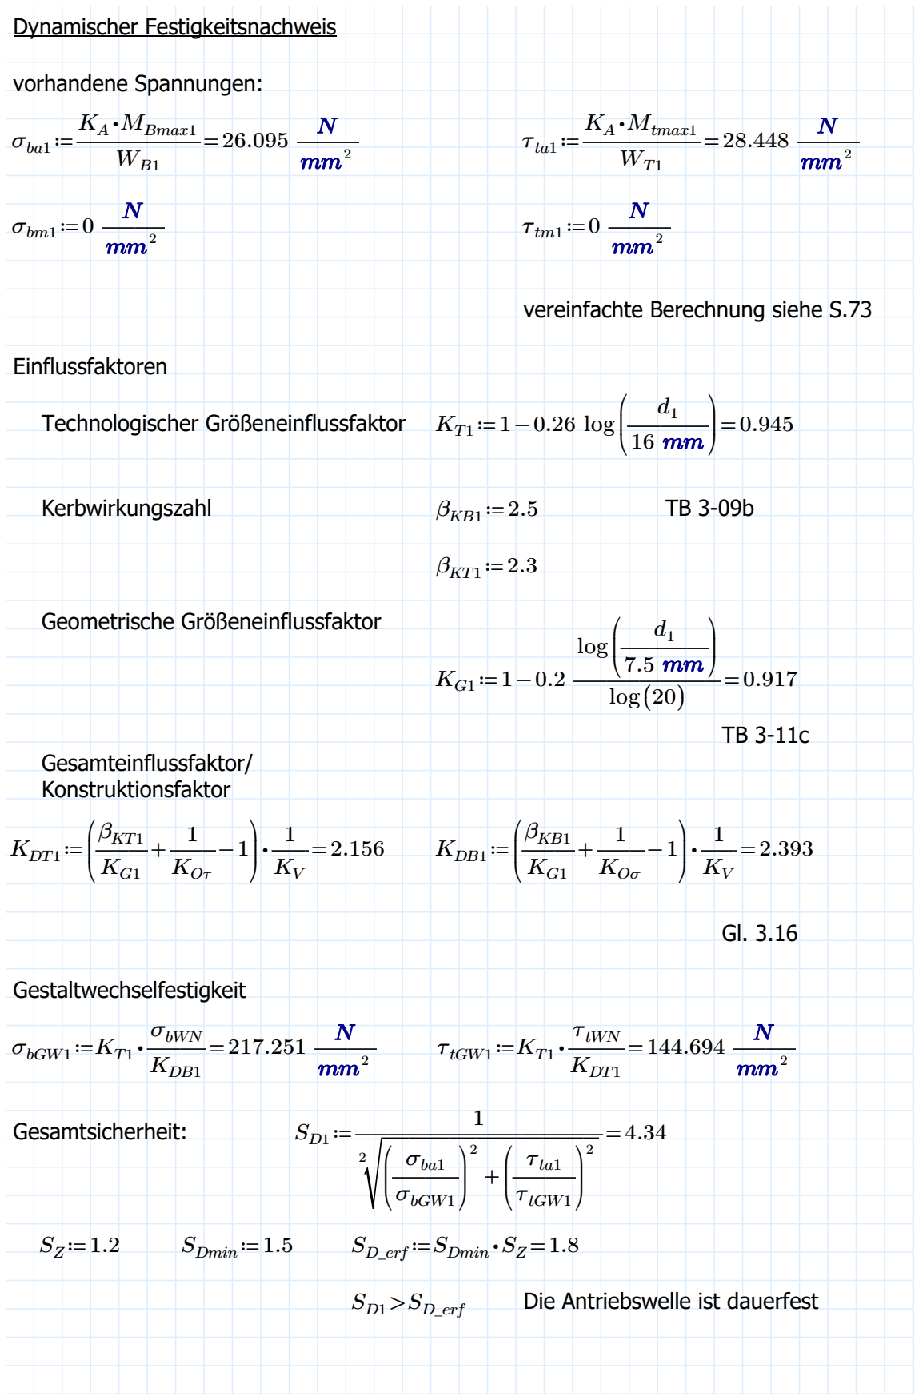
[picture p226: figure]
Dynamischer Festigkeitsnachweis; vorhandene Spannungen:; σba1≔――――=; KA ⋅MBmax1; 26.095 ―N―mm²; τta1≔――――=; KA ⋅Mtmax1; 28.448 ―N―mm²; σbm1≔0 ―N―mm²; τtm1≔0; ―N―mm²; vereinfachte Berechnung siehe S.73; Einflussfaktoren; Technologischer Größeneinflussfaktor; KT1≔1-0.26 log; Kerbwirkungszahl; βKB1≔2.5; βKT1≔2.3; Geometrische Größeneinflussfaktor; log; log((20)); Gesamteinflussfaktor/ Konstruktionsfaktor; KDT1≔; βKT1; ―1―KOτ; KDB1≔; βKB1; ―1―KOσ; Gestaltwechselfestigkeit; σbGW1≔KT1 ⋅――=; σbWN; KDB1; 217.251 ―N―mm²; τtGW1≔KT1 ⋅――=; τtWN; KDT1; 144.694 ―N―mm²; Gesamtsicherheit:; σba1; σbGW1; τta1; τtGW1; SDmin≔1.5; SD_erf≔SDmin ⋅SZ=1.8; SD1>SD_erf; Die Antriebswelle ist dauerfest

Claas Lübbers, Niklas Hollmann, Lars Stanislawski | Seite 24 von 30

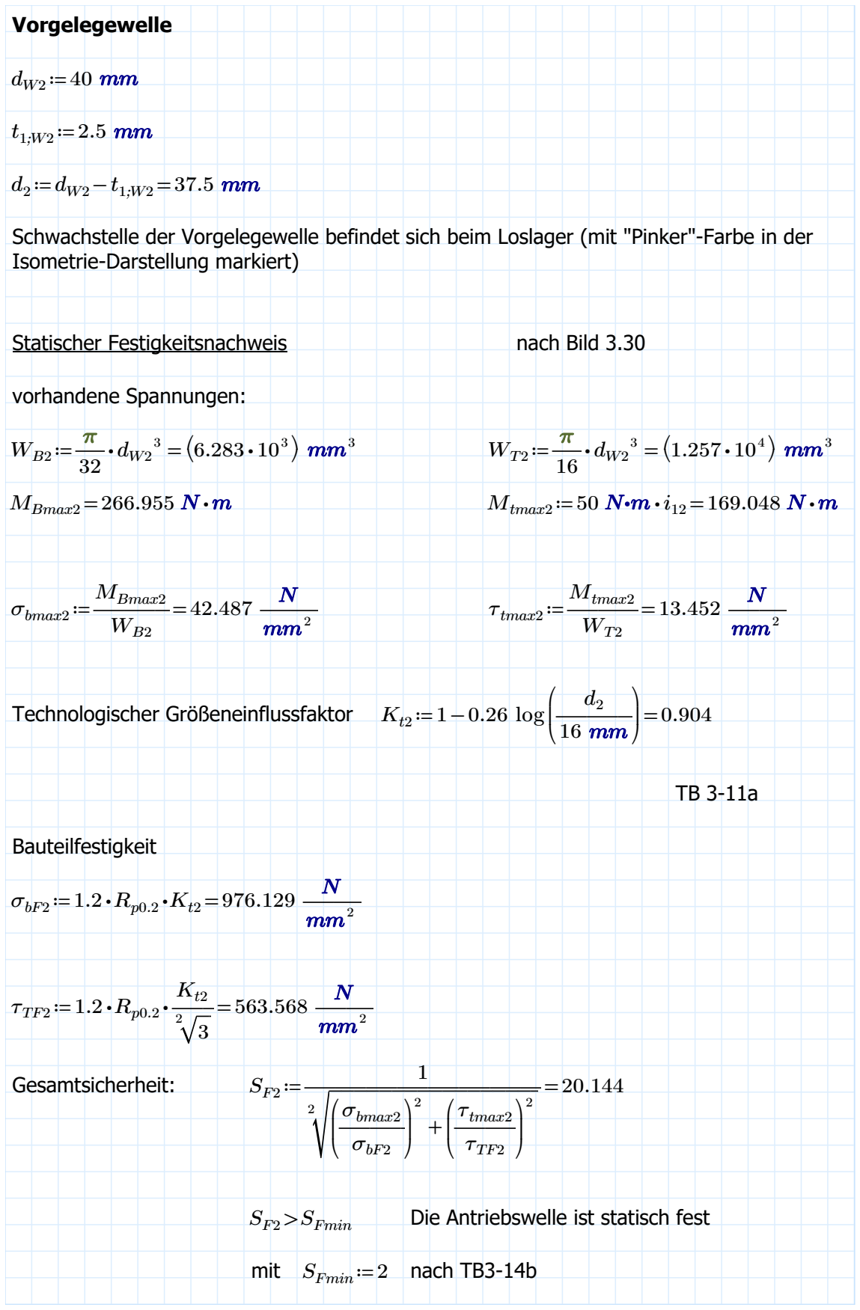
[picture p227: figure]
Vorgelegewelle; Isometrie-Darstellung markiert); Statischer Festigkeitsnachweis; nach Bild 3.30; vorhandene Spannungen:; ⎠ mm³; mm³; MBmax2=266.955 N ⋅m; Mtmax2≔50 N·m ⋅i12=169.048 N ⋅m; σbmax2≔―――=; MBmax2; 42.487 ―N―mm²; τtmax2≔―――=; Mtmax2; 13.452 ―N―mm²; Technologischer Größeneinflussfaktor; log; Bauteilfestigkeit; σbF2≔1.2 ⋅Rp0.2 ⋅Kt2=976.129; ―N―mm²; τTF2≔1.2 ⋅Rp0.2 ⋅――=; 563.568 ―N―mm²; Gesamtsicherheit:; σbmax2; σbF2; τtmax2; τTF2; SF2>SFmin; Die Antriebswelle ist statisch fest; mit; SFmin≔2; nach TB3-14b

Schwachstelle der Vorgelegewelle befindet sich beim Loslager (mit "Pinker"-Farbe in der

Claas Lübbers, Niklas Hollmann, Lars Stanislawski | Seite 25 von 30

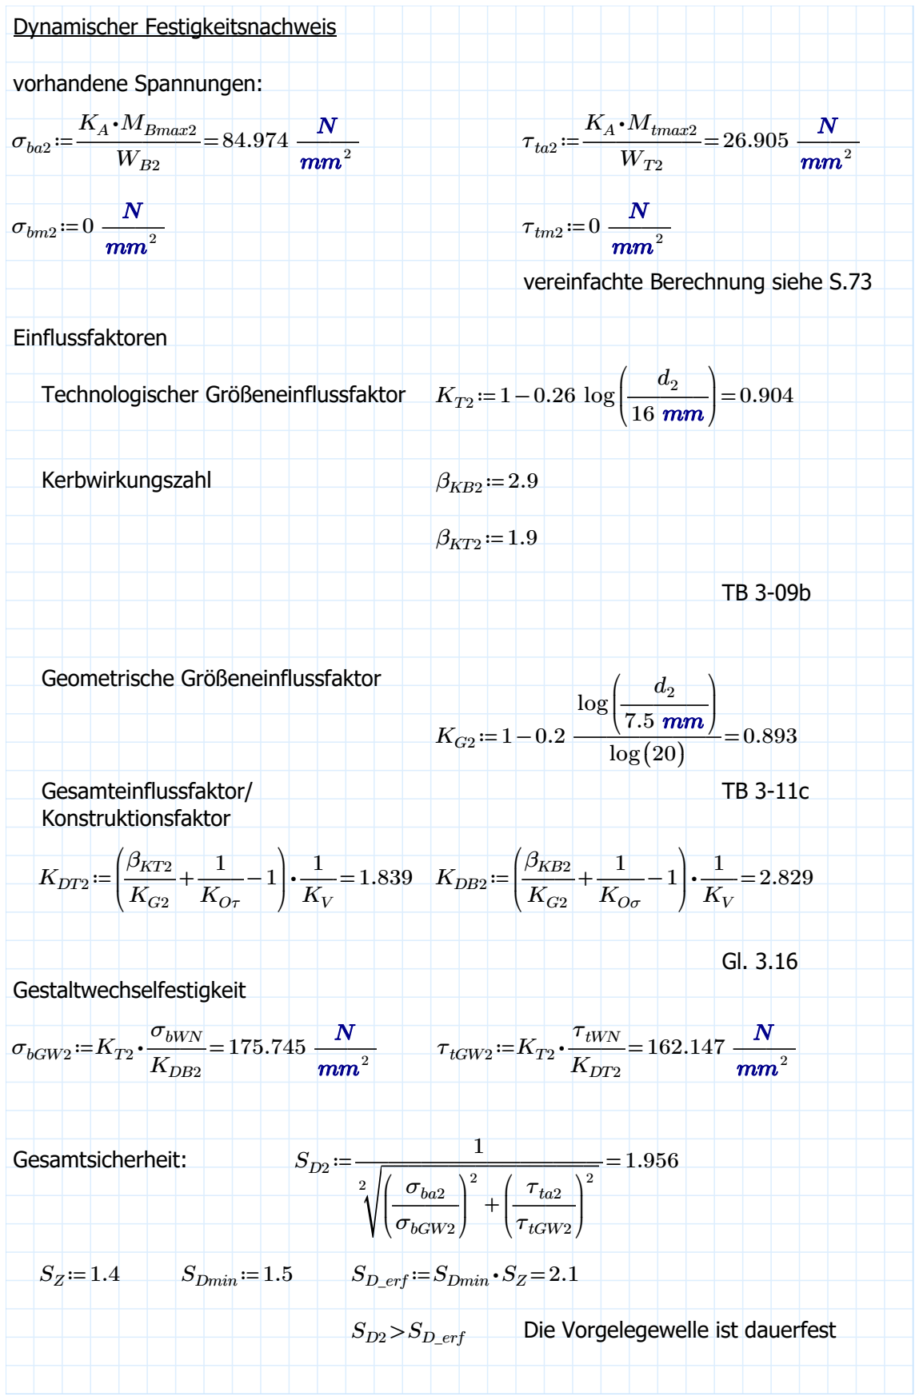
[picture p228: figure]
Dynamischer Festigkeitsnachweis; vorhandene Spannungen:; σba2≔――――=; KA ⋅MBmax2; 84.974 ―N―mm²; τta2≔――――=; KA ⋅Mtmax2; 26.905 ―N―mm²; σbm2≔0 ―N―mm²; τtm2≔0; ―N―mm²; vereinfachte Berechnung siehe S.73; Einflussfaktoren; Technologischer Größeneinflussfaktor; KT2≔1-0.26 log; Kerbwirkungszahl; βKB2≔2.9; βKT2≔1.9; Geometrische Größeneinflussfaktor; log; log((20)); Gesamteinflussfaktor/ Konstruktionsfaktor; KDT2≔; βKT2; ―1―KOτ; KDB2≔; βKB2; ―1―KOσ; Gestaltwechselfestigkeit; σbGW2≔KT2 ⋅――=; σbWN; KDB2; 175.745 ―N―mm²; τtGW2≔KT2 ⋅――=; τtWN; KDT2; 162.147 ―N―mm²; Gesamtsicherheit:; σba2; σbGW2; τta2; τtGW2; SDmin≔1.5; SD_erf≔SDmin ⋅SZ=2.1; SD2>SD_erf; Die Vorgelegewelle ist dauerfest

Claas Lübbers, Niklas Hollmann, Lars Stanislawski | Seite 26 von 30

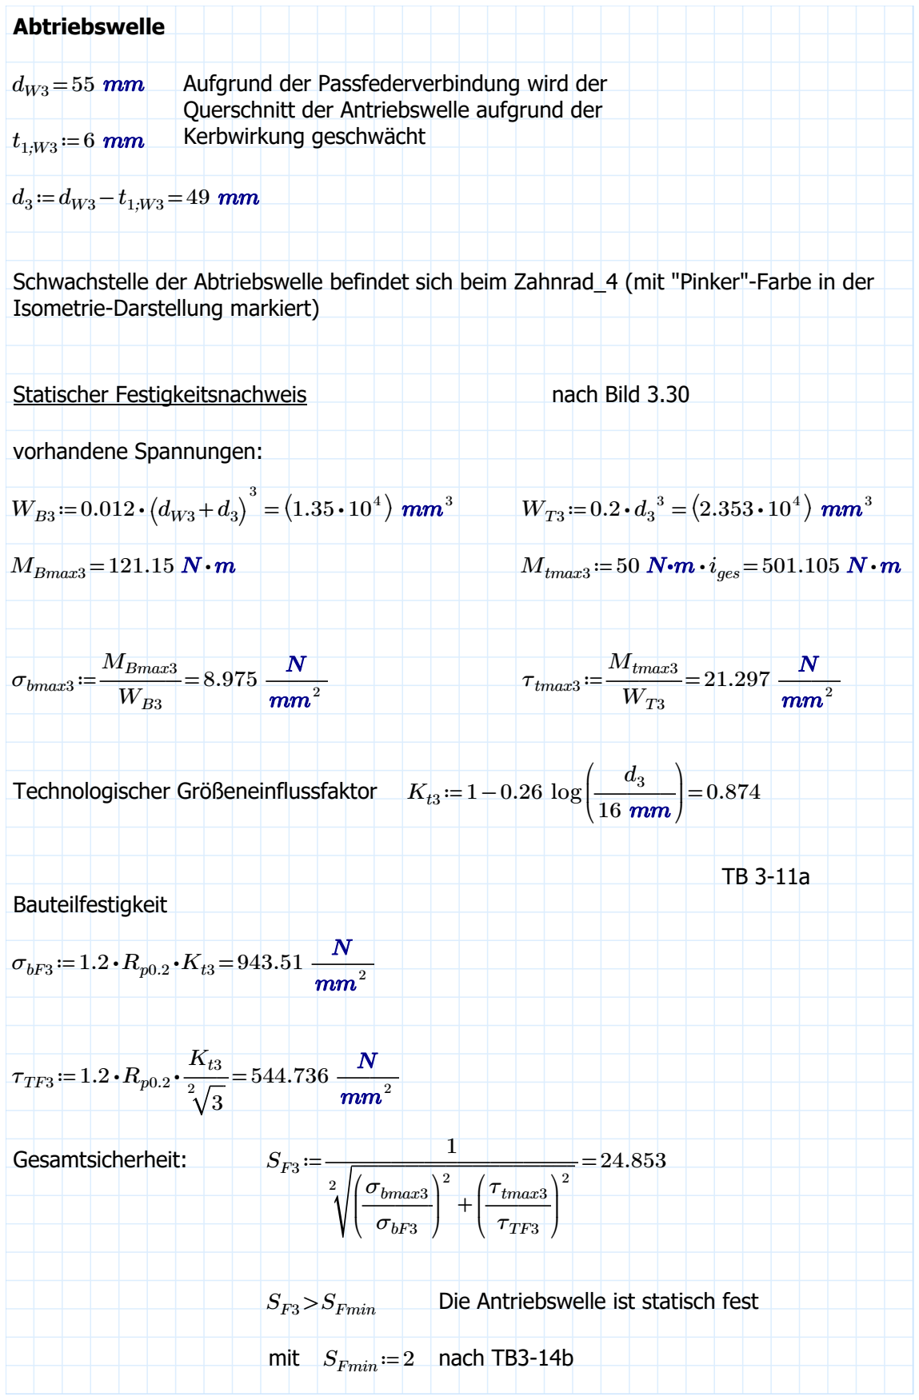
[picture p229: figure]
Abtriebswelle; Aufgrund der Passfederverbindung wird der; Querschnitt der Antriebswelle aufgrund der; Kerbwirkung geschwächt 1;W3; Isometrie-Darstellung markiert); Statischer Festigkeitsnachweis; nach Bild 3.30; vorhandene Spannungen:; mm³; 3 ⎛⎝2.353 ⋅ 10⁴ ⎞ ⎠ mm³; MBmax3=121.15 N ⋅m; Mtmax3≔50 N·m ⋅iges=501.105 N ⋅m; σbmax3≔―――=; MBmax3; 8.975 ―N―mm²; τtmax3≔―――=; Mtmax3; 21.297 ―N―mm²; Technologischer Größeneinflussfaktor; log; Bauteilfestigkeit; σbF3≔1.2 ⋅Rp0.2 ⋅Kt3=943.51 ―N―mm²; τTF3≔1.2 ⋅Rp0.2 ⋅――=; 544.736 ―N―mm²; Gesamtsicherheit:; σbmax3; σbF3; τtmax3; τTF3; SF3>SFmin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

Schwachstelle der Abtriebswelle befindet sich beim Zahnrad_4 (mit "Pinker"-Farbe in der

Claas Lübbers, Niklas Hollmann, Lars Stanislawski | Seite 27 von 30

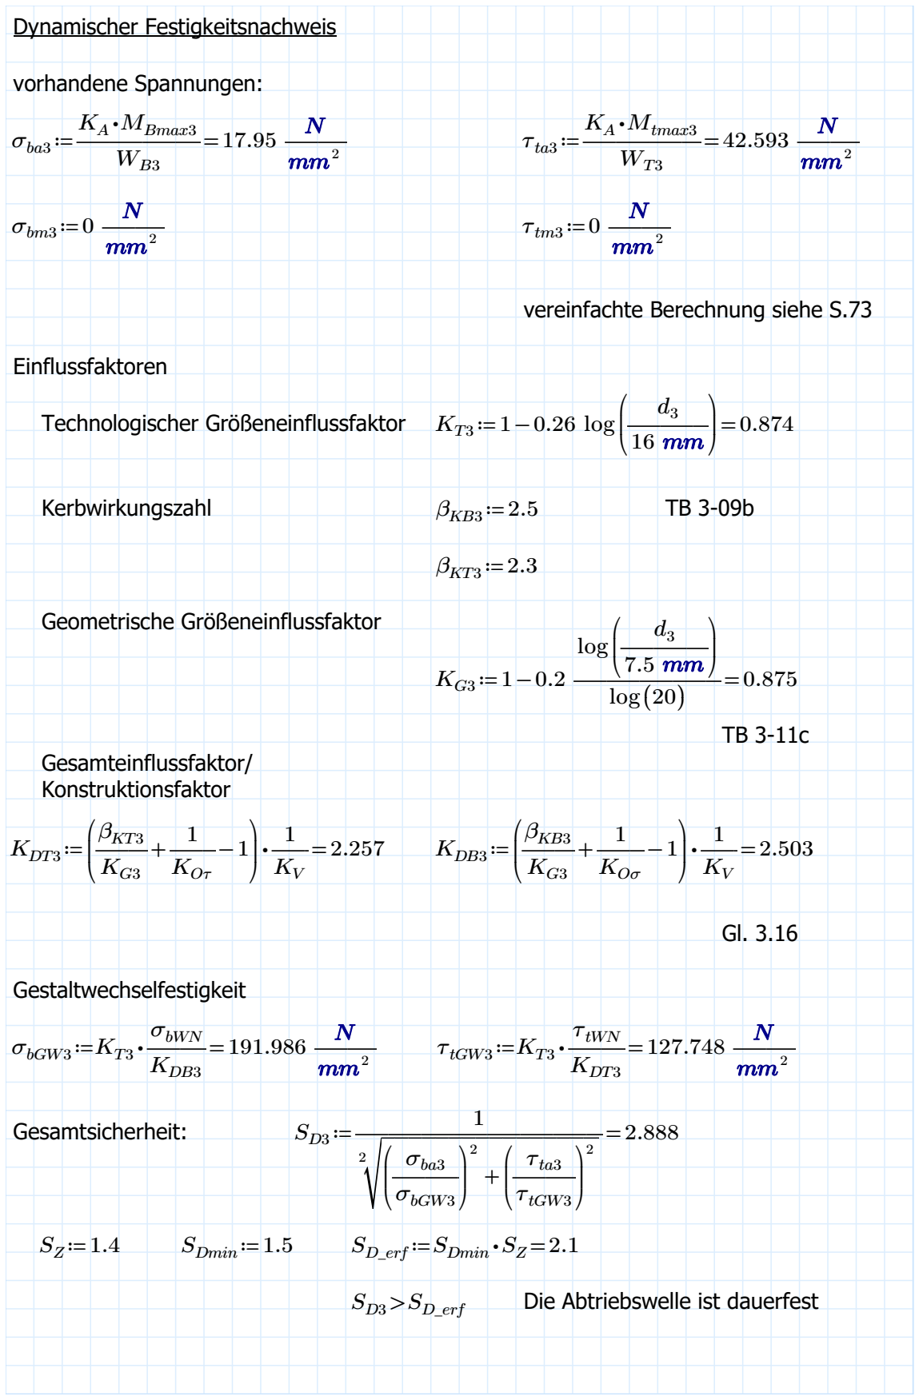
[picture p230: figure]
Dynamischer Festigkeitsnachweis; vorhandene Spannungen:; σba3≔――――=; KA ⋅MBmax3; 17.95 ―N―mm²; τta3≔――――=; KA ⋅Mtmax3; 42.593 ―N―mm²; σbm3≔0 ―N―mm²; τtm3≔0; ―N―mm²; vereinfachte Berechnung siehe S.73; Einflussfaktoren; Technologischer Größeneinflussfaktor; KT3≔1-0.26 log; Kerbwirkungszahl; βKB3≔2.5; βKT3≔2.3; Geometrische Größeneinflussfaktor; log; log((20)); Gesamteinflussfaktor/ Konstruktionsfaktor; KDT3≔; βKT3; ―1―KOτ; KDB3≔; βKB3; ―1―KOσ; Gestaltwechselfestigkeit; σbGW3≔KT3 ⋅――=; σbWN; KDB3; 191.986 ―N―mm²; τtGW3≔KT3 ⋅――=; τtWN; KDT3; 127.748 ―N―mm²; Gesamtsicherheit:; σba3; σbGW3; τta3; τtGW3; SDmin≔1.5; SD_erf≔SDmin ⋅SZ=2.1; SD3>SD_erf; Die Abtriebswelle ist dauerfest

Claas Lübbers, Niklas Hollmann, Lars Stanislawski | Seite 28 von 30

Fliehkraftkupplung

Anzahl der Fliehkörper | NFK≔2
Schaltdrehzahl | nS≔1400 ⋅―1―min
Fliehkörpermasse | mFK≔0.5 | kg
Reibdurchmesser | DR≔140 mm
Haftreibwert | μ0;FK≔0.9
Fliehkörperschwerpunktradius | rFK≔50 mm
Gesamtfederkraft | FF≔25 N

Winkelgeschwindigkeit:
ωFK≔2 π⋅nS=146.608 ―1
s
Fliehkraft:
FFlieh≔mFK ⋅ rFK ⋅ωFK =

2 537.345 N

Kontaktkraft:
FN;FK≔FFlieh-FF=512.345 N

Reibkraft an einem Fliehkörper: FR;FK≔μ0;FK ⋅FN;FK =461.111 N

Reibmoment:
MR;FK≔NFK ⋅FR;FK ⋅――=

DR
2

64.555 N ⋅m

Claas Lübbers, Niklas Hollmann, Lars Stanislawski | Seite 29 von 30

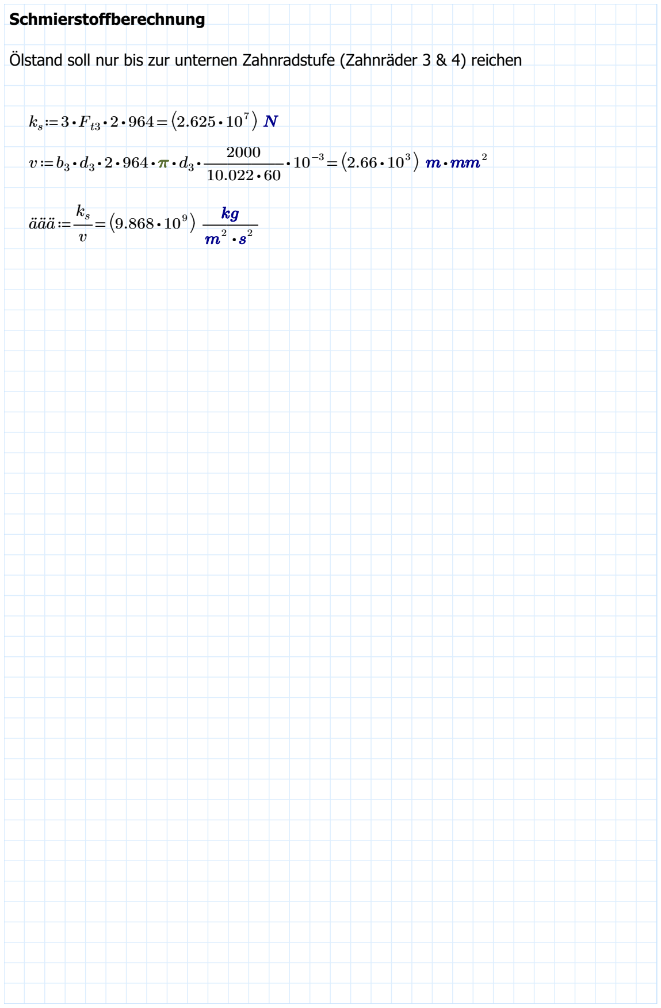
[picture p231: figure]
Schmierstoffberechnung; ⎠ m ⋅mm²; äää≔―=

Ölstand soll nur bis zur unternen Zahnradstufe (Zahnräder 3 & 4) reichen

Claas Lübbers, Niklas Hollmann, Lars Stanislawski | Seite 30 von 30
