Marvin20212/Gruppe9_ME3E/Entwurf alt (Lars)/ME3-Entwurf/Berechnungen/Testat_2/Abtriebswelle.pdf

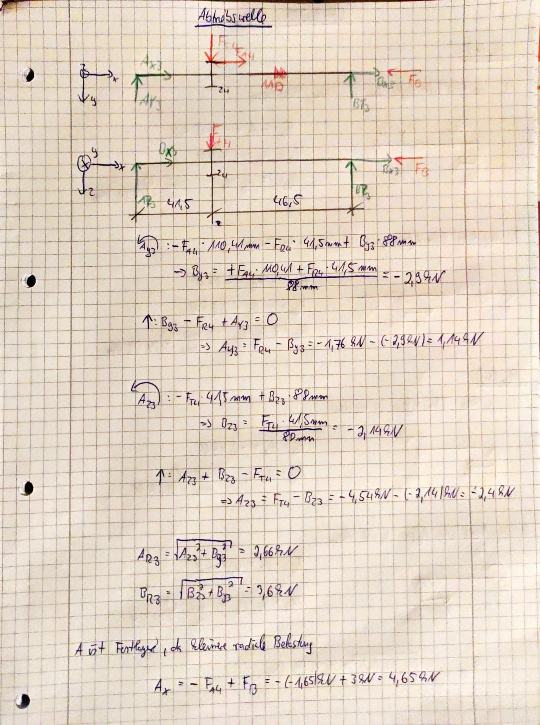
[picture p232: page 1]
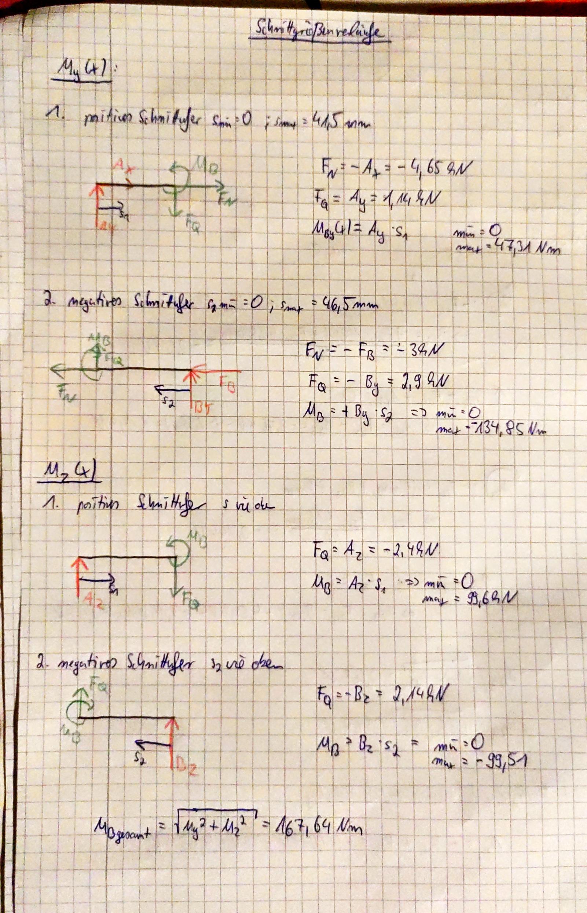
[picture p233: page 2]
