Marvin20212/Gruppe9_ME3E/Entwurf alt (Lars)/ME3-Entwurf/Berechnungen/Testat_2/Abtriebswelle_neu.pdf

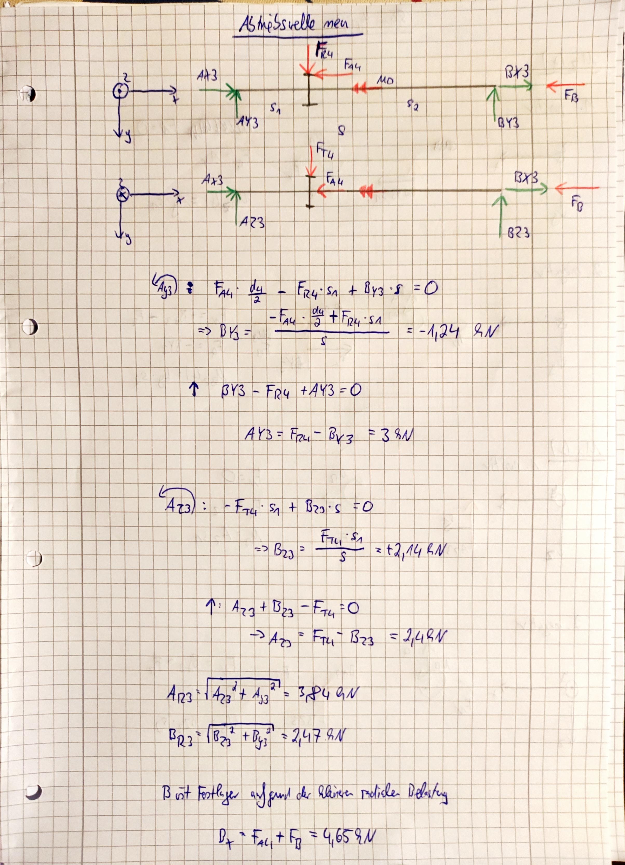
[picture p234: page 1]
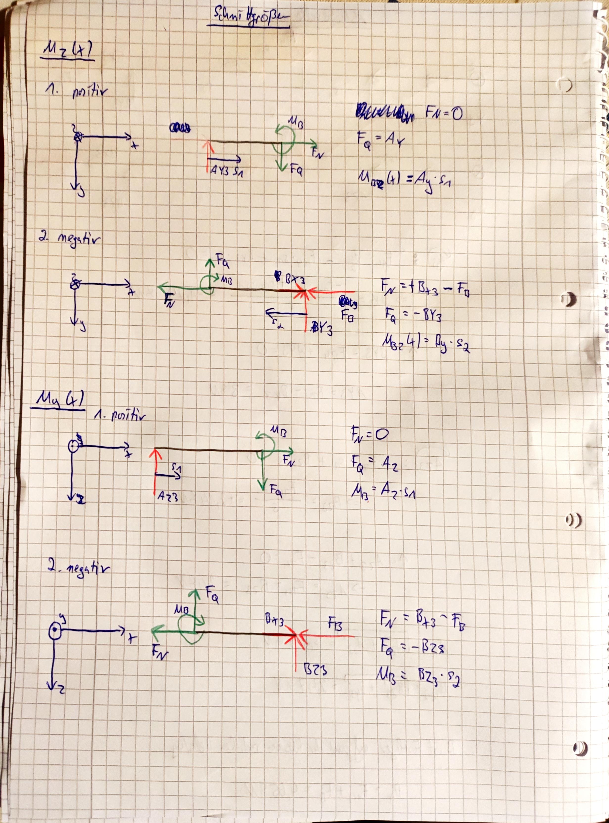
[picture p235: page 2]
