Marvin20212/Gruppe9_ME3E/Entwurf alt (Lars)/ME3-Entwurf/Berechnungen/Testat_2/Antriebswelle.pdf

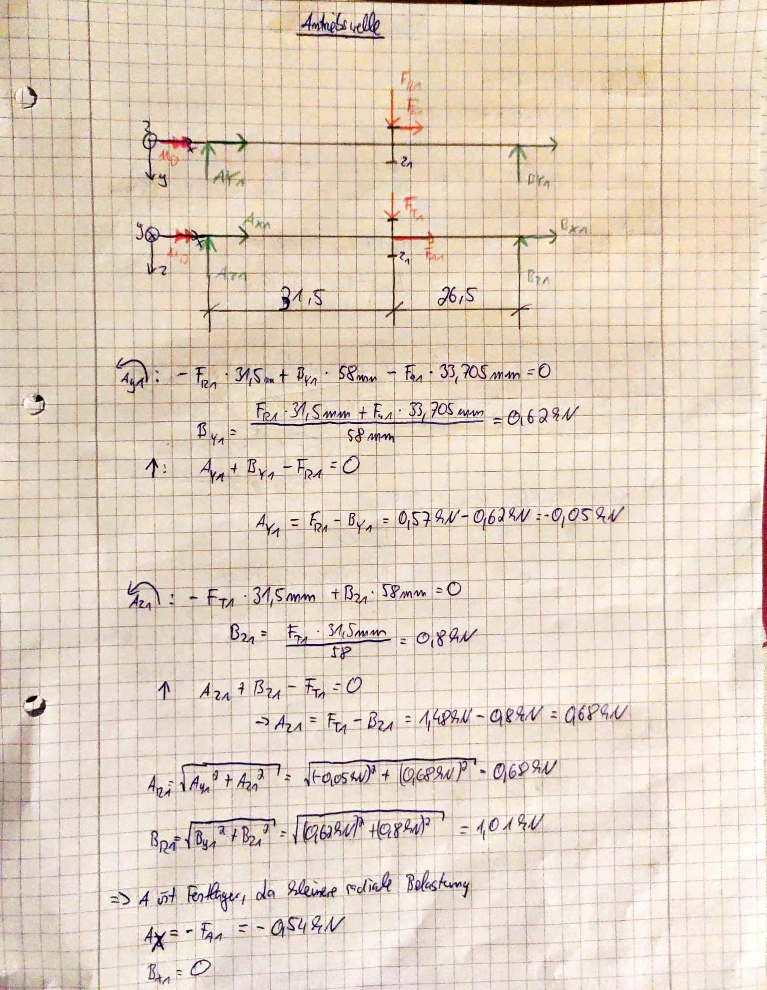
[picture p236: page 1]
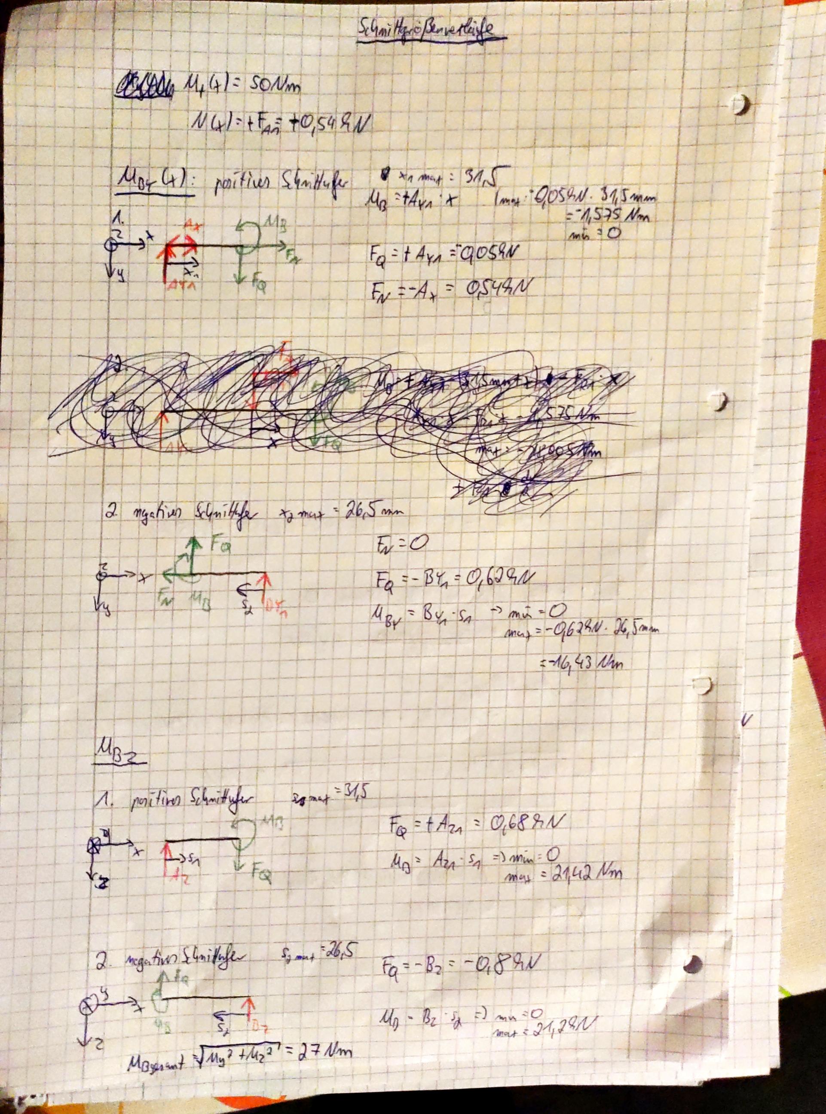
[picture p237: page 2]
