Marvin20212/Gruppe9_ME3E/Entwurf alt (Lars)/ME3-Entwurf/Berechnungen/Testat_2/Kräfte am Zahnrad.pdf

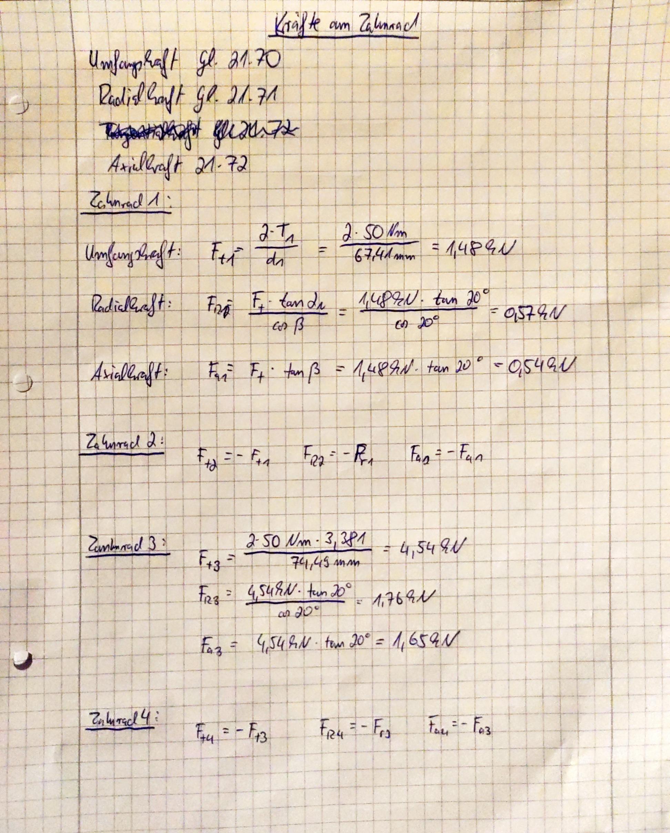
[picture p238: page 1]
