Marvin20212/Gruppe9_ME3E/Entwurf alt (Lars)/ME3-Entwurf/Berechnungen/Testat_2/Vorgelegewelle.pdf

## I --r L ]- Ll llltr il; ⁻ffi,#F

# F+| H-[L+ I rrl

l | |

lt_lrj_l | ;Itil

I
l-llE] -rl. l--_Lsj
r {tr*lAl I liecF.,tf I i;_,i,_f_[_t_]+_+_l_i_|-j__+r-f-1,-l--l -r-}-l-f

# 't-- EiI qIqAI ---:rr-i]rrL --

--- ,- I | -l
l_ | Lt' - '1 16' 53 (vt/Yll'f * t1 w': - - '*ä-
Aty- V<\;urL 'r
