Marvin20212/Gruppe9_ME3E/Entwurf alt (Lars)/ME3-Entwurf/Berechnungen/Testat_3/Schmierstoffberechnung.pdf

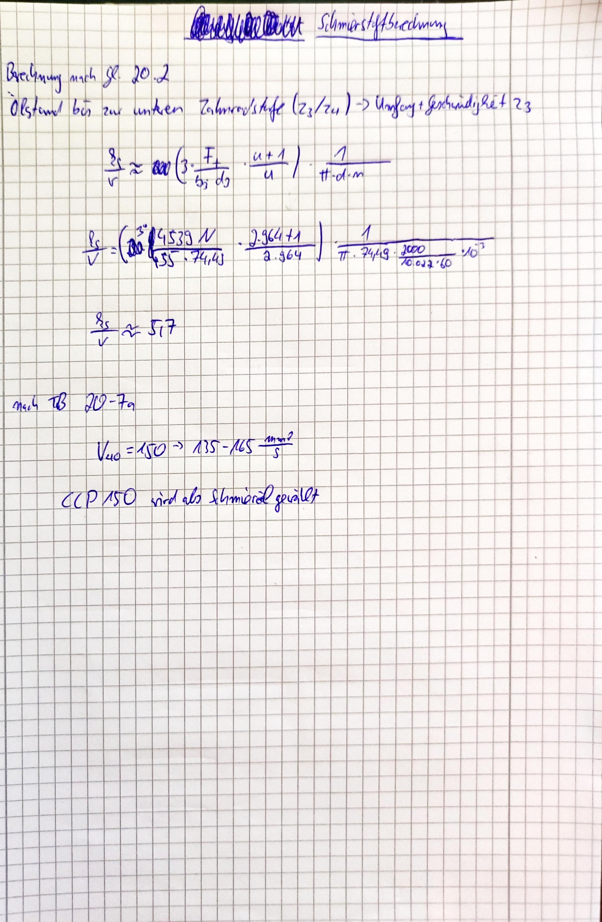
[picture p239: page 1]
