Marvin20212/Gruppe9_ME3E/Entwurf alt (Lars)/ME3-Entwurf/Berechnungen/Testat_2/Festigkeitsnachweis/Festigkeitsnachweis_Abtriebswelle.pdf

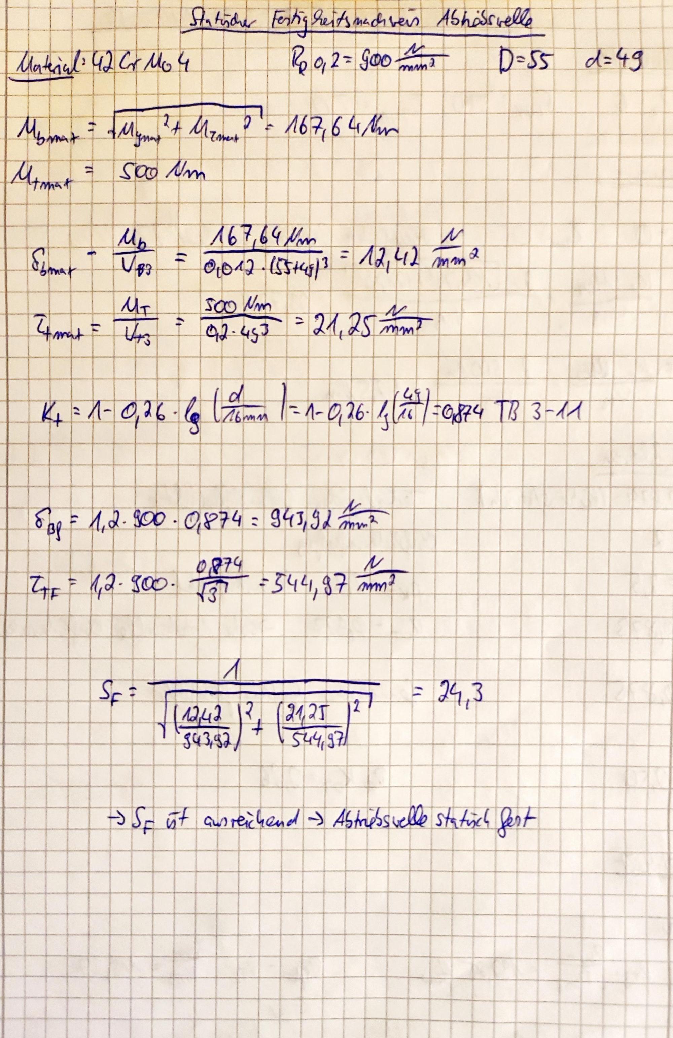
[picture p240: page 1]
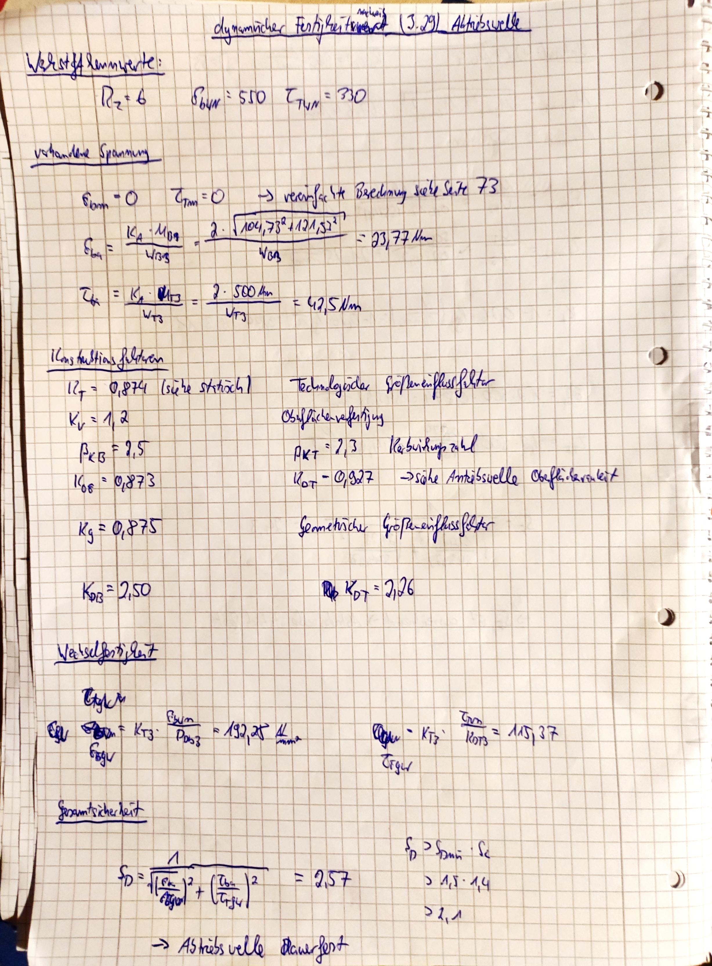
[picture p241: page 2]
