Marvin20212/Gruppe9_ME3E/Entwurf alt (Lars)/ME3-Entwurf/Berechnungen/Testat_2/Festigkeitsnachweis/Festigkeitsnachweis_Antriebswelle.pdf

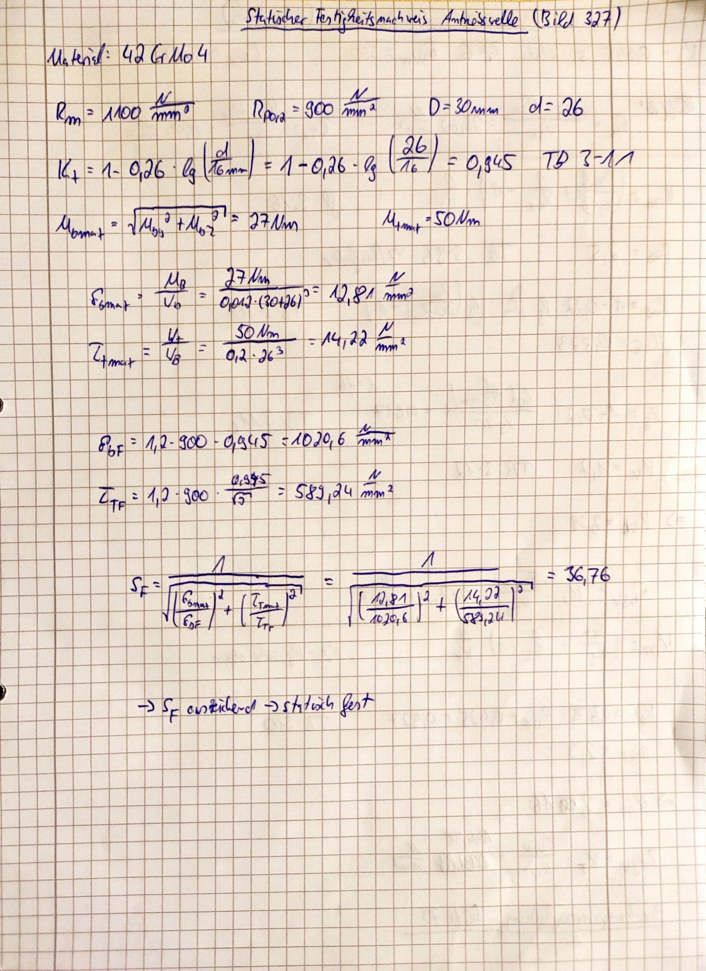
[picture p242: page 1]
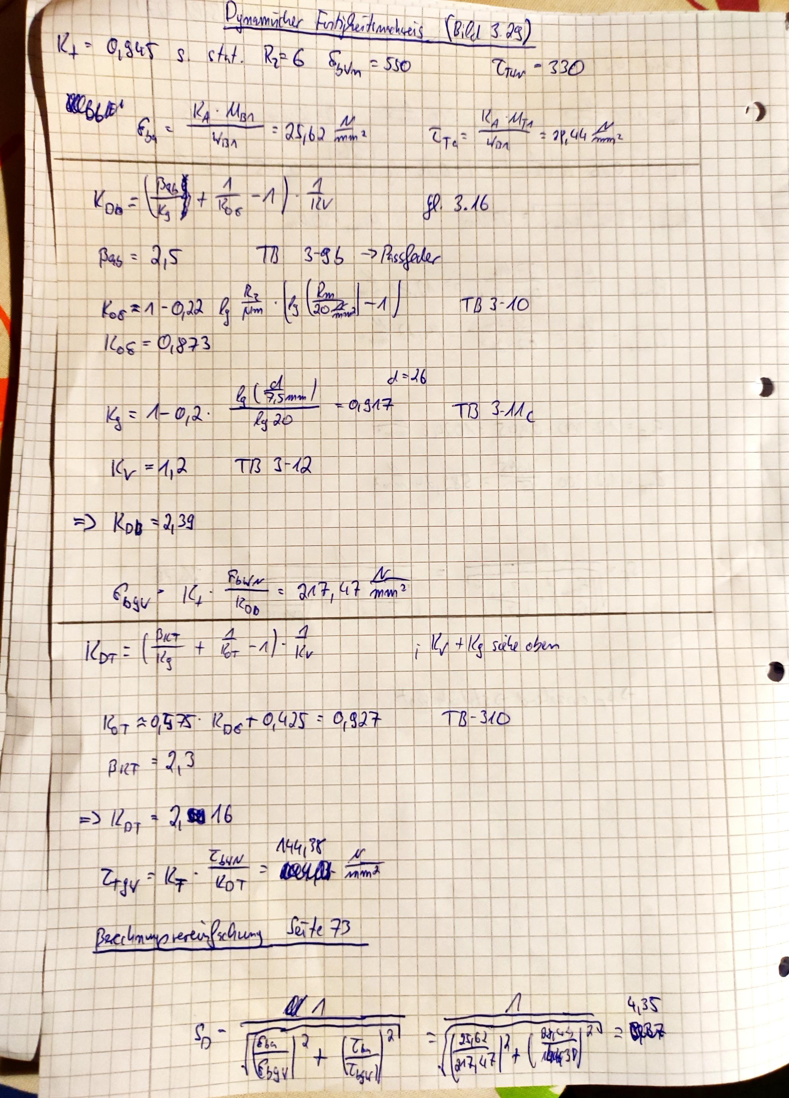
[picture p243: page 2]
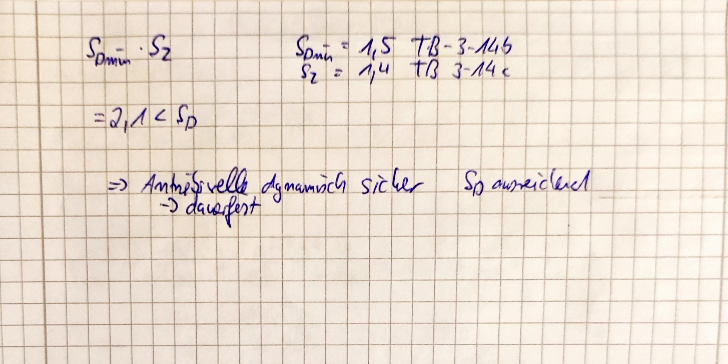
[picture p244: page 3]
