Marvin20212/Gruppe9_ME3E/Entwurf alt (Lars)/ME3-Entwurf/Berechnungen/Testat_2/Festigkeitsnachweis/Festigkeitsnachweis_Vorgelegewelle.pdf

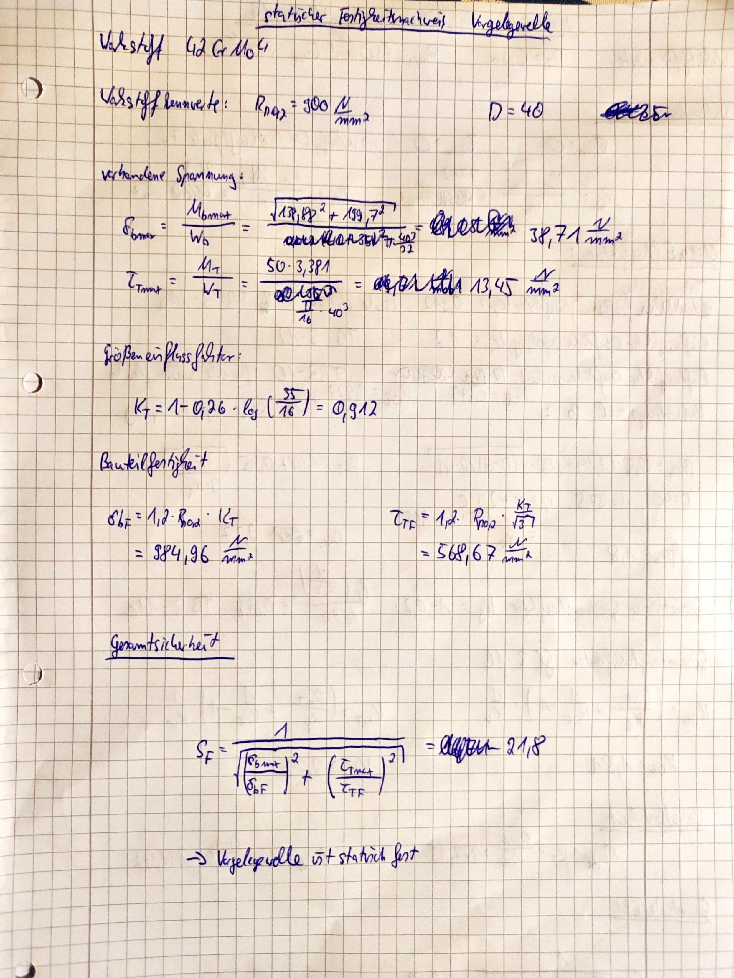
[picture p245: page 1]
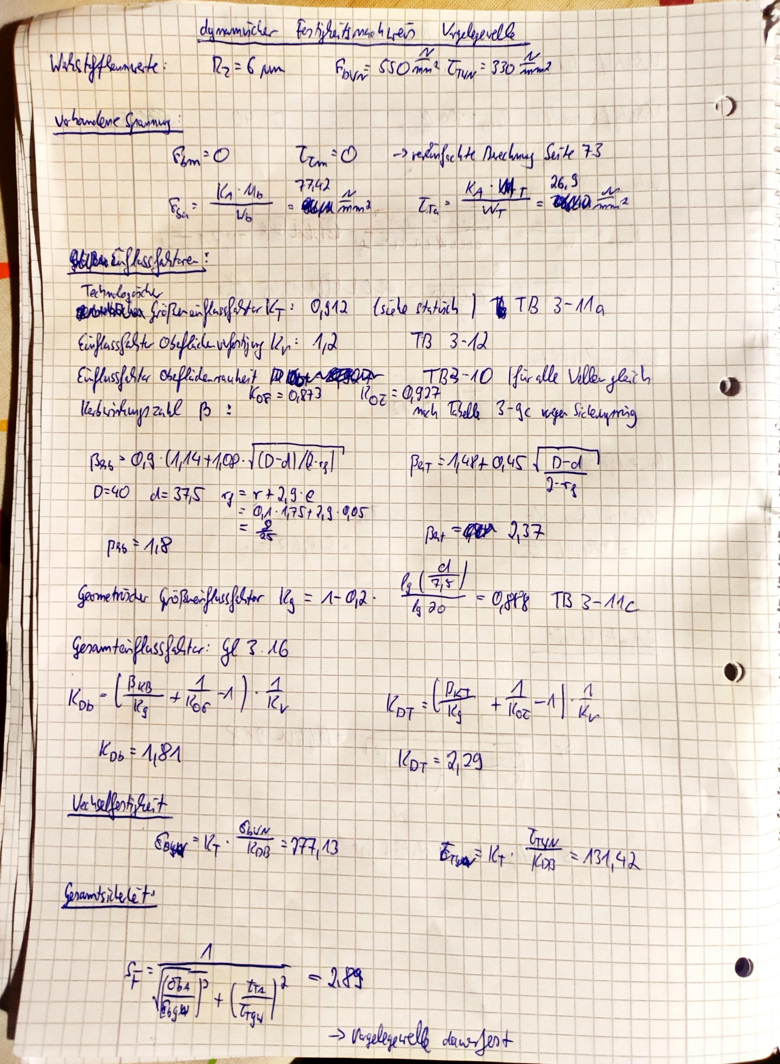
[picture p246: page 2]
