Marvin20212/Gruppe9_ME3E/Entwurf alt (Lars)/ME3-Entwurf/Berechnungen/Testat_1/Getriebeberechnung Me3e.xlsx

Sheet: 1. Getriebe
 | theoretisch | praktisch | Übersetzung theoretisch |  |  | Abweichung
Tan | 50.00 | 50.00 | iges | 10.00 |  | Drehmoment | 0.0000
Tab | 500.00 | 500.00 | i12 | 3.40 |  | Drehzahl | 0.0000 |  | Gute Kombination
 |  |  | i34 | 2.94 |  |  |  |  | 21.00 | 29
Nan | 2000.00 | 2000.00 |  |  |  |  |  |  | 71.00 | 99
Nab | 200.00 | 200.00 |  |  |  | Durchmesser | errechnet | gewählt | 28.00 | 29
 |  |  | Übersetzung praktisch |  |  | Antriebswelle | 21.68 | 30.00 | 83.00 | 85
Zähnezahlen |  |  | iges | 10.00 |  | Vorgelegewelle | 32.53 | 40.00
z1 | 21 |  | i12 | 3.38 |  | Abtriebswelle | 46.70 | 55.00 | 0.8 | 0.26
z2 | 71 |  | i34 | 2.96 |  |  |  |  | Modul Reihe 1 | Modul Reihe 2
z3 | 28
z4 | 83 | 82
 |  |  | Zahnradbreite | errechnet | gewählt |  | Modul 1+2
Teilerüberprprüfung |  |  | Zahnrad 1+2 | 27.78 | 30.00 |  | errechnet | 2.74
z1;z2 | 1.00 |  | Zahnrad 3+4 | 52.81 | 55.00 |  | gewählt | 3.00
z3;z4 | 1.00
 |  |  |  |  |  |  | Modul 3+4
 |  |  |  |  |  |  | errechnet | 2.49
Teilkreise |  |  | Achsabstand |  |  |  | gewählt | 2.50
Z1 | 67.04 |  | Z1 und Z2 | 146.86
Z2 | 226.67 |  | Z3 und Z4 | 147.66
Z3 | 74.49
Z4 | 220.82 |  |  | -0.80
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
