Marvin20212/Gruppe9_ME3E/Entwurf alt (Lars)/ME3-Entwurf/Berechnungen/Testat_1/Testat Nr.1/Zeichnungen/Prinzipskizze mit Legende.jpeg

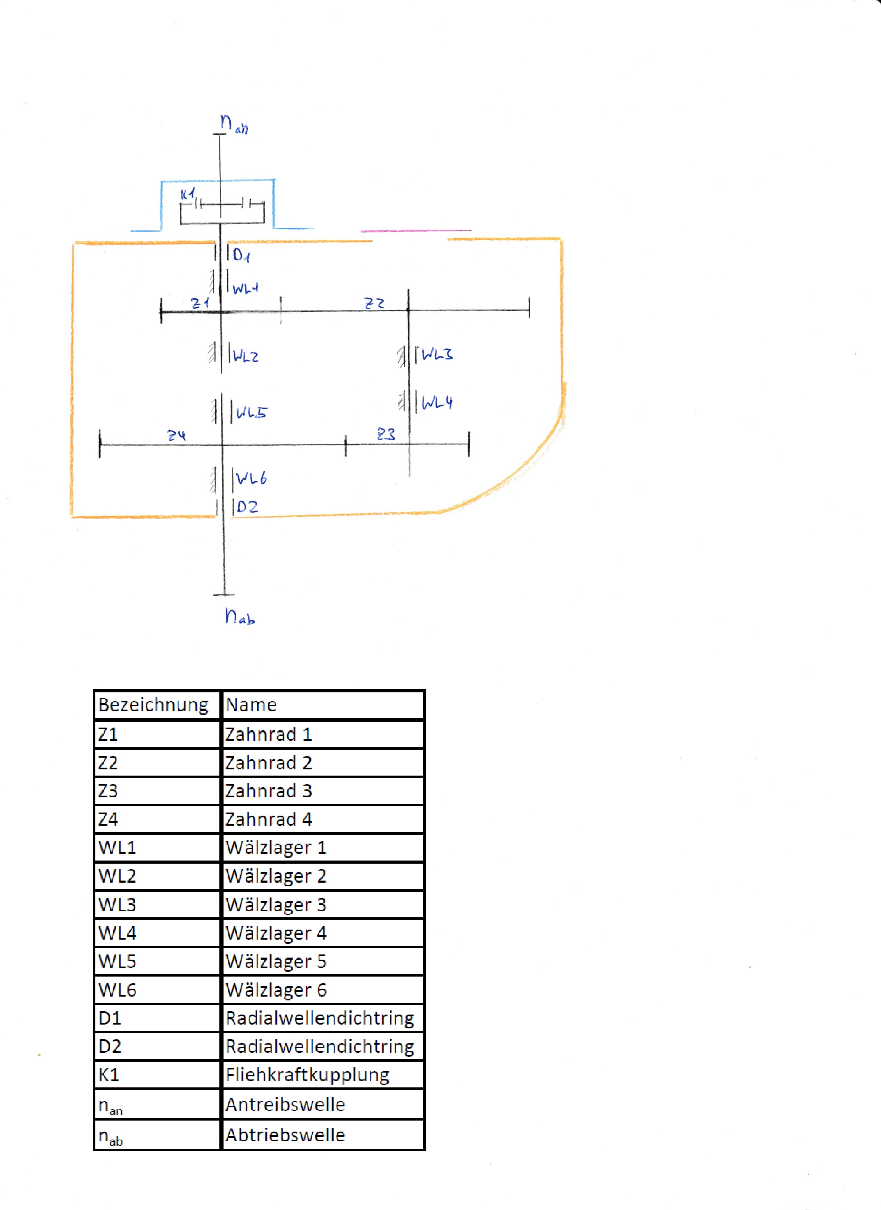
Entwurf alt (Lars)/ME3-Entwurf/Berechnungen/Testat_1/Testat Nr.1/Zeichnungen/Prinzipskizze mit Legende.jpeg
