Marvin20212/Gruppe9_ME3E/Testat 1/Vorarbeit Testat 1/Prinzipskizze.png

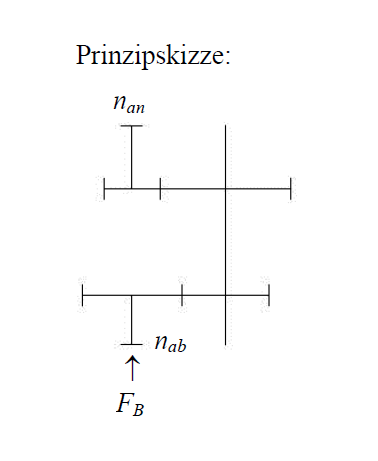
Testat 1/Vorarbeit Testat 1/Prinzipskizze.png
