Marvin20212/Gruppe9_ME3E/Testat 2/Vorarbeit Testat 2/Schnittgrößen.pdf

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

Mxy FN T; x FQxy; 0 Nm Mxz FQxz 1334 N; 36,8 Vorgelegewelle xy z; Rot markierter Kreis zeigt kritische Stellen an der Welle

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
