Marvin20212/Gruppe9_ME3E/Entwurf alt (Lars)/ME3-Entwurf/Testat 3/Zeichnung_final_Blatt_11.pdf

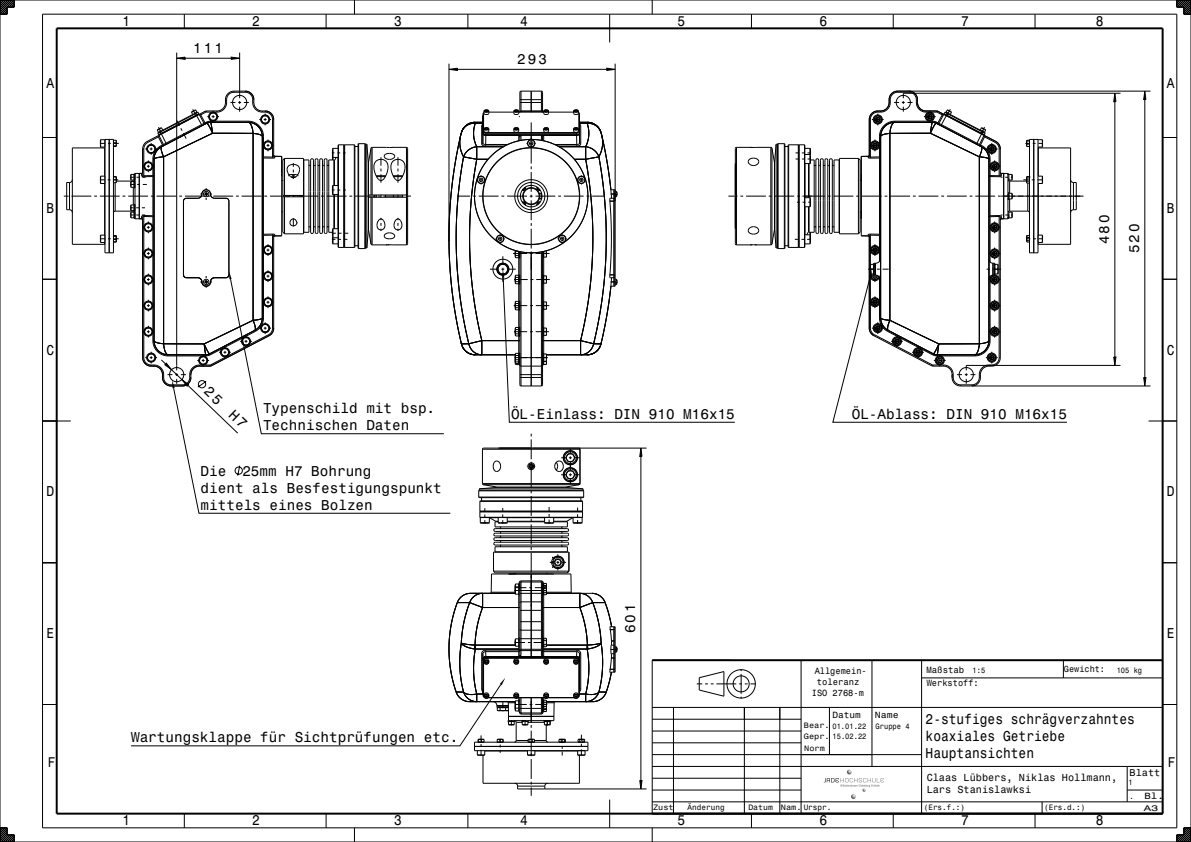
[picture p252: page 1]
ISO 2768-m; Gewicht: 105 kg; 2-stufiges schrägverzahntes koaxiales Getriebe; Maßstab 1:5; Gruppe 4; Zust; Änderung; Datum; Nam. Urspr.

Typenschild mit bsp.
Technischen Daten

ÖL-Einlass: DIN 910 M16x15 601

ÖL-Ablass: DIN 910 M16x15

Die 25mm H7 Bohrung
dient als Besfestigungspunkt
mittels eines Bolzen

Wartungsklappe für Sichtprüfungen etc.

Claas Lübbers, Niklas Hollmann,
Lars Stanislawksi
