Marvin20212/Gruppe9_ME3E/Entwurf alt (Lars)/ME3-Entwurf/Testat 3/Zeichnung_final_Blatt_12.pdf

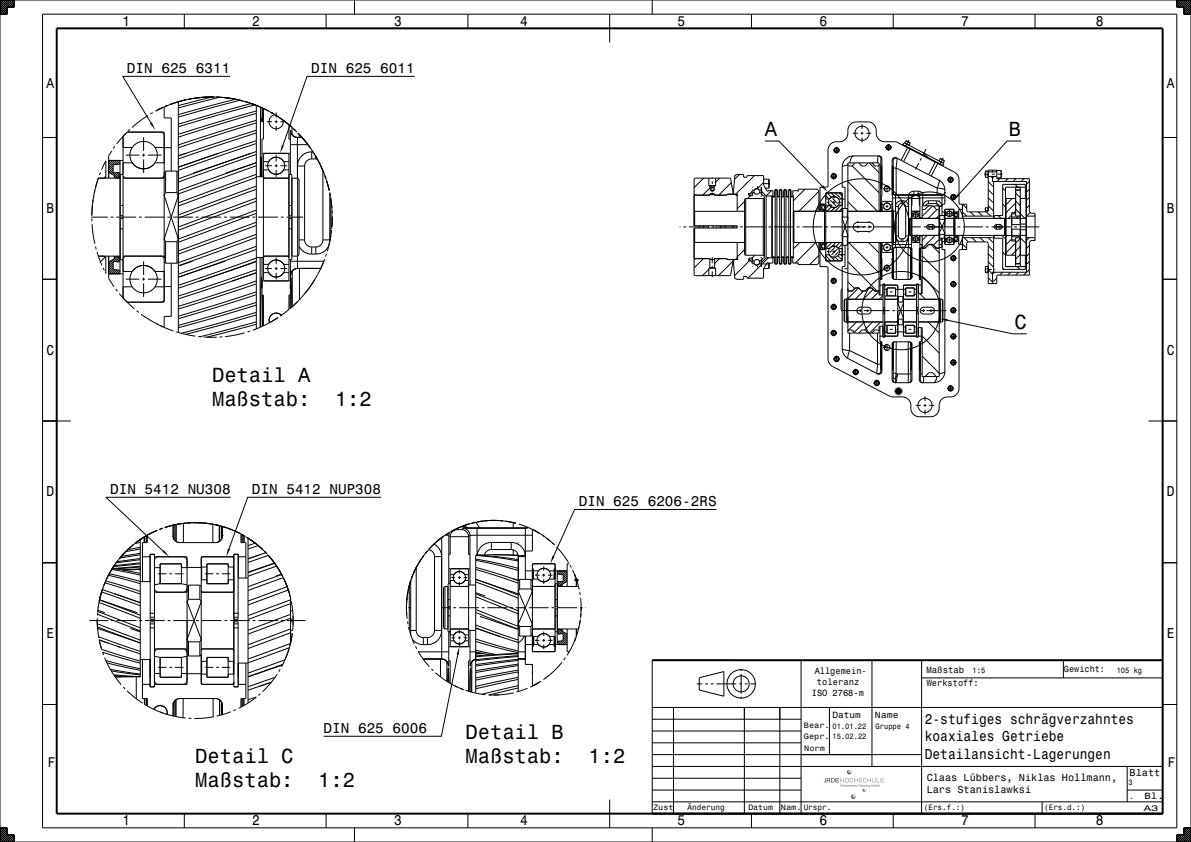
[picture p253: page 1]
ISO 2768-m; Gewicht: 105 kg; 2-stufiges schrägverzahntes koaxiales Getriebe; Maßstab 1:5; Gruppe 4; Zust; Änderung; Datum; Nam. Urspr.; Detail B Maßstab: 1:2; DIN 625 6206-2RS; DIN 625 6006; Detail C Maßstab: 1:2; DIN 5412 NU308; DIN 5412 NUP308; Detail A Maßstab: 1:2; DIN 625 6311; DIN 625 6011

Claas Lübbers, Niklas Hollmann,
Lars Stanislawksi
