Marvin20212/Gruppe9_ME3E/Entwurf alt (Lars)/ME3-Entwurf/Testat 3/Zeichnung_final_Blatt_13.pdf

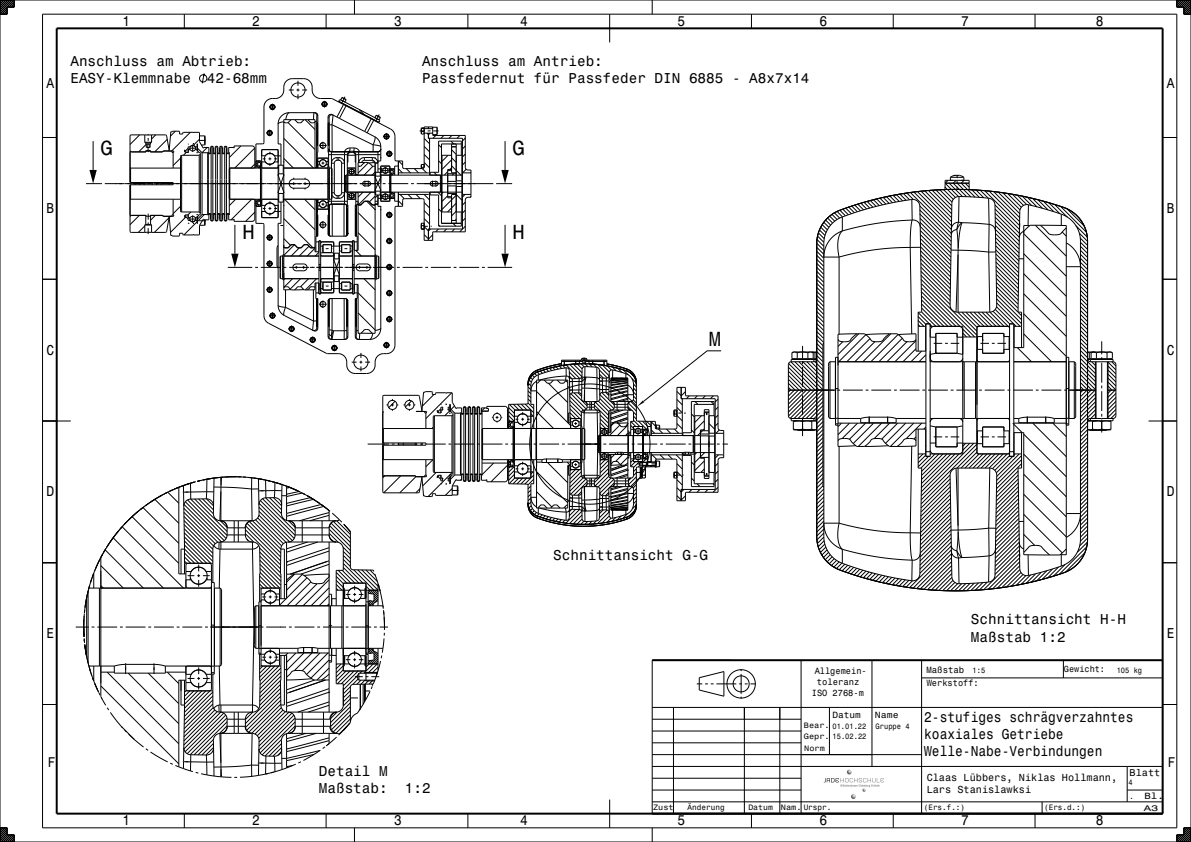
[picture p254: page 1]
ISO 2768-m; Gewicht: 105 kg; Gruppe 4; Zust; Änderung; Datum Nam. Urspr.; Schnittansicht G-G; Schnittansicht H-H Maßstab 1:2; Detail M Maßstab: 1:2

Anschluss am Abtrieb:
EASY-Klemmnabe 42-68mm

Anschluss am Antrieb:
Passfedernut für Passfeder DIN 6885 - A8x7x14

Maßstab 1:5
Werkstoff:
2-stufiges schrägverzahntes
koaxiales Getriebe
Welle-Nabe-Verbindungen

Claas Lübbers, Niklas Hollmann,
Lars Stanislawksi
