Marvin20212/Gruppe9_ME3E/Entwurf alt (Lars)/ME3-Entwurf/Testat 3/Zeichnung_final_Blatt_14.pdf

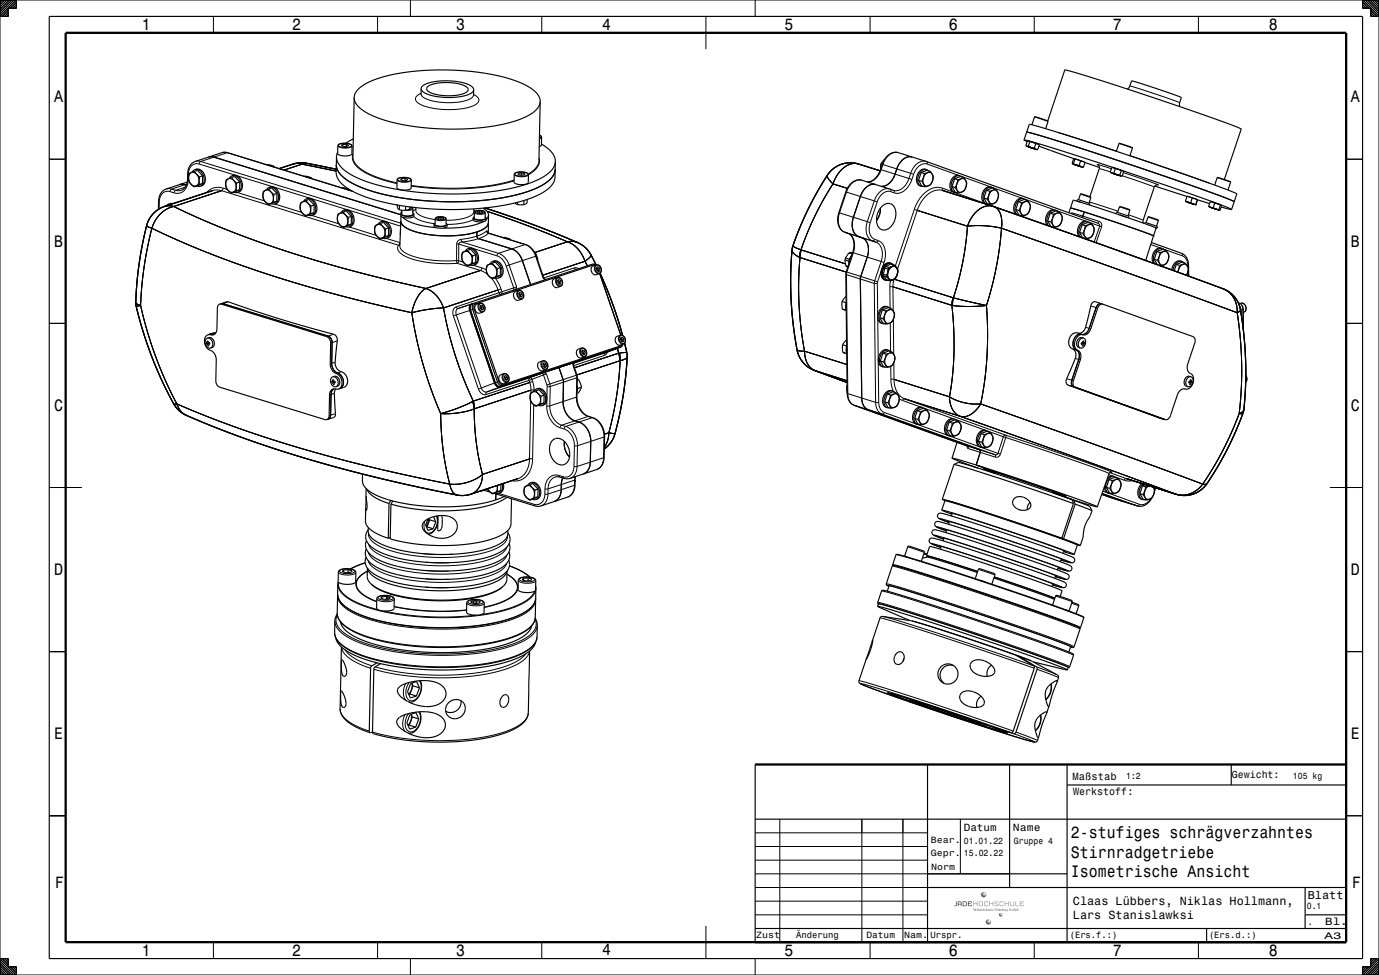
[picture p255: page 1]
Gewicht: 105 kg; Maßstab 1:2; Zust; Änderung; Datum; Nam. Urspr.

Bear. Gepr. Norm | Datum 01.01.22 15.02.22 | Name Gruppe 4 | 2-stufiges schrägverzahntes Stirnradgetriebe Isometrische Ansicht

Claas Lübbers, Niklas Hollmann,
Lars Stanislawksi
