Marvin20212/Gruppe9_ME3E/Entwurf alt (Lars)/ME3-Entwurf/Testat 3/Zeichnung_final_Blatt_15.pdf

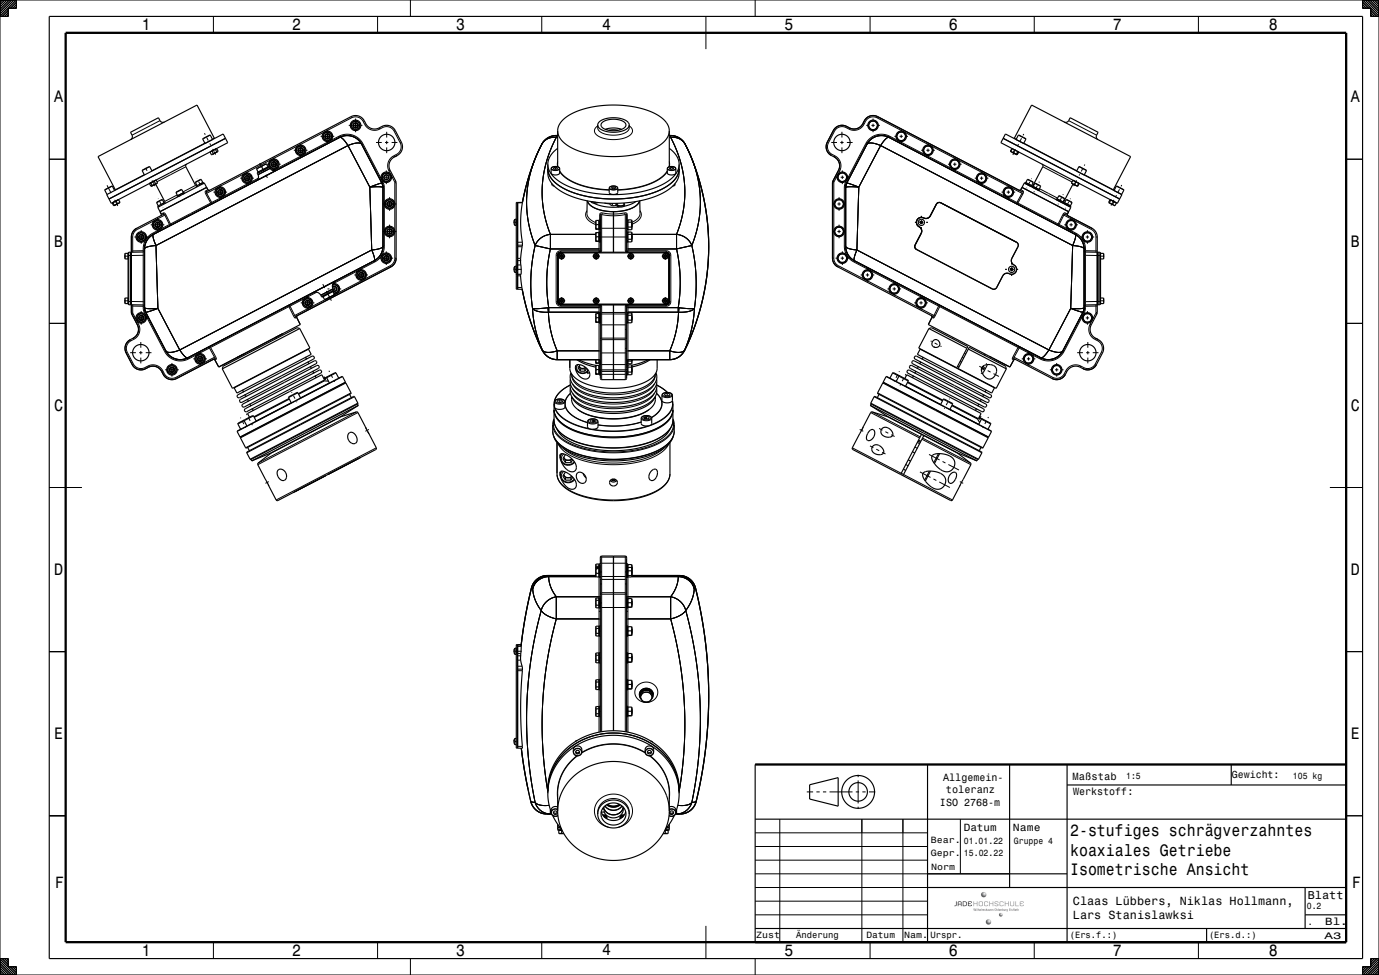
[picture p256: page 1]
ISO 2768-m; Gewicht: 105 kg; 2-stufiges schrägverzahntes koaxiales Getriebe Isometrische Ansicht; Maßstab 1:5; Gruppe 4; Zust; Änderung; Datum; Nam. Urspr.

Claas Lübbers, Niklas Hollmann,
Lars Stanislawksi
