Marvin20212/Gruppe9_ME3E/Entwurf alt (Lars)/ME3-Entwurf/Testat 3/Zeichnung_final_Blatt_16.pdf

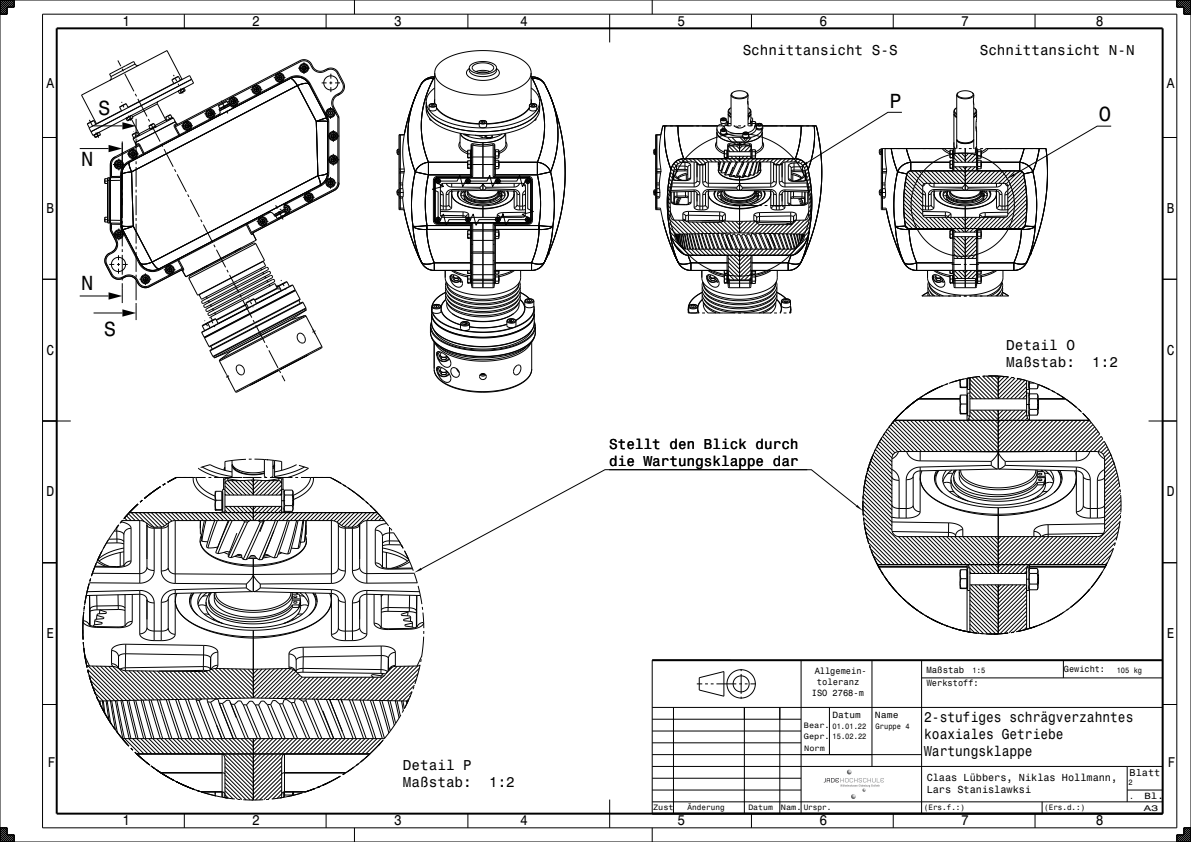
[picture p257: page 1]
ISO 2768-m; Gewicht: 105 kg; 2-stufiges schrägverzahntes koaxiales Getriebe; Maßstab 1:5; Gruppe 4; Zust; Änderung; Datum Nam. Urspr.; Schnittansicht N-N; Detail O Maßstab: 1:2; Schnittansicht S-S; Detail P Maßstab: 1:2

Stellt den Blick durch
die Wartungsklappe dar

Claas Lübbers, Niklas Hollmann,
Lars Stanislawksi
