Marvin20212/Gruppe9_ME3E/Entwurf alt (Lars)/ME3-Entwurf/Testat 3/Zeichnung_final_Zeichnungsrahmen_A3.pdf

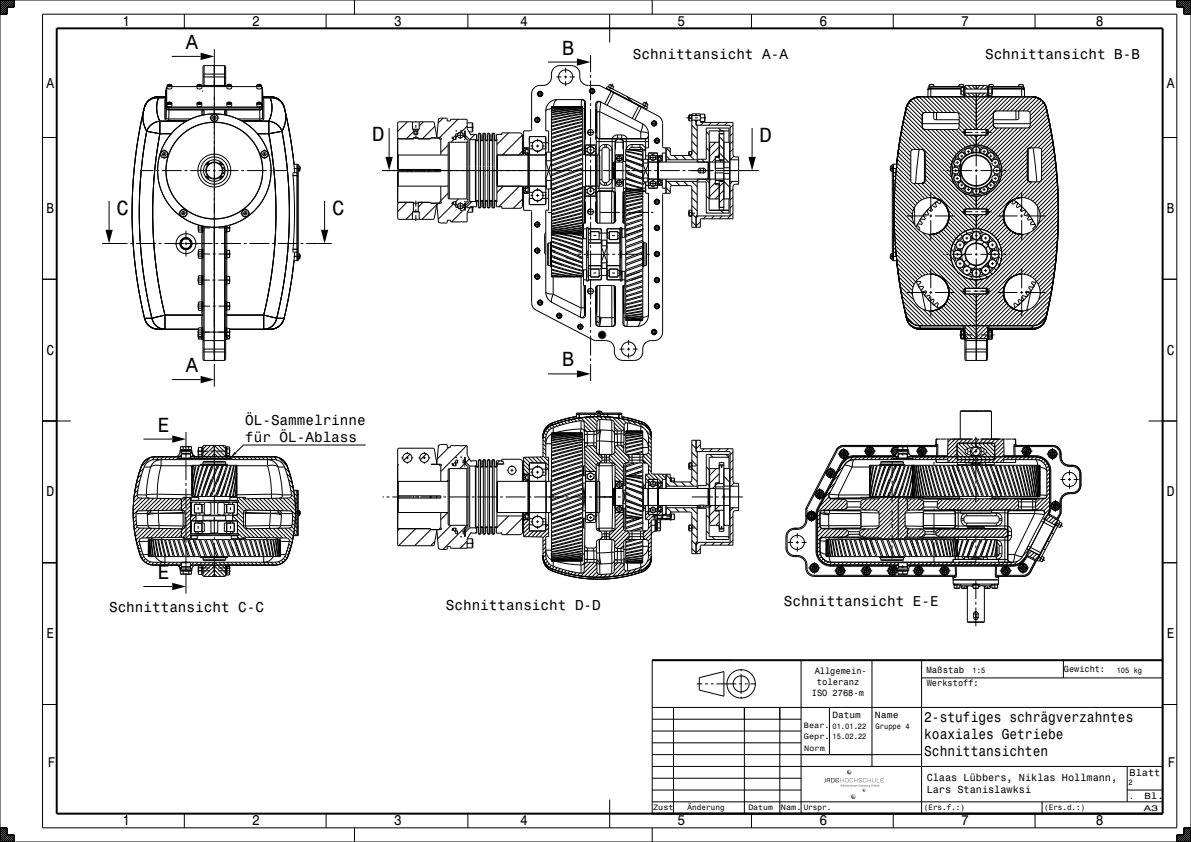
[picture p258: page 1]
ISO 2768-m; Gewicht: 105 kg; 2-stufiges schrägverzahntes koaxiales Getriebe; Maßstab 1:5; Gruppe 4; Zust; Änderung; Datum Nam. Urspr.; Schnittansicht A-A; Schnittansicht B-B; Schnittansicht C-C; Schnittansicht D-D; Schnittansicht E-E

für ÖL-Ablass E

Claas Lübbers, Niklas Hollmann,
Lars Stanislawksi
