Marvin20212/Gruppe9_ME3E/Catia/Isometrische-, Haupt-und Schnittansichten/Hauptansichten_Zeichnungsrahmen_A3.pdf

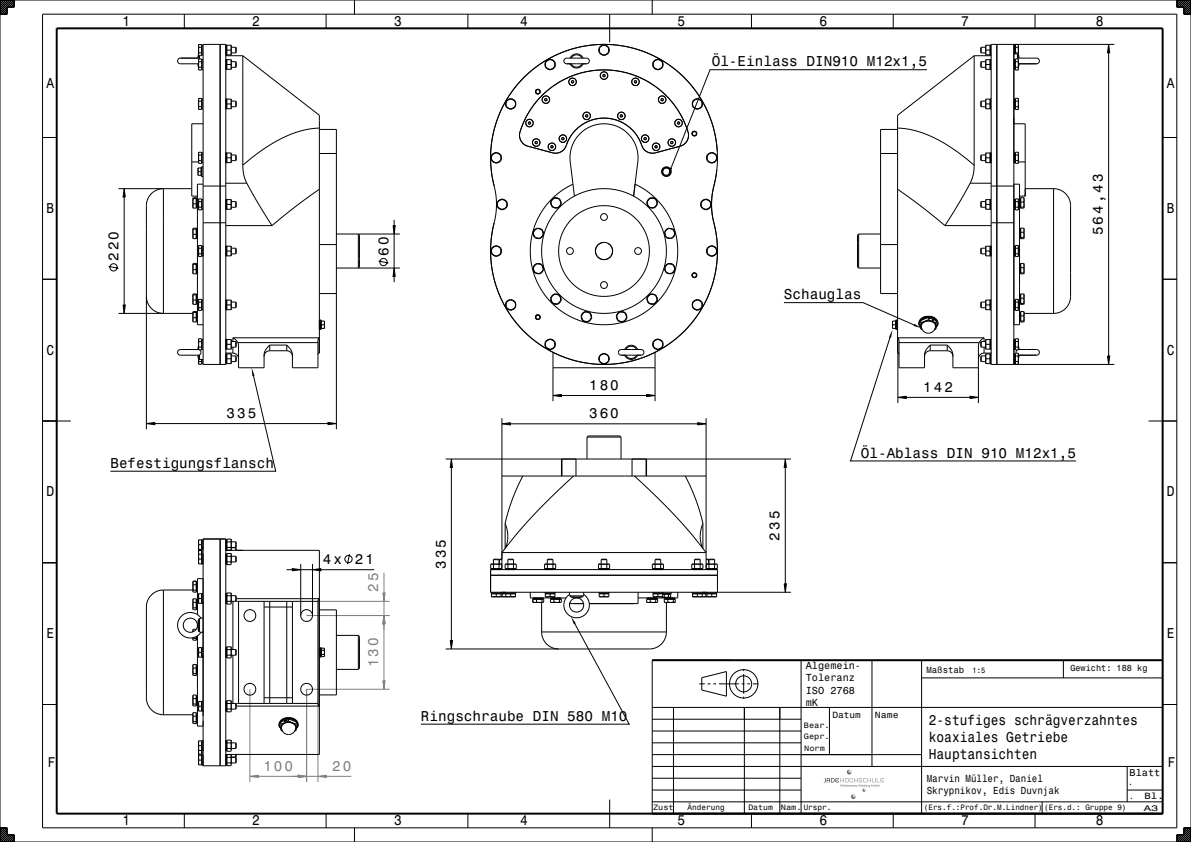
[picture p259: page 1]
Gewicht: 188 kg; 2-stufiges schrägverzahntes koaxiales Getriebe; Maßstab 1:5; Zust; Änderung; Datum; Nam. Urspr.; ISO 2768; Öl-Einlass DIN910 M12x1,5; Ringschraube DIN 580 M10

Öl-Ablass DIN 910 M12x1,5

Marvin Müller, Daniel
Skrypnikov, Edis Duvnjak

(Ers.f.:Prof.Dr.M.Lindner) (Ers.d.: Gruppe 9)
