Marvin20212/Gruppe9_ME3E/Catia/Isometrische-, Haupt-und Schnittansichten/Isometrische Ansichten_Zeichnungsrahmen_A3.pdf

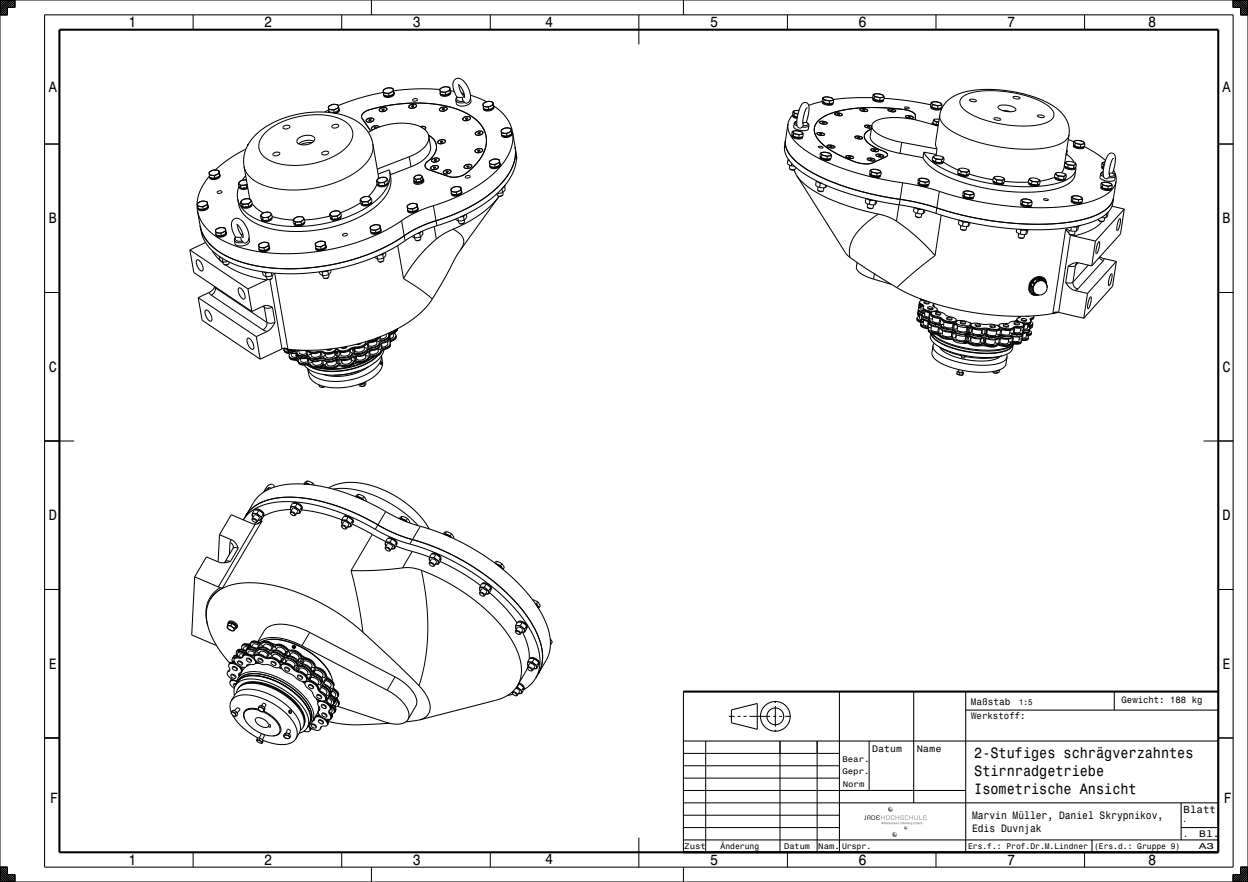
[picture p260: page 1]
Gewicht: 188 kg; 2-Stufiges schrägverzahntes; Isometrische Ansicht; Maßstab 1:5; Zust; Änderung; Datum Nam. Urspr.

Marvin Müller, Daniel Skrypnikov,
Edis Duvnjak

Ers.f.: Prof.Dr.M.Lindner (Ers.d.: Gruppe 9)
