Marvin20212/Gruppe9_ME3E/Catia/Isometrische-, Haupt-und Schnittansichten/Schnittansichten-Rutschkupplung_Zeichnungsrahmen_A3.pdf

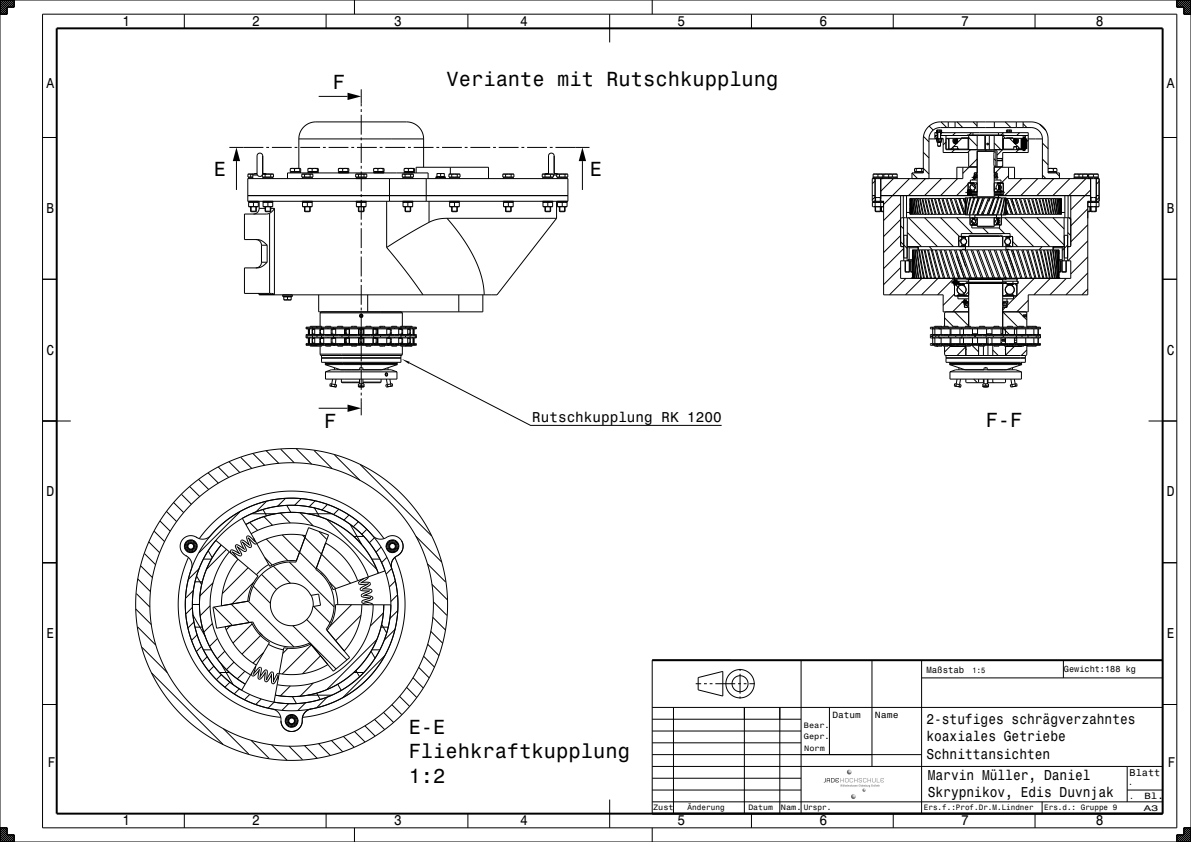
[picture p261: page 1]
Gewicht:188 kg; Maßstab 1:5; Zust; Änderung; Datum Nam. Urspr.; Rutschkupplung RK 1200

Veriante mit Rutschkupplung

2-stufiges schrägverzahntes
koaxiales Getriebe
Schnittansichten
Marvin Müller, Daniel
Skrypnikov, Edis Duvnjak

Ers.f.:Prof.Dr.M.Lindner Ers.d.: Gruppe 9
