Marvin20212/Gruppe9_ME3E/Catia/Isometrische-, Haupt-und Schnittansichten/Detailansichten - Lagerungen_Zeichnungsrahmen_A3.pdf

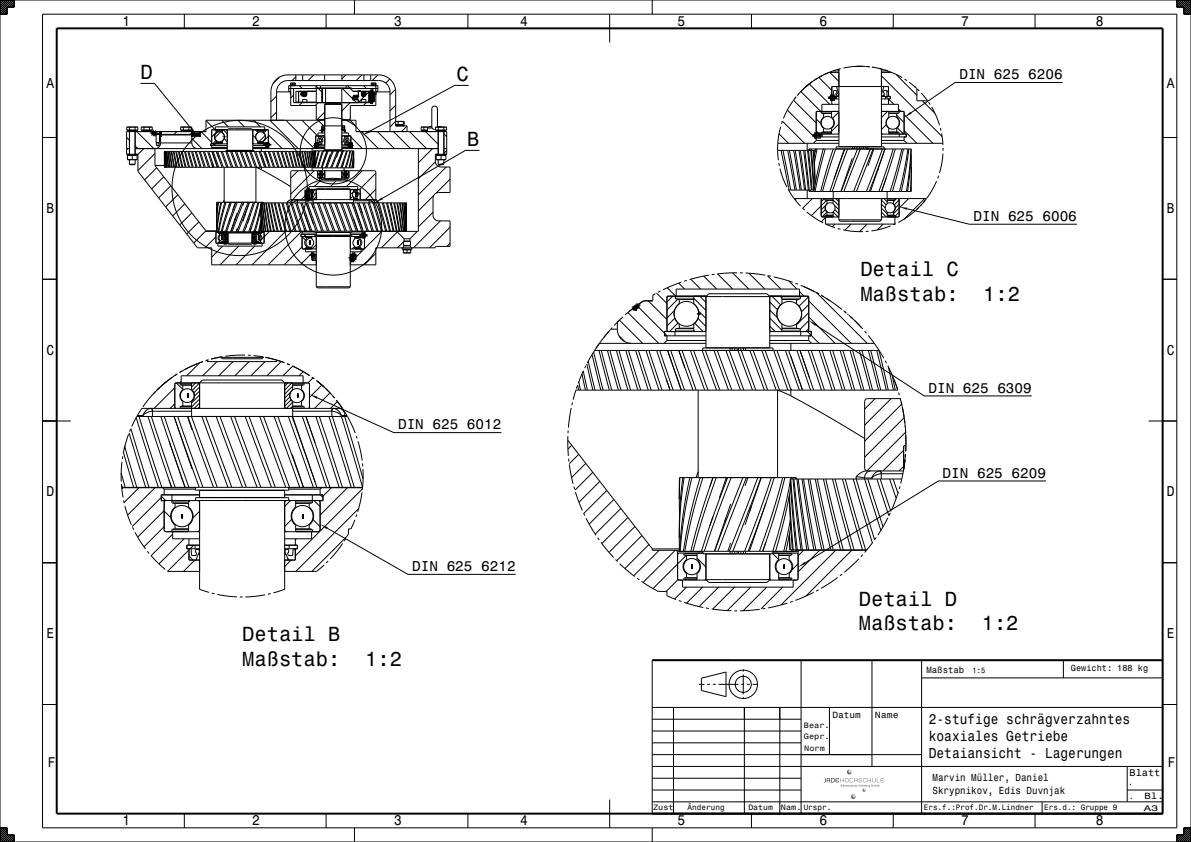
[picture p262: page 1]
Gewicht: 188 kg; 2-stufige schrägverzahntes koaxiales Getriebe Detaiansicht - Lagerungen; Maßstab 1:5; Zust; Änderung; Datum Nam. Urspr.; Detail B Maßstab: 1:2; DIN 625 6012; DIN 625 6212; Detail C Maßstab: 1:2; DIN 625 6006; DIN 625 6206; Detail D Maßstab: 1:2; DIN 625 6209; DIN 625 6309

Marvin Müller, Daniel
Skrypnikov, Edis Duvnjak

Ers.f.:Prof.Dr.M.Lindner Ers.d.: Gruppe 9
