Marvin20212/Gruppe9_ME3E/Catia/Isometrische-, Haupt-und Schnittansichten/Schnittansichten_Zeichnungsrahmen_A3.pdf

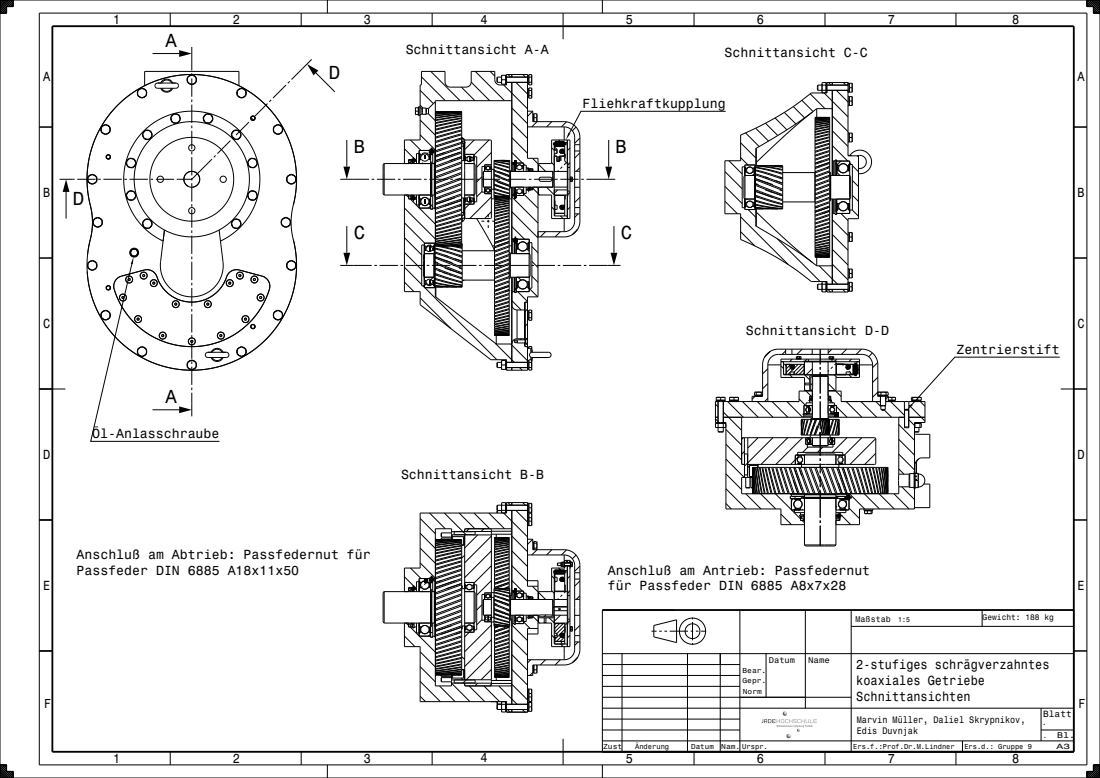
[picture p263: page 1]
Gewicht: 188 kg; 2-stufiges schrägverzahntes koaxiales Getriebe; Maßstab 1:5; Zust; Änderung; Datum Nam. Urspr.; Schnittansicht A-A; Passfeder DIN 6885 A18x11x50; Anschluß am Antrieb: Passfedernut; Schnittansicht B-B; Schnittansicht C-C; Schnittansicht D-D

Anschluß am Abtrieb: Passfedernut für

für Passfeder DIN 6885 A8x7x28

Marvin Müller, Daliel Skrypnikov,
Edis Duvnjak
Ers.f.:Prof.Dr.M.Lindner Ers.d.: Gruppe 9
