Marvin20212/Gruppe9_ME3E/(commit log)

2022-03-09 Fliehkraftkupplung 1
    [Fliehkupplung_Haus_aussen.CATPart, Fliehkupplung_Nabe.CATPart]
2022-03-10 Daten anderer Projekte
    [Anforderungsliste Rev. 01.xlsx]
2022-03-10 Kupplung weiter
    [Fliehkoerper.CATPart, Fliehkupplung_Flugkoerper.CATProduct, Fliehkupplung_Gesamt.CATProduct, Fliehkupplung_Haus_aussen.CATPart, Fliehkupplung_Nabe.CATPart, Mechanik innen.CATProduct, Reibflaeche.CATPart]
2022-03-10 Fertigstellung Fliehkupplung
    Fürs erste ist die denke ich fertig
    [5 Flache Scheiben DIN EN ISO 7092.CATPart, Deckel_FK.CATPart, Fliehkoerper.CATPart, Fliehkupplung_Flugkoerper.CATProduct, Fliehkupplung_Gesamt.CATProduct, Fliehkupplung_Haus_aussen.CATPart, Fliehkupplung_Nabe.CATPart, M5 Sechskantschrauben mit Schaft DIN 931.CATPart]
2022-03-12 Berechnungen Welle fertig
    [Getriebeberechnung Me3.xlsx]
2022-03-12 Update Getriebeberechnung Me3.xlsx
    [Getriebeberechnung Me3.xlsx]
2022-03-16 Feder besser
    [Fliehkupplung_Gesamt.CATProduct, Mechanik innen.CATProduct]
2022-03-16 Rechnungen und Legende
2022-03-17 Kupplung Reparatur, Übersichtstabelle
    [Deckel_FK.CATPart, Fliehkupplung_Gesamt.CATProduct, Getriebeberechnung Me3.xlsx]
2022-03-24 hier und da
    Daniel, ich habe deine Rechnung korrigiert
    [Legende.xlsx]
2022-03-30 Legende etwas erweitert, aber noch nicht vollständig
    [Legende.xlsx]
2022-03-30 Ein wenig erweitert
    [Legende.xlsx]
2022-04-04 Zahnräder Catia
    [Eing-Steuerteil_Stirnradstufe_Maschb_Achabst.CATPart, Stirnradstufe_Maschb_Waelzverf_S20_R19.CATProduct, Stufe 1 fertig.CATProduct, Stufe 2 fertig.CATProduct]
2022-04-05 Testat 1 vorbereitet, Legende MEINERSEITS aktualisiert
    [Legende Testat 1 05.04.22.xlsx, Legende.xlsx]
2022-04-05 Fliehkraftkupplung in Legende
    [Legende.xlsx]
2022-04-06 Rutschkupplung - kleinere Version
    [rk_1200-25.CATProduct, rk_1200-25_01.CATPart, rk_1200-25_02.CATPart, rk_1200-25_03.CATPart, rk_1200-25_04.CATPart, rk_1200-25_05.CATPart, rk_2400-35.CATProduct, rk_2400-35_01.CATPart]
2022-04-06 Rillenkugellager - Antriebswelle
    [bearing_6006_2.CATProduct, bearing_6006_2_01.CATPart, bearing_6006_2_02.CATPart, bearing_6006_2_03.CATPart, bearing_6206_2.CATProduct, bearing_6206_2_01.CATPart, bearing_6206_2_02.CATPart, bearing_6206_2_03.CATPart]
2022-04-06 Neue Anordnung FA FR FT und Angleichen Rechnungen
2022-04-06 Passfeder, Freistich
    [Antriebswelle.CATPart]
2022-04-06 Schnittgrößen alternatvie
    [Schnittgrößen Alternative.dwg]
2022-04-07 Anfang Gehäuse
    [Gehaeuse2.CATPart, Gehauese Test 1.CATPart]
2022-04-11 Lager Auswahl
    [bearing_6012_2.CATProduct, bearing_6012_2_01.CATPart, bearing_6012_2_02.CATPart, bearing_6012_2_03.CATPart, bearing_6209_2.CATProduct, bearing_6209_2_01.CATPart, bearing_6209_2_02.CATPart, bearing_6209_2_03.CATPart]
2022-04-11 Antriebswelle Änderung
    [Antriebswelle.CATPart]
2022-04-11 Vorgelegewelle Freistiche
    [Vorgelegewelle.CATPart]
2022-04-12 Haus weiter und RDWR
    [Gehaeuse2.CATPart, din3760-a_30x40x7-fkm.CATPart, din3760-a_60x75x8-fkm.CATPart]
2022-04-13 Kleine Änderungen
    [Antriebswelle.CATPart, Vorgelegewelle.CATPart]
2022-04-13 Gehäuse, Ölschraube, Zahnrad Tasche
    [3241188.CATPart, Gehaeuse2.CATPart, din910-m12x1_5-st.CATPart]
2022-04-13 Abtriebswelle, Kaufteile
    [Abtriebswelle.CATPart, Passfeder A 18x11x50.CATPart, Sicherungsring DIN 471-030x1,5.CATPart, Wellendichtring SKF_60X110X8_CRW1_R.catpart, Wellendichtring_SKF_30X55X10_HMS5_V.catpart, sw-471030.CATPart, sw-471045.CATPart, sw-471060.CATPart]
2022-04-13 Struktur angepasst
    [5 Flache Scheiben DIN EN ISO 7092.CATPart, Fliehkupplung_Gesamt.CATProduct, M5 Sechskantschrauben mit Schaft DIN 931.CATPart, Passfeder A 18x11x50.CATPart, Passfeder A 8x7x25.CATPart, Sicherungsring DIN 471-030x1,5.CATPart, mutter_din_982-m5x0_8-10.CATPart, sw-471030.CATPart]
2022-04-19 Kleinigkeiten Gehäuse
    [3241188.CATPart, Gehaeuse2.CATPart, bearing_6209_2.CATProduct]
2022-04-19 Gehäuse neu, nun richtig
    [Gehaeuse 3.CATPart, Gehaeuse2.CATPart, Gehauese Test 1.CATPart]
2022-04-19 Zahnräder glaube ich repariert
    [Eing-Steuerteil_Stirnradstufe_Maschb_Achabst.CATPart, Stirnradstufe_Maschb_Waelzverf_S20_R19.CATProduct, Stufe 1 fertig.CATProduct, Stufe 2 fertig.CATProduct]
2022-04-19 Update Gehaeuse 3.CATPart
    [Gehaeuse 3.CATPart]
2022-04-19 Gehäuse und Zahnrad-Backup
    [Deckel-Dichtung.CATPart, Deckel.CATPart, Gehaeuse 3.CATPart, Hilfestellung Deckel und Dichtung.CATProduct, gn_546_6-20-g3_4.CATPart]
2022-04-19 Schauglas am Abend, vertreibt Kummer und Sorgen
    [Deckel.CATPart, Hilfestellung Deckel und Dichtung.CATProduct, Schauglas.CATPart]
2022-04-19 Ölschraube in der Nacht, das kracht
    [Gehaeuse 3.CATPart, gn_546_6-20-g3_4.CATPart]
2022-04-20 Ölschraube
    [din910-m12x1_5-st.CATPart, gn_546_6-20-g3_4.CATPart]
2022-04-20 Schauglas Dichtung
    [Deckel.CATPart, Glas-Dichtung.CATPart, Hilfestellung Deckel und Dichtung.CATProduct, Schauglas.CATPart]
2022-04-20 Steg überarbeitet
    [Gehaeuse 3.CATPart, Lagersteg.CATPart]
2022-04-20 Altes verschoben
    [Hilfestellung Deckel und Dichtung.CATProduct]
2022-04-20 Zusammenbau Teil 1
    [07160-108x60.CATPart, 07170-10x60.CATPart, 07210-110.CATPart, 102-1289632.CATPart, 112-1289675.CATPart, 62-1289454.CATPart, A14x9x28.CATPart, A14x9x50.CATPart]
2022-04-21 Zusammenbau Teil 2
    [62-1289454.CATPart, A14x9x28.CATPart, A14x9x50.CATPart, A8x7x25.CATPart, A8x7x28.CATPart, AbtriebZSM.CATProduct, Abtriebswelle.CATPart, AntriebZSM.CATProduct]
2022-04-21 Maße und X-Werte
    [AntriebZSM.CATProduct, Gruppe 9 Bohrgetriebe.CATProduct, Stufe 1 fertig.CATProduct, Stufe 2 fertig.CATProduct, VorgelegeZSM.CATProduct]
2022-04-21 Testat 1 fertig?
    [Legende Testat 1 05.04.22.xlsx]
2022-04-24 Korrektur zeichnung
    [Schnittgrößen.dwg]
2022-05-01 Catia Verbindungen
    [AntriebZSM.CATProduct, Deckel.CATPart, Fliehkraftkupplungdeckel.CATPart, Gehaeuse 3.CATPart, Gruppe 9 Bohrgetriebe.CATProduct, Stufe 1 fertig.CATProduct, Stufe 2 fertig.CATProduct, VorgelegeZSM.CATProduct]
2022-05-02 Ritzel und Zahnrad eingeblendet
    [Eing-Steuerteil_Stirnradstufe_Maschb_Achabst.CATPart, Gehaeuse 3.CATPart, Gruppe 9 Bohrgetriebe.CATProduct]
2022-05-02 Hebeösen neu positioniert, Bedingungen dazu
    [AntriebZSM.CATProduct, Antriebswelle.CATPart, Deckel zusammen.CATProduct, Deckel.CATPart, Fliehkraftkupplungdeckel.CATPart, Fliehkupplung_Gesamt.CATProduct, Fliehkupplung_Haus_aussen.CATPart, Gehaeuse 3.CATPart]
2022-05-02 ein Offset neu
    [AntriebZSM.CATProduct, Fliehkraftkupplungdeckel.CATPart, Fliehkupplung_Gesamt.CATProduct, Gruppe 9 Bohrgetriebe.CATProduct, Stufe 1 fertig.CATProduct, Stufe 2 fertig.CATProduct, VorgelegeZSM.CATProduct]
2022-05-04 Ringschrauben Neu
    [Deckel zusammen.CATProduct, Deckel.CATPart, Gruppe 9 Bohrgetriebe.CATProduct, Schrauben_Deckel_Haus.CATProduct, din_580-m10-ni.CATPart]
2022-05-15 Testat 2
    [Legende.xlsx]
